nacs-lab/yyc-data/README.md

# License

All source code in this repo is under GPLv3+.
