nacs-lab/yyc-data/designs/enclosure/README.md

# Design files for enclosure, including DDS

## Files

1. `*.fpd`

    Front Panel Designer files.

2. `*.dxf`

    For the waterjet.

3. `*.svg` and `*.png`

    Drawing

4. `dimensions`

    Dimensions of the front/back, top/bottom panels and their offsets from
    the inner corner.

## Holes and Considerations

1. Front

    1. Ethernet and USB serial console input
    2. Board power
    3. SD card and switch. Leave enough space for fingers
    4. Front fan holes enough for two fans
    5. Backup 48V feed through hole
    6. Backup mount hole for the power converter board

2. Back

    1. Backup ethernet and USB serial console input
    2. Back fan holes enough for two fans

3. Top

    1. Mount holes for power splitters (8 ports x3, 3 ports x1) with different
    orientation and position options
    2. TTL/camera link with mount holes for the camera link adapter plate.
    3. CLock output
    4. REF CLK inputs and signal outputs for the DDS boards. Output holes
    should not make contact with the connectors
    5. Mount holes for the L-brackets for the DDS boards
    6. Auxiliary holes for powering the clock amplifier outside.
    7. Holes for LED / thermal monitor
    8. Auxiliary holes for WindFreak clock

4. Bottom

    1. Mount holes for the FPGA board and the breakout boards.

5. Left (DDS side)

    1. 48V feed through hole
    2. Mount hole for the power converter board, including the 12V to 5V
       converter module

## Drawing

1. Front

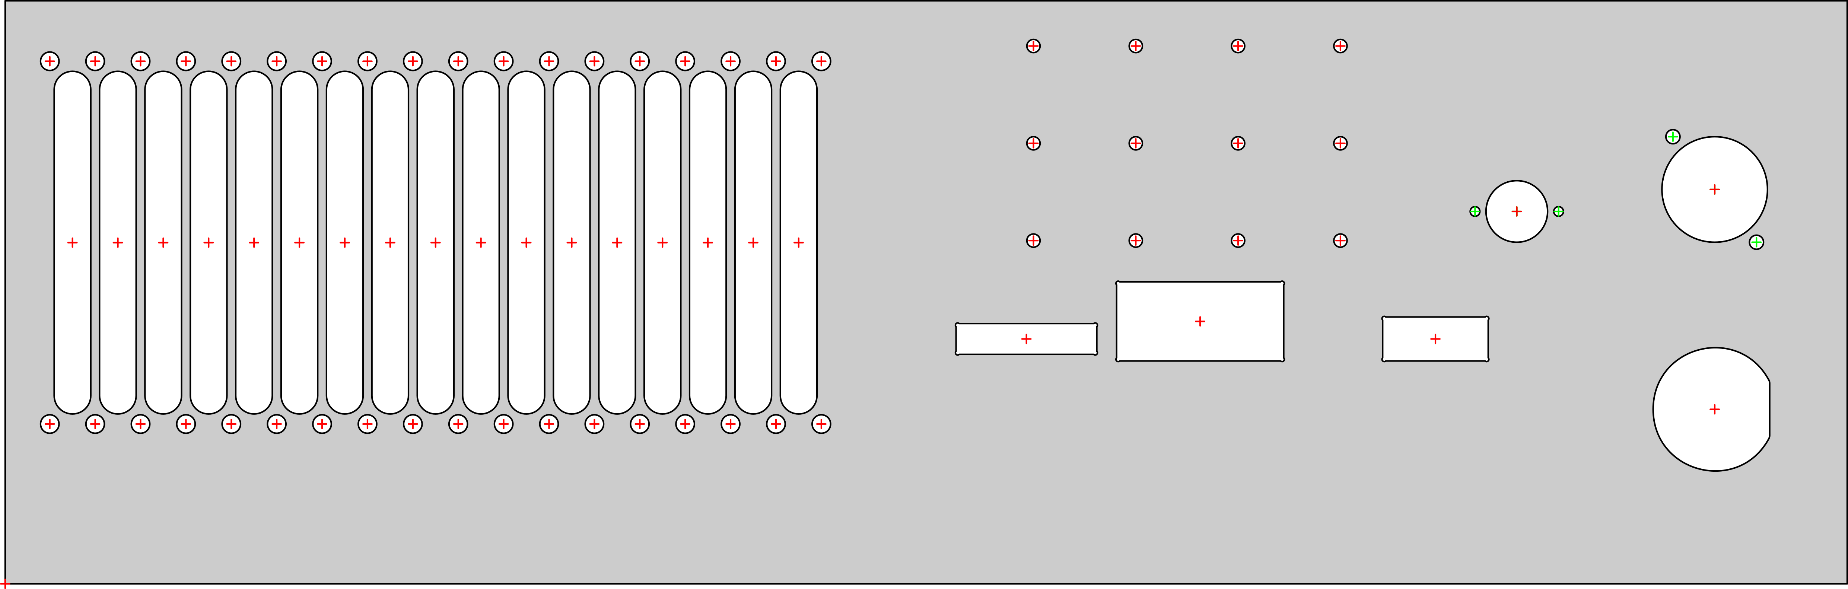
[picture p1: designs/enclosure/front.png]
Front panel
    

2. Back

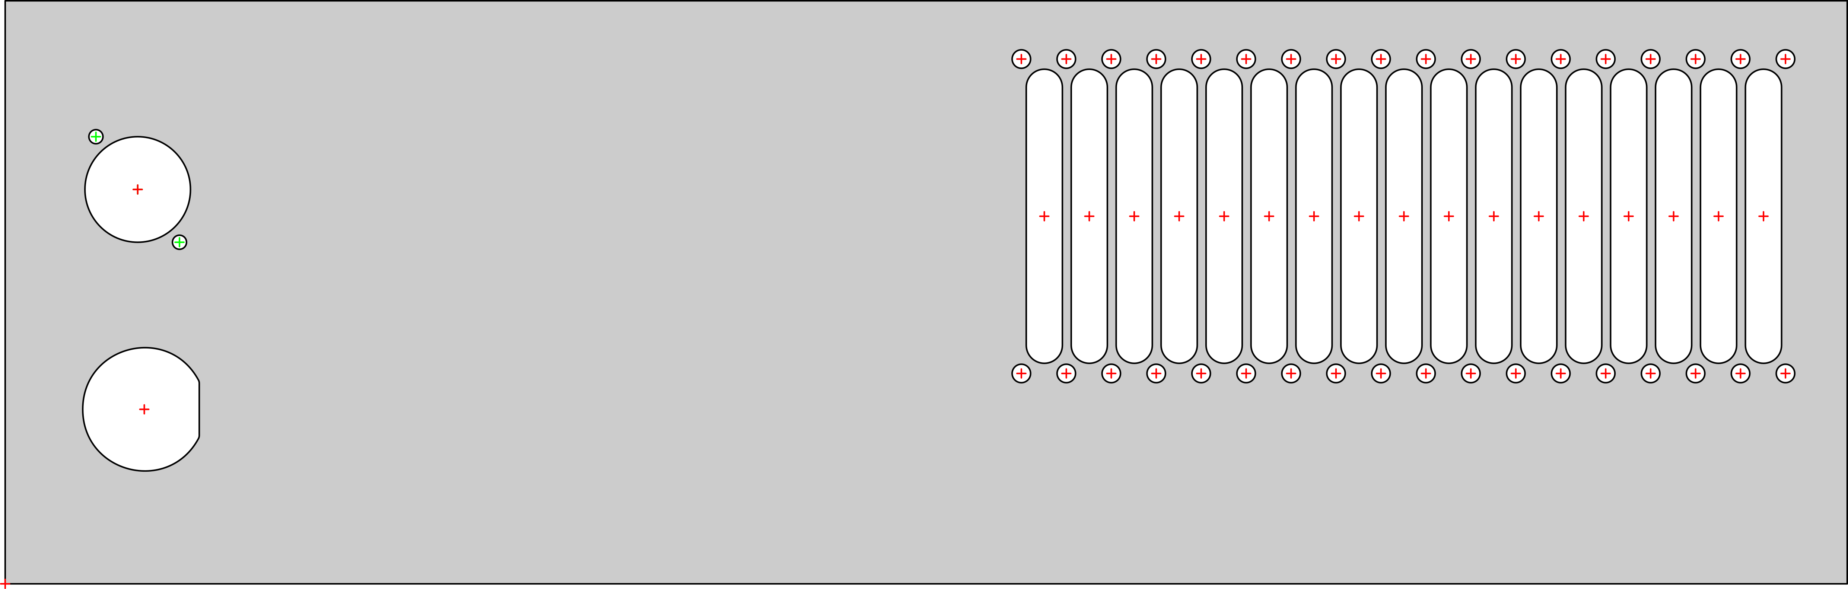
[picture p2: designs/enclosure/back.png]
Back panel
    

3. Top

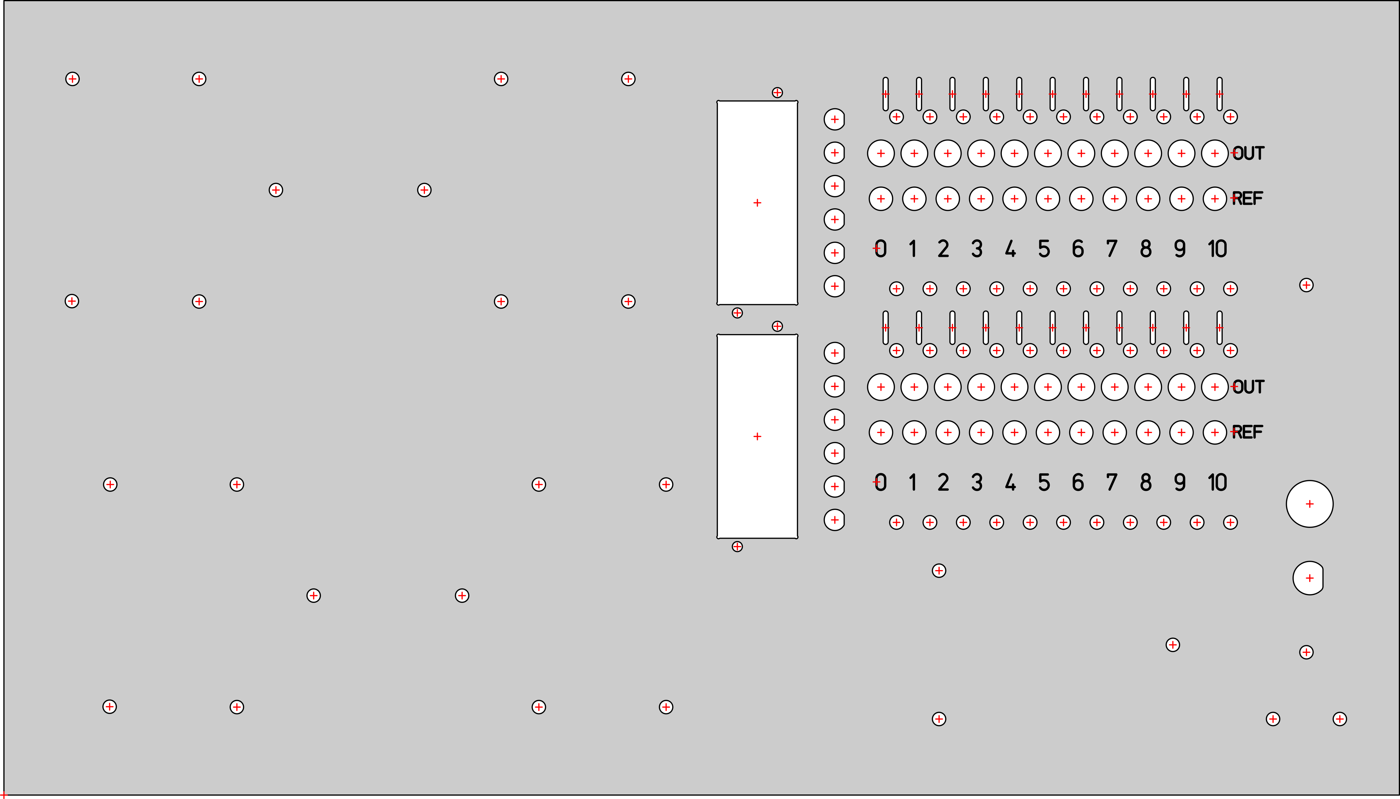
[picture p3: designs/enclosure/top.png]
Top panel
    

4. Bottom

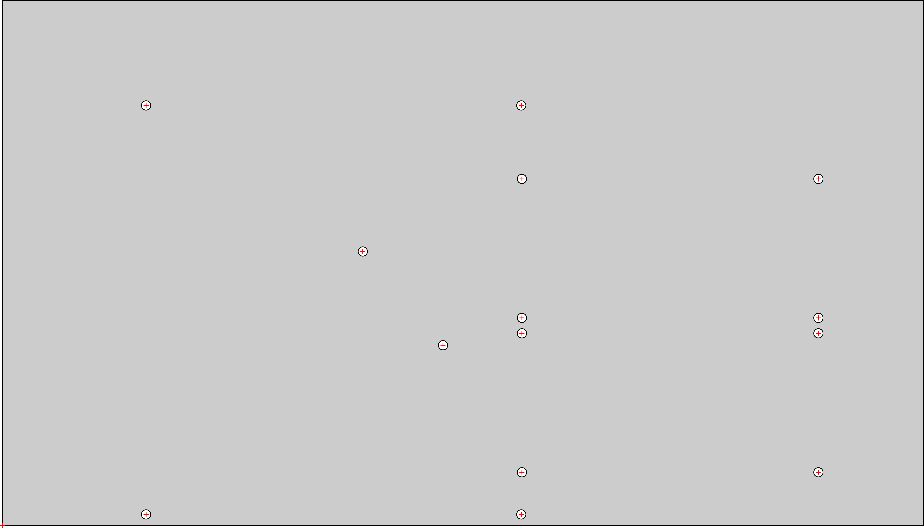
[picture p4: designs/enclosure/bottom.png]
Bottom panel
    

5. Left

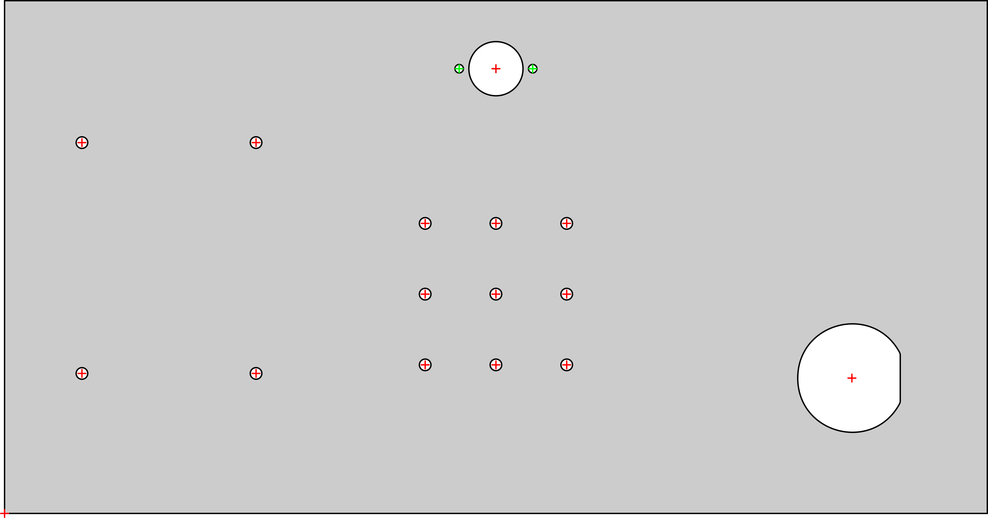
[picture p5: designs/enclosure/left.png]
Left panel
