nacs-lab/yyc-data/designs/regulator/combined.tex

\documentclass[10pt,fleqn]{article}

\usepackage{graphicx}

\begin{document}

\begin{center}
  \\
  \\
  \\
  
\end{center}

\end{document}
