nacs-lab/yyc-data/presentations/grc-2017/poster_text.md

# Challenges and solutions

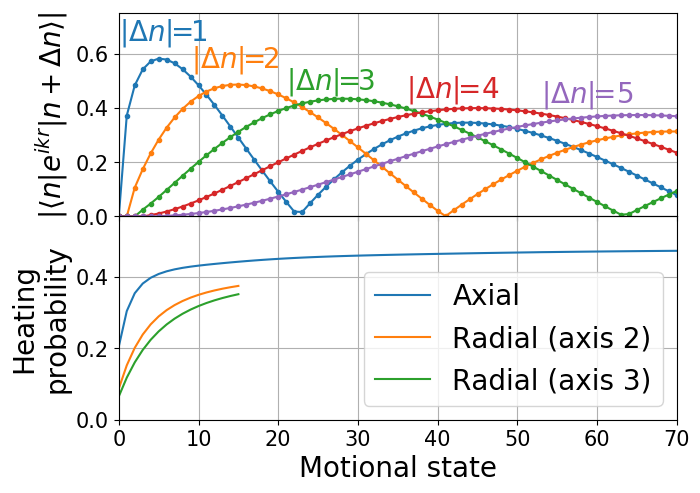
[picture p6: presentations/grc-2017/imgs/raman_op.png]


## Challenges
* High initial temperature (40μK)
* Large Lamb-Dicked parameters {0.60, 0.24, 0.21}
* High optical pumping heating
* Complex sideband structure
* Trap anharmonicity
* Trap AC Stark shift

## Solutions
* Cooling with high order sideband
* Optimize cooling with simulation
* Fast cooling pulse
* Trap switching

# Results

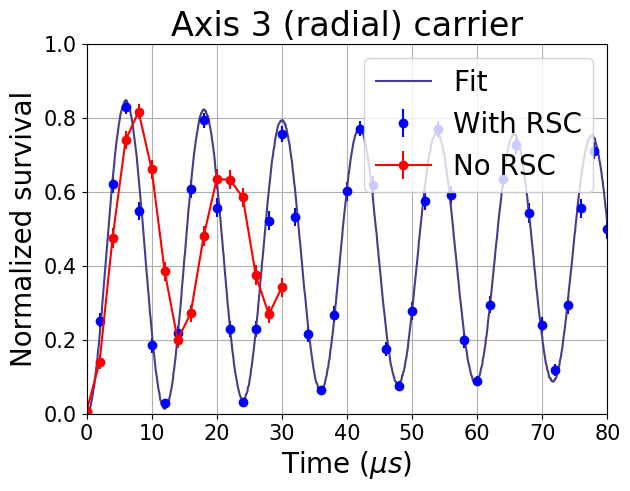
[picture p7: presentations/grc-2017/imgs/fit_20170409_r3_0.png]

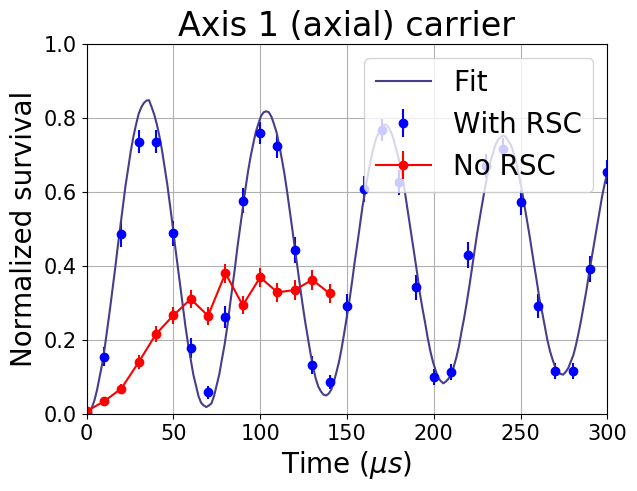
[picture p8: presentations/grc-2017/imgs/fit_20170409_a1_0.png]

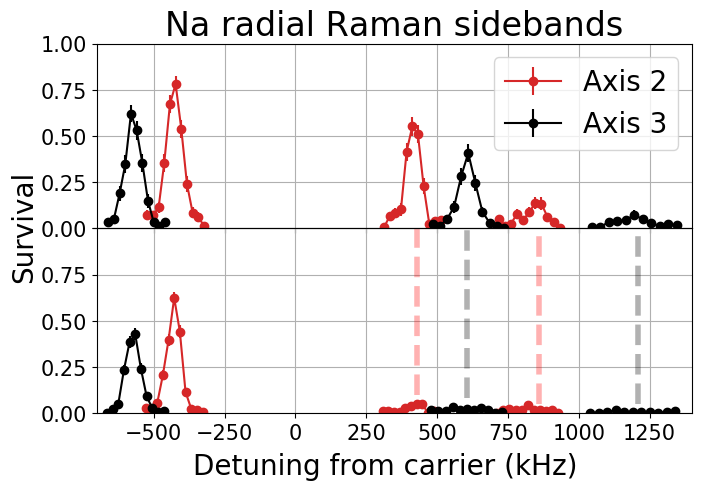
[picture p9: presentations/grc-2017/imgs/spectrum_r.png]

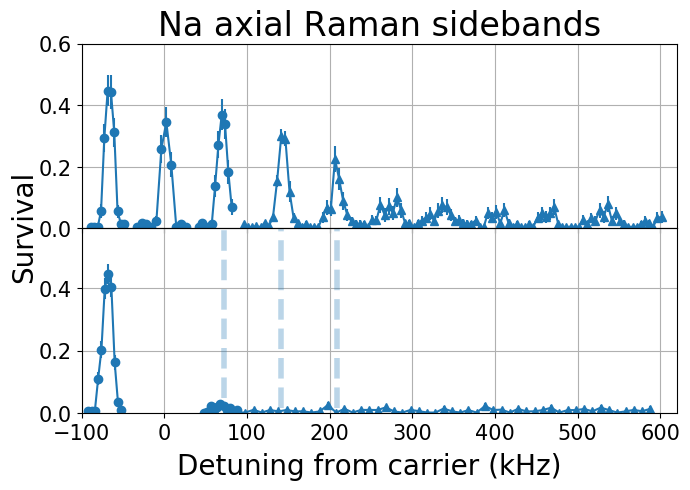
[picture p10: presentations/grc-2017/imgs/spectrum_a1.png]


Ground state ratio:
* Axis 1 (Axial): 91.6(28)%
* Axis 2 (Radial): 89.7(19)%
* Axis 3 (Radial): 93.8(26)%
* Combined: 77.1(35)%
