nacs-lab/yyc-data/presentations/2021-05-12_jc/present.tex

\documentclass[xcolor={table}]{beamer}
\mode<presentation>{
  \usetheme{Boadilla}
  \usefonttheme[onlylarge]{structurebold}
  \usefonttheme[stillsansseriflarge]{serif}
  \setbeamerfont*{frametitle}{size=\normalsize,series=\bfseries}
  % \setbeamertemplate{navigation symbols}{}
  \setbeamercovered{transparent}
}
\usepackage[english]{babel}
\usepackage[latin1]{inputenc}
\usepackage{times}
\usepackage[T1]{fontenc}
\usepackage{amsmath}
\usepackage{amssymb}
\usepackage{esint}
\usepackage{hyperref}
\usepackage{tikz}
\usepackage{xkeyval}
\usepackage{xargs}
\usepackage{verbatim}
\usepackage{listings}
\usepackage{multimedia}
\newcommand\hmmax{0}
\newcommand\bmmax{0}
\usepackage{bm}
\usepackage{siunitx}
\usepackage{xcolor,pifont}
\usepackage{upgreek}

\usetikzlibrary{
  arrows,
  calc,
  decorations.pathmorphing,
  decorations.pathreplacing,
  decorations.markings,
  fadings,
  positioning,
  shapes,
  arrows.meta
}
\usepgfmodule{oo}
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
  \draw[current plane,decoration={markings, mark=at position 0.6 with {\arrow{<}}},postaction={decorate},line width=.6mm] (\angVis:1) arc (\angVis:-\angVis-180:1);
  \draw[current plane,dashed,line width=.6mm] (180-\angVis:1) arc (180-\angVis:\angVis:1);
}
\newcommand\DrawLatitudeCircle[2][1]{
  \LatitudePlane{\angEl}{#2}
  \tikzset{current plane/.prefix style={scale=#1}}
  \pgfmathsetmacro\sinVis{sin(#2)/cos(#2)*sin(\angEl)/cos(\angEl)}
  % angle of "visibility"
  \pgfmathsetmacro\angVis{asin(min(1,max(\sinVis,-1)))}
  \draw[current plane] (\angVis:1) arc (\angVis:-\angVis-180:1);
  \draw[current plane,dashed] (180-\angVis:1) arc (180-\angVis:\angVis:1);
}
\newcommand\coil[1]{
  {\rh * cos(\t * pi r)}, {\apart * (2 * #1 + \t) + \rv * sin(\t * pi r)}
}
\makeatletter
\define@key{DrawFromCenter}{style}[{->}]{
  \tikzset{DrawFromCenterPlane/.style={#1}}
}
\define@key{DrawFromCenter}{r}[1]{
  \def\@R{#1}
}
\define@key{DrawFromCenter}{center}[(0, 0)]{
  \def\@Center{#1}
}
\define@key{DrawFromCenter}{theta}[0]{
  \def\@Theta{#1}
}
\define@key{DrawFromCenter}{phi}[0]{
  \def\@Phi{#1}
}
\presetkeys{DrawFromCenter}{style, r, center, theta, phi}{}
\newcommand*\DrawFromCenter[1][]{
  \setkeys{DrawFromCenter}{#1}{
    \pgfmathsinandcos\sint\cost{\@Theta}
    \pgfmathsinandcos\sinp\cosp{\@Phi}
    \pgfmathsinandcos\sinA\cosA{\angEl}
    \pgfmathsetmacro\DX{\@R*\cost*\cosp}
    \pgfmathsetmacro\DY{\@R*(\cost*\sinp*\sinA+\sint*\cosA)}
    \draw[DrawFromCenterPlane] \@Center -- ++(\DX, \DY);
  }
}
\newcommand*\DrawFromCenterText[2][]{
  \setkeys{DrawFromCenter}{#1}{
    \pgfmathsinandcos\sint\cost{\@Theta}
    \pgfmathsinandcos\sinp\cosp{\@Phi}
    \pgfmathsinandcos\sinA\cosA{\angEl}
    \pgfmathsetmacro\DX{\@R*\cost*\cosp}
    \pgfmathsetmacro\DY{\@R*(\cost*\sinp*\sinA+\sint*\cosA)}
    \draw[DrawFromCenterPlane] \@Center -- ++(\DX, \DY) node {#2};
  }
}
\makeatother

% not mandatory, but I though it was better to set it blank
\setbeamertemplate{headline}{}
\def\beamer@entrycode{\vspace{-\headheight}}

\tikzstyle{snakearrow} = [decorate, decoration={pre length=0.2cm,
  post length=0.2cm, snake, amplitude=.4mm,
  segment length=2mm},thick, ->]

%% document-wide tikz options and styles

\tikzset{%
  % >=latex, % option for nice arrows
  inner sep=0pt,%
  outer sep=2pt,%
  mark coordinate/.style={inner sep=0pt,outer sep=0pt,minimum size=3pt,
    fill=black,circle}%
}
\tikzset{
  % Define standard arrow tip
  >=stealth',
  % Define style for boxes
  punkt/.style={
    rectangle,
    rounded corners,
    draw=black, very thick,
    text width=8em,
    minimum height=2.5em,
    text centered},
}

\tikzset{onslide/.code args={<#1>#2}{%
    \only<#1>{\pgfkeysalso{#2}}
    % \pgfkeysalso doesn't change the path
  }}
\tikzset{alt/.code args={<#1>#2#3}{%
    \alt<#1>{\pgfkeysalso{#2}}{\pgfkeysalso{#3}}
    % \pgfkeysalso doesn't change the path
  }}
\tikzset{temporal/.code args={<#1>#2#3#4}{%
    \temporal<#1>{\pgfkeysalso{#2}}{\pgfkeysalso{#3}}{\pgfkeysalso{#4}}
    % \pgfkeysalso doesn't change the path
  }}

\makeatletter
\newbox\@backgroundblock
\newenvironment{backgroundblock}[2]{%
  \global\setbox\@backgroundblock=\vbox\bgroup%
  \unvbox\@backgroundblock%
  \vbox to0pt\bgroup\vskip#2\hbox to0pt\bgroup\hskip#1\relax%
}{\egroup\egroup\egroup}
\addtobeamertemplate{background}{\box\@backgroundblock}{}
\makeatother

\newcommand{\ud}{\mathrm{d}}
\newcommand{\ue}{\mathrm{e}}
\newcommand{\ui}{\mathrm{i}}
\newcommand{\Na}{\mathrm{Na}}
\newcommand{\Cs}{\mathrm{Cs}}
\newcommand{\abs}[1]{{\left|{#1}\right|}}
\newcommand{\paren}[1]{{\left({#1}\right)}}

% \def\timeleft{15:00->14:55}

\title[Entanglement from tensor networks]{Entanglement from tensor networks on a trapped-ion QCCD quantum computer}
\date{May 12, 2021}
\author{Yichao Yu}
\institute{Ni Group}

\ifpdf
% Ensure reproducible output
\pdfinfoomitdate=1
\pdfsuppressptexinfo=-1
\pdftrailerid{}
\hypersetup{
  pdfcreator={},
  pdfproducer={}
}
\fi

\begin{document}

\begin{frame}{}
  \titlepage
\end{frame}

% MPS
% Simulating MPS
% Results

\begin{frame}{}
  \begin{center}
    \begin{columns}
      \column{9cm}
      \begin{itemize}
      \item Matrix product states (MPS)
      \item Simulating MPS with quantum computer
      \item Results
      \end{itemize}
    \end{columns}
  \end{center}
\end{frame}

% MPS
% * Expression
% * Structure
% * Dimensions
% * Half infinite system (dimension?)
\begin{frame}{Matrix product states (MPS)}
  \begin{center}
    \begin{tikzpicture}
      \node at (0, 0.5) {$\displaystyle\sum_{\sigma_1\sigma_2\cdots\sigma_n}\!\!\!\!c_{\sigma_1\sigma_2\cdots\sigma_n}|\sigma_1\sigma_2\cdots\sigma_n\rangle$};

      \visible<2->{
        \node at (0, -0.6) {$\displaystyle\sum_{\sigma_1\sigma_2\cdots\sigma_n}\!\!\!\!\mathrm{Tr}\paren{V_{\sigma_1}V_{\sigma_2}\cdots V_{\sigma_n}}|\sigma_1\sigma_2\cdots\sigma_n\rangle$};
      }
      \visible<3->{
        \node at (0, -1.6) {$c_{\sigma_1\sigma_2\cdots\sigma_m\cdots\sigma_n}\!\!=\!\mathrm{Tr}\paren{V_{\sigma_1}V_{\sigma_2}\cdots V_{\sigma_m}\cdots V_{\sigma_n}}$};
        \node at (0, -2.3) {$c_{\sigma_1\sigma_2\cdots\sigma'_m\cdots\sigma_n}\!\!=\!\mathrm{Tr}\paren{V_{\sigma_1}V_{\sigma_2}\cdots V_{\sigma'_m}\cdots V_{\sigma_n}}$};
      }
      \visible<6->{
        \node[align=left] at (0, -3.5)
        {$\displaystyle\sum_{\sigma_1\sigma_2\cdots}\!\!LV_{\sigma_1}V_{\sigma_2}\cdots|\sigma_1\sigma_2\cdots\rangle$};
      }

      \visible<4->{
        \node[align=left] at (6, -1.5)
        {Minimum matrix dimension:\\
          \hspace{0.4cm}entanglement in the system};
      }
      \visible<5->{
        \node[align=left] at (6, -2.5) {Exploding structure in the state};
      }
    \end{tikzpicture}
  \end{center}
\end{frame}

\begin{frame}{Simulation of MPS}
  \begin{center}
    \vspace{-1cm}
    \begin{tikzpicture}
      \node[align=left] at (-3, 0) {$c_{\sigma_1\sigma_2\cdots}=LV_{\sigma_1}V_{\sigma_2}\cdots$};
      \visible<3->{
        \node[align=left] at (-3, -1) {$\langle L_\beta|V_\sigma|L_\alpha\rangle$};
      }
      \visible<4->{
        \node[align=left] at (-3, -2) {$\langle\sigma_i|\langle L_\beta|U|L_\alpha\rangle|0_i\rangle$};
      }
      \visible<6->{
        \node[below] at (-3, -2.5) {};
      }
      \visible<2->{
        \node[align=left] at (3, 0.5) {$L$ as fictitious state};
      }
      \visible<3->{
        \node[align=left] at (3, -0.5) {$V$ as operator on the fictitious space};
      }
      \visible<4->{
        \node[align=left] at (3, -1.5) {Embedding into the product space};
      }
      \visible<5->{
        \node[align=left] at (3, -2.8) {State $U|L_\alpha\rangle|0_i\rangle$ carries info about\\
          site $i$ in the ``physical subspace''.};
      }
      \visible<4->{
        \node[below] at (3, -3.5) {};
      }
      \visible<7->{
        \node[below] at (0.3, -6) {};
      }
    \end{tikzpicture}
  \end{center}
\end{frame}

% rho_A is fully determined after we cross the dashed line
\begin{frame}{Entanglement spectrum}
  \begin{center}
    \vspace{-0.4cm}
    \begin{tikzpicture}
      \node[align=left] at (-3, 0)
      {Eigenvalues of $\rho_{\rm A}=\mathrm{Tr}_{\rm b}(|\Psi\rangle\langle\Psi|)$};
      \visible<2->{
        \node at (3, 0) {};
      }
      \visible<3->{
        \node at (0, -3.5) {};
      }
    \end{tikzpicture}
  \end{center}
\end{frame}

\begin{frame}{Results}
  \begin{center}
    \begin{tikzpicture}
      \node at (-3, 0) {};
      \visible<2->{
        \node at (3, 0) {};
      }
    \end{tikzpicture}
  \end{center}
\end{frame}

\end{document}
