nacs-lab/yyc-data/presentations/2021-03-24_jc/present.tex

\documentclass[xcolor={table}]{beamer}
\mode<presentation>{
  \usetheme{Boadilla}
  \usefonttheme[onlylarge]{structurebold}
  \usefonttheme[stillsansseriflarge]{serif}
  \setbeamerfont*{frametitle}{size=\normalsize,series=\bfseries}
  % \setbeamertemplate{navigation symbols}{}
  \setbeamercovered{transparent}
}
\usepackage[english]{babel}
\usepackage[latin1]{inputenc}
\usepackage{times}
\usepackage[T1]{fontenc}
\usepackage{amsmath}
\usepackage{amssymb}
\usepackage{esint}
\usepackage{hyperref}
\usepackage{tikz}
\usepackage{xkeyval}
\usepackage{xargs}
\usepackage{verbatim}
\usepackage{listings}
\usepackage{multimedia}
\newcommand\hmmax{0}
\newcommand\bmmax{0}
\usepackage{bm}
\usepackage{siunitx}
\usepackage{xcolor,pifont}
\usepackage{upgreek}

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

% not mandatory, but I though it was better to set it blank
\setbeamertemplate{headline}{}
\def\beamer@entrycode{\vspace{-\headheight}}

\tikzstyle{snakearrow} = [decorate, decoration={pre length=0.2cm,
  post length=0.2cm, snake, amplitude=.4mm,
  segment length=2mm},thick, ->]

%% document-wide tikz options and styles

\tikzset{%
  % >=latex, % option for nice arrows
  inner sep=0pt,%
  outer sep=2pt,%
  mark coordinate/.style={inner sep=0pt,outer sep=0pt,minimum size=3pt,
    fill=black,circle}%
}
\tikzset{
  % Define standard arrow tip
  >=stealth',
  % Define style for boxes
  punkt/.style={
    rectangle,
    rounded corners,
    draw=black, very thick,
    text width=8em,
    minimum height=2.5em,
    text centered},
}

\tikzset{onslide/.code args={<#1>#2}{%
    \only<#1>{\pgfkeysalso{#2}}
    % \pgfkeysalso doesn't change the path
  }}
\tikzset{alt/.code args={<#1>#2#3}{%
    \alt<#1>{\pgfkeysalso{#2}}{\pgfkeysalso{#3}}
    % \pgfkeysalso doesn't change the path
  }}
\tikzset{temporal/.code args={<#1>#2#3#4}{%
    \temporal<#1>{\pgfkeysalso{#2}}{\pgfkeysalso{#3}}{\pgfkeysalso{#4}}
    % \pgfkeysalso doesn't change the path
  }}

\makeatletter
\newbox\@backgroundblock
\newenvironment{backgroundblock}[2]{%
  \global\setbox\@backgroundblock=\vbox\bgroup%
  \unvbox\@backgroundblock%
  \vbox to0pt\bgroup\vskip#2\hbox to0pt\bgroup\hskip#1\relax%
}{\egroup\egroup\egroup}
\addtobeamertemplate{background}{\box\@backgroundblock}{}
\makeatother

\newcommand{\ud}{\mathrm{d}}
\newcommand{\ue}{\mathrm{e}}
\newcommand{\ui}{\mathrm{i}}
\newcommand{\Na}{\mathrm{Na}}
\newcommand{\Cs}{\mathrm{Cs}}
\newcommand{\abs}[1]{{\left|{#1}\right|}}
\newcommand{\paren}[1]{{\left({#1}\right)}}

% \def\timeleft{15:00->14:55}

\title{Emergent Randomness and Benchmarking from Many-Body Quantum Chaos}
\date{Mar. 24, 2021}
\author{Yichao Yu}
\institute{Ni Group}

\ifpdf
% Ensure reproducible output
\pdfinfoomitdate=1
\pdfsuppressptexinfo=-1
\pdftrailerid{}
\hypersetup{
  pdfcreator={},
  pdfproducer={}
}
\fi

\begin{document}

\begin{frame}{}
  \titlepage
\end{frame}

\begin{frame}{}
  \begin{center}
    \begin{columns}
      \column{9cm}
      \begin{itemize}
      \item Experimental observation of thermalization
      \item Projected state ensemble
      \item Application
      \end{itemize}
    \end{columns}
  \end{center}
\end{frame}

\begin{frame}[t]{Experiment}
  \begin{center}
    \begin{tikzpicture}
      \visible<-5>{
        \node[left] at (0, 0) {};
      }
      \visible<6->{
        \node[left] at (0, 0) {};
      }
      \node[right,align=center,text width=5cm] at (0, 0) {
        \begin{itemize}
        \item<1-> Rydberg system with chaotic dynamic
        \item<2-> A: system, B: Bath
        \item<3-> Conditional probability $p(z_A|z_B)$
        \item<4-> Random state vs dephasing
        \item<5-> $L_A>1$
        \item<6-> Moments
          $\displaystyle p^{(k)}\equiv\sum_pp^kP(p)$
        \item<7-> Independent of system division
        \end{itemize}
      };
    \end{tikzpicture}
  \end{center}
\end{frame}

\begin{frame}[t]{Projected State Ensemble}
  \begin{center}
    \begin{tikzpicture}
      \visible<5->{
        \node[left] at (0, 0) {};
      }
      \node[right,align=center,text width=5cm] at (0, 0) {
        \begin{itemize}
        \item<1-> Density matrix:
          $\rho=\sum p_i|\psi_i\rangle\langle\psi_i|$
        \item<2-> Choice of $\{p_i, \psi_i\}$ is not unique
        \item<3-> Full description if the system is all what can be measured
        \item<4-> Projected state ensemble:\\
          Determine $\{p_i, \psi_i\}$ by selecting the bath basis.
        \item<5-> $k$-design
        \end{itemize}
      };
    \end{tikzpicture}
  \end{center}
\end{frame}

\begin{frame}[t]{Application}
  \begin{center}
    \begin{tikzpicture}
      \node[above,align=center,text width=10cm] at (0, 0.5) {
        \begin{itemize}
        \item<1-> Useful in quantum cryptography and supremacy test
        \item<2-> Fidelity estimation
        \item<3-> $\displaystyle F_c=2\frac{\sum_zp(z)p_0(z)}{\sum_zp_0^2(z)} - 1$
        \item<4-> Generic?
        \end{itemize}
      };
      \visible<2->{
        \node[below] at (0, 0) {};
      }
    \end{tikzpicture}
  \end{center}
\end{frame}

\begin{frame}{Questions?}
  \begin{center}
  \end{center}
\end{frame}

\end{document}
