nacs-lab/yyc-data/presentations/2021-01-20_jc/present.tex

\documentclass[xcolor={table}]{beamer}
\mode<presentation>{
  \usetheme{Boadilla}
  \usefonttheme[onlylarge]{structurebold}
  \usefonttheme[stillsansseriflarge]{serif}
  \setbeamerfont*{frametitle}{size=\normalsize,series=\bfseries}
  % \setbeamertemplate{navigation symbols}{}
  \setbeamercovered{transparent}
}
\usepackage[english]{babel}
\usepackage[latin1]{inputenc}
\usepackage{times}
\usepackage[T1]{fontenc}
\usepackage{amsmath}
\usepackage{amssymb}
\usepackage{esint}
\usepackage{hyperref}
\usepackage{tikz}
\usepackage{xkeyval}
\usepackage{xargs}
\usepackage{verbatim}
\usepackage{listings}
\usepackage{multimedia}
\newcommand\hmmax{0}
\newcommand\bmmax{0}
\usepackage{bm}
\usepackage{siunitx}
\usepackage{xcolor,pifont}
\usepackage{upgreek}

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

% not mandatory, but I though it was better to set it blank
\setbeamertemplate{headline}{}
\def\beamer@entrycode{\vspace{-\headheight}}

\tikzstyle{snakearrow} = [decorate, decoration={pre length=0.2cm,
  post length=0.2cm, snake, amplitude=.4mm,
  segment length=2mm},thick, ->]

%% document-wide tikz options and styles

\tikzset{%
  % >=latex, % option for nice arrows
  inner sep=0pt,%
  outer sep=2pt,%
  mark coordinate/.style={inner sep=0pt,outer sep=0pt,minimum size=3pt,
    fill=black,circle}%
}
\tikzset{
  % Define standard arrow tip
  >=stealth',
  % Define style for boxes
  punkt/.style={
    rectangle,
    rounded corners,
    draw=black, very thick,
    text width=8em,
    minimum height=2.5em,
    text centered},
}

\tikzset{onslide/.code args={<#1>#2}{%
    \only<#1>{\pgfkeysalso{#2}}
    % \pgfkeysalso doesn't change the path
  }}
\tikzset{alt/.code args={<#1>#2#3}{%
    \alt<#1>{\pgfkeysalso{#2}}{\pgfkeysalso{#3}}
    % \pgfkeysalso doesn't change the path
  }}
\tikzset{temporal/.code args={<#1>#2#3#4}{%
    \temporal<#1>{\pgfkeysalso{#2}}{\pgfkeysalso{#3}}{\pgfkeysalso{#4}}
    % \pgfkeysalso doesn't change the path
  }}

\makeatletter
\newbox\@backgroundblock
\newenvironment{backgroundblock}[2]{%
  \global\setbox\@backgroundblock=\vbox\bgroup%
  \unvbox\@backgroundblock%
  \vbox to0pt\bgroup\vskip#2\hbox to0pt\bgroup\hskip#1\relax%
}{\egroup\egroup\egroup}
\addtobeamertemplate{background}{\box\@backgroundblock}{}
\makeatother

\newcommand{\ud}{\mathrm{d}}
\newcommand{\ue}{\mathrm{e}}
\newcommand{\ui}{\mathrm{i}}
\newcommand{\Na}{\mathrm{Na}}
\newcommand{\Cs}{\mathrm{Cs}}
\newcommand{\abs}[1]{{\left|{#1}\right|}}
\newcommand{\paren}[1]{{\left({#1}\right)}}

% \def\timeleft{15:00->14:55}

\title[Measuring scrambling]{Measuring the scrambling of quantum information}
\date{Jan. 20, 2021}
\author{Yichao Yu}
\institute{Ni Group}

\ifpdf
% Ensure reproducible output
\pdfinfoomitdate=1
\pdfsuppressptexinfo=-1
\pdftrailerid{}
\hypersetup{
  pdfcreator={},
  pdfproducer={}
}
\fi

\begin{document}

\begin{frame}{}
  \titlepage
\end{frame}

\begin{frame}{}
  \begin{center}
    \begin{columns}
      \column{9cm}
      \begin{itemize}
      \item Scrambling of quantum information
      \item Out-of-time-order (OTO) correlator
      \item Measurement of OTO correlator
      \item Experimental realization with cavity QED system
      \end{itemize}
    \end{columns}
  \end{center}
\end{frame}

\begin{frame}{Relaxiation vs Scrambling}
  \begin{center}
    \begin{tikzpicture}
      \node[above] at (-2.8, 0) {\textbf{Relaxiation}};
      \node[below,text width=5.4cm,align=center] at (-2.8, 0) {
        \begin{itemize}
        \item<1-> Decay/leaking of information from a single qubit.
        \item<3-> Fast\\
          \uncover<-2,4->{Time scale: $\uptau$}
        \end{itemize}
      };
      \node[above] at (2.8, 0) {\textbf{Scrambling}};
      \node[below,text width=5.4cm,align=center] at (2.8, 0) {
        \begin{itemize}
        \item<2-> Spreading of information to the whole system.
        \item<3-> Slow\\
          \uncover<-2,4->{Time scale: $t_*=\uptau\ln\mathrm{S}$}
        \end{itemize}
      };
    \end{tikzpicture}
  \end{center}
\end{frame}

\begin{frame}{Out-of-time-order (OTO) correlator}
  \begin{center}
    \begin{tikzpicture}
      \node[above] at (-2.8, 0) {$F\paren{t}\equiv\langle W_t^\dagger V^\dagger W_t V\rangle$};
      \node[below,align=center] at (-2.8, -0.3)
      {\small $W_t=U(-t)WU(t)$\\
        \small $U(t)=\ue^{-\ui Ht}$};

      \node[below,text width=5.4cm,align=center] at (2.8, 0.8) {
        \begin{itemize}
        \item<2-> Interpretation:\uncover<-1,3->{
            $F=\langle\psi_1|\psi_2\rangle$\\
            \vspace{0.2cm}
            \small $|\psi_1\rangle=VW_t|\psi_0\rangle$\\
            \small $|\psi_2\rangle=W_tV|\psi_0\rangle$
          }
        \item<4-> Choice of $V$ and $W$?
        \item<5-> Scaling of $F$ with system size.
        \item<6-> Relation with scrambling time?
        \end{itemize}
      };
    \end{tikzpicture}
  \end{center}
\end{frame}

\begin{frame}{Measurement of OTO correlator}
  \begin{center}
    \begin{tikzpicture}
      \node[above] at (0, 0.3)
      {Given $H$, $V$, $W$, measure $F\paren{t}\equiv\langle W_t^\dagger V^\dagger W_t V\rangle$};
      \visible<2->{
        \node[below] at (0, 0){};
      }
      \visible<3->{
        \node[below] at (0, -4.8){Time reversal: $U(-t)$};
      }
      \visible<4->{
        \node[below] at (0, -5.5){Controlled-$V$:
          $I_S\otimes|0\rangle\langle0|_C+V_S\otimes|1\rangle\langle1|_C$};
      }
    \end{tikzpicture}
  \end{center}
\end{frame}

\begin{frame}{Cavity QED implementation}
  \begin{center}
    \begin{tikzpicture}
      \node at (0, 0) {};
      \visible<1>{
        \node at (0, -2.1) {$\displaystyle H=\sum_{ij}J_{ij}s_i^xs_j^x+h.c.$};
        \node at (0, -3.2)
        {\small $\displaystyle J_{ij}=\sum_{\alpha}\frac{\Omega^*_{\uparrow}\paren{r_i}\Omega_{\downarrow}\paren{r_j}}{\Delta_{\uparrow}\Delta_{\downarrow}}\frac{g_\alpha\paren{r_i}g_\alpha^*\paren{r_j}}{\delta}$};
      }
      \visible<2>{
        \node at (0, -2.1) {$\displaystyle Z_\phi^C=I_S\otimes|0\rangle\langle0|_C+\ue^{-\ui\phi S_z^S}\otimes|1\rangle\langle1|_C$};
        \node at (0, -3.2)
        {\small $\displaystyle V=W=\ue^{-\ui\phi S_z^S}$};
      }
    \end{tikzpicture}
  \end{center}
\end{frame}

\begin{frame}{$S_x^2$ dynamics}
  \begin{center}
    \begin{tikzpicture}
      \node at (0, 2.3) {$\displaystyle H=\sum_{ij}J_{ij}s_i^xs_j^x+h.c.\ \rightarrow\ H=JS_x^2$};
      \node at (0, 0) {};
    \end{tikzpicture}
  \end{center}
\end{frame}

\begin{frame}{$S_x^2 + S_z$ dynamics}
  \begin{center}
    \begin{tikzpicture}
      \node at (0.2, 2.4) {$\displaystyle F\paren{t}\equiv\langle W_t^\dagger V^\dagger W_t V\rangle\ \ \ G\paren{t}\equiv\langle V_t^\dagger V\rangle$};
      \node at (0, 0) {};
    \end{tikzpicture}
  \end{center}
\end{frame}

\begin{frame}{Questions}
  \begin{center}
    \begin{columns}
      \column{10cm}
      \begin{itemize}
      \item The requirement on $V$ and $W$.\\
        They should not commute with $H$ (or $F$ would be a constant $1$).\\
        They can apparently either be local (operate on a single particle)
        or global (operate on more than one).\\
        The paper gives an argument for why it ``works'' for local operator
        but not for global operators.\\
        If $V$ and $W$ are identical local operators,
        it seems to me that it should reflet more about the relaxation of that particle
        rather than scrambling.
      \item How exactly is $F$ measuring the scrambling.
      \item Kick-top Hamiltonian:\\
        How is the $\ue^{-\ui S_z}$ term reversed when doing time propagation.
      \item Why is time ordered correlator ($G$) relaxation.
      \end{itemize}
    \end{columns}
  \end{center}
\end{frame}

\end{document}
