nacs-lab/yyc-data/presentations/2019_progress/progress.md

# Research accomplished in the past year

1. Working on implementing Raman transfer to bound NaCs electronic ground state

     * Measured PA resonance for deeply bound excited electronic state
     * Observed EIT resonance
     * Observed Raman resonance

2. Better understanding of interaction from interaction shift and PA spectroscopy

# Experiment timeline

* 2019 - 2020

     * Identify and avoid the cause of loss in the optical transfer to loosely bound molecule
     * Create loosely bound NaCs molecule
     * Create singlet ground state NaCs molecule

Goals of the experiment:

* Create multiple NaCs singlet ground state molecules

* Demonstrate interaction and quantum gates

# List of in progress or completed publications

1. Multichannel interactions of two atoms in an optical tweezer -- arXiv:1907.11226 (2019)

2. Molecular Assembly of Ground State Cooled Single Atoms --  PRX 9, 021039 (2019)

# List of talks or presentations

1. Interaction between single atoms in optical tweezers -- Mar. 27th, 2019 / May. 29th, 2019
