nacs-lab/yyc-data/notes/two-photon-broadening/note.tex

\documentclass[10pt,fleqn]{article}
% \usepackage[journal=rsc]{chemstyle}
% \usepackage{mhchem}
\usepackage{amsmath}
\usepackage{amssymb}
\usepackage{amsfonts}
\usepackage{esint}
\usepackage{bbm}
\usepackage{amscd}
\usepackage{caption}
\usepackage{picinpar}
\usepackage{graphicx}
\usepackage{tikz}
\usepackage{tikz-3dplot}
\usepackage{indentfirst}
\usepackage{wrapfig}
\usepackage{units}
\usepackage{textcomp}
\usepackage[utf8x]{inputenc}
% \usepackage{feyn}
\usepackage{feynmp}
\usepackage{xkeyval}
\usepackage{xargs}
\usepackage{verbatim}
\usepackage{pgfplots}
\usepackage{hyperref}
\usetikzlibrary{
  arrows,
  calc,
  decorations.pathmorphing,
  decorations.pathreplacing,
  decorations.markings,
  fadings,
  positioning,
  shapes
}
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
  \pgfmathsinandcos\sinEl\cosEl{#2} % elevation
  \pgfmathsinandcos\sint\cost{#3} % azimuth
  \tikzset{#1/.estyle={cm={\cost,\sint*\sinEl,0,\cosEl,(0,0)}}}
}
\newcommand\LatitudePlane[3][current plane]{%
  \pgfmathsinandcos\sinEl\cosEl{#2} % elevation
  \pgfmathsinandcos\sint\cost{#3} % latitude
  \pgfmathsetmacro\yshift{\cosEl*\sint}
  \tikzset{#1/.estyle={cm={\cost,0,0,\cost*\sinEl,(0,\yshift)}}} %
}
\newcommand\DrawLongitudeCircle[2][1]{
  \LongitudePlane{\angEl}{#2}
  \tikzset{current plane/.prefix style={scale=#1}}
  % angle of "visibility"
  \pgfmathsetmacro\angVis{atan(sin(#2)*cos(\angEl)/sin(\angEl))} %
  \draw[current plane] (\angVis:1) arc (\angVis:\angVis+180:1);
  \draw[current plane,dashed] (\angVis-180:1) arc (\angVis-180:\angVis:1);
}
\newcommand\DrawLatitudeCircleArrow[2][1]{
  \LatitudePlane{\angEl}{#2}
  \tikzset{current plane/.prefix style={scale=#1}}
  \pgfmathsetmacro\sinVis{sin(#2)/cos(#2)*sin(\angEl)/cos(\angEl)}
  % angle of "visibility"
  \pgfmathsetmacro\angVis{asin(min(1,max(\sinVis,-1)))}
  \draw[current plane,decoration={markings, mark=at position 0.6 with {\arrow{<}}},postaction={decorate},line width=.6mm] (\angVis:1) arc (\angVis:-\angVis-180:1);
  \draw[current plane,dashed,line width=.6mm] (180-\angVis:1) arc (180-\angVis:\angVis:1);
}
\newcommand\DrawLatitudeCircle[2][1]{
  \LatitudePlane{\angEl}{#2}
  \tikzset{current plane/.prefix style={scale=#1}}
  \pgfmathsetmacro\sinVis{sin(#2)/cos(#2)*sin(\angEl)/cos(\angEl)}
  % angle of "visibility"
  \pgfmathsetmacro\angVis{asin(min(1,max(\sinVis,-1)))}
  \draw[current plane] (\angVis:1) arc (\angVis:-\angVis-180:1);
  \draw[current plane,dashed] (180-\angVis:1) arc (180-\angVis:\angVis:1);
}
\newcommand\coil[1]{
  {\rh * cos(\t * pi r)}, {\apart * (2 * #1 + \t) + \rv * sin(\t * pi r)}
}
\makeatletter
\define@key{DrawFromCenter}{style}[{->}]{
  \tikzset{DrawFromCenterPlane/.style={#1}}
}
\define@key{DrawFromCenter}{r}[1]{
  \def\@R{#1}
}
\define@key{DrawFromCenter}{center}[(0, 0)]{
  \def\@Center{#1}
}
\define@key{DrawFromCenter}{theta}[0]{
  \def\@Theta{#1}
}
\define@key{DrawFromCenter}{phi}[0]{
  \def\@Phi{#1}
}
\presetkeys{DrawFromCenter}{style, r, center, theta, phi}{}
\newcommand*\DrawFromCenter[1][]{
  \setkeys{DrawFromCenter}{#1}{
    \pgfmathsinandcos\sint\cost{\@Theta}
    \pgfmathsinandcos\sinp\cosp{\@Phi}
    \pgfmathsinandcos\sinA\cosA{\angEl}
    \pgfmathsetmacro\DX{\@R*\cost*\cosp}
    \pgfmathsetmacro\DY{\@R*(\cost*\sinp*\sinA+\sint*\cosA)}
    \draw[DrawFromCenterPlane] \@Center -- ++(\DX, \DY);
  }
}
\newcommand*\DrawFromCenterText[2][]{
  \setkeys{DrawFromCenter}{#1}{
    \pgfmathsinandcos\sint\cost{\@Theta}
    \pgfmathsinandcos\sinp\cosp{\@Phi}
    \pgfmathsinandcos\sinA\cosA{\angEl}
    \pgfmathsetmacro\DX{\@R*\cost*\cosp}
    \pgfmathsetmacro\DY{\@R*(\cost*\sinp*\sinA+\sint*\cosA)}
    \draw[DrawFromCenterPlane] \@Center -- ++(\DX, \DY) node {#2};
  }
}
\makeatother
\tikzstyle{snakearrow} = [decorate, decoration={pre length=0.2cm,
  post length=0.2cm, snake, amplitude=.4mm,
  segment length=2mm},thick, ->]
%% document-wide tikz options and styles
\tikzset{%
  >=latex, % option for nice arrows
  inner sep=0pt,%
  outer sep=2pt,%
  mark coordinate/.style={inner sep=0pt,outer sep=0pt,minimum size=3pt,
    fill=black,circle}%
}
\addtolength{\hoffset}{-1.3cm}
\addtolength{\voffset}{-2cm}
\addtolength{\textwidth}{3cm}
\addtolength{\textheight}{2.5cm}
\renewcommand{\footskip}{10pt}
\setlength{\headwidth}{\textwidth}
\setlength{\headsep}{20pt}
\setlength{\marginparwidth}{0pt}
\parindent=0pt
\title{Notes on two photon scattering of the molecular state}

% \DeclareCaptionLabelFormat{sectionnumber}{#1 \thesection.#2}
% \captionsetup{labelformat=sectionnumber}

\makeatletter
\long\def\my@drawfill#1#2;{%
  \@skipfalse
  \fill[#1,draw=none] #2;
  \@skiptrue
  \draw[#1,fill=none] #2;
}
\newif\if@skip
\newcommand{\skipit}[1]{%
  \if@skip
  \else
  #1
  \fi
}
\newcommand{\drawfill}[1][]{%
  \my@drawfill{#1}}
\makeatother

\begin{document}
\maketitle

\raggedright

\section{Experiment observations}
We have seen experimental evidences of an anomalous scattering / loss in the
lifetime of the ground atomic / molecular states as well as broadening in excited state
line width. We have measured power dependencies for some of the processes that is
consistent with a two photon process from the ground state (or equivalently a one
photon process from the excited state). The measurement we have done includes

\begin{enumerate}
\item Line width and decay time measurement of Raman process near $v=0$ ($1038 \mathrm{nm}$)\\
  The result is consistent with a $300 \mathrm{MHz}$ to $600 \mathrm{MHz}$
  excited state line width.\\
  We did not make a power dependency measurement.\\
  We measured carefully at multiple red detunings, which all shows similar results.\\
  We measured one point not as carefully for blue detuning
  ($18 \mathrm{GHz}$ or $10 \mathrm{GHz}$ detuned depending on the excited state $J$)
  which shows similar result as the corresponding red detuning.
\item Off resonance PA rate (lifetime) in $|F^{\mathrm{Cs}}\!=\!4, m_{F}^{\mathrm{Cs}}\!=\!4; F^{\mathrm{Na}}\!=\!2, m_{F}^{\mathrm{Na}}\!=\!2\rangle$
  near $v=0$ PA line.\\
  The result is consistent with the Raman line width and decay time measurements above
  which gives a wide excited state line width.
\item Excited state line width for $v=0$.\\
  The line width is narrow ($\leqslant 50 \mathrm{MHz}$)
  when the tweezer is near $976 \mathrm{nm}$ but is wide ($\geqslant 500 \textrm{MHz}$)
  when the tweezer is near $1038 \mathrm{nm}$ red detuned from the $v=0$ resonance
  by a few hundred GHz.\\
  We did not make a power dependency measurement.
\item Line width of a ``mysterious'' line\\
  Tweezer $100 \mathrm{GHz}$ red detuned.\\
  Line width $\approx 100 \mathrm{MHz}$
  (determined to be narrow at the time but could have some broadening)\\
  We did not make a power dependency measurement.
\item $|F^{\mathrm{Cs}}\!=\!3, m_{F}^{\mathrm{Cs}}\!=\!3; F^{\mathrm{Na}}\!=\!2, m_{F}^{\mathrm{Na}}\!=\!2\rangle$ lifetime
  in $307366 \mathrm{GHz}$ tweezer.\\
  We measured a shorter than expected lifetime.\\
  The dependency of the loss rate to tweezer power is consistent with the prediction of
  a two photo process from the tweezer. In another word, it is consistent with
  a excited state broadened proportional to the tweezer power.
\item $|F^{\mathrm{Cs}}\!=\!3, m_{F}^{\mathrm{Cs}}\!=\!3; F^{\mathrm{Na}}\!=\!2, m_{F}^{\mathrm{Na}}\!=\!2\rangle$ lifetime
  in $306638 \mathrm{GHz}$ tweezer.\\
  We measured a shorter than expected lifetime.\\
  The power dependency may be consistent with a single photon process.
\item $v=12$ line width.\\
  Narrow ($25 \mathrm{MHz}$) for tweezer at around $307366 \mathrm{GHz}$
  (blue detuned $\approx 900\mathrm{GHz}$). (No tweezer power dependency taken.)\\
  Narrow ($20 \mathrm{MHz}$) for tweezer at $306612 \mathrm{GHz}$
  (blue detuned $\approx 130\mathrm{GHz}$). (No tweezer power dependency taken.)
  We have also indirectly observed a Raman coupling to a deeper molecular bound state
  between the tweezer and the PA probe beam.\\
  Broad ($250 \mathrm{MHz}$) for tweezer at $306344.5 \mathrm{GHz}$
  (red detuned $\approx 150\mathrm{GHz}$). Linearly depending on tweezer power.\\
\item $v=14$ line width.\\
  Broad ($200 \mathrm{MHz}$) for tweezer at around $307366 \mathrm{GHz}$
  (red detuned $\approx 1900\mathrm{GHz}$). Linearly depending on tweezer power.\\
\item Raman blue detuned from $v=12$.\\
  Tweezer at around $306614 \mathrm{GHz}$.\\
  No Rabi flopping observed.
\end{enumerate}

\section{Preliminary explanations for some of the results}
The power dependencies we measured makes it clear that we very likely
have some two photon (from ground state, one photon from excited state) process involved.
We originally suspected a two photon process to a higher excited state but Olivier also
suggested potentially a coupling to the ground state (unbound) motional continuum.
This initially seems improbable due to the small matrix element with the ground state.
However, I later learned that due to the mismatch in the excited state and ground state
electronic potential, the excited state only have about $20\%$ projection onto the ground
bound state. In another word, even though the coupling to a particular ground trapped
state is small, the total coupling to the ground state continuum is actually significant.\\

In terms of a two photon coupling (from ground state) to higher excited state,
it is harder to calculate but it is easy to believe the existence of highly lossy
state either from radiative or non-radiative (pre-dissociation) process.\\

In terms of a two photon coupling (from ground state) back to the ground electronic state,
it should be easier to calculate (see below) and can more easily explain the apparent
sensitivity to the detuning (red vs blue) of the excited state line width measurements.
We have also directly measured a coupling to the ground bound state when we switched
to blue detuning.

\section{Caveat in the interpretation}

There are two kinds of measurements above
\begin{enumerate}
\item Ground state scattering/loss rate\\
  This includes Raman decay time / line width and atomic state 2-body lifetime.
\item Excited state line width.
\end{enumerate}

The first kind of measurement mainly involve a single laser frequency
or two that are not very far apart ($\approx 300 \mathrm{MHz}$).
This single frequency is also detuned from any known excited state frequency
by tens to hundreds of GHz (up to around $1 \mathrm{THz}$).
This is more directly related to the loss we care about.
(FWIW, the loss during Raman process is one of this type of measurements).\\

The second kind of measurement usually involve two laser frequencies.
\footnote{We've done measurements using the tweezer as PA without additional frequencies but
  those data are generally assumed to be power broadened since we cannot turn down the
  tweezer power too much during the measurement. Therefore, the tweezer PA measurement
  don't usually offer us much information on the excited state line width.}
One of the two frequencies is detuned by few GHz to a THz and the other one is scanned
around the resonance by up to a few GHz.\\

Since we usually express the difference in the ground state scattering rate in terms of
a difference in the excited state line width (lifetime), it is tempting to compare this
line width to the excited state line width direction measured at the same tweezer
frequency. This is the main reason why we were measuring Raman transition using
tweezer around $306614 \mathrm{GHz}$ after observing narrow line width for the nearby
excited state.\\

However, the two are not directly comparable. When we use the directly measured
excited state line width ($\Gamma_e$) to calculate the ground state scattering rate ($\gamma$)
for a certain large detuning ($\Delta$) as,

\[ \gamma=\Gamma\frac{\Omega_1\Omega_2}{4\Delta^2} \]

(where $\Omega_1$ and $\Omega_2$ are the single photon Rabi frequencies), we have
assumed that the loss of the excited state
(i.e. the continuum the excited state is coupled to in order to decay)
does not depend strongly on the final energy of the two photon process.
Depending on the structure of the continuum we couple to via the two photon process,
this may be a bad assumption.\\

This has subtly different implications for two photon couple up or two photon couple down.

\subsection{Two photon coupling up}
\begin{wrapfigure}{R}{9cm}
  \begin{center}
    \begin{tikzpicture}
      \draw[->, line width=2] (0, -0.5) -- (0, 5.5);
      \draw[line width=1] (0.5, 0) -- (2, 0) node[right] {$|g\rangle$};
      \draw[line width=1] (0.5, 2.3) -- (2, 2.3) node[right] {$|e\rangle$};
      \fill[opacity=0.2] (0.5, 3.8) rectangle (2, 5.4);
      \drawfill[domain=-0.8:0.8,smooth,variable=\y,red,line width=1,
      fill opacity=0.2]
      plot ({2.8 + 0.8 * exp(-100*pow(\y-0.5, 2)) +
        0.5 * exp(-40*pow(\y-0.2, 2)) +
        0.7 * exp(-70*pow(\y+0.1, 2)) +
        0.9 * exp(-50*pow(\y+0.6, 2))},{\y + 4.6})
      \skipit{--} (2.7, 4.6 + 0.8) \skipit{--} (2.7, 4.6 - 0.8) \skipit{-- cycle};
      \node[below] at (3.4, 4.6 - 0.9) {\small{Loss rate}};

      \draw[->, line width=1,blue] (1.25, 0) -- node[right] {$\Omega_1$} (1.25, 2);
      \draw[->, line width=1,green!80!black] (1.25, 2) -- node[right] {$\Omega_2$} (1.25, 4.0);
      \draw[dashed] (0.5, 4.0) -- (3.72, 4.0);
      \node at (3, 0.2) {(A)};
      \begin{scope}[shift={(4, 0)}]
        \draw[line width=1] (0.5, 0) -- (2, 0) node[right] {$|g\rangle$};
        \draw[line width=1] (0.5, 2.3) -- (2, 2.3) node[right] {$|e\rangle$};
        \fill[opacity=0.2] (0.5, 3.8) rectangle (2, 5.4);
        \drawfill[domain=-0.8:0.8,smooth,variable=\y,red,line width=1,
        fill opacity=0.2]
        plot ({2.8 + 0.8 * exp(-100*pow(\y-0.5, 2)) +
          0.5 * exp(-40*pow(\y-0.2, 2)) +
          0.7 * exp(-70*pow(\y+0.1, 2)) +
          0.9 * exp(-50*pow(\y+0.6, 2))},{\y + 4.6})
        \skipit{--} (2.7, 4.6 + 0.8) \skipit{--} (2.7, 4.6 - 0.8) \skipit{-- cycle};
        \node[below] at (3.4, 4.6 - 0.9) {\small{Loss rate}};

        \draw[->, line width=1,green!80!black] (1.25, 2.3) -- node[right] {$\Omega_2$} (1.25, 4.3);
        \draw[dashed] (0.5, 4.3) -- (2.85, 4.3);
        \node at (3, 0.2) {(B)};
      \end{scope}
    \end{tikzpicture}
  \end{center}
  \caption{Two photon coupling to a (lossy) continuum. (A) Off resonance measurement,
    (B) On resonance measurement.}
  \label{two-up-1}
\end{wrapfigure}

See \mbox{figure \ref{two-up-1}A}, the loss mechanism we suspect is a two photon coupling
to a lossy continuum with a frequency dependent loss rate
\footnote{The loss rate depends on the laser power, i.e. $\Omega_1$ and $\Omega_2$. Here
  ``loss rate'' essentially mean the loss rate per power squared, which is proportional to
  the square of the coupling from $|e\rangle$ and the density of state.
  Also note here since the second beam is coupling to a continuum rather than a single state
  in the generic case, $\Omega_2$ is not a single number but a function of frequency
  depending of the selection of normalization of the continuum.}.
Generically, the loss rate is not flat which may give us a frequency dependent
two photon loss rate. One way to see the difference between a detuned measurement
and a on-resonance (with the singe photon excited state $|e\rangle$)
measurement of the two photon decay rate is that the two process does not have the same
two photon frequencies. For the on-resonance measurement using the same laser that couples
$|e\rangle$ to the higher excited state (\mbox{figure \ref{two-up-1}B}),
the loss rate experienced by the two photon resonance can be different.
Since the loss rate can have an arbitrary dependency on frequency, one shouldn't expect
the difference in the loss rate to be included in the detuning factor when calculating
the scattering in the off-resonance case.\\

\begin{wrapfigure}{R}{5cm}
  \begin{center}
    \begin{tikzpicture}
      \draw[->, line width=2] (0, -0.5) -- (0, 5.5);

      \draw[dashed] (-0.05, 0) node[left] {$0$} -- (1.5, 0);
      \draw[dashed] (-0.05, 2.3) node[left] {$\omega_0$} -- (1.5, 2.3);
      \draw[dashed] (-0.05, 4.3) node[left] {$\omega_0 + \omega$} -- (1.5, 4.3);

      \draw[line width=1] (1.5, 0) -- (2, 0) node[right] {$|g\rangle$};
      \draw[line width=1] (1.5, 2.3) -- (2, 2.3) node[right] {$|e_1\rangle$};
      \draw[line width=1] (1.5, 4.3) -- (2, 4.3) node[right] {$|e_2\rangle$};
      \draw[line width=1] (0.2, 0) -- node[below] {$|g'\rangle$} (0.7, 0);
      \draw[snakearrow, line width=1, red] (1.75, 4.3) -- node[below left=0.2cm]
      {\large $\Gamma$} (0.45, 0);

      \draw[->, line width=1,blue] (1.75, 0) -- node[right] {$\omega$, $\Omega_1$} (1.75, 2);
      \draw[->, line width=1,green!80!black] (1.75, 2) --
      node[right] {$\omega$, $\Omega_2$} (1.75, 4);

      \draw[dashed] (0.5, 4) -- (2, 4);
      \draw[<->] (1, 4.3) -- (1, 4);
      \node[below] at (0.8, 4) {\footnotesize $\Delta\!\equiv\!\omega_0\!-\!\omega$};

      \draw[dashed] (1.3, 2) -- (2, 2);
      \draw[<->] (1.32, 2.3) -- (1.32, 2);
      \node[right] at (1.33, 2.13) {\footnotesize $\Delta$};
    \end{tikzpicture}
  \end{center}
  \caption{Four level model.}
  \label{two-up-2}
\end{wrapfigure}

As a more concrete example, we'll consider a single two photon excited state with
a stable single photon excited state.\\

See \mbox{figure \ref{two-up-2}}. The ground state $|g\rangle$ is coupled to $|e_1\rangle$,
$|e_1\rangle$ is coupled to $|e_2\rangle$ and $|e_2\rangle$ can decay to another ground
state $|g'\rangle$ with decay rate $\Gamma$ and a $100\%$ branching ratio.
The energy of the two ground states $|g\rangle$ and $|g'\rangle$ are both $0$,
the energy of $|e_1\rangle$ is $\omega_0$ and the energy of $|e_2\rangle$ is $\omega_0+\omega$.\\

The states are coupled by a single external laser with frequency $\omega$.
The laser drives the $|g\rangle\leftrightarrow|e_1\rangle$ transition
with a Rabi frequency $\Omega_1$ and the $|g\rangle\leftrightarrow|e_1\rangle$ transition
with a Rabi frequency $\Omega_2$. The single photon detuning on the $|e_1\rangle$ and
the two photon detuning on $|e_2\rangle$ are both $-\Delta\equiv\omega-\omega_0$.\\

For simplicity we have ignored the decay of the $|e_1\rangle$ state
and we assume the laser frequency is the same as the $|e_1\rangle$ $|e_2\rangle$
energy splitting. We will also assume that $\Omega_{1,2}\ll\Delta\ll\omega<\omega_0$
as well as $\Gamma\ll\Delta$. Some of the conditions may not be true in the real experiment
but this example should be enough to demonstrate the correct way to calculate
the scattering rate.\\

We'll calculate the scattering rate of the state $|g\rangle$ using a few different methods.
\footnote{All of the calculation below ignores the frequency dependency of the $|g'\rangle$
  continuum $|e_2\rangle$ decays to. All the scattering rate should be scaled by
  a factor of $\paren{\dfrac{2\omega}{\omega+\omega_0}}^3$.}

\subsubsection{Off resonance Raman scattering}

We can treat this as an off-resonance Raman scattering process.
The Raman Rabi rate for the $|g\rangle\rightarrow|e_1\rangle\rightarrow|e_2\rangle$ is

\[\Omega_R=\frac{\Omega_1\Omega_2}{2\Delta}\]

since $\Omega_R\ll\Omega_1\ll\Delta$, the off resonant scattering rate is,

\eqar{
  \gamma\approx&\frac{\Gamma}{4}\frac{\Omega_R^2}{\Delta^2}\\
  =&\frac{\Gamma}{16}\frac{\Omega_1^2\Omega_2^2}{\Delta^4}
}

\subsubsection{Single photon off resonance scattering from coupled excited state}
\begin{wrapfigure}[10]{R}{7cm}
  \begin{center}
    \begin{tikzpicture}
      \draw[->, line width=2] (0, -0.5) -- (0, 3.5);

      \draw[dashed] (-0.05, 0) node[left] {$0$} -- (1.5, 0);
      \draw[dashed] (-0.05, 2.15) node[left] {$\omega_0 - \Omega_2/2$} -- (1.5, 2.15);
      \draw[dashed] (-0.05, 2.45) node[left] {$\omega_0 + \Omega_2/2$} -- (1.5, 2.45);

      \draw[line width=1] (1.5, 0) -- (2, 0) node[right] {$|g\rangle$};
      \draw[line width=1] (1.5, 2.15) -- (2, 2.15) node[right] {$|-\rangle$};
      \draw[line width=1] (1.5, 2.45) -- (2, 2.45) node[right] {$|+\rangle$};
      \draw[line width=1] (0.2, 0) -- node[below] {$|g'\rangle$} (0.7, 0);
      \draw[snakearrow, line width=1, red] (1.75, 2.15) -- node[below right]
      {\large $\Gamma/2$} (0.5, 0);
      \draw[snakearrow, line width=1, red] (1.75, 2.45) -- node[left=0.1cm]
      {\large $\Gamma/2$} (0.3, 0);

      \node[above] at (1, 2.6) {(A)};

      \begin{scope}[shift={(2.6, 0)}]
        \draw[line width=1] (1.5, 0) -- (2, 0) node[right] {$|g\rangle$};
        \draw[line width=1] (1.5, 2.15) -- (2, 2.15) node[right] {$|-\rangle$};
        \draw[line width=1] (1.5, 2.45) -- (2, 2.45) node[right] {$|+\rangle$};
        \draw[line width=1] (0.2, 0) -- node[below] {$|g'\rangle$} (0.7, 0);
        \draw[<->, line width=1, blue] (2, 0) -- node[right]
        {$\frac{D_1}{\sqrt2}$} (2, 2.15);
        \draw[<->, line width=1, blue] (1.9, 0) -- node[above left]
        {$\frac{D_1}{\sqrt2}$} (1.9, 2.45);
        \draw[<->, line width=1, red] (0.2, 0) -- node[left=0.1]
        {$\frac{D'}{\sqrt2}$} (1.5, 2.45);
        \draw[<->, line width=1, red] (0.43, 0) -- (1.6, 2.15);
        \node[red, below right] at (0.9, 1.075) {$\frac{-D'}{\sqrt2}$};

        \node[above] at (1, 2.6) {(B)};
      \end{scope}
    \end{tikzpicture}
  \end{center}
  \caption{Coupled excited states. (B) Dipole moments between new states.}
  \label{two-up-coupled}
\end{wrapfigure}

More directly related to the excited state line width measurement, we can first couple the
two excited states together with $\Omega_2$.\\

See \mbox{figure \ref{two-up-coupled}A}. The excited states becomes

\[|\pm\rangle=\frac{1}{\sqrt2}\paren{|e_1\rangle\pm|e_2\rangle}\]

with energy $\omega_0\pm\Omega_2/2$ and each with a lifetime of $\dfrac\Gamma2$.
The Rabi frequency between the two excited states and the ground state is
$\Omega_\pm=\dfrac{\Omega_1}{\sqrt2}$.\\
The scattering from the two excited states are
\eqar{
  \gamma_\pm\approx&\frac{\Gamma}{8}\frac{\Omega_\pm^2}{\paren{\Delta\mp\Omega_2/2}^2}\\
  \approx&\frac{\Gamma}{16}\frac{\Omega_1^2}{\Delta^2}
}
and the total scattering rate
\eqar{
  \gamma=&\gamma_-+\gamma_+\\
  \approx&\frac{\Gamma}{8}\frac{\Omega_1^2}{\Delta^2}
}
which clearly doesn't agree with the result we calculated above.

\subsubsection{Single photon off resonance scattering from coupled excited state
  (the correct way)}

The apparent disagreement between the two result above suggests that one of them must be wrong
and it turns out that the second one is incorrect due to the wrong assumption it made.\\

In this case, the issue manifests itself as an incorrect off resonant scattering rate
from the excited state. There is not problem in coupling the excited state first to get
$|\pm\rangle$ but the decay process from the two states are not independent which give rise
to a different scattering rate away from resonance. (when $\Delta\gg\Omega_2$).
Instead, the scattering from the two excited states have to be treated as interfering
Raman processes and their amplitudes needs to be added, which will lead to cancellation
as we'll see soon, before squared to get the scattering rate.\\

The correct way to calculate this requires using the dipole moment between the states
\footnote{And the formula also correctly takes into account the density of state of
  the scattered photon and gives the correct
  $\paren{\dfrac{2\omega}{\omega+\omega_0}}^3$ factor}.
For the purpose of this note, however, it is enough to only calculate the interference term
and scales our previous result correspondingly.\\

Let the $D_1=\langle g|\hat d|e_1\rangle$ and $D_2=\langle g'|\hat d|e_2\rangle$ be
the dipole moment coupling $e_1$ and $e_2$ to the corresponding ground states $g$ and $g'$.
The dipole moments between the new states are shown in \mbox{figure \ref{two-up-coupled}B
  \footnote{The sign of the dipole moment depends on the selection of the phase for
    $|\pm\rangle$ but the relative sign of the product does not depend on the phase selection}.}\\

The wrong way to calculate the scattering gives a factor of
\eqar{
  &\paren{\frac{D'}{\sqrt2}\frac{D_1}{\sqrt2}\frac{1}{\Delta+\Omega_2/2}}^2+\paren{\frac{-D'}{\sqrt2}\frac{D_1}{\sqrt2}\frac{1}{\Delta-\Omega_2/2}}^2\\
  \approx&2\paren{\frac{D'}{\sqrt2}\frac{D_1}{\sqrt2}\frac{1}{\Delta}}^2\\
  =&\frac{D'^2D_1^2}{2\Delta^2}
}
The correct way gives,
\eqar{
  &\paren{\frac{D'}{\sqrt2}\frac{D_1}{\sqrt2}\frac{1}{\Delta+\Omega_2/2}+\frac{-D'}{\sqrt2}\frac{D_1}{\sqrt2}\frac{1}{\Delta-\Omega_2/2}}^2\\
  =&\frac{D'^2D_1^2}{4}\paren{\frac{1}{\Delta+\Omega_2/2}-\frac{1}{\Delta-\Omega_2/2}}^2\\
  =&\frac{D'^2D_1^2}{4}\paren{\frac{\Delta-\Omega_2/2-\Delta-\Omega_2/2}{\Delta^2-\Omega_2^2/4}}^2\\
  \approx&\frac{D'^2D_1^2\Omega_2^2}{4\Delta^4}
}
which means that we should scale the incorrect result above by
\[\frac{D'^2D_1^2\Omega_2^2}{4\Delta^4}\frac{2\Delta^2}{D'^2D_1^2}=\frac{\Omega_2^2}{2\Delta^2}\]
and the correct answer is
\eqar{
  \gamma=&\frac{\Gamma}{8}\frac{\Omega_1^2}{\Delta^2}\frac{\Omega_2^2}{2\Delta^2}\\
  =&\frac{\Gamma}{16}\frac{\Omega_1^2\Omega_2^2}{\Delta^4}
}
which is exactly what we got above.

\subsubsection{Summary for two photon coupling up}

In the particular case (two photon excite to a single state) we calculated,
the naive calculation using coupled excited state (i.e. direct result from PA measurement)
gives the wrong result because of the interference from different scattering channels.
More generally, to avoid this problem one need to realize,
\begin{enumerate}
\item The scattering is never a one photon process, one need to calculate the rate
  after considering all photon involved.
\item It is OK to couple some intermediate states first and use a dressed state picture
  to eliminate the number of photon/coupling/intermediate states involved. However,
  the coupled result may not be a single state and the scattering from the resulting
  states may not follow a simple $\Delta^{-2}$ rule.
\end{enumerate}

\subsection{Two photon coupling down}
\begin{wrapfigure}{R}{8.4cm}
  \begin{center}
    \begin{tikzpicture}
      \draw[->, line width=2] (0, -0.5) -- (0, 4);
      \draw[line width=1] (1, 0) node[left] {$|0\rangle$} -- (2, 0);
      \draw (1, 0.1) -- (2, 0.1);
      \draw (1, 0.2) -- (2, 0.2);
      \node[rotate=90] at (1.5, 0.5) {$\cdots$};
      \node[left] at (1, 0.5) {$|n\rangle$};
      \draw (1, 0.8) -- (2, 0.8);
      \draw (1, 0.9) -- (2, 0.9);
      \fill[opacity=0.2] (1, 1) rectangle (2, 1.5);

      \draw[line width=1] (1, 3.5) node[left] {$|e\rangle$} -- (2, 3.5);

      \draw[dashed] (1, 3) -- (2, 3);
      \draw[->, line width=1,green!80!black] (1.5, 3) -- node[right] {$\Omega_2$} (1.7, 1.2);
      \draw[->, line width=1,blue] (1.2, 0) -- node[above left] {$\Omega_1$} (1.5, 3);

      \node[above] at (1.5, 3.65) {(A)};
      \begin{scope}[shift={(1.4, 0)}]
        \draw[line width=1] (1, 0) -- (2, 0);
        \draw (1, 0.1) -- (2, 0.1);
        \draw (1, 0.2) -- (2, 0.2);
        \node[rotate=90] at (1.5, 0.5) {$\cdots$};
        \draw (1, 0.8) -- (2, 0.8);
        \draw (1, 0.9) -- (2, 0.9);
        \fill[opacity=0.2] (1, 1) rectangle (2, 1.5);

        \draw[line width=1] (1, 3.5) -- (2, 3.5);

        \draw[dashed] (1, 3) -- (2, 3);
        \draw[<->, line width=1,blue] (1.65, 0) -- node[above left] {$\Omega_1$} (1.65, 3);

        \node[above] at (1.5, 3.65) {(B)};
      \end{scope}
      \begin{scope}[shift={(2.8, 0)}]
        \draw[line width=1] (1, -0.5) node[left] {$|\!-\!1\rangle$} -- (2, -0.5);
        \draw[line width=1] (1, 0) -- (2, 0);
        \draw (1, 0.1) -- (2, 0.1);
        \draw (1, 0.2) -- (2, 0.2);
        \node[rotate=90] at (1.5, 0.5) {$\cdots$};
        \draw (1, 0.8) -- (2, 0.8);
        \draw (1, 0.9) -- (2, 0.9);
        \fill[opacity=0.2] (1, 1) rectangle (2, 1.5);

        \draw[line width=1] (1, 3.5) -- (2, 3.5);

        \draw[dashed] (1, 3) -- (2, 3);
        \draw[<->, line width=1,green!80!black] (1.51, 3) -- (1.7, -0.5);
        \node[above right,green!80!black] at (1.6, 1.5) {$\Omega_2$};
        \draw[<->, line width=1,blue] (1.2, 0) -- node[above left] {$\Omega_1$} (1.49, 3);

        \node[above] at (1.5, 3.65) {(C)};
      \end{scope}
      \begin{scope}[shift={(4.2, 0)}]
        \draw[line width=1] (1, 0) -- (2, 0);
        \draw (1, 0.1) -- (2, 0.1);
        \draw (1, 0.2) -- (2, 0.2);
        \node[rotate=90] at (1.5, 0.5) {$\cdots$};
        \draw (1, 0.8) -- (2, 0.8);
        \draw (1, 0.9) -- (2, 0.9);
        \fill[opacity=0.2] (1, 1) rectangle (2, 1.5);

        \draw[line width=1] (1, 3.5) -- (2, 3.5);

        \draw[dashed] (1, 3) -- (2, 3);
        \draw[->, dashed, line width=0.3,blue] (1.5, 3) -- node[right] {$\Omega_1'$} (1.7, 1.2);
        \draw[->, line width=1,blue] (1.2, 0) -- node[above left] {$\Omega_1$} (1.5, 3);

        \node[above] at (1.5, 3.65) {(D)};
      \end{scope}
      \begin{scope}[shift={(5.6, 0)}]
        \fill[red,opacity=0.2] (1.8, -0.5) rectangle (2.5, 0.5);
        \draw[line width=1] (1, 0) -- (1.7, 0);
        \draw (1, 0.1) -- (1.7, 0.1);
        \draw (1, 0.2) -- (1.7, 0.2);
        \node[rotate=90] at (1.35, 0.5) {$\cdots$};
        \draw (1, 0.8) -- (1.7, 0.8);
        \draw (1, 0.9) -- (1.7, 0.9);
        \fill[opacity=0.2] (1, 1) rectangle (1.7, 1.5);

        \draw[line width=1] (1, 3.5) -- (2.5, 3.5);

        \draw[dashed] (1, 3) -- (2.5, 3);
        \draw[<->, line width=1,blue] (1.4, 0) -- node[above left] {$\Omega_1$} (1.75, 3);
        \draw[<->, line width=1,blue] (2.1, 0) -- node[above right] {$\Omega_1'$} (1.75, 3);

        \node[above] at (1.75, 3.65) {(E)};
      \end{scope}
    \end{tikzpicture}
  \end{center}
  \caption{Coupling to ground state motional continuum. (A) Raman into motional continuum.
    (B) Single ground HF state, single laser frequency. (C) Single ground HF state,
    two frequencies for molecular Raman. (D) Unexpected sideband in laser.
    (E) Zero energy continuum.}
  \label{two-down}
\end{wrapfigure}

The potential second photon coupling down pathway is very similar.
See \mbox{figure \ref{two-down}A}. The loss is caused by the ground state (atomic or molecular)
coupling to the ground motional continuum.\\

We can also directly apply the two points from the summary above.
\begin{enumerate}
\item In order to calculate ground state loss, we should consider the Raman process,
  which will likely have very different motional energies compared to the motional energy
  coupling down from the excited state.
\item The excited state is coupled to an atomic motional continuum and the resulting loss
  will have a very different profile from then $\Delta^{-2}$ scaling. Even if we
  see a broadening of the excited state due to this coupling, it does not mean much
  for the corresponding ground state loss rate.
\end{enumerate}

The two kinds of ground state scattering measurements we have are atomic state PA rate
and molecular state scattering (using Raman transition).
Assuming the laser is clean and no other states are involved,
\begin{enumerate}
\item For atomic scattering rate (\mbox{figure \ref{two-down}B}), there is only
  one frequency so the Raman process can only come back down to the same energy as
  the initial state, which is not in an continuum.
\item For molecular scattering rate during transfer (\mbox{figure \ref{two-down}C}),
  similarly, the only energy the molecular state could couple to is the initial energy
  or a deeper bound state (2x the binding energy). Neither of these is a continuum either.\\
  The atomic state can indeed be coupled to the continuum but it should be much weaker than
  the molecular state (the up leg is much smaller) and we have not measured a decrease in
  atomic 2-body lifetime when the Raman beam is turned on.
\end{enumerate}
Therefore, in order to generate any loss from this process for the ground state,
we need to have either,
\begin{enumerate}
\item Additional frequencies in the laser (\mbox{figure \ref{two-down}D}) which
  can couple the state of interest to the motional continuum. Or,
\item Continuum that has zero energy (\mbox{figure \ref{two-down}E}) that the Raman beam
  can couple to.\\
  Candidate for this continuum includes the center of mass (COM) motional states and
  the motional continuum from other HF states.\\
  The COM motional continuum actually also starts at a positive energy so it doesn't seem
  possible. The continuum from other HF states is much more promising especially since
  we know that the $|F^{\mathrm{Cs}}\!=\!3, m_{F}^{\mathrm{Cs}}\!=\!3; F^{\mathrm{Na}}\!=\!2, m_{F}^{\mathrm{Na}}\!=\!2\rangle$ state has a strong coupling to the molecular excited states.
  \sout{However, this cannot be applied to the $|F^{\mathrm{Cs}}\!=\!3, m_{F}^{\mathrm{Cs}}\!=\!3; F^{\mathrm{Na}}\!=\!2, m_{F}^{\mathrm{Na}}\!=\!2\rangle$ state lifetime since it is already
    the HF state with the lowest energy.}
  Kang-Kuen and Kenneth pointed out that $|F^{\mathrm{Cs}}\!=\!3, m_{F}^{\mathrm{Cs}}\!=\!3; F^{\mathrm{Na}}\!=\!1, m_{F}^{\mathrm{Na}}\!=\!1\rangle$ is the state with the lowest energy
  so $|F^{\mathrm{Cs}}\!=\!3, m_{F}^{\mathrm{Cs}}\!=\!3; F^{\mathrm{Na}}\!=\!2, m_{F}^{\mathrm{Na}}\!=\!2\rangle$ indeed have a (in fact, multiple Zeeman states) continuum to couple to.
\end{enumerate}

\subsection{Summary for interpreting and connecting excited state and ground state results}

From the discussion above, we see that no matter what kind of couple we have,
the excited state line width may not be directly related to the life time in the tweezer
of the corresponding frequency. For up coupling, the result is more closely related
to the lifetime for tweezer of the average frequency, whereas for down coupling,
the lifetime may not be related to the excited state line width at all.

\section{Loss due to coupling to ground state motional continuum}

Calculating the loss rate for coupling to the continuum requires knowledge of the
continuum wavefunction. This is hard to do accurately for states with significant
energy since the fine energy spacing will blow up the number of states involved.
Fortunately, since we know the interaction potential is short range and much deeper
than any of the motional energy scales, we can make certain approximations in order
to get the coupling to the continuum based on the known coupling to the trapped atomic
states in the tweezer.\\

First of all, we are going to ignore the COM motion and only consider the relative motion.
This shouldn't affect our answer for coupling to the relative motional continuum too much
but it does prevent us from calculating the coupling to the COM motional continuum.
Since the COM motional continuum only exists at roughly the same energy levels as the
relative motion, this should not be an issue (the coupling to the relative continuum
at the same energy should always be stronger).\\

We'll also only consider $L=0$ motional states since,
\begin{enumerate}
\item The selection rule means that we can only couple to at most a few low $L$ states.
\item The coupling to $L\neq0$ states are weaker due to smaller wave function amplitude
  for short distance.
\end{enumerate}

We can then consider a small enough volume around the $r=0$ of the relative coordinate.
The coupling to the excited molecular state is entirely determined by the wavefunction
inside. The wavefunction inside is determined by the boundary condition,
which for $L=0$\footnote{Or for any particular $L$ and $m_L$} is a single number,
and the energy of the state. Since the energy of the motional state is much smaller than
the depth of the interaction potential, we can expect the shape of the wavefunction
to be almost independent of the energy and the amplitude of it to be proportional to
the boundary condition. In the weak interaction limit\footnote{This should be true for most
  motional state with the exception of $|F^{\mathrm{Cs}}\!=\!3, m_{F}^{\mathrm{Cs}}\!=\!3; F^{\mathrm{Na}}\!=\!2, m_{F}^{\mathrm{Na}}\!=\!2\rangle$ state.},
we can assume that the boundary condition is given by the value of
the non-interacting wavefunction at $r=0$.\\

In the ground motional state, the trapping frequencies are $\omega_i$ where $i=1,2,3$
along the three axis. The value of the wavefunction at $r=0$ is,

\eqar{
  \psi_0=&\prod_{i=1}^{3}\paren{\frac{m\omega_i}{\pi\hbar}}^{1/4}\\
  =&\paren{\frac{m^3\omega_1\omega_2\omega_3}{\pi^3\hbar^3}}^{1/4}
}

Assume the Rabi frequency between the state of interest and the ground motional state
is $\Omega$\footnote{This can be either a Raman Rabi frequency for ground state loss rate,
  or the up leg single photon Rabi frequency for the excited state broadening.},
the Rabi frequency for another motional state would be,

\eqar{
  \Omega'=&\Omega\psi'(r=0)\paren{\frac{\pi^3\hbar^3}{m^3\omega_1\omega_2\omega_3}}^{1/4}
}
where $\psi'(r=0)$ is the value of the wavefunction for the other motional state at $r=0$.\\

In order to calculate the coupling to the continuum, we'll start with a discrete set of states
and and then take the energy gap to $0$ to calculate the result for true continuum.
We'll use two different sets of states to calculate for cross-checking\footnote{
  Note that both calculations will be done under the same assumptions given above so their
  agreement does not validate the assumption.}.

\subsection{Harmonic oscillator states}

We can treat the continuum as the limit of a infinitely loose 3D harmonic oscillator state.
Assuming a trapping frequency $\omega$, we are interested in the value of the wavefunction
at $r=0$ for large $n$ where $n$ is the radial quantum number (energy gap of $2\omega$).

I'll calculate this value using two methods as well.

\subsubsection{Using radial wavefunction $u=r\psi_r$}

After doing the substitution of $u=r\psi_r(r)$, the Schr\"odinger equation for $u$ becomes
that of a 1D harmonic oscillator with a hard wall at $r=0$. The eigenstates are the odd
harmonic oscillator states for the normal 1D potential and $\psi(r=0)$ is given by $\left.\dfrac{1}{\sqrt{4\pi}}\ddiff{u}{r}\right|_{r=0}$.\\

The normalized wavefunction for $u$ is,

\eqar{
  u_n=&\frac{(-1)^n\sqrt{2}}{\sqrt{2^{2n+1}(2n+1)!}}\paren{\frac{m\omega}{\pi\hbar}}^{1/4}\exp\paren{-\frac{m\omega r^2}{2\hbar}}H_{2n+1}\paren{\sqrt{\frac{m\omega}{\hbar}}r}\\
  \psi(r=0)=&\left.\dfrac{1}{\sqrt{4\pi}}\ddiff{u}{r}\right|_{r=0}\\
  =&\dfrac{1}{\sqrt{2\pi}}\frac{(-1)^n}{\sqrt{2^{2n+1}(2n+1)!}}\paren{\frac{m\omega}{\pi\hbar}}^{1/4}
  \left.\ddiff{}{r}H_{2n+1}\paren{\sqrt{\frac{m\omega}{\hbar}}r}\right|_{r=0}\\
  =&\dfrac{1}{\sqrt{2\pi}}\frac{(-1)^n}{\sqrt{2^{2n+1}(2n+1)!}}\paren{\frac{m\omega}{\pi\hbar}}^{1/4}\sqrt{\frac{m\omega}{\hbar}}2(2n + 1) H_{2n}\paren{0}\\
  =&\frac{(-1)^n}{\sqrt{2^{2n+2}(2n+1)!}}2(2n + 1)(-2)^n (2n - 1)!!\paren{\frac{m\omega}{\pi\hbar}}^{3/4}\\
  =&\frac{2^{n+1}(2n + 1) (2n - 1)!}{(n-1)!2^{n-1}\sqrt{2^{2n+2}(2n+1)!}}\paren{\frac{m\omega}{\pi\hbar}}^{3/4}\\
  =&\sqrt{\frac{(2n + 1)!}{2^{2n}n^2}}\frac{1}{(n-1)!}\paren{\frac{m\omega}{\pi\hbar}}^{3/4}\\
  =&\sqrt{\frac{\sqrt{2\pi (2n+1)}(2n+1)^{2n+1}}{2^{2n}n^2\ue^{2n+1}}}\frac{\ue^{n-1}}{\sqrt{2\pi (n-1)}(n-1)^{n-1}}\paren{\frac{m\omega}{\pi\hbar}}^{3/4}\\
  \approx&\sqrt{\frac{\sqrt{2\pi(2n+1)}(2n+1)^{2n+1}}{\pi\ue^{3}(2n-2)^{2n+1}}}\paren{\frac{m\omega}{\pi\hbar}}^{3/4}\\
  \approx&\paren{\frac{4n}{\pi}}^{1/4}\paren{\frac{m\omega}{\pi\hbar}}^{3/4}
}

\subsubsection{Using 3D harmonic wavefunction}
\eqar{
  \psi(r=0)=&\frac{1}{\sqrt{4\pi}}\sqrt{\sqrt{\frac{m^3\omega^3}{4\pi\hbar^3}}\frac{2^{n+3}n!}{(2n+1)!!}}L_n^{1/2}(0)\\
  =&\frac{1}{\sqrt{4\pi}}\sqrt{\sqrt{\frac{m^3\omega^3}{4\pi\hbar^3}}\frac{2^{n+3}2^n}{(2n+1)!}}n!L_n^{1/2}(0)\\
  \approx&\frac{1}{\sqrt{4\pi}}\sqrt{\sqrt{\frac{m^3\omega^3}{\pi\hbar^3}}\frac{2^{2n+2}}{(2n+1)!}}\frac{n! 2\sqrt{n}}{\sqrt{\pi}}\\
  \approx&\frac{1}{\sqrt{4\pi}}\sqrt{\frac{\pi 2^{2n+2}\ue^{2n+1}}{\sqrt{2\pi (2n+1)}(2n+1)^{2n+1}}}\sqrt{2\pi n}\paren{\frac{n}{\ue}}^n\frac{2\sqrt{n}}{\sqrt{\pi}}\paren{\frac{m\omega}{\pi\hbar}}^{3/4}\\
  =&\sqrt{\frac{2\pi (2n)^{2n+2}\ue}{\pi\sqrt{2\pi (2n+1)}(2n+1)^{2n+1}}}\paren{\frac{m\omega}{\pi\hbar}}^{3/4}\\
  \approx&\paren{\frac{4n}{\pi}}^{1/4}\paren{\frac{m\omega}{\pi\hbar}}^{3/4}
}
which agrees with the other method.\\

The Rabi frequency to the motional state is therefore,
\eqar{
  \Omega'=&\Omega\psi'(r=0)\paren{\frac{\pi^3\hbar^3}{m^3\omega_1\omega_2\omega_3}}^{1/4}\\
  =&\Omega\paren{\frac{4n}{\pi}}^{1/4}\paren{\frac{m\omega}{\pi\hbar}}^{3/4}\paren{\frac{\pi^3\hbar^3}{m^3\omega_1\omega_2\omega_3}}^{1/4}\\
  =&\Omega\paren{\frac{4n\omega^3}{\pi\omega_1\omega_2\omega_3}}^{1/4}
}
The decay rate is
\eqar{
  \gamma=&\frac{2\pi\Omega'^2}{2\omega}\\
  =&\frac{\pi\Omega^2}{\omega}\sqrt{\frac{4n\omega^3}{\pi\omega_1\omega_2\omega_3}}\\
  =&\Omega^2\sqrt{\frac{2\pi E}{\omega_1\omega_2\omega_3}}
}
where $E$ is the energy (in frequency unit) of the continuum energy we are coupling to.

\subsection{Spherical box}

We can also treat the continuum as the spectrum of a large spherical infinitely deep well
when the radius of the sphere $R$ is infinite.
The radial wavefunctions of the eigenstates are,

\eqar{
  u_n=&\sqrt{\frac{2}{R}}\sin\paren{\frac{\pi nr}{R}}
}

with energy\footnote{In frequency unit} $E=\dfrac{\pi^2\hbar n^2}{2mR^2}$.
Energy gap between neighboring state is $\Delta E\approx\dfrac{\pi^2\hbar n}{mR^2}$,

\eqar{
  \psi(r=0)=&\left.\dfrac{1}{\sqrt{4\pi}}\ddiff{u}{r}\right|_{r=0}\\
  =&\frac{\pi n}{\sqrt{2\pi R}R}\\
  \Omega'=&\Omega\psi'(r=0)\paren{\frac{\pi^3\hbar^3}{m^3\omega_1\omega_2\omega_3}}^{1/4}\\
  =&\Omega\frac{\pi n}{\sqrt{2\pi R}R}\paren{\frac{\pi^3\hbar^3}{m^3\omega_1\omega_2\omega_3}}^{1/4}
}

The decay rate is
\eqar{
  \gamma=&\frac{2\pi\Omega'^2}{\Delta E}\\
  =&2\pi\Omega^2\frac{\pi^2 n^2}{2\pi R^3}\sqrt{\frac{\pi^3\hbar^3}{m^3\omega_1\omega_2\omega_3}}\frac{mR^2}{\pi^2\hbar n}\\
  =&\Omega^2\frac{n}{R}\sqrt{\frac{\pi^3\hbar}{m\omega_1\omega_2\omega_3}}\\
  =&\Omega^2\frac{1}{R}\sqrt{\frac{\pi^3\hbar}{m\omega_1\omega_2\omega_3}\frac{2mR^2E}{\pi^2\hbar}}\\
  =&\Omega^2\sqrt{\frac{2\pi E}{\omega_1\omega_2\omega_3}}
}
Which is the same result we got using the harmonic oscillator states.

\end{document}
