nacs-lab/yyc-data/notes/sp-polarization/sp.tex

\documentclass{article}

\usepackage{graphics}
\usepackage[pdftex]{graphicx}

\begin{document}

\pagenumbering{gobble}

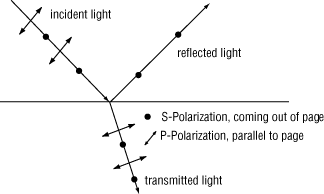
[picture p61: notes/sp-polarization/1.png]
\hspace{-3cm}
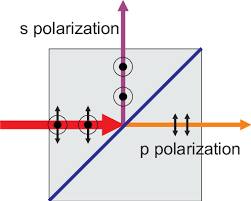
[picture p62: notes/sp-polarization/2.png]
\hspace{1cm}\\
\vspace{0.5cm}\\
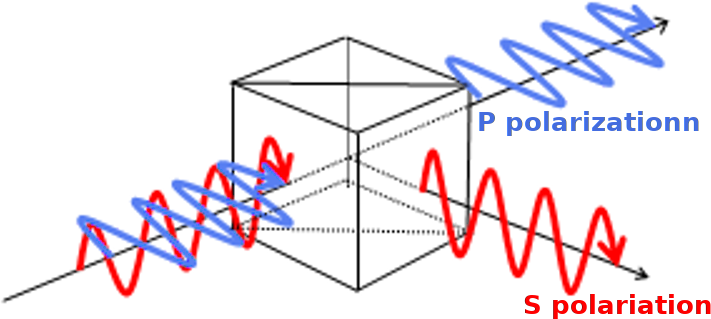
[picture p63: notes/sp-polarization/3.png]
\\
\vspace{0.5cm}\\
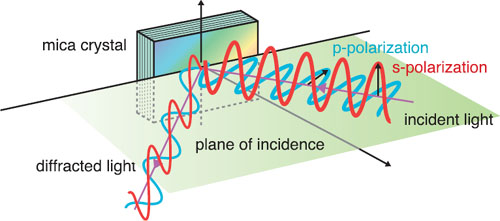
[picture p64: notes/sp-polarization/4.png]


\end{document}
