nacs-lab/yyc-data/presentations/2019-09-05_itamp/molecule_in_tweezers.tex

\documentclass[border={-65pt -5pt -5pt -3pt}]{standalone}
\usepackage{tikz}
\usetikzlibrary{
  arrows,
  calc,
  decorations.pathmorphing,
  decorations.pathreplacing,
  decorations.markings,
  fadings,
  positioning,
  shapes,
  arrows.meta
}
\usepgfmodule{oo}

\pgfdeclareradialshading{glow2}{\pgfpoint{0cm}{0cm}}{
  color(0mm)=(white);
  color(2mm)=(white);
  color(8mm)=(black);
  color(10mm)=(black)
}
\pgfdeclareradialshading{glow}{\pgfpoint{0cm}{0cm}}{
  color(0mm)=(white);
  color(5mm)=(white);
  color(9mm)=(black);
  color(10mm)=(black)
}

\begin{tikzfadingfrompicture}[name=glow fading]
  \shade [shading=glow] (0,0) circle (1);
\end{tikzfadingfrompicture}

\begin{tikzfadingfrompicture}[name=glow2 fading]
  \shade [shading=glow2] (0,0) circle (1);
\end{tikzfadingfrompicture}

\begin{document}

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

\begin{tikzpicture}
  \mytweezer.up(0, 0)
  \mytweezer.down(2, 0.8/2.5)
  \mytweezer.up(4, 1.2/2.5)
  \begin{pgfonlayer}{tweezer}
    \draw[line width=1,dashed,color=cyan] (0, 0/2.5) -- (2, 0.8/2.5);
    \draw[line width=1,dashed,color=cyan] (0, 0/2.5) -- (1, -1.7/2.5);
    \draw[line width=1,dashed,color=cyan] (2, 0.8/2.5) -- (1, -1.7/2.5);
    \draw[line width=1,dashed,color=cyan] (3, -2.1/2.5) -- (1, -1.7/2.5);
    \draw[line width=1,dashed,color=cyan] (3, -2.1/2.5) -- (2, 0.8/2.5);
    \draw[line width=1,dashed,color=cyan] (4, 1.2/2.5) -- (2, 0.8/2.5);
    \draw[line width=1,dashed,color=cyan] (3, -2.1/2.5) -- (4, 1.2/2.5);
    \draw[line width=1,dashed,color=cyan] (3, -2.1/2.5) -- (5, -1.9/2.5);
    \draw[line width=1,dashed,color=cyan] (4, 1.2/2.5) -- (5, -1.9/2.5);
    \draw[line width=1,dashed,color=cyan] (6.2, -0.9/2.5) -- (4, 1.2/2.5);
    \draw[line width=1,dashed,color=cyan] (6.2, -0.9/2.5) -- (5, -1.9/2.5);
  \end{pgfonlayer}
  \mytweezer.down(1, -1.7/2.5)
  \mytweezer.up(3, -2.1/2.5)
  \mytweezer.down(5, -1.9/2.5)
  \mytweezer.down(6.2, -0.9/2.5)
\end{tikzpicture}

\end{document}
