nacs-lab/yyc-data/presentations/2018-09-28/present.tex

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

% not mandatory, but I though it was better to set it blank
\setbeamertemplate{headline}{}
\def\beamer@entrycode{\vspace{-\headheight}}

\tikzstyle{snakearrow} = [decorate, decoration={pre length=0.2cm,
  post length=0.2cm, snake, amplitude=.4mm,
  segment length=2mm},thick, ->]

%% document-wide tikz options and styles

\tikzset{%
  % >=latex, % option for nice arrows
  inner sep=0pt,%
  outer sep=2pt,%
  mark coordinate/.style={inner sep=0pt,outer sep=0pt,minimum size=3pt,
    fill=black,circle}%
}
\tikzset{
  % Define standard arrow tip
  >=stealth',
  % Define style for boxes
  punkt/.style={
    rectangle,
    rounded corners,
    draw=black, very thick,
    text width=8em,
    minimum height=2.5em,
    text centered},
}

\tikzset{onslide/.code args={<#1>#2}{%
    \only<#1>{\pgfkeysalso{#2}}
    % \pgfkeysalso doesn't change the path
  }}
\tikzset{alt/.code args={<#1>#2#3}{%
    \alt<#1>{\pgfkeysalso{#2}}{\pgfkeysalso{#3}}
    % \pgfkeysalso doesn't change the path
  }}
\tikzset{temporal/.code args={<#1>#2#3#4}{%
    \temporal<#1>{\pgfkeysalso{#2}}{\pgfkeysalso{#3}}{\pgfkeysalso{#4}}
    % \pgfkeysalso doesn't change the path
  }}

\makeatletter
\newbox\@backgroundblock
\newenvironment{backgroundblock}[2]{%
  \global\setbox\@backgroundblock=\vbox\bgroup%
  \unvbox\@backgroundblock%
  \vbox to0pt\bgroup\vskip#2\hbox to0pt\bgroup\hskip#1\relax%
}{\egroup\egroup\egroup}
\addtobeamertemplate{background}{\box\@backgroundblock}{}
\makeatother

% \def\timeleft{15:00->14:55}

\title{NaCs lab update}
\date{Sep. 28, 2018}
\author{Yichao Yu}
\institute{Ni Group}

\begin{document}

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

{
  \usebackgroundtemplate{
    \makebox[\paperwidth][c]{\centering}
  }
  \setbeamercolor{title}{fg=cyan!50}
  \setbeamercolor{author}{fg=white}
  \setbeamercolor{institute}{fg=white}
  \setbeamercolor{date}{fg=white}
  \begin{frame}{}
    \titlepage
  \end{frame}
}

% Plan to create NaCs
% * Raman transfer scheme
% * Previous finding
% Issue: The trap
% * Light shift (300kHz)
% * Scattering (~10 kHz)
% New plan: use the trap
% Meadowlark LCD waveplate
\begin{frame}{}
  \begin{center}
    \begin{tikzpicture}
      \begin{scope}[scale=0.7]
        \draw[->,line width=1.2] (0, 0) -- (0, 8);
        \node[above,rotate=90] at (0, 4) {Energy};
        \draw[->,line width=1.2] (0, 0) -- (8, 0);
        \node[below] at (4, -0.5) {Internuclear distance};

        \draw[cyan!85!blue] (1.0269 + 0.25, 2.5) -- (7.25, 2.5);
        \draw[cyan!85!blue] (1.0793 + 0.25, -0.4631 + 2.5) -- (4.5 + 0.25, -0.4631 + 2.5);

        \draw[line width=1.1,cyan!85!blue]
        plot[samples=200,domain=1:7,variable=\x]
        ({\x + 0.25}, {6.8*\x^(-3.4)-6.5*\x^(-1.7) + 2.5});
        \node[cyan!85!blue] at (3.75, 1.0) {$a^3\Sigma^+$};

        \draw[line width=1.1,red]
        plot[samples=200,domain=1:7.5,variable=\x]
        ({\x - 0.75}, {9.2*\x^(-2.5)-9.0*\x^(-1.3) + 7.5});
        \node[above right,red] at (0.55, 7.2) {$c^3\Sigma^+$};

        \mytweezer.drawNaAtom(6.55, 2.6, 0.12)
        \mytweezer.drawCsAtom(7.05, 2.6, 0.10)

        \mytweezer.drawNaAtom(4.08, 2.15, 0.12)
        \mytweezer.drawCsAtom(4.25, 2.15, 0.10)

        \draw[black!40,dashed,line width=1] (0.25, 5) -- (7.25, 5);

        \draw[->,green!80!black,alt=<-6>{line width=0.8}{line width=2}] (6.8, 2.7) -- (5.5, 5)
        node[midway, right, align=left] {$\approx1038\mathrm{nm}$\only<7->{\\\ \ \ Tweezer}};
        \draw[->,green!80!black,alt=<-6>{line width=0.8}{line width=2}] (5.45, 5) -- (4.165, 2.25);

        \visible<5-6>{
          \draw[->,orange,line width=2] (3, 2.15) -- (3, 6.1)
          node[midway, left, align=center] {$976\mathrm{nm}$\\\only<5>{Tweezer}\only<6->{Problem}};
        }
      \end{scope}
      \visible<2-3> {
        \node at (3, 6.8) {};
        \draw[->,dashed,red,line width=0.8] (2, 5.5) -- (0.7, 3.85);
      }
      \visible<3> {
        \node at (8.4, 4.2) {};
        \node at (9.2, 1) {};
        \draw[->,dashed,cyan,line width=1] (7, 2.5) -- (3, 1.5);
      }
      \visible<5-6>{
        \node[above right,green!60!black,align=left] at (6.5, 4.5) {
          $\mathbf{1038nm}$:\\
          Power: $10\mathrm{mW}$\\
          Size: $12\mathrm{\mu m}$\\
          {\visible<6->{Rabi frequency: $\approx 100\mathrm{Hz}$}}};
        \node[below right,orange!90!black,align=left] at (6.5, 4.0)
        {$\mathbf{976nm}$:\\
          Power: $15\mathrm{mW}$\\
          Size: $0.7\mathrm{\mu m}$\\
          {\visible<6->{Stark shift: $300\mathrm{kHz}$}}\\
          {\visible<6->{Scattering: $\approx 10\mathrm{kHz}$ {\tiny (molecular state)}}}};
      }
      \visible<7->{
        \node[right,green!60!black,align=left] at (6.5, 5) {
          $\mathbf{1038nm}$:\\
          Power: $15\mathrm{mW}$\\
          Size: $0.7\mathrm{\mu m}$\\
          Rabi frequency: $\approx 3\mathrm{kHz}$\\
          Stark shift: $\approx 200\mathrm{kHz}$\\
          Scattering: $\approx 160\mathrm{Hz}$\\
          {\small (at $\delta=-\!100\mathrm{GHz}$)}};
      }
      \visible<8->{
        \node[right,align=left,text width=4.5cm] at (6.5, 1.5) {
          Use tunable liquid crystal waveplate from Meadowlark to switch between
          full power tweezer and Raman configuration during the sequence.
        };
      }
    \end{tikzpicture}
  \end{center}
\end{frame}

% Interaction shift measurement
% * Goal: help locating the bound state*, refine Feshbach resonance predictions.
% Experimental
% * Requires good cooling. (used to check cooling)
% * See more peeks than expected
% Interpretation
% * Shift -> scattering length or
% * scattering length

\begin{frame}{Interaction shift}
  \begin{columns}
    \column{5.5cm}
    \begin{tikzpicture}
      \visible<-5>{
        \node[align=center,text width=5.5cm] at (0, 0) {
          \begin{block}{Goal}
            \begin{itemize}
            \item<+-> Calculate binding energy
            \item<+-> Refine Feshbach resonance prediction
            \end{itemize}
          \end{block}
        };
      }
      \visible<6->{
        \node[align=center,text width=5.5cm] at (0, 0) {
          \begin{center}
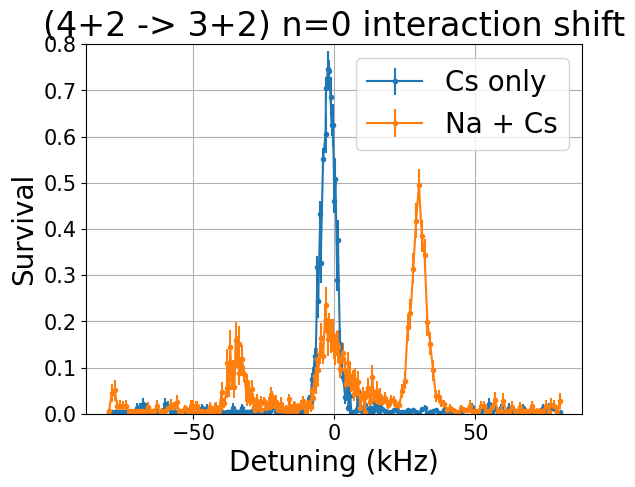
[picture p75: experiments/nacs_201808/imgs/data_20180815_interaction_shift4_cs_n0.png]
            \\
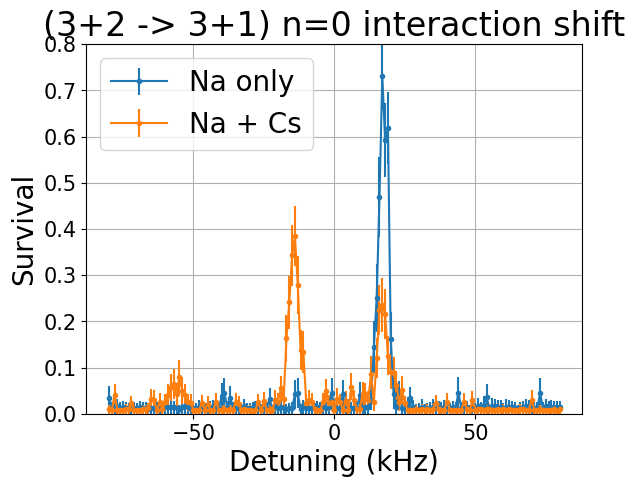
[picture p76: experiments/nacs_201808/imgs/data_20180815_interaction_shift4_na_n0.png]
            
          \end{center}
        };
      }
    \end{tikzpicture}
    \column{6cm}
    \begin{center}
      \vspace{-1.5cm}
      \begin{tikzpicture}
        \visible<3->{
          \draw[line width=1]
          plot[samples=200,domain=-1.5:1.5,variable=\x]
          ({\x}, {(\x)^2 * 1.2});
          \draw[line width=0.6] (-0.5400617248673217, 0.35) -- (0.5400617248673217, 0.35);
          \draw[line width=0.6] (-0.9354143466934853, 1.05) -- (0.9354143466934853, 1.05);
          \draw[line width=0.6] (-1.20761472884912, 1.75) -- (1.20761472884912, 1.75);

          \draw[line width=1]
          plot[samples=200,domain=-1.5:1.5,variable=\x]
          ({\x+3.2}, {(\x)^2 * 1.2 - 4});
          \draw[line width=0.6] (-0.5400617248673217 + 3.2, 0.35 - 4)
          -- (0.5400617248673217 + 3.2, 0.35 - 4);
          \draw[line width=0.6] (-0.9354143466934853 + 3.2, 1.05 - 4)
          -- (0.9354143466934853 + 3.2, 1.05 - 4);
          \draw[line width=0.6] (-1.20761472884912 + 3.2, 1.75 - 4)
          -- (1.20761472884912 + 3.2, 1.75 - 4);

          \visible<4->{
            \draw[red,line width=0.6] (-0.5400617248673217 + 3.2, 0.35 - 4 - 0.25)
            -- (0.5400617248673217 + 3.2, 0.35 - 4 - 0.25);
            \draw[red,line width=0.6] (-0.9354143466934853 + 3.2, 1.05 - 4 - 0.15)
            -- (0.9354143466934853 + 3.2, 1.05 - 4 - 0.15);
            \draw[red,line width=0.6] (-1.20761472884912 + 3.2, 1.75 - 4 - 0.09)
            -- (1.20761472884912 + 3.2, 1.75 - 4 - 0.09);
          }

          \visible<5->{
            \draw[->,line width=1,green!85!black] (0, 0.35) -- (3.2, 0.35 - 4 - 0.125);
          }

          \visible<7->{
            \fill[opacity=0.93,white] (-1.55, 2.75) rectangle (3.2 + 1.55, -4.05);
            \node[below, align=center, text width=5.5cm] at (1.3, 3.7) {
              {\large \usebeamercolor[fg]{frametitle} Shift $\leftrightarrow$ Scattering length}\\
              \vspace{0.5cm}
              \begin{itemize}
              \item First order perturbation
                \[\delta E\propto a\]
              \item<8-> Full diagonalization\\
                \begin{center}
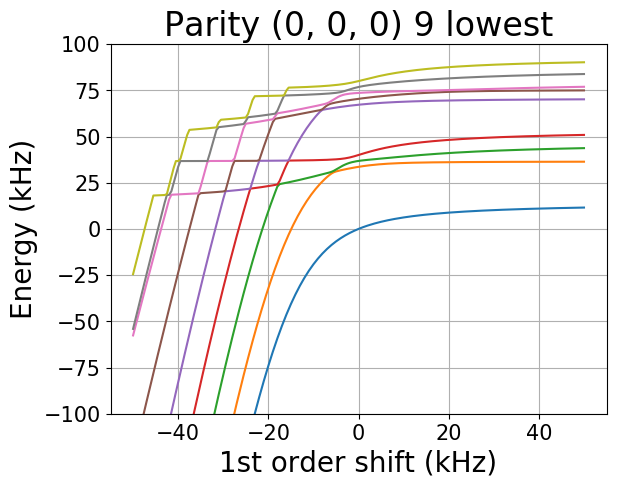
[picture p77: calculations/clock_shift/imgs/real0_energy_000_9.png]
                  \visible<8->{}
                \end{center}
              \end{itemize}
            };
          }
        }
      \end{tikzpicture}
    \end{center}
  \end{columns}
\end{frame}

\end{document}
