nacs-lab/yyc-data/presentations/2018_progress/progress.md

# Research accomplished in the past year

1. Working on implementing Raman transfer to bound NaCs electronic ground state

    * Measured PA resonance for deeply bound excited electronic state
    * Observed EIT resonance
    * Observed Raman resonance

2. Experiment with multiple tweezers

    * Measured the effect of trap polarization and AOM longitudinal (Z) misalignment
    * Improve stability of tweezer power

3. Working on microwave transfer to bound NaCs electrounic ground state

    * Measured atomic microwave transition

4. Improved atom temperature

    * Improved Na Raman sideband cooling performance (Larger detuning and better pulse shaping)
    * Improve merge temperature (Axial alignment and better trap intensity stability)

# Experiment timeline

* 2018 - early 2019

    * Create loosely bound NaCs molecule
    * Create singlet ground state NaCs molecule

Goals of the experiment:

* Create multiple NaCs singlet ground state molecules

* Demonstrate interaction and quantum gates

# List of in progress or completed publications

1. Motional Ground State Cooling Outside the Lamb-Dicke Regime - PRA

2. Building one molecule from a reservoir of two atoms - Science

# List of talks or presentations

1. Manipulating single NaCs in optical tweezers -- Apr. 4th, 2018

2. Association of single ultracold molecules in optical tweezers -- DAMOP poster
