nacs-lab/yyc-data/presentations/2018-04-04_hqoc/present.tex

\documentclass{beamer}
\mode<presentation>{
  \usetheme{Boadilla}
  \usefonttheme[onlylarge]{structurebold}
  \usefonttheme[stillsansseriflarge]{serif}
  \setbeamerfont*{frametitle}{size=\normalsize,series=\bfseries}
  % \setbeamertemplate{navigation symbols}{}
  \setbeamercovered{transparent}
}
\usepackage[english]{babel}
\usepackage[latin1]{inputenc}
\usepackage{times}
\usepackage[T1]{fontenc}
\usepackage{amsmath}
\usepackage{amssymb}
\usepackage{esint}
\usepackage{hyperref}
\usepackage{tikz}
\usepackage{xkeyval}
\usepackage{xargs}
\usepackage{verbatim}
\usepackage{listings}
\usepackage{multimedia}
\usepackage{bm}
\usepackage{siunitx}
\usetikzlibrary{
  arrows,
  calc,
  decorations.pathmorphing,
  decorations.pathreplacing,
  decorations.markings,
  fadings,
  positioning,
  shapes,
  arrows.meta
}
\usepgfmodule{oo}
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
  \draw[current plane,dashed] (\angVis-180:1) arc (\angVis-180:\angVis:1);
}
\newcommand\DrawLatitudeCircleArrow[2][1]{
  \LatitudePlane{\angEl}{#2}
  \tikzset{current plane/.prefix style={scale=#1}}
  \pgfmathsetmacro\sinVis{sin(#2)/cos(#2)*sin(\angEl)/cos(\angEl)}
  % angle of "visibility"
  \pgfmathsetmacro\angVis{asin(min(1,max(\sinVis,-1)))}
  \draw[current plane,decoration={markings, mark=at position 0.6 with {\arrow{<}}},postaction={decorate},line width=.6mm] (\angVis:1) arc (\angVis:-\angVis-180:1);
  \draw[current plane,dashed,line width=.6mm] (180-\angVis:1) arc (180-\angVis:\angVis:1);
}
\newcommand\DrawLatitudeCircle[2][1]{
  \LatitudePlane{\angEl}{#2}
  \tikzset{current plane/.prefix style={scale=#1}}
  \pgfmathsetmacro\sinVis{sin(#2)/cos(#2)*sin(\angEl)/cos(\angEl)}
  % angle of "visibility"
  \pgfmathsetmacro\angVis{asin(min(1,max(\sinVis,-1)))}
  \draw[current plane] (\angVis:1) arc (\angVis:-\angVis-180:1);
  \draw[current plane,dashed] (180-\angVis:1) arc (180-\angVis:\angVis:1);
}
\newcommand\coil[1]{
  {\rh * cos(\t * pi r)}, {\apart * (2 * #1 + \t) + \rv * sin(\t * pi r)}
}
\makeatletter
\define@key{DrawFromCenter}{style}[{->}]{
  \tikzset{DrawFromCenterPlane/.style={#1}}
}
\define@key{DrawFromCenter}{r}[1]{
  \def\@R{#1}
}
\define@key{DrawFromCenter}{center}[(0, 0)]{
  \def\@Center{#1}
}
\define@key{DrawFromCenter}{theta}[0]{
  \def\@Theta{#1}
}
\define@key{DrawFromCenter}{phi}[0]{
  \def\@Phi{#1}
}
\presetkeys{DrawFromCenter}{style, r, center, theta, phi}{}
\newcommand*\DrawFromCenter[1][]{
  \setkeys{DrawFromCenter}{#1}{
    \pgfmathsinandcos\sint\cost{\@Theta}
    \pgfmathsinandcos\sinp\cosp{\@Phi}
    \pgfmathsinandcos\sinA\cosA{\angEl}
    \pgfmathsetmacro\DX{\@R*\cost*\cosp}
    \pgfmathsetmacro\DY{\@R*(\cost*\sinp*\sinA+\sint*\cosA)}
    \draw[DrawFromCenterPlane] \@Center -- ++(\DX, \DY);
  }
}
\newcommand*\DrawFromCenterText[2][]{
  \setkeys{DrawFromCenter}{#1}{
    \pgfmathsinandcos\sint\cost{\@Theta}
    \pgfmathsinandcos\sinp\cosp{\@Phi}
    \pgfmathsinandcos\sinA\cosA{\angEl}
    \pgfmathsetmacro\DX{\@R*\cost*\cosp}
    \pgfmathsetmacro\DY{\@R*(\cost*\sinp*\sinA+\sint*\cosA)}
    \draw[DrawFromCenterPlane] \@Center -- ++(\DX, \DY) node {#2};
  }
}
\makeatother

% not mandatory, but I though it was better to set it blank
\setbeamertemplate{headline}{}
\def\beamer@entrycode{\vspace{-\headheight}}

\tikzstyle{snakearrow} = [decorate, decoration={pre length=0.2cm,
  post length=0.2cm, snake, amplitude=.4mm,
  segment length=2mm},thick, ->]

%% document-wide tikz options and styles

\tikzset{%
  % >=latex, % option for nice arrows
  inner sep=0pt,%
  outer sep=2pt,%
  mark coordinate/.style={inner sep=0pt,outer sep=0pt,minimum size=3pt,
    fill=black,circle}%
}
\tikzset{
  % Define standard arrow tip
  >=stealth',
  % Define style for boxes
  punkt/.style={
    rectangle,
    rounded corners,
    draw=black, very thick,
    text width=8em,
    minimum height=2.5em,
    text centered},
}

\tikzset{onslide/.code args={<#1>#2}{%
    \only<#1>{\pgfkeysalso{#2}}
    % \pgfkeysalso doesn't change the path
  }}
\tikzset{alt/.code args={<#1>#2#3}{%
    \alt<#1>{\pgfkeysalso{#2}}{\pgfkeysalso{#3}}
    % \pgfkeysalso doesn't change the path
  }}
\tikzset{temporal/.code args={<#1>#2#3#4}{%
    \temporal<#1>{\pgfkeysalso{#2}}{\pgfkeysalso{#3}}{\pgfkeysalso{#4}}
    % \pgfkeysalso doesn't change the path
  }}

\makeatletter
\newbox\@backgroundblock
\newenvironment{backgroundblock}[2]{%
  \global\setbox\@backgroundblock=\vbox\bgroup%
  \unvbox\@backgroundblock%
  \vbox to0pt\bgroup\vskip#2\hbox to0pt\bgroup\hskip#1\relax%
}{\egroup\egroup\egroup}
\addtobeamertemplate{background}{\box\@backgroundblock}{}
\makeatother

% \def\timeleft{15:00->14:55}

\title[Single NaCs in optical tweezers]{Manipulating single NaCs in optical tweezers}
\date{April 18, 2018}
\author[Yichao Yu]{Yichao Yu\\
  \vspace{0.5cm}
  {\footnotesize Lee Liu, Dr. Jon Hood}}
\institute{Ni Group/Harvard}

\begin{document}

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

% Title
%% Talk about our experiment on creating and manipulating single NaCs molecules in
%% optical tweezers.

{
  \usebackgroundtemplate{
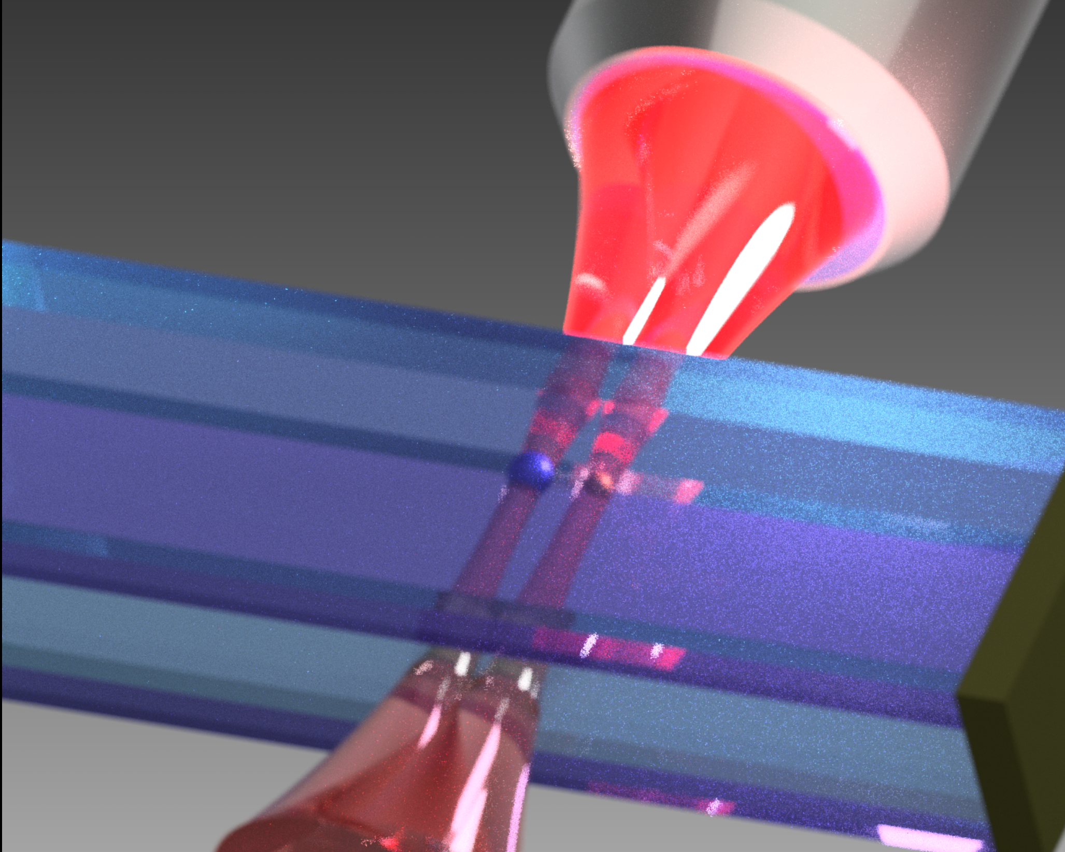
[picture p78: presentations/2018-04-04_hqoc/front_bg.png]
    \makebox[\paperwidth][c]{\centering}
  }
  \setbeamercolor{title}{fg=cyan!50}
  \setbeamercolor{author}{fg=white}
  \setbeamercolor{institute}{fg=white}
  \setbeamercolor{date}{fg=white}
  \begin{frame}{}
    \titlepage
  \end{frame}
}

% \begin{frame}{}
%   \tableofcontents
% \end{frame}

% In our experiment,
%% we want to build a system that has complete control of molecules at single particle level.
%% Useful tool to study and take advantage of the reaction and interaction between molecules.
%% Do this with optical tweezers, (for it's properties)
%% Molecule of choise is NaCs, strong dipole moment and easy to cool.

\begin{frame}{}
  \begin{center}
    \begin{tikzpicture}
      \mytweezer.up(0, 0)
      \mytweezer.down(2, 0.8/2.5)
      \mytweezer.up(4, 1.2/2.5)
      \begin{pgfonlayer}{tweezer}
        \draw[line width=1,dashed,color=cyan] (0, 0/2.5) -- (2, 0.8/2.5);
        \draw[line width=1,dashed,color=cyan] (0, 0/2.5) -- (1, -1.7/2.5);
        \draw[line width=1,dashed,color=cyan] (2, 0.8/2.5) -- (1, -1.7/2.5);
        \draw[line width=1,dashed,color=cyan] (3, -2.1/2.5) -- (1, -1.7/2.5);
        \draw[line width=1,dashed,color=cyan] (3, -2.1/2.5) -- (2, 0.8/2.5);
        \draw[line width=1,dashed,color=cyan] (4, 1.2/2.5) -- (2, 0.8/2.5);
        \draw[line width=1,dashed,color=cyan] (3, -2.1/2.5) -- (4, 1.2/2.5);
        \draw[line width=1,dashed,color=cyan] (3, -2.1/2.5) -- (5, -1.9/2.5);
        \draw[line width=1,dashed,color=cyan] (4, 1.2/2.5) -- (5, -1.9/2.5);
        \draw[line width=1,dashed,color=cyan] (6.2, -0.9/2.5) -- (4, 1.2/2.5);
        \draw[line width=1,dashed,color=cyan] (6.2, -0.9/2.5) -- (5, -1.9/2.5);
      \end{pgfonlayer}
      \mytweezer.down(1, -1.7/2.5)
      \mytweezer.up(3, -2.1/2.5)
      \mytweezer.down(5, -1.9/2.5)
      \mytweezer.down(6.2, -0.9/2.5)
    \end{tikzpicture}
    \pause
    \begin{columns}
      \column{5.5cm}
      \begin{block}{Optical tweezer}
        \begin{itemize}
        \item Single site detection
          \pause
        \item Single site control
          \pause
        \item Flexible geometry
        \end{itemize}
      \end{block}
      \column{5.5cm}
      \pause
      \begin{block}{NaCs molecule}
        \begin{itemize}
        \item Strong dipole interaction\\
          Dipole moment: 4.6 Debye
          \pause
        \item Made from alkali atoms
        \end{itemize}
      \end{block}
    \end{columns}
  \end{center}
\end{frame}

% Steps
%% Cooling molecule is hard.
%% In order to reach the ultra cold temperature needed for, assemble from atoms instead.
%% Start from two atoms grab from MOT (pic)
%% Do Raman sideband cooling (spectrum, performance)
%% Merge and make molecules (merge graph)

\begin{frame}{}
  \begin{center}
    \begin{tikzpicture}[scale=0.75]
      \mytweezer.drawCsTweezer(0, 0)
      \mytweezer.drawNaTweezer(-1, 0)
      \mytweezer.drawCsAtom(-0.07, 0.08, 0.22)
      \mytweezer.drawNaAtom(-1.06, -0.09, 0.27)

      \mytweezer.drawCsTweezer(0, -3.1)
      \mytweezer.drawNaTweezer(-1, -3.1)
      \mytweezer.drawCsAtom(0.0, -3.1, 0.12)
      \mytweezer.drawNaAtom(-1.0, -3.1, 0.16)

      \mytweezer.drawCsTweezer(-1, -7.0)
      \mytweezer.drawNaAtom(-1.05, -6.87, 0.16)
      \mytweezer.drawCsAtom(-0.95, -7.13, 0.12)

      \fill[white,temporal=<1>{opacity=0.82}{opacity=0}{opacity=0.5}]
      (-1.5, 1.5) rectangle (0.5, -1.5);
      \fill[white,temporal=<2>{opacity=0.82}{opacity=0}{opacity=0.5}]
      (-1.5, 1.5 - 3.1) rectangle (0.5, -1.5 - 3.1);
      \fill[white,temporal=<3>{opacity=0.82}{opacity=0}{opacity=0.5}]
      (-1.5, 1.5 - 7.0) rectangle (-0.5, -1.5 - 7.0);

      \visible<2->{
        \begin{scope}[alt=<2>{opacity=0.7}{opacity=0.35}]
          \draw[orange,dotted,line width=1.2] (-1, -0.4) -- (-1, -2.9);
          \draw[blue,dotted,line width=1.2] (0, -0.15) -- (0, -2.9);
        \end{scope}
      }

      \visible<3->{
        \begin{scope}[alt=<3>{opacity=0.7}{opacity=0.35}]
          \draw[->,orange,line width=1.2] (-1, -3.3) -- (-1, -6.7);
          \draw[->,blue,domain=-3.3:-6.7,smooth,variable=\y,line width=1.2]
          plot ({atan((\y+4.7) * 5) / 170 - 0.5},{\y});
        \end{scope}
      }
      \visible<1>{
        \node[above,align=center] at (7, 0)
        {\usebeamerfont{frametitle}\usebeamercolor[fg]{frametitle}{\Large Loading}};
        \node[below,align=center] at (6.5, -0.5)
        {};
        \node[below,align=center] at (7, -7.5)
        {Loading probability per site: 60\%\\
          Post select on initial and final state.};
      }
      \visible<2>{
        \node[above,align=center] at (7, 0)
        {\usebeamerfont{frametitle}\usebeamercolor[fg]{frametitle}{\Large Cooling}};
        \node[below] at (6.5, -1)
        {};
        % Don't mention axis.
        % Explain the sideband spectrum more.
        \node[below,align=center] at (7, -7)
        {Cs: 96\% ground state\\Na: 94\% ground state};
      }
      \visible<3>{
        \node[above,align=center] at (7, 0)
        {\usebeamerfont{frametitle}\usebeamercolor[fg]{frametitle}{\Large Merging}};
        \draw[orange,line width=1.5] plot[draw,samples=200,domain=4.5:10.5]
        function {-0.22 * exp(-(x - 9)**2 / 0.75**2) + -0.4 * exp(-(x - 6)**2 / 0.75**2) - 1};
        \draw[blue,line width=1.5] plot[draw,samples=200,domain=4.5:10.5]
        function {-1.2 * exp(-(x - 9)**2 / 0.75**2) + 0.45 * exp(-(x - 6)**2 / 0.75**2) - 1};
        \mytweezer.drawNaAtom(6, -1.22, 0.15)
        \mytweezer.drawCsAtom(9, -2.06, 0.11)

        \draw[orange,line width=1.5] plot[draw,samples=200,domain=4.5:10]
        function {-0.22 * exp(-(x - 7.5)**2 / 0.75**2) + -0.4 * exp(-(x - 6)**2 / 0.75**2) - 3.5};
        \draw[blue,line width=1.5] plot[draw,samples=200,domain=4.5:10]
        function {-1.2 * exp(-(x - 7.5)**2 / 0.75**2) + 0.45 * exp(-(x - 6)**2 / 0.75**2) - 3.5};
        \mytweezer.drawNaAtom(6, -3.72, 0.15)
        \mytweezer.drawCsAtom(7.5, -4.56, 0.11)

        \draw[orange,line width=1.5] plot[draw,samples=200,domain=4.5:8.5]
        function {-0.22 * exp(-(x - 6)**2 / 0.75**2) + -0.4 * exp(-(x - 6)**2 / 0.75**2) - 6};
        \draw[blue,line width=1.5] plot[draw,samples=200,domain=4.5:8.5]
        function {-1.2 * exp(-(x - 6)**2 / 0.75**2) + 0.45 * exp(-(x - 6)**2 / 0.75**2) - 6};
        \mytweezer.drawNaAtom(5.9, -6.42, 0.12)
        \mytweezer.drawCsAtom(6.05, -6.6, 0.13)

        \draw[orange,line width=1.5] plot[draw,samples=200,domain=4.5:8.5]
        function {-0.22 * exp(-(x - 6)**2 / 0.75**2) - 8.5};
        \draw[blue,line width=1.5] plot[draw,samples=200,domain=4.5:8.5]
        function {-1.2 * exp(-(x - 6)**2 / 0.75**2) - 8.5};
        \mytweezer.drawNaAtom(6, -8.55, 0.14)
        \mytweezer.drawCsAtom(6, -9.56, 0.11)

        \draw[dotted,line width=2,black!30,opacity=10] (0.3, -3.0) -- (4.5, -0.5);
        \draw[dotted,line width=2,black!30,opacity=10] (-0.7, -7.0) -- (4.5, -9.3);
      }
    \end{tikzpicture}
  \end{center}
\end{frame}

\begin{frame}{Photoassociation (PA)}
  \begin{center}
    \begin{tikzpicture}
      \visible<2->{
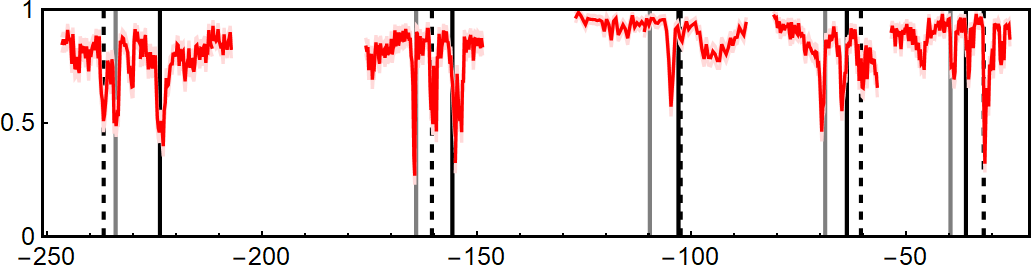
[picture p79: presentations/2018-04-04_hqoc/pa.png]
        \node at (0, 0) {};
        \node[below] at (0, -1.1) {\small PA detuning (GHz)};
      }
      \visible<3->{
        \node[text width=5cm] at (4, -4) {\begin{block}{Advantages of optical tweezer}
            \begin{itemize}
            \item High density
            \item Clear distinction from single body loss
            \end{itemize}
          \end{block}};
      }
      \begin{scope}[shift={(-4, -6.5)},scale=0.65]
        \draw[->,line width=1.2] (0, 0) -- (0, 8);
        \node[above,rotate=90] at (0, 4) {Energy};
        \draw[->,line width=1.2] (0, 0) -- (8, 0);
        \node[below] at (4, -0.5) {Internuclear distance};

        \draw[cyan!85!blue] (1.0269 + 0.25, 2.5) -- (7.25, 2.5);

        \draw[red] (1.1102 - 0.75, -0.7720 + 7.5) -- (6 - 0.75, -0.7720 + 7.5);
        \draw[red] (1.1576 - 0.75, -1.0595 + 7.5) -- (4.5 - 0.75, -1.0595 + 7.5);

        \draw[line width=1.1,cyan!85!blue]
        plot[samples=200,domain=1:7,variable=\x]
        ({\x + 0.25}, {6.8*\x^(-3.4)-6.5*\x^(-1.7) + 2.5});
        \node[cyan!85!blue] at (3.75, 1.0) {$a^3\Sigma^+$};

        \draw[line width=1.1,red]
        plot[samples=200,domain=1:7.5,variable=\x]
        ({\x - 0.75}, {9.2*\x^(-2.5)-9.0*\x^(-1.3) + 7.5});
        \node[above right,red] at (0.55, 7.2) {$c^3\Sigma^+$};

        \mytweezer.drawNaAtom(6.55, 2.6, 0.12)
        \mytweezer.drawCsAtom(7.05, 2.6, 0.10)

        \draw[->,blue!50!orange,line width=0.8] (6.8, 2.7) -- (4.5 - 0.75, -0.85 + 7.5);
      \end{scope}
    \end{tikzpicture}
  \end{center}
\end{frame}

\begin{frame}{Getting to ground state}
  \begin{center}
    \begin{columns}
      \column{4cm}
      \begin{block}{}
        \begin{itemize}
        \item Full control of internal state
        \item Stronger interaction
        \end{itemize}
      \end{block}
      \column{7cm}
      \begin{tikzpicture}
        \visible<2>{
          \begin{scope}[shift={(2.8, 0.5)}]
            \shade[ball color=orange!90] (0, 0) circle (0.3);
            \shade[ball color=blue!90] (0.3, 0.1) circle (0.2);
            \draw[<->,line width=0.7] (-0.05, -0.5) -- (0.6, -0.25);
            \node[rotate=21.04,below=2pt] at (0.295, -0.375) {$4a_0$};
          \end{scope}

          \begin{scope}[shift={(2.8, 2)}]
            \draw[line width=0.7] plot[samples=200,domain=-2:2,variable=\x]
            ({\x}, {(\x)^2 * 0.8});
            \draw[line width=1.5,blue!50!orange]
            plot[samples=200,domain=-2:2,variable=\x]
            ({\x}, {exp(-(\x)^2 * 1.3) - 0.988 + 1.5});
            \draw[line width=0.8] (-0.8, -0.988 + 1.5) -- (0.8, -0.988 + 1.5);
            \draw[<->,line width=1] (-1, 0.3 + 1.5) -- (1, 0.3 + 1.5);
            \node[above] at (0, 0.3 + 1.5) {$1000a_0$};
          \end{scope}
        }

        \visible<3>{
          \begin{scope}[scale=0.7]
            \draw[->,line width=1.2] (0, 0) -- (0, 8);
            \node[above,rotate=90] at (0, 4) {Energy};
            \draw[->,line width=1.2] (0, 0) -- (8, 0);
            \node[below] at (4, -0.5) {Internuclear distance};

            \draw[cyan!85!blue] (1.0269 + 0.25, 2.5) -- (7.25, 2.5);
            \draw[cyan!85!blue] (1.0793 + 0.25, -0.4631 + 2.5) -- (4.5 + 0.25, -0.4631 + 2.5);

            \draw[line width=1.1,cyan!85!blue]
            plot[samples=200,domain=1:7,variable=\x]
            ({\x + 0.25}, {6.8*\x^(-3.4)-6.5*\x^(-1.7) + 2.5});
            \node[cyan!85!blue] at (3.75, 1.0) {$a^3\Sigma^+$};

            \draw[line width=1.1,red]
            plot[samples=200,domain=1:7.5,variable=\x]
            ({\x - 0.75}, {9.2*\x^(-2.5)-9.0*\x^(-1.3) + 7.5});
            \node[above right,red] at (0.55, 7.2) {$c^3\Sigma^+$};

            \mytweezer.drawNaAtom(6.55, 2.6, 0.12)
            \mytweezer.drawCsAtom(7.05, 2.6, 0.10)

            \mytweezer.drawNaAtom(4.08, 2.15, 0.12)
            \mytweezer.drawCsAtom(4.25, 2.15, 0.10)

            \draw[black!40,dashed,line width=1] (0.25, 5) -- (7.25, 5);

            \draw[->,green!80!black,line width=0.8] (6.8, 2.7) -- (5.5, 5);
            \draw[->,green!80!black,line width=0.8] (5.45, 5) -- (4.165, 2.25);
          \end{scope}
        }
      \end{tikzpicture}
    \end{columns}
  \end{center}
\end{frame}

\begin{frame}{\alt<-1>{Photoassociation (PA)}{Electromagnetically Induced Transparency (EIT) spectroscopy}}
  \begin{center}
    \begin{tikzpicture}
      \node at (0, 0) {};
      \node[below] at (0, -1.1) {\small PA detuning (GHz)};
      \visible<2->{
        \fill[white,opacity=0.8] (-4.1, -2) rectangle (3.58, 1.05);
        \fill[white,opacity=0.8] (3.72, -2) rectangle (4, 1.05);
        \draw[opacity=0.5,line width=1] (3.72, -0.9) rectangle (3.58, 1.05);
        \visible<3>{
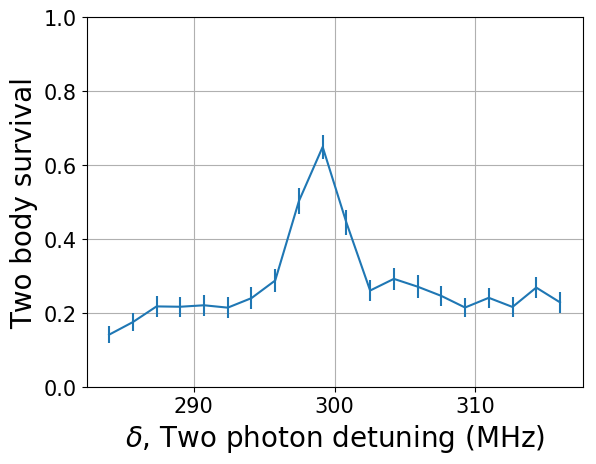
[picture p80: presentations/2018-04-04_hqoc/eit.png]
          \node at (4, -4) {};
          % \node[below] at (4, -5.7) {\small Two photon detuning (MHz)};
        }
      }
      \begin{scope}[shift={(-4, -6.5)},scale=0.65]
        \draw[->,line width=1.2] (0, 0) -- (0, 8);
        \node[above,rotate=90] at (0, 4) {Energy};
        \draw[->,line width=1.2] (0, 0) -- (8, 0);
        \node[below] at (4, -0.5) {Internuclear distance};

        \draw[cyan!85!blue] (1.0269 + 0.25, 2.5) -- (7.25, 2.5);
        \only<2->{
          \draw[cyan!85!blue] (1.0793 + 0.25, -0.4631 + 2.5) -- (4.5 + 0.25, -0.4631 + 2.5);
          \draw[cyan!85!blue,<->] (3.5, 2.5) -- ++(0, -0.4631) node[midway, left]
          {\tiny $\delta$};
        }

        \draw[red] (1.1102 - 0.75, -0.7720 + 7.5) -- (6 - 0.75, -0.7720 + 7.5);
        \draw[red] (1.1576 - 0.75, -1.0595 + 7.5) -- (4.5 - 0.75, -1.0595 + 7.5);

        \draw[line width=1.1,cyan!85!blue]
        plot[samples=200,domain=1:7,variable=\x]
        ({\x + 0.25}, {6.8*\x^(-3.4)-6.5*\x^(-1.7) + 2.5});
        \node[cyan!85!blue] at (3.75, 1.0) {$a^3\Sigma^+$};

        \draw[line width=1.1,red]
        plot[samples=200,domain=1:7.5,variable=\x]
        ({\x - 0.75}, {9.2*\x^(-2.5)-9.0*\x^(-1.3) + 7.5});
        \node[above right,red] at (0.55, 7.2) {$c^3\Sigma^+$};

        \mytweezer.drawNaAtom(6.55, 2.6, 0.12)
        \mytweezer.drawCsAtom(7.05, 2.6, 0.10)

        \only<2->{
          \mytweezer.drawNaAtom(4.08, 2.15, 0.12)
          \mytweezer.drawCsAtom(4.25, 2.15, 0.10)
        }

        \draw[->,blue!50!orange,line width=0.8] (6.8, 2.7) -- (4.5 - 0.75, -0.85 + 7.5);
        \only<2->{
          \draw[->,green!80!black,line width=0.8] (4.165, 2.25) -- (4.45 - 0.75, -0.85 + 7.5);
        }
      \end{scope}
    \end{tikzpicture}
  \end{center}
\end{frame}

\begin{frame}{Next step}
  \begin{center}
    {\Large Make ground state molecules!!}\\
    \vspace{0.5cm}
    \visible<2->{
      Thank you for your attention.\\
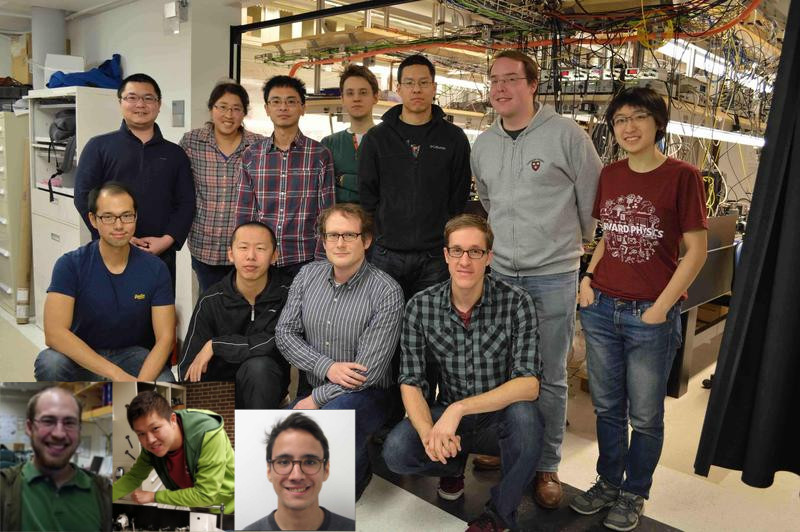
[picture p81: presentations/2018-04-04_hqoc/group.jpg]
      
    }
  \end{center}
\end{frame}

\end{document}
