nacs-lab/yyc-data/presentations/2017_progress/progress.md

# Research accomplished in the past year

1. Implement and optmize Raman sideband cooling for Sodium

    * Observe and characterize Raman sideband in all three axis
    * Obtain a better understanding of the cooling process by calculating or measuring most
      of the imperfections during the cooling
    * Optimize the cooling sequence and characterize the cooling results.

2. Observe NaCs photo-association spectrum

    * Merge Na and Cs trap
    * Reduce spin exchange loss between Na and Cs atoms by preparing the initial hyperfine states
    * Measure NaCs electronic excited state energy levels

# Experiment timeline

* 2017 - early 2018

    Create loosely bound NaCs molecule

* 2018

    Create singlet ground state NaCs molecule

Goals of the experiment:

* Create multiple NaCs singlet ground state molecules

* Demonstrate interaction and quantum gates

# List of in progress or completed publications

1. Motional Ground State Cooling Outside the Lamb-Dicke Regime - PRL (in progress)

# List of talks or presentations

1. Polar Molecule Express -- May. 5th, 2015

2. Trapping and imaging of single atoms in the presence of light shift -- May. 26th, 2016 (DAMP)

3. Raman sideband cooling of a single sodium atom to 3D ground state -- Apr. 19, 2017
