nacs-lab/yyc-data/notes/wigner/wigner.tex

\documentclass[10pt,fleqn]{article}
% \usepackage[journal=rsc]{chemstyle}
% \usepackage{mhchem}
\usepackage{amsmath}
\usepackage{amssymb}
\usepackage{amsfonts}
\usepackage{esint}
\usepackage{bbm}
\usepackage{amscd}
\usepackage{picinpar}
\usepackage{graphicx}
\usepackage{tikz}
\usepackage{tikz-3dplot}
\usepackage{indentfirst}
\usepackage{wrapfig}
\usepackage{units}
\usepackage{textcomp}
\usepackage[utf8x]{inputenc}
% \usepackage{feyn}
\usepackage{feynmp}
\usepackage{xkeyval}
\usepackage{xargs}
\usepackage{verbatim}
\usepackage{pgfplots}
\usepackage{hyperref}
\usetikzlibrary{
  arrows,
  calc,
  decorations.pathmorphing,
  decorations.pathreplacing,
  decorations.markings,
  fadings,
  positioning,
  shapes
}
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
\pagestyle{fancy}
\setlength{\headheight}{67pt}
\fancyhead{}
\fancyfoot{}
\fancyfoot[C]{\thepage}
\fancyhead[R]{}
\renewcommand{\footruleskip}{0pt}
\renewcommand{\headrulewidth}{0.4pt}
\renewcommand{\footrulewidth}{0pt}

\newcommand\pgfmathsinandcos[3]{%
  \pgfmathsetmacro#1{sin(#3)}%
  \pgfmathsetmacro#2{cos(#3)}%
}
\newcommand\LongitudePlane[3][current plane]{%
  \pgfmathsinandcos\sinEl\cosEl{#2} % elevation
  \pgfmathsinandcos\sint\cost{#3} % azimuth
  \tikzset{#1/.estyle={cm={\cost,\sint*\sinEl,0,\cosEl,(0,0)}}}
}
\newcommand\LatitudePlane[3][current plane]{%
  \pgfmathsinandcos\sinEl\cosEl{#2} % elevation
  \pgfmathsinandcos\sint\cost{#3} % latitude
  \pgfmathsetmacro\yshift{\cosEl*\sint}
  \tikzset{#1/.estyle={cm={\cost,0,0,\cost*\sinEl,(0,\yshift)}}} %
}
\newcommand\DrawLongitudeCircle[2][1]{
  \LongitudePlane{\angEl}{#2}
  \tikzset{current plane/.prefix style={scale=#1}}
  % angle of "visibility"
  \pgfmathsetmacro\angVis{atan(sin(#2)*cos(\angEl)/sin(\angEl))} %
  \draw[current plane] (\angVis:1) arc (\angVis:\angVis+180:1);
  \draw[current plane,dashed] (\angVis-180:1) arc (\angVis-180:\angVis:1);
}
\newcommand\DrawLatitudeCircleArrow[2][1]{
  \LatitudePlane{\angEl}{#2}
  \tikzset{current plane/.prefix style={scale=#1}}
  \pgfmathsetmacro\sinVis{sin(#2)/cos(#2)*sin(\angEl)/cos(\angEl)}
  % angle of "visibility"
  \pgfmathsetmacro\angVis{asin(min(1,max(\sinVis,-1)))}
  \draw[current plane,decoration={markings, mark=at position 0.6 with {\arrow{<}}},postaction={decorate},line width=.6mm] (\angVis:1) arc (\angVis:-\angVis-180:1);
  \draw[current plane,dashed,line width=.6mm] (180-\angVis:1) arc (180-\angVis:\angVis:1);
}
\newcommand\DrawLatitudeCircle[2][1]{
  \LatitudePlane{\angEl}{#2}
  \tikzset{current plane/.prefix style={scale=#1}}
  \pgfmathsetmacro\sinVis{sin(#2)/cos(#2)*sin(\angEl)/cos(\angEl)}
  % angle of "visibility"
  \pgfmathsetmacro\angVis{asin(min(1,max(\sinVis,-1)))}
  \draw[current plane] (\angVis:1) arc (\angVis:-\angVis-180:1);
  \draw[current plane,dashed] (180-\angVis:1) arc (180-\angVis:\angVis:1);
}
\newcommand\coil[1]{
  {\rh * cos(\t * pi r)}, {\apart * (2 * #1 + \t) + \rv * sin(\t * pi r)}
}
\makeatletter
\define@key{DrawFromCenter}{style}[{->}]{
  \tikzset{DrawFromCenterPlane/.style={#1}}
}
\define@key{DrawFromCenter}{r}[1]{
  \def\@R{#1}
}
\define@key{DrawFromCenter}{center}[(0, 0)]{
  \def\@Center{#1}
}
\define@key{DrawFromCenter}{theta}[0]{
  \def\@Theta{#1}
}
\define@key{DrawFromCenter}{phi}[0]{
  \def\@Phi{#1}
}
\presetkeys{DrawFromCenter}{style, r, center, theta, phi}{}
\newcommand*\DrawFromCenter[1][]{
  \setkeys{DrawFromCenter}{#1}{
    \pgfmathsinandcos\sint\cost{\@Theta}
    \pgfmathsinandcos\sinp\cosp{\@Phi}
    \pgfmathsinandcos\sinA\cosA{\angEl}
    \pgfmathsetmacro\DX{\@R*\cost*\cosp}
    \pgfmathsetmacro\DY{\@R*(\cost*\sinp*\sinA+\sint*\cosA)}
    \draw[DrawFromCenterPlane] \@Center -- ++(\DX, \DY);
  }
}
\newcommand*\DrawFromCenterText[2][]{
  \setkeys{DrawFromCenter}{#1}{
    \pgfmathsinandcos\sint\cost{\@Theta}
    \pgfmathsinandcos\sinp\cosp{\@Phi}
    \pgfmathsinandcos\sinA\cosA{\angEl}
    \pgfmathsetmacro\DX{\@R*\cost*\cosp}
    \pgfmathsetmacro\DY{\@R*(\cost*\sinp*\sinA+\sint*\cosA)}
    \draw[DrawFromCenterPlane] \@Center -- ++(\DX, \DY) node {#2};
  }
}
\makeatother
\tikzstyle{snakearrow} = [decorate, decoration={pre length=0.2cm,
  post length=0.2cm, snake, amplitude=.4mm,
  segment length=2mm},thick, ->]
%% document-wide tikz options and styles
\tikzset{%
  >=latex, % option for nice arrows
  inner sep=0pt,%
  outer sep=2pt,%
  mark coordinate/.style={inner sep=0pt,outer sep=0pt,minimum size=3pt,
    fill=black,circle}%
}
\addtolength{\hoffset}{-1.3cm}
\addtolength{\voffset}{-2cm}
\addtolength{\textwidth}{3cm}
\addtolength{\textheight}{2.5cm}
\renewcommand{\footskip}{10pt}
\setlength{\headwidth}{\textwidth}
\setlength{\headsep}{20pt}
\setlength{\marginparwidth}{0pt}
\parindent=0pt
\title{Wigner function for thermal state of quantum harmonic oscillator}
\begin{document}

\section{Derivation}
TODO

\eqar{
  W(x,p)=&\frac{\tanh(f)}{\pi\hbar}
  \exp\paren{-\tanh(f)\paren{\frac{m\omega x^2}{\hbar} + \frac{p^2}{m\omega\hbar}}}
}
where $f\equiv\dfrac{1}{2}\beta\hbar\omega$
\section{Properties}
\subsection{$x$ distribution}
\eqar{
  p(x)=&\int\ud p W\\
  =&\frac{\tanh(f)}{\pi\hbar}\int\ud p
  \exp\paren{-\tanh(f)\paren{\frac{m\omega x^2}{\hbar} + \frac{p^2}{m\omega\hbar}}}\\
  =&\sqrt{\frac{m\omega\tanh(f)}{\pi\hbar}}\exp\paren{-\tanh(f)\frac{m\omega x^2}{\hbar}}
}
In high temperature limit, this becomes
\eqar{
  p(x)\approx&\sqrt{\frac{m\omega f}{\pi\hbar}}\exp\paren{-f\frac{m\omega x^2}{\hbar}}\\
  =&\sqrt{\frac{m\omega^2\beta}{2\pi}}\exp\paren{-\beta\frac{m\omega^2x^2}{2}}
}
which is the classical Maxwell-Boltzmann distribution.

\subsection{$p$ distribution}
\eqar{
  p(p)=&\int\ud x W\\
  =&\frac{\tanh(f)}{\pi\hbar}\int\ud x
  \exp\paren{-\tanh(f)\paren{\frac{m\omega x^2}{\hbar} + \frac{p^2}{m\omega\hbar}}}\\
  =&\sqrt{\frac{\tanh(f)}{\pi m\omega\hbar}}\exp\paren{-\tanh(f)\frac{p^2}{m\omega\hbar}}\\
}
Similar to the $x$ case, in high temperature limit, this becomes
\eqar{
  p(p)\approx&\sqrt{\frac{f}{\pi m\omega\hbar}}\exp\paren{-f\frac{p^2}{m\omega\hbar}}\\
  =&\sqrt{\frac{\beta}{2\pi m}}\exp\paren{-\beta\frac{p^2}{2m}}\\
}
which is also the classical Maxwell-Boltzmann distribution.

\end{document}
