nacs-lab/yyc-data/presentations/damop-2016/present.tex

\documentclass{beamer}
\mode<presentation>{
  \usetheme{Boadilla}
  \usefonttheme[onlylarge]{structurebold}
  \usefonttheme[stillsansseriflarge]{serif}
  \setbeamerfont*{frametitle}{size=\normalsize,series=\bfseries}
  % \setbeamertemplate{navigation symbols}{}
  \setbeamercovered{transparent}
}
\usepackage[english]{babel}
\usepackage[latin1]{inputenc}
\usepackage{times}
\usepackage[T1]{fontenc}
\usepackage{amsmath}
\usepackage{amssymb}
\usepackage{esint}
\usepackage{hyperref}
\usepackage{tikz}
\usepackage{xkeyval}
\usepackage{xargs}
\usepackage{verbatim}
\usepackage{listings}
\usepackage{multimedia}
\usepackage{pgfplots}
\usepgfplotslibrary{colormaps}
\usetikzlibrary{
  arrows,
  calc,
  decorations.pathmorphing,
  decorations.pathreplacing,
  decorations.markings,
  fadings,
  positioning,
  shapes
}

\pgfdeclareradialshading{glow}{\pgfpoint{0cm}{0cm}}{
  color(0mm)=(white);
  color(3mm)=(white);
  color(7mm)=(black);
  color(10mm)=(black)
}
\pgfdeclareverticalshading{beam}{2cm}{
  % manual 1082-1083; later - shading is assumed to be 100bp diameter ??
  color(0cm)=(black);
  color(0.3cm)=(black);
  color(1cm)=(white);
  color(1.7cm)=(black);
  color(2cm)=(black)
}

\begin{tikzfadingfrompicture}[name=glow fading]
  \shade [shading=glow] (0,0) circle (1);
\end{tikzfadingfrompicture}

\begin{tikzfadingfrompicture}[name=beam fading]
  \shade [shading=beam] (-1,-1) rectangle (1, 1);
\end{tikzfadingfrompicture}

% not mandatory, but I though it was better to set it blank
\setbeamertemplate{headline}{}
\def\beamer@entrycode{\vspace{-\headheight}}

\tikzstyle{snakearrow} = [decorate, decoration={pre length=0.2cm,
  post length=0.2cm, snake, amplitude=.4mm,
  segment length=2mm},thick, ->]

%% document-wide tikz options and styles

\tikzset{%
  % >=latex, % option for nice arrows
  inner sep=0pt,%
  outer sep=2pt,%
  mark coordinate/.style={inner sep=0pt,outer sep=0pt,minimum size=3pt,
    fill=black,circle}%
}
\tikzset{
  % Define standard arrow tip
  >=stealth',
  % Define style for boxes
  punkt/.style={
    rectangle,
    rounded corners,
    draw=black, very thick,
    text width=8em,
    minimum height=2.5em,
    text centered},
}
\makeatletter
\newbox\@backgroundblock
\newenvironment{backgroundblock}[2]{%
  \global\setbox\@backgroundblock=\vbox\bgroup%
  \unvbox\@backgroundblock%
  \vbox to0pt\bgroup\vskip#2\hbox to0pt\bgroup\hskip#1\relax%
}{\egroup\egroup\egroup}
\addtobeamertemplate{background}{\box\@backgroundblock}{}
\makeatother

\def\theauthor{Yichao Yu}
\def\theinstitute{Ni Group/Harvard}
\def\thedate{May 26, 2016}
\title[Trapping and imaging of single Na atoms]{Trapping and imaging of single atoms in the presence of light shift}
\author{\theauthor}
\institute{\theinstitute}
\date{\thedate}

\begin{document}

% As mentioned in the previous talk, the goal of the experiment is to
% make dipolar molecules using trapped single atoms.

% Talk about some techniques we use in one of the important step:
% (discovered and solved problems)
% -    Trap single atom with tweezer out of laser cooled gas.
% How hard can this be =p

% 1min
\begin{frame}[t]{}
  \begin{center}
    \usebeamerfont{title}{\usebeamercolor[fg]{title}{\inserttitle\par}}
  \end{center}
  \begin{columns}[t]
    \column{8cm}
    {}
    % Somehow the author and date etc moves to the bottom of the
    % page if this is removed.....
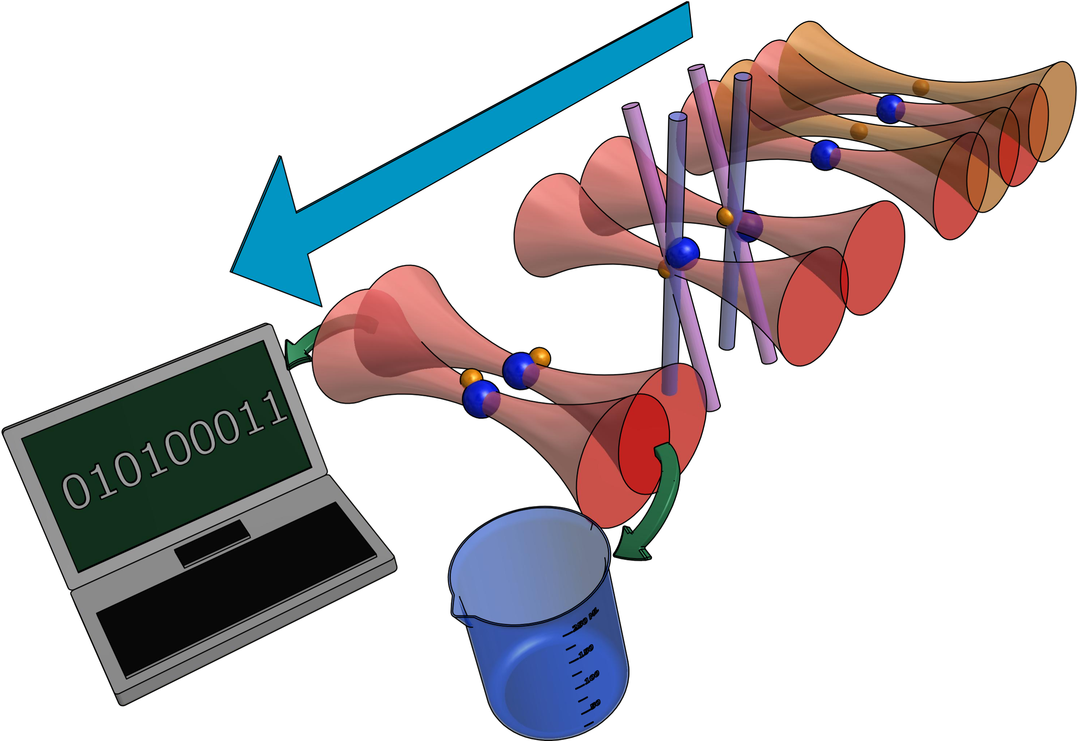
[picture p96: presentations/damop-2016/overall_full_min.png]
    
    \column{4cm}
    \vspace{-1cm}
    \begin{center}
      \usebeamercolor[fg]{title}{
        {\large{\theauthor}}\\
        {\small{\thedate}}\\
        {\small{\theinstitute}}}
    \end{center}
    \textbf{Group members}\\
    Nicholas Hutzler\\
    Lee Liu\\
    Jessie Zhang\\
    \textbf{PI}\\
    Kang-Kuen Ni\\\vspace{0.3cm}
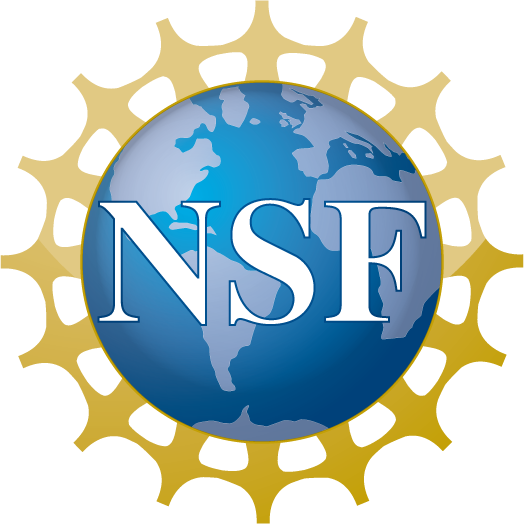
[picture p97: presentations/damop-2016/nsf-logo.png]
    
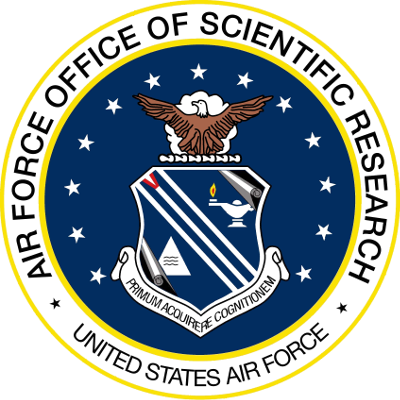
[picture p98: presentations/damop-2016/afosr-logo-min.png]
    
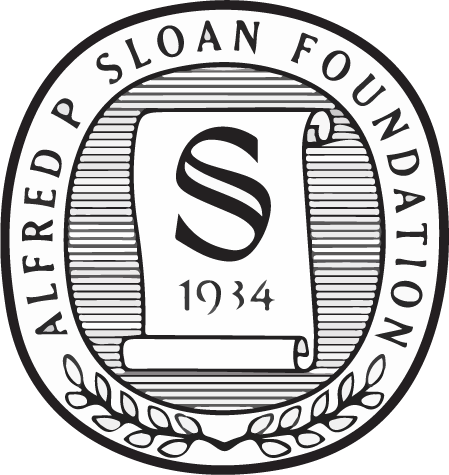
[picture p99: presentations/damop-2016/sloan.png]
    \\
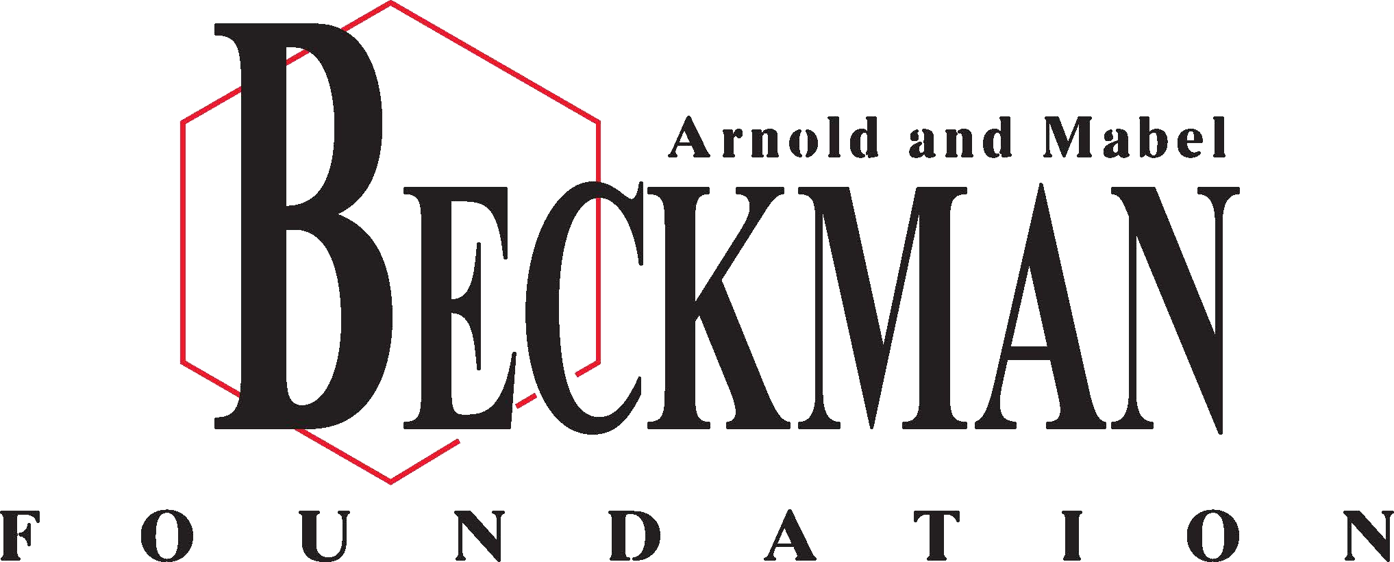
[picture p100: presentations/damop-2016/beckman-logo.png]
    
  \end{columns}
\end{frame}

% - Load MOT
% - Trap with tweezer
% - Image

% 2.5min
\begin{frame}
  \begin{columns}[t]
    \column{5cm}
    \begin{block}{Procedure}
      \begin{itemize}
      \item<1-> MOT Loading
      \item<2-> Trapping
      \item<3-> Imaging
      \item<4-> Works for Cs
      \item<5-> Doesn't work for Na
      \end{itemize}
    \end{block}
    \column{7cm}
    \begin{center}
      \begin{tikzpicture}
        \visible<2-3>{
          \shade[shading=radial,rotate=90,yscale=1,fill opacity=0.6,
          inner color=red]
          plot[draw,samples=200,domain=-3:3] function {sqrt(0.0025 + x**2 / 10)}
          -- plot[draw,samples=200,domain=3:-3] function {-sqrt(0.0025 + x**2 / 10)};
          \path (0, 3) node[below] {Tweezer};
        }
        \visible<1-2>{
          \fill[orange,opacity=0.8,path fading=glow fading] (0,0) circle (1.5);
        }
        \visible<3>{
          \path (2, 0) node[align=center] {Imaging\\beams};
          \fill[orange,opacity=0.7,path fading=beam fading,transform canvas={rotate=25}]
          (-2, -0.2) rectangle (2, 0.2);
          \fill[orange,opacity=0.7,path fading=beam fading,transform canvas={rotate=-25}]
          (-2, -0.2) rectangle (2, 0.2);
        }
        \visible<2-3>{
          \fill [blue,path fading=glow fading] (0,0) circle (0.08);
        }
        \visible<4> {
          \path (0, -0.5) node
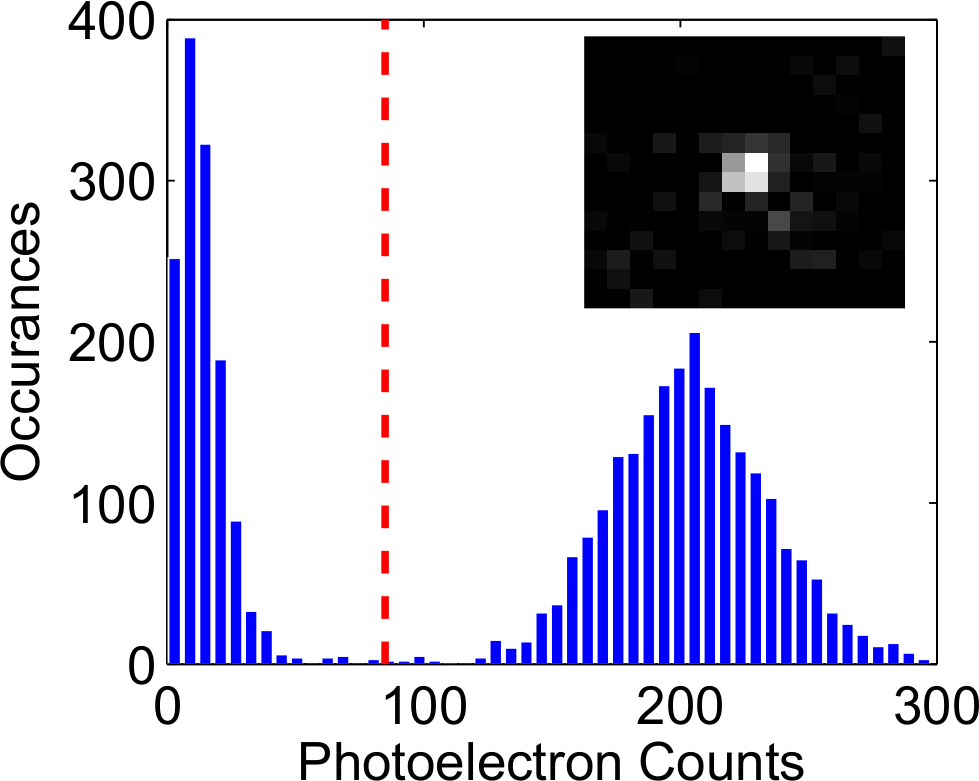
[picture p101: presentations/damop-2016/cs-histogram.png]
          {};
        }
        \visible<5> {
          \path (0, -0.5) node
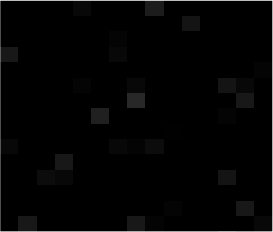
[picture p102: presentations/damop-2016/na-noatom.png]
          {};
        }
      \end{tikzpicture}
    \end{center}
  \end{columns}
\end{frame}

% Doesn't work for Na
% We believe the issue is the difference between ground and excited state
% AC Stark shift.

% \beta parameter, due to multiple levels. 1 = magic

% Problems caused by this:
% 1. Loading
% -    Inefficient cooling
% -    Possibly reduced trap depth
% 2. Imaging
% -    + Off resonance

% 5min
\begin{frame}
  \begin{columns}
    \column{5cm}
    \begin{block}{Light shift}
      \begin{itemize}
      \item<4-> Inefficient cooling;\\
        Heating
      \item<4-> Shift imaging light out of resonance
      \end{itemize}
    \end{block}
    \visible<3-> {
      \begin{center}
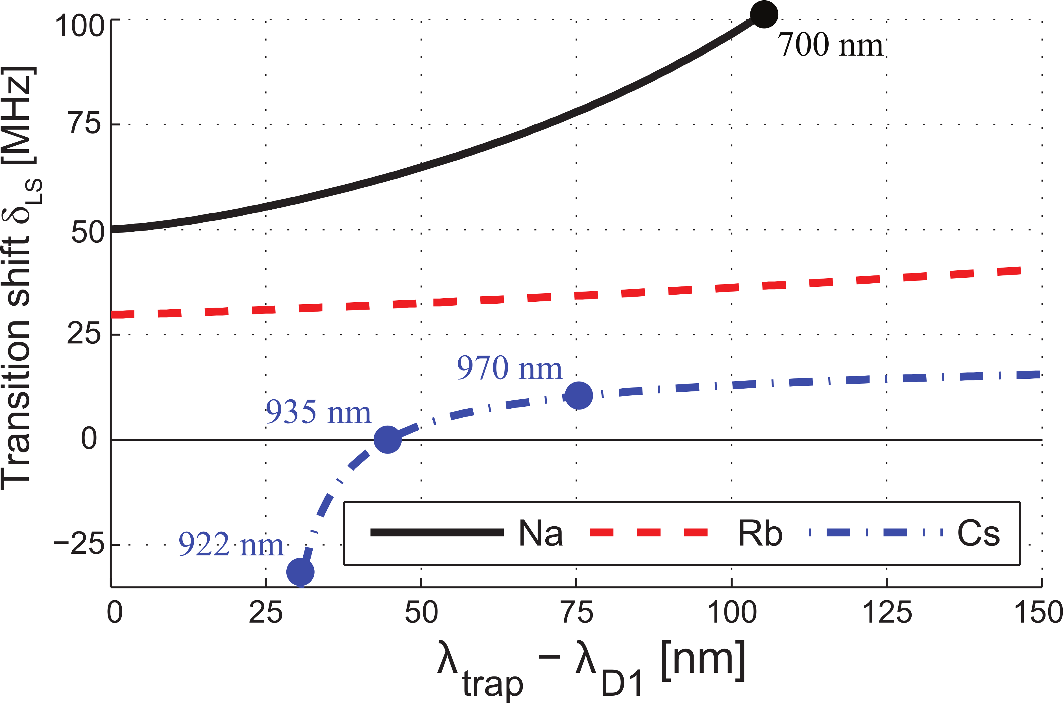
[picture p103: presentations/damop-2016/light-shift.png]
        
      \end{center}
    }
    \column{7cm}
    \begin{center}
      \begin{tikzpicture}
        \visible<1-7> {
          % Excited state
          \visible<2->{
            \draw[dashed,line width=1] (-2, 3) -- (2, 3);
          }
          \visible<5-> {
            \draw[orange,->,line width=2] (2, -1) -- (2, 2.85);
            \draw[orange,dashed,->,line width=2]
            (0.5, -1.8225775623986646) -- (0.5, 2.85 - 0.8225775623986646);
          }

          \visible<2-5> {
            % \beta = 0.8
            \draw[violet,line width=1]
            plot[samples=200,domain=-2:2]
            function {3-0.8 * exp(-x**2 / 2 / (0.8**2))};
          }

          \visible<6> {
            % \beta = 2.3
            \draw[blue,line width=1]
            plot[samples=200,domain=-2:2]
            function {3-2.3 * exp(-x**2 / 2 / (0.8**2))};
          }

          \visible<7> {
            % \beta = -1
            \draw[red,line width=1]
            plot[samples=200,domain=-2:2]
            function {3+exp(-x**2 / 2 / (0.8**2))};
          }

          % Ground state
          \draw[dashed,line width=1] (-2, -1) -- (2, -1);
          \draw[black,line width=1]
          plot[samples=200,domain=-2:2]
          function {-1-exp(-x**2 / 2 / (0.8**2))};
        }
        \visible<8> {
          \path (0.5, 3) node[above] {
            \begin{tabular}{|c|c|c|c|}
              \multicolumn{4}{c}{Cs single atom loading}\\
              \hline
              $\lambda_{trap} (nm)$&922&935&970\\\hline
              Loading (\%)&$0$&$\approx50$&$\approx50$\\\hline
            \end{tabular}
          };
          \path (0.5, 2.5) node[below,align=center] {Cs single atom imaging\\
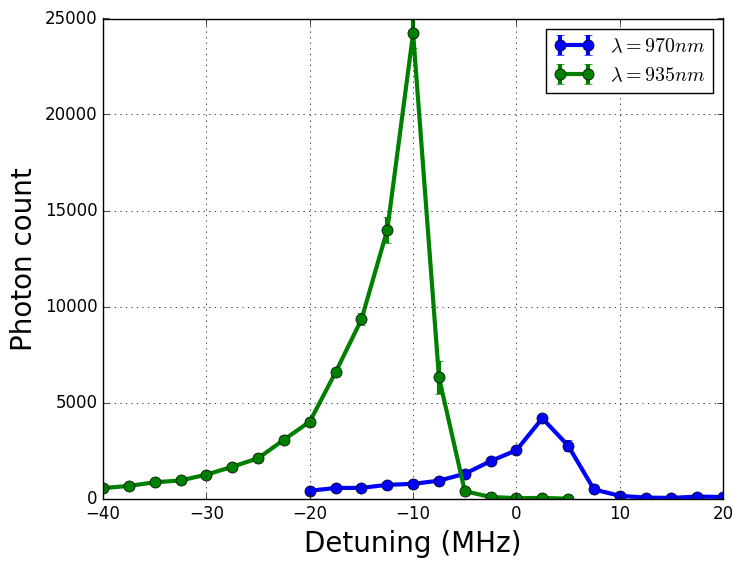
[picture p104: presentations/damop-2016/det-vs-photon-dc.png]
            };
        }
      \end{tikzpicture}
    \end{center}
  \end{columns}
\end{frame}

% Solution:
% * Switching
% * Fast enough (comparing to trap frequency)
% * Slow enough (comparing to excited stated lifetime)

\begin{frame}
  \begin{columns}
    \column{5cm}
    \begin{block}{Trap modulation}
      Alternate between trap and resonant {\small (cooling and imaging)} light
      at $1\sim3$\ MHz\\
      {\small $f_{trap}=10\sim400$\ kHz}\\
      {\small $\Gamma=2\pi\times(5\sim10)$\ MHz}
    \end{block}
    \vspace{0.5cm}
    \begin{tikzpicture}
      \visible<1-5> {
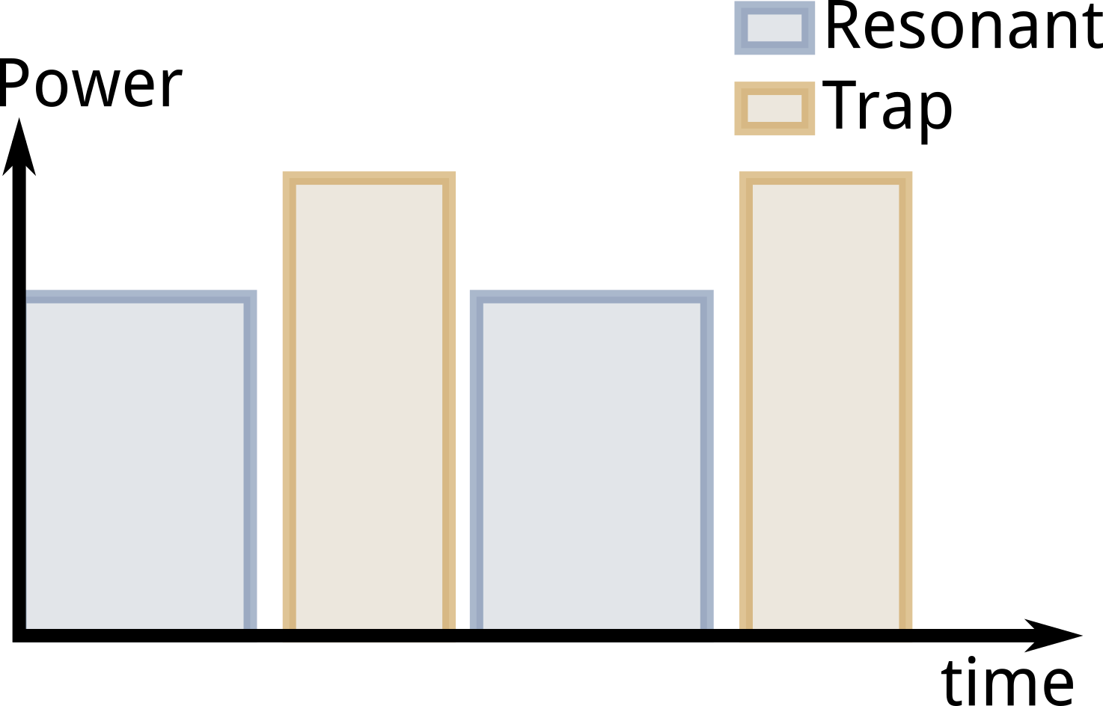
[picture p105: presentations/damop-2016/switching.png]
        \path (0, 0) node {};
      }
      \visible<6-> {
        \path (0, 0) node
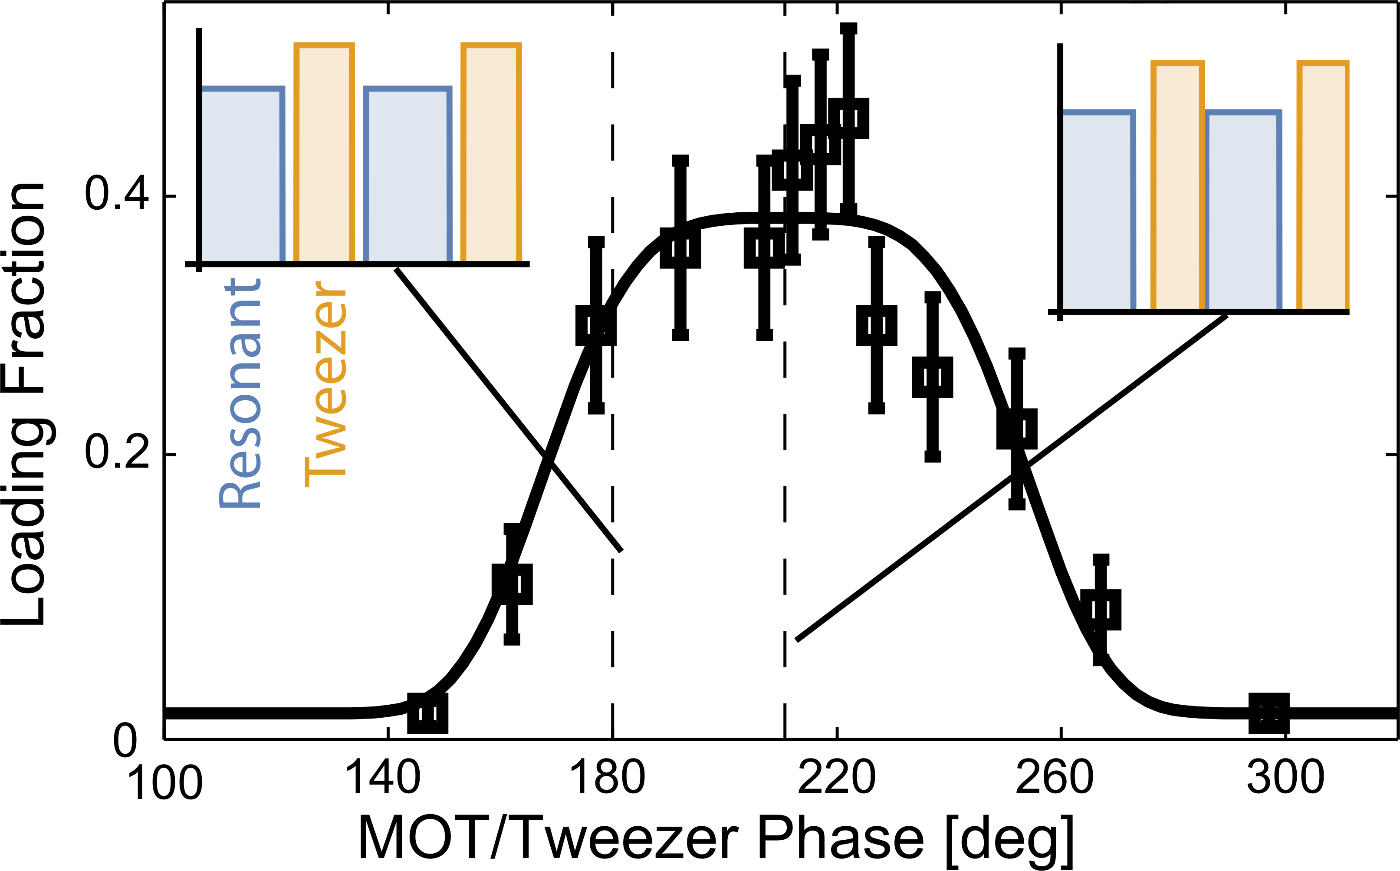
[picture p106: presentations/damop-2016/trap-phase.png]
        {};
      }
    \end{tikzpicture}
    \column{7cm}
    \begin{center}
      \begin{tikzpicture}
        \visible<2-4> {
          \path (0, 0) node[above,align=center]
          {
            \begin{tabular}{|c|c|c|c|}
              \multicolumn{4}{c}{Cs single atom loading}\\
              \hline
              $\lambda_{trap} (nm)$&922&935&970\\\hline
              Loading (\%)&{\color{red}$\approx50$}&$\approx50$&$\approx50$\\\hline
            \end{tabular}
          };
        }
        \visible<3> {
          \path (0, -0.5) node[below,align=center]
          {Cs single atom imaging\\
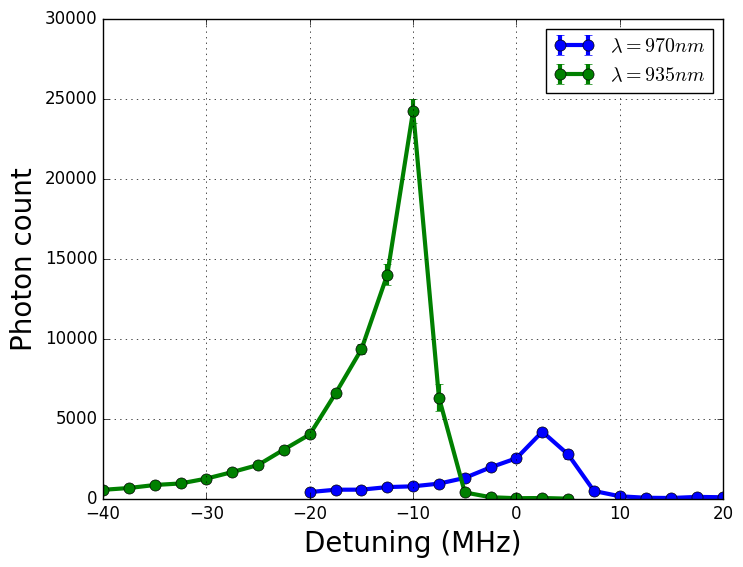
[picture p107: presentations/damop-2016/det-vs-photon-dc2.png]
            };
        }
        \visible<4> {
          \path (0, -0.5) node[below,align=center]
          {Cs single atom imaging\\
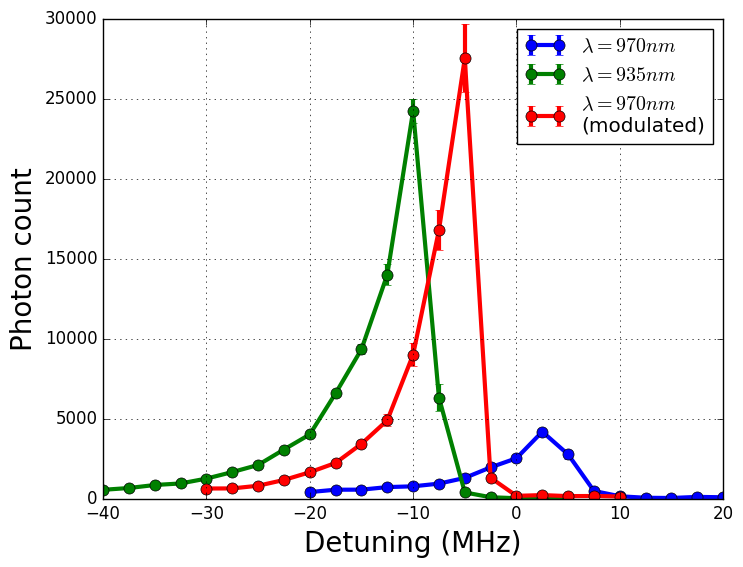
[picture p108: presentations/damop-2016/det-vs-photon-ac.png]
            };
        }
        \visible<5-> {
          \path (0, -4) node[above]
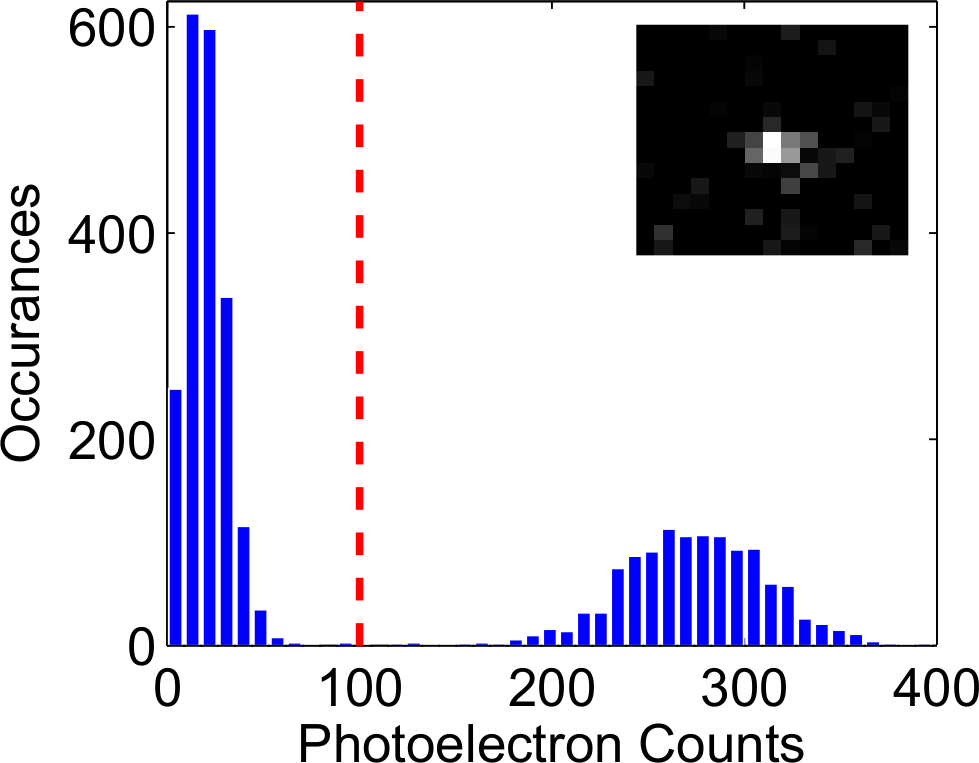
[picture p109: presentations/damop-2016/na-histogram.png]
          {};
          \path (0, -4.5) node[below,align=center]
          {\Large Na Single Atom Loaded!!};
        }
      \end{tikzpicture}
    \end{center}
  \end{columns}
\end{frame}

\begin{frame}[t]{Conclusion}
  \begin{itemize}
  \item Measured the effect of light shift on loading and imaging of single atom
  \item Overcome the light shift by alternating trapping and resonant light to achieve loading of single Na atom.
  \item Generalizable to other species
  \end{itemize}
  \begin{center}
    
  \end{center}
\end{frame}

\begin{frame}
\end{frame}

\end{document}
