nacs-lab/yyc-data/calculations/sideband/imgs/paper_no_scatter/hf.png

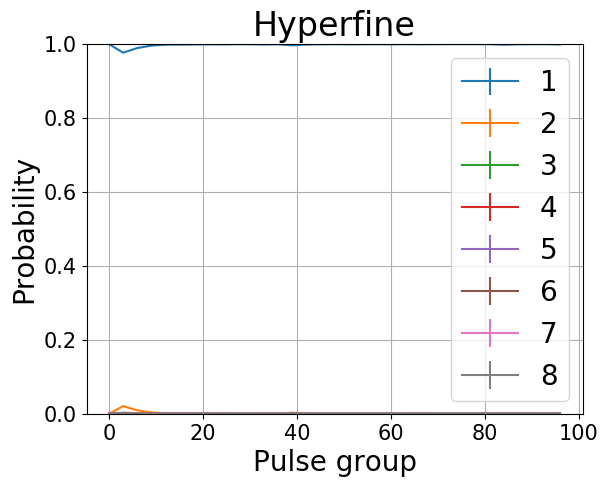
calculations/sideband/imgs/paper_no_scatter/hf.png
