nacs-lab/yyc-data/experiments/misc/imgs/data_spectrum_20170409_r2.png

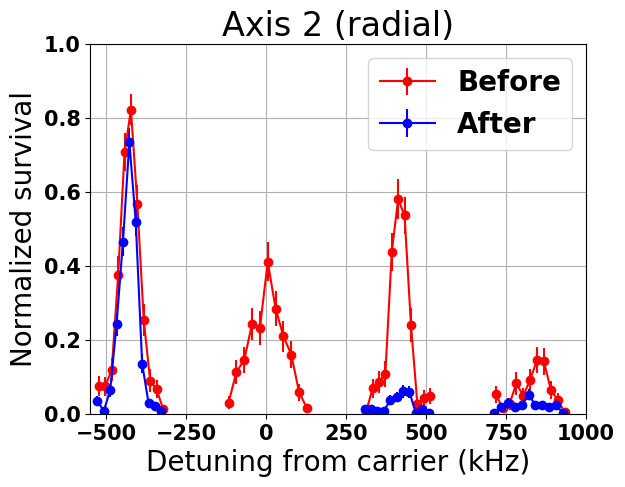
experiments/misc/imgs/data_spectrum_20170409_r2.png
