nacs-lab/yyc-data/experiments/na_rsc_201801/imgs/data_20180110_spectra_r_hot_y.png

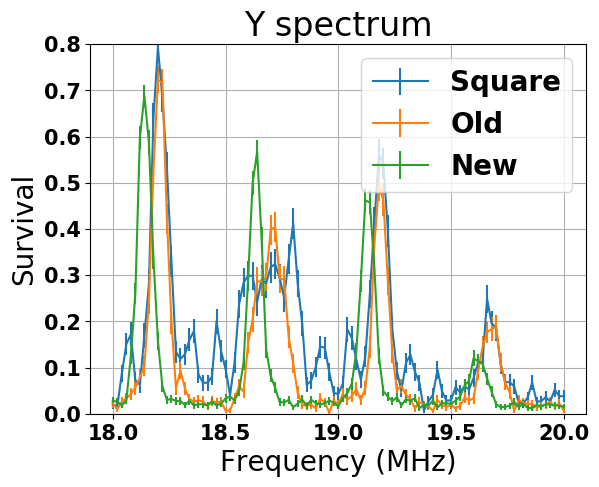
experiments/na_rsc_201801/imgs/data_20180110_spectra_r_hot_y.png
