nacs-lab/yyc-data/experiments/na_rsc_201801/imgs/data_20180111_164819_spectrum_r_hot_x.png

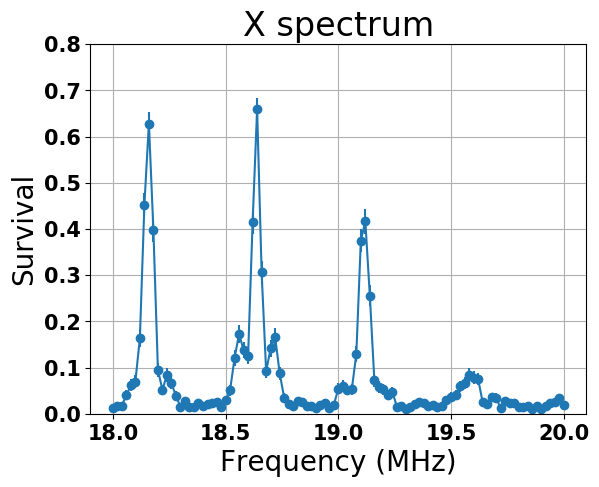
experiments/na_rsc_201801/imgs/data_20180111_164819_spectrum_r_hot_x.png
