nacs-lab/yyc-data/experiments/na_rsc_201801/imgs/data_20180112_153738_spectrum_r_cold_z.png

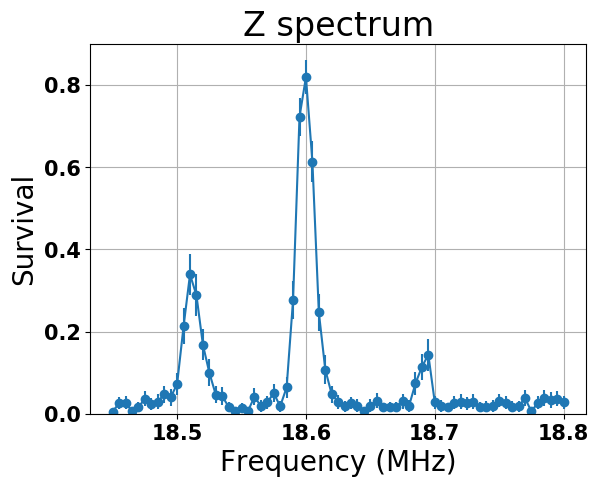
experiments/na_rsc_201801/imgs/data_20180112_153738_spectrum_r_cold_z.png
