nacs-lab/yyc-data/experiments/na_rsc_201801/imgs/data_20180113_201830_spectrum_cold_z.png

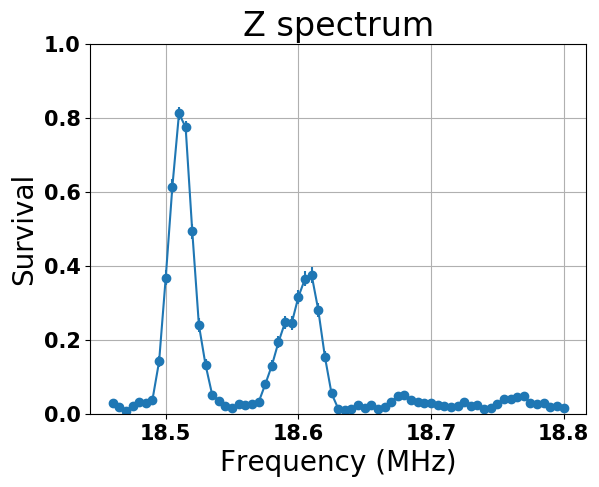
experiments/na_rsc_201801/imgs/data_20180113_201830_spectrum_cold_z.png
