nacs-lab/yyc-data/experiments/na_rsc_201801/imgs/data_20180119_152114_spectrum_cold_merge_z.png

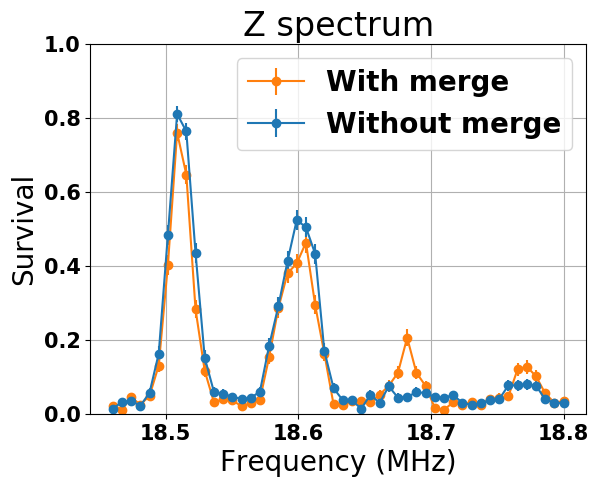
experiments/na_rsc_201801/imgs/data_20180119_152114_spectrum_cold_merge_z.png
