nacs-lab/yyc-data/experiments/na_rsc_201801/imgs/data_20180121_145134_spectrum_cold_x0.png

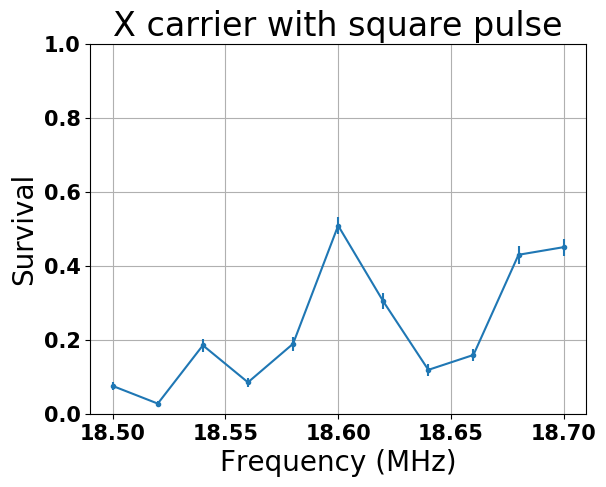
experiments/na_rsc_201801/imgs/data_20180121_145134_spectrum_cold_x0.png
