nacs-lab/yyc-data/experiments/nacs_rsc_2018/imgs/data_20180314_133532_spectrum_cold_cs_x.png

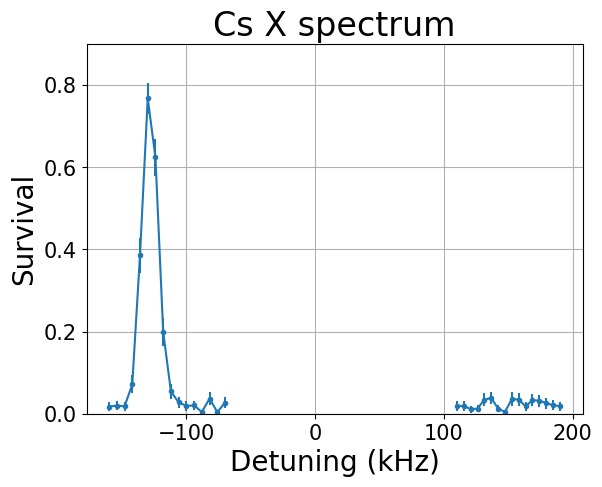
experiments/nacs_rsc_2018/imgs/data_20180314_133532_spectrum_cold_cs_x.png
