nacs-lab/yyc-data/presentations/2020-defense/figures/interaction_shift_spectrum_32_31.png

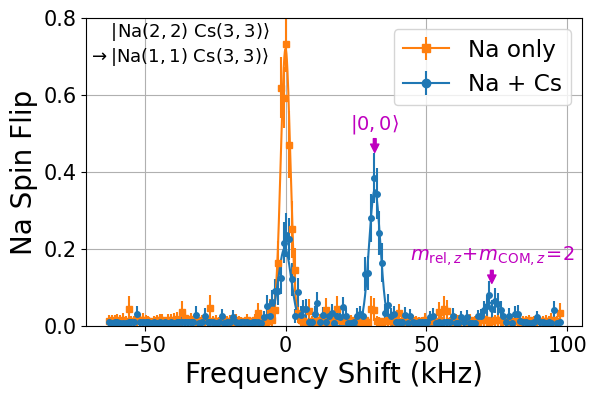
presentations/2020-defense/figures/interaction_shift_spectrum_32_31.png
