nacs-lab/yyc-data/presentations/2020-defense/figures/interaction_shift_spectrum_42_32_cs.png

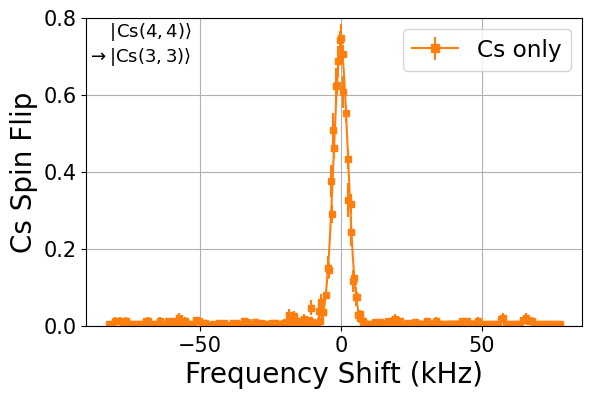
presentations/2020-defense/figures/interaction_shift_spectrum_42_32_cs.png
