nacs-lab/yyc-data/presentations/2020-defense/figures/raman_transfer_spectrum.png

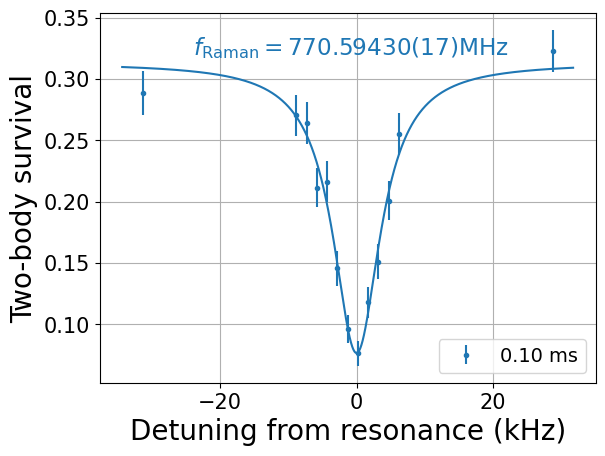
presentations/2020-defense/figures/raman_transfer_spectrum.png
