nacs-lab/yyc-data/presentations/2020-defense/figures/raman_transfer_spectrum_text.png

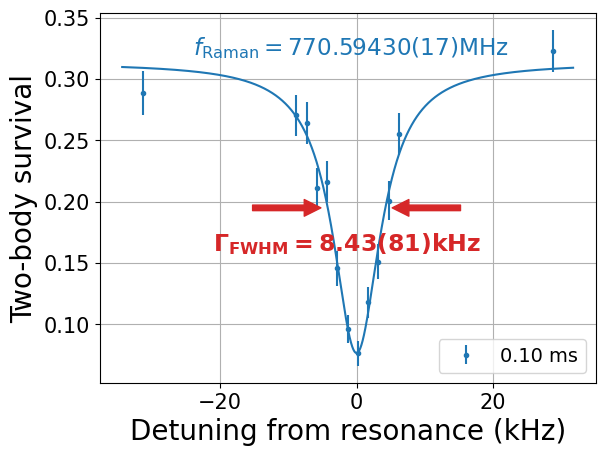
presentations/2020-defense/figures/raman_transfer_spectrum_text.png
