nacs-lab/yyc-data/presentations/qual/imgs/spectrum_a1.png

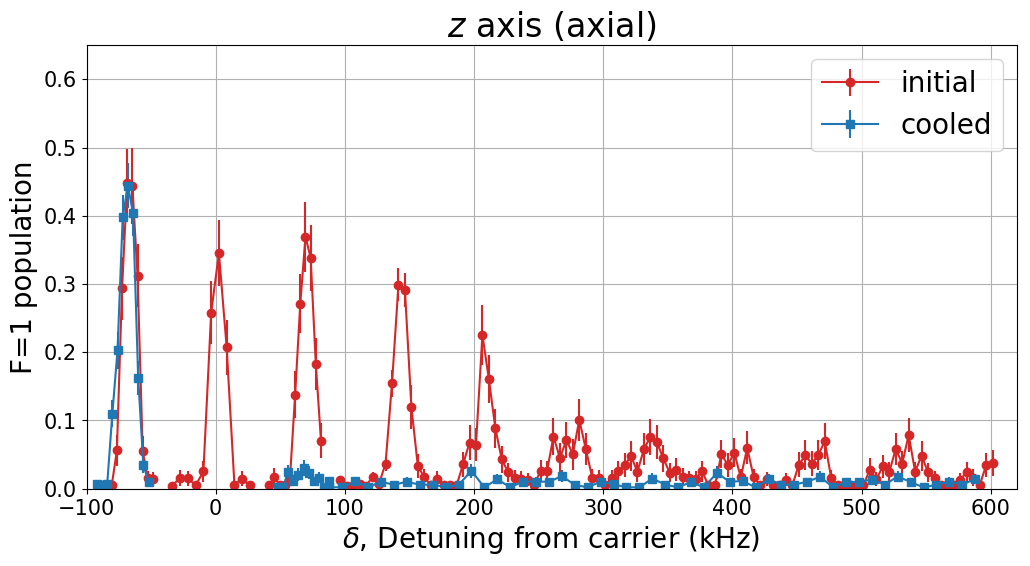
presentations/qual/imgs/spectrum_a1.png
