nacs-lab/yyc-data/presentations/qual/imgs/spectrum_r2_init.png

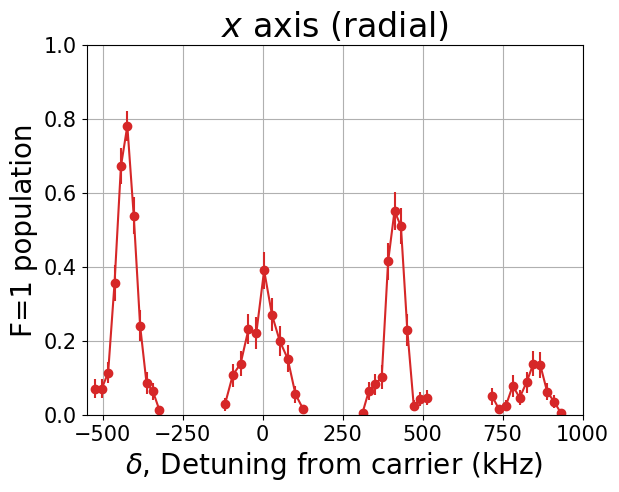
presentations/qual/imgs/spectrum_r2_init.png
