nacs-lab/yyc-data/orders/DigiKey_2017-08-14.md

|DigiKey PartNumber|Minimum Quantity|Actual Quantity|Comment |
|---|---|---|---|
|290-1009-ND |20 |20 |1' BNC cable |
|290-1010-ND |20 |20 |2' BNC cable |
|290-1011-ND |20 |20 |3' BNC cable |
|290-1013-ND |20 |20 |5' BNC cable |
|290-1015-ND |10 |10 |10' BNC cable |
|J10098-ND |20 |25 |BNC F-SMA M |
|501-1341-ND |10 |10 |BNC M-SMA M |
|J10097-ND |20 |25 |BNC F-SMA F |
|ADP-SMAF-BNCM-ND  |9 |9 |BNC M-SMA F |
|367-1015-ND |20 |25 |BNC F-F |
|501-1127-ND |15 |15 |BNC M-Banana M |
|1427-1067-ND |5 |5 |BNC F M-F-F |
|931-1102-ND |5 |5 |MCX-SMA F |
