nacs-lab/yyc-data/orders/Thorlabs_2017-05-02.md

| PartNumber| Quantity|Comment |
|---|---|---|
| SM1Z| 5| Z-Axis Translation Cage Mount|
| CRM1| 5| Cage Rotation Mount|
| CP1TM06| 4| Cage Plate with M6 x 0.5 Internal Threads|
| CP1TM08| 2| Cage Plate with M8 x 0.5 Internal Threads|
| CP1TM12| 5| Cage Plate with M12 x 0.5 Internal Threads|
| SM1FCA| 5| FC/APC Fiber Adapter Plate|
| BE1-P5| 2| 1.25" Studded Pedestal Base Adapter, 1/4"-20 Thread, 5 Pack|
| CF125-P5| 1| Clamping Fork, 5 Pack|
| RS1.5P8E| 5| 1" Pedestal Pillar Post, L = 1.5"|
| RA90-P5| 1| Right-Angle Clamp for 1/2" Posts, 5 Pack|
| RA180-P5| 1| Right-Angle Post Clamp for 1/2" Posts, 5 Pack|
| FP90| 1| Adjustable Flip Platform|
| FM90| 1| Flip Mount Adapter|
