nacs-lab/yyc-data/orders/DigiKey_2017-03-28.md

|DigiKey PartNumber|Minimum Quantity|Actual Quantity|Comment |
|---|---|---|---|
|290-1009-ND |15 |15 |1' BNC cable |
|290-1010-ND |15 |15 |2' BNC cable |
|290-1011-ND |10 |10 |3' BNC cable |
|290-1013-ND |10 |10 |5' BNC cable |
|290-1015-ND |10 |10 |10' BNC cable |
|367-1015-ND |20 |20 |BNC F-F |
|314-1167-ND |20 |20 |BNC M-M |
|314-1127-ND |20 |20 |BNC F-Banana M |
|1427-1067-ND |5 |5 |BNC F M-F-F |
|1427-1066-ND |5 |5 |BNC Y F-M-F |
|J10098-ND |20 |20 |BNC F-SMA M |
|501-1341-ND |10 |10 |BNC M-SMA M |
|179-2342-ND |2 |2 |24V 7.2A power supply |
|1N5380BGOS-ND |10 |10 |(For KRb) |
|1N5378BRLGOSCT-ND |10 |10 |(For KRb) |
|1N5388BGOS-ND |10 |10 |(For KRb) |
|A24669-ND |5 |5 |SHV connectors (For KRb)  |
