nacs-lab/yyc-data/orders/DigiKey_2016-10-06.md

|DigiKey PartNumber|Minimum Quantity|Actual Quantity|Comment |
|---|---|---|---|
| 732-8663-1-ND| 2| 4| 50V 33uF cap|
| 399-6102-ND| 2| 10| 25V 100uF cap|
| 493-12888-1-ND| 6| 10| 10V 220uF cap|
| 1276-1838-1-ND| 1| 10| 1206 100V 1uF cap|
| 1276-1075-1-ND| 8| 25| 1206 25V 10uF cap|
| 296-32710-ND| 0| 5| 48V to +-12V|
| 277-1192-ND| 30| 30| 3-pos plug|
| 277-1222-ND| 30| 30| 3-pos header|
| 277-1191-ND| 20| 20| 2-pos plug|
| 277-1221-ND| 20| 20| 2-pos header|
| C76502B-50-ND| 1| 1| 50' 18 AWG wire black|
| C76502W-50-ND| 1| 1| 50' 18 AWG wire white|
| C76502O-50-ND| 1| 1| 50' 18 AWG wire orange|
| C76502Y-50-ND| 1| 1| 50' 18 AWG wire yellow|
| C76502G-50-ND| 1| 1| 50' 18 AWG wire green|
| C76502N-50-ND| 1| 1| 50' 18 AWG wire brown|
| C76502S-50-ND| 1| 1| 50' 18 AWG wire gray|
| C76502V-50-ND| 1| 1| 50' 18 AWG wire violet|
| WM6159-ND| 12| 12| SMA-F to MMCX-M|
| 626-1352-ND| 3| 3| USB feed through|
| J10117-ND| 30| 50| 5' SMA-M to BNC-M cable|
| ACX1589-ND| 30| 30|1' SMA to SMA right angle cable|
| WM9472-ND| 5| 10| BNC-M cap|
| 314-1170-ND| 10| 10| BNC-M to Banana-F|
| 314-1127-ND| 10| 10| BNC-F to Banana-M|
| J10096-ND| 20| 25| BNC T F-F-F|
| 290-1013-ND| 20| 20| 5' BNC cable|
| 290-1015-ND| 10| 10| 10' BNC cable|
