nacs-lab/yyc-data/orders/MiniCircuits_2016-10-06.md

| PartNumber|Minimum Quantity|Actual Quantity|Comment |
|---|---|---|---|
| ZB8PD-4-S+| 3| 3| x8 power splitter (SMA)|
| ZA3PD-4-S+| 1| 1| x3 power splitter (SMA)|
|  ZX60-V82-S+| 1| 1| Clock amplifier (SMA)|
