nacs-lab/yyc-data/orders/LCom_2016-10-06.md

| PartNumber|Minimum Quantity|Actual Quantity|Comment |
|---|---|---|---|
| PR35B32CMB| 1| 1| Output panel|
| AXA-SMBPSF| 44| 50|  SMB-F to SMA-F connector|
