nacs-lab/yyc-data/orders/Foctek_2015-09-30.md

* Quarter waveplate: 950-1300nm, Clear aperture dia 12.7mm, `AWP212Q-950~1300`:

    (x2) $265/pc (in stock)

* Half waveplate: 950-1300nm, Clear aperture dia 12.7mm, `AWP212H-950~1300`:

    (x4) $265/pc (1 in stock. 7 weeks ARO for the rest)

* Half waveplate: 1064nm, Clear aperture dia 22.8mm, `WPO225H-1064`:

    (x1) $89/pc (in stock)

* Half waveplate: 1064nm, Clear aperture dia 12.7mm, air space, `WPA212H-1064`

    (x1) $59/pc (in stock)

* Non-PBS cube, 700-1100nm, 20mm^3, `NPB1214-700~1100`

    (x4) $105/pc (in stock)

* Non-PBS cube, 450-680nm, 0.5inch^3, `NPB5204-450~680`

    (x4) $93/pc (in stock)
