nacs-lab/yyc-data/orders/DigiKey_2015-08-19.md

|DigiKey PartNumber|Minimum Quantity|Actual Quantity|Comment |
|---|---|---|---|
|ACX2042-ND |10 |10 |BNC-SMA 6" |
|ACX1721-ND |10 |10 |BNC-SMA 12" |
|J4524-ND |10 |10 |BNC-SMA 2' |
|J4536-ND |10 |10 |BNC-SMA 3' |
|||||
|501-1322-ND |12 |12 |Banana Cable |
|501-1328-ND |12 |12 |Banana Cable |
|||||
|J10096-ND |10 |10 |BNC T F-F-F |
|1427-1066-ND |10 |10 |BNC Y F-M-F |
|J10098-ND |50 |50 |BNC F-SMA M |
|CONSMA010-ND |25 |25 |SMA L |
|||||
|296-37165-ND |1 |1 |LDO Eval |
|296-38633-ND |1 |1 |LDO Eval |
|237-1405-ND |1 |1 |18V Power |
|839-1144-ND |1 |1 |Power cable |
