nacs-lab/yyc-data/orders/Foctek_2015-04-20.md

1. (x15) High extinction (>3000:1) Polarization beam splitters @ 780nm and 767nm, 12.7^3(mm)

    No stocks Price:$99/pc Delivery:4-5weeksARO

2. (x10) Cemented true zeroth order Half Wave Plate @ 780 nm, clear aperture = 12.7 mm, OD = 25.4 mm

    We have enough in stock Price:$69/pc

3. (x10) Cemented true zeroth order Half Wave Plate @ 767 nm, clear aperture = 12.7 mm, OD = 25.4 mm

    We have 7pcs in stock Price:$89/pc

4. (x3) 450nm-680nm Achromatic Waveplate Clear Aperture = 12.7mm, OD = 25.4 HWP AWP212H

    We have enough in stock Price:$265/pc

5. (x2) 450nm-680nm Achromatic Waveplate Clear Aperture = 12.7mm, OD = 25.4 QWP AWP212Q 3001080007

    We have enough in stock Price:$299/pc

6. (x3) 700nm-1000nm Achromatic Waveplate Clear Aperture = 12.7mm, OD = 25.4 HWP AWP212H

    We have enough in stock Price:$287/pc

7. (x2) 700nm-1000nm Achromatic Waveplate Clear Aperture = 12.7mm, OD = 25.4 QWP AWP212Q 3001080017

    We have enough in stock Price:$299/pc

8. (x12) Polarization beam splitters @ 589nm and 852nm. 12.7^3(mm)

    We have enough in stock Price:$59/pc

9. (x2) Broadband High extinction Polarization beam splitters PBS5304 - 900-1200nm

    We have enough in stock Price:$129/pc

10. (x1) Broadband High extinction Polarization beam splitters PBS5304 - 450-650nm

    We have enough in stock Price:$129/pc

11. (x2) Broadband High extinction Polarization beam splitters PBS5304 - 650-850nm

    We have enough in stock Price:$129/pc
