nacs-lab/yyc-data/orders/MiniCircuits_2015-04-23.md

1. (x3) 3.5G 8 channels power splitter

    ZB8PD-4-S+ (SMA)

2. (x1) 3.5G 3 channels power splitter

    ZA3PD-4-S+ (SMA)

3. (x3) 3.5G RF Amp

    ZX60-V82-S+ (SMA)

4. (x2) Low noise Amp for Cs RF

    ZX60-542LN+ (SMA)
