nacs-lab/yyc-data/orders/DigiKey_2014-12-11.md

|DigiKey PartNumber|Minimum Quantity|Actual Quantity|Comment |
|---|---|---|---|
|587-3248-1-ND |16 |50 |C 10u 50V |
|587-2988-1-ND |6 |50 |C 4.7u 50V |
|445-10033-1-ND |12 |100 |C 1u 50V |
|399-8139-1-ND |30 |100 |C 0.1u 200V |
|399-1249-1-ND |36 |250 |C 0.1u 50V |
|445-7694-1-ND |3 |15 |C 0.1u 50V |
|445-7688-1-ND |3 |100 |C 10n 50V |
|445-2332-1-ND |4 |100 |C 3.3n 250V |
|311-1163-1-ND |6 |100 |C 1n 50V |
|399-1205-1-ND |6 |100 |C 100p 50V |
|311-1151-1-ND |21 |100 |C 15p 50V |
|311-1150-1-ND |6 |100 |C 10p 50V |
||||
|311-0.0ERCT-ND |7 |1000 |R 0 |
|Y0856-.10A-ND |8 |10 |R prec 100m 2ppm/C |
|Y1606-.5A-ND |4 |5 |R prec 0.5 0.2ppm/C |
|408-1651-1-ND |4 |5 |R prec 270 2ppm/C |
|PT820AFCT-ND |4 |50 |R 820 |
|311-1.00KFRCT-ND  |18 |100 |R 1k |
|P3.30KFCT-ND |8 |100 |R 3.3k |
|P5.10KFCT-ND |8 |100 |R 5.1k |
|311-5.10KFRCT-ND  |6 |100 |R 5.1k |
|311-10.0KFRCT-ND  |54 |500 |R 10k |
|408-1646-1-ND |4 |5 |R prec 10k 2ppm/C |
|311-10KNFCT-ND |28 |100 |R prec 10k 10ppm/C |
|311-20.0KFRCT-ND  |6 |100 |R 20k |
|311-25.5KFRCT-ND  |3 |100 |R 25.5k |
|P30.0KFCT-ND |4 |100 |R 30k |
|311-30.0KFRCT-ND  |6 |100 |R 30k |
|P49.9KFCT-ND |3 |100 |R 49.9k |
|P100KFCT-ND |4 |100 |R 100k |
|311-1.00MFRCT-ND  |3 |100 |R 1M |
||||
|91A1A-B24-B15L-ND |12 |20 |POT 10k |
|226-4088-ND |12 |20 |Knob |
||||
|360-3075-ND |9 |15 |SW SPDT |
|M2024SS1W40-ND |8 |15 |SW SP3T |
||||
|XG8S-0331-ND |3 |50 |JMP 3P |
|XG8T-0231-ND |15 |100 |JMP 2P |
|609-3573-ND |6 |25 |HDR Female 5x2 |
|609-1774-ND |6 |25 |HDR Male 5x2 |
|WM4200-ND |100 |100 |HDR Male 2 |
|WM4201-ND |100 |100 |HDR Male 3 |
|WM2001-ND |100 |100 |HOUS Female 3 |
||||
|475-1160-1-ND |4 |20 |LED Green 20mA |
|475-1277-1-ND |4 |20 |LED Red 20mA |
|568-1737-1-ND |3 |10 |Diode |
|568-6471-1-ND |6 |25 |Diode Zener 5V |
|568-7084-1-ND |3 |10 |Diode Zener 12V |
||||
|OPA228U-ND |4 |5 |OpAmp prec |
|OPA549T-ND |4 |5 |OpAmp power |
|296-29281-1-ND |4 |5 |OpAmp quad prec |
|OPA453TA-1-ND |3 |4 |OpAmp HV |
|AD8674ARZ-REEL7CT-ND|6 |7 |OpAmp quad |
|AD8671ARZ-ND |3 |5 |OpAmp |
||||
|345-1020-ND |3 |10 |Heat sink |
|294-1080-ND |4 |10 |Heat sink |
||||
|290-1009-ND |15 |15 |BNC 1' |
|290-1010-ND |15 |15 |BNC 2' |
|290-1011-ND |15 |15 |BNC 3' |
|290-1013-ND |15 |15 |BNC 5' |
|290-1015-ND |15 |15 |BNC 10' |
||||
|A32260-ND |32 |50 |CONN BNC |
|501-1070-ND |5 |5 |Box BNC |
|ACX1066-ND |25 |25 |TERM BNC-M |
|J10098-ND |25 |25 |CONV BNC-F SMA-M |
||||
|SMD291AX-ND |1 |1 |Solder paste |
