nacs-lab/yyc-data/designs/regulator/parts.md

# Connectors

3-pin connector for input and output. Already have them in the lab.

# Capacitors

Aluminum: 399-6123-ND x 2
Ceramic 10u 0603: Already in the lab
Ceramic 1.5u 0805: 445-5966-1-ND x 6
Ceramic 0.1u 0805: 399-3486-1-ND x 6

# Resistors

0.1 0603: A103277CT-ND x 2
3.3k 0603: RHM3.3KDCT-ND x 2
232k 0603: A124724CT-ND x 2
20k trimpot: TS63Y-20KCT-ND x 2

# Chips

LT3089IFE#PBF-ND x 1
LT3090MPMSE#PBF-ND x 1
