nacs-lab/yyc-data/orders/Microwave/qorvo.md

# High power microwave amplifiers chips/eval boards from qorvo

| Part No.|Chip price ($)|Power (W)|Input (dBm)|
|---|---|---|---|
|  TGM2635-CP| 2100| 100| 28|
|  TGA2238-CP| 933| 50| 23|
|  TGA2590-CP| 840| 30| 23|
| QPA1011| 454| 25| 25|
| QPA1010| 231| 15| 24|
