nacs-lab/yyc-data/designs/fpga_box/part_list.md

# Parts list of the FPGA box

This part list does not include screws and standoffs.

## The box

| Part number|Quantity| Source| Note|
|---|---|---|---|
| B3F10-62A| 1|Lansing Enclosures| Jim has stock|

## FPGA board

| Part number|Quantity| Source| Note|
|---|---|---|---|
| EK-Z7-ZC702-G| 1|Avnet / Digikey|ZC702 Evaluation Board|
| | 1| | SD card|

## FMC breakout board

Per board. 2 boards per box.

| Part number|Quantity| Source| Note|
|---|---|---|---|
| 150260-6002-RB| 12| Digikey| 60 pin socket|
| 135-3701-201| 6| Digikey| MMCX connector|
| 0022232021| 3| Digikey| 2 pin connector|
| ASP-134604-01| 1| Newark| FMC connector|

## DDS board

Per board. 22 boards per box.

| Part number|Quantity| Source| Note|
|---|---|---|---|
| C1608X7R1E104K080AA| 21| Digikey| 0603 0.1uF cap|
| C1608C0G1E103J080AA| 3| Digikey| 0603 10nF cap|
| C0603C105K4RACTU| 1| Digikey| 0603 1uF cap|
|CGA5L1X7R1E335K160AC| 4| Digikey| 1206 3.3uF cap|
| LS A67K-J1L2-1-Z| 1| Digikey| Red LED|
| BMI-S-230-F-R| 1| Digikey| RF shield frame|
| 131-3701-801| 2| Digikey| SMB connector|
| 151260-7422-RB| 1| Digikey| 60 pin connector|
| ILB1206ER700V| 3| Digikey| Ferrite bead|
| RC0603FR-0749R9L| 1| Digikey| 0603 49.9 ohm|
| ERJ-3EKF2001V| 11| Digikey| 0603 2k ohm|
| ERJ-12ZYJ111U| 1| Digikey| 2010 110 ohm|
| ERJ-3EKF4701V| 1| Digikey| 0603 4.7k ohm|
| NCP18XH103J03RB| 1| Digikey| 0603 10k thermistor|
| SN74CB3Q3245PWR| 1| Digikey| Bus switch|
| AD9914BCPZ| 1| Digikey| DDS|
| MAX6502UKP065+T| 1| Digikey| Thermal switch|
| ELK-E333FA| 10| Digikey| EMI filter|
| TCCH-80+| 2| Minicircuits| PL-147 4uH inductor|
| TC1-1-13+| 1| Minicircuits| SM-22 transformer|
| TC1-1-43+| 1| Minicircuits| SM-22 transformer|
| ERA-4XSM+| 1| Minicircuits| PL-075 amplifier|

## TTL board

<TODO>

| Part number|Quantity| Source| Note|
|---|---|---|---|
| | | | |

## TTL breakout board

<TODO>

| Part number|Quantity| Source| Note|
|---|---|---|---|
| | | | |

## Power breakout board

| Part number|Quantity| Source| Note|
|---|---|---|---|
| 860010672011| 2| Digikey| 50V 33uF cap (C1, 3)|
|  ESK107M025AC3AA| 2| Digikey| 25V 100uF cap (C10-11)|
| UVY1A221MDD1TD| 6| Digikey|10V 220uF cap (C6-7, 12, 14, 16, 18)|
|  CL31B105KCHNNNE| 1| Digikey| 100V 1uF cap (C2)|
|  CL31A106KAHNNNE| 8| Digikey|25V 10uF cap (C4-5, 8-9, 13,15, 17, 19)|
| RC0603FR-070RL| 3| Digikey| 0 ohm (R1-3)|
| 3266W-1-203LF| 2| Digikey| Trimpot (RV1-2)|
| QD48T018033-NCC0| 1|Onlinecomponent| 48V to 1.8, 3.3V (U1)|
| PTB48510BAS| 1| Digikey| 48V to +-12V (U2)|

## Board interconnection

| Part number|Quantity| Source| Note|
|---|---|---|---|
| 1827130| 30| Digikey| 3-pos plug|
| 1803439| 30| Digikey| 3-pos header|
| 1827127| 20| Digikey| 2-pos plug|
| 1803426| 20| Digikey| 2-pos header|
| 76502.18.01| 1| Digikey| 18 AWG wire black|
| 76502.18.02| 1| Digikey| 18 AWG wire white|
| 76502.18.04| 1| Digikey| 18 AWG wire orange|
| 76502.18.05| 1| Digikey| 18 AWG wire yellow|
| 76502.18.06| 1| Digikey| 18 AWG wire green|
| 76502.18.08| 1| Digikey| 18 AWG wire brown|
| 76502.18.10| 1| Digikey| 18 AWG wire gray|
| 76502.18.19| 1| Digikey| 18 AWG wire violet|

## Other parts inside the box

| Part number|Quantity| Source| Note|
|---|---|---|---|
|  OD8038-12HBVXC10A| 2| Digikey| Powerful fans|
| OD9220-12HB| 1| Digikey| Weaker pulling fan|
| EHRJ45P5ES| 2| Digikey|  Ethernet feed through|
| 17-200001| 3| Digikey| USB feed through|
| 0897616821| 12| Digikey| SMA-F to MMCX-M|
| 621| 44| Digikey| L bracket|
| | 1| |USB-A to mini-USB cable|
| | 2| | Short ethernet cable|
| PYB20-Q24-D5-U| 2| Digikey| 12V to +-5V|
| KPJX-PM-4S| 1| Mouser| 48V feed through|
| 031-10-RFXG1| 1| Digikey| 5V BNC feed through|

## Other parts outside the box

| Part number|Quantity| Source| Note|
|---|---|---|---|
| AXA-SMBPSF| 44| L-com|SMB-F to SMA-F connector|
| 415-0037-060| 30| | 5' SMA-M to BNC-M cable|
| 135103-02-12.00| 30| |1' SMA to SMA right angle cable|
| ZB8PD-4-S+| 3| Minicircuits| x8 power splitter|
| ZB3PD-4-S+| 1| Minicircuits| x3 power splitter|
| ZX60-V82-S+| 1| Minicircuits| Clock amplifier|
| MixNV| 1| WindFreak| Clock|
| DTM165PW480C| 1| Digikey| 48V power supply|
| PR35B32CMB| 1| L-com| Output panel|
| <TODO>| 1| | SMA-M to SMA-M|
