nacs-lab/yyc-data/orders/computer_control/cmrlink-digikey.md

# Parts for camera link-FPGA interface from **[DigiKey](http://www.digikey.com/)**

|Part Number (With link)|Quantity|Price (Harvard pricing)|Description|
|---|---|---|---|
|[MCA100-5-ND](https://punchout.digikey.com/product-detail/en/1MF26-L560-00C-500/MCA100-5-ND/1129494)|1|154.64|Camera link cable (5m)|
|[MSDS26-ND](https://punchout.digikey.com/product-detail/en/12226-8250-00FR/MSDS26-ND/1092161)|1|10.77|Camera link connector|
|[DS90CR288AMTD/NOPB-ND](https://punchout.digikey.com/product-detail/en/DS90CR288AMTD%2FNOPB/DS90CR288AMTD%2FNOPB-ND/363519)|1|9.64|Camera link decoder|
