nacs-lab/yyc-data/orders/computer_control/fpga_breakout-digikey.md

# Parts for FPGA breakout board from **[DigiKey](http://www.digikey.com/)**

|Part Number (With link)|Quantity|Price (Harvard pricing)|Description|
|---|---|---|---|
|[WM4200-ND](http://www.digikey.com/product-detail/en/0022232021/WM4200-ND/26667)|6|1.02|Power jumper|
|[277-1221-ND](http://www.digikey.com/product-detail/en/1803426/277-1221-ND/260589)|10|6.00|Power connector|
|[J597-ND](http://www.digikey.com/product-detail/en/135-3701-201/J597-ND/263435)|12|39.72|Auxiliary input/output|
