nacs-lab/yyc-data/orders/computer_control/aux-digikey.md

# Auxiliary parts from **[DigiKey](http://www.digikey.com/)**

|Part Number (With link)|Quantity|Price (Harvard pricing)|Description|
|---|---|---|---|
|[285-1925-ND](http://www.digikey.com/product-detail/en/DT100PW480C/285-1925-ND/2135310)|1|72.11|DDS Power supply|
|[993-1283-ND1](http://www.digikey.com/product-detail/en/PSAA10A-050QA/993-1283-ND/4835594)|1|9.56|Clock amplifier power supply|
|[1053-1275-ND](http://www.digikey.com/product-detail/en/OD9220-12HB/1053-1275-ND/2621180)|2|18.86|DDS cooling fan|
|[Q331-ND](http://www.digikey.com/product-detail/en/QSB-92-01/Q331-ND/1147317)|2|12.00|DDS cooling fan finger guard|
|[EHRJ45P5ES-ND](http://www.digikey.com/product-detail/en/EHRJ45P5ES/EHRJ45P5ES-ND/2666475)|2|23.40|Ethernet feed through|
|[626-1352-ND](http://www.digikey.com/product-detail/en/17-200001/626-1352-ND/2184932)|4|32.08|USB feed through|
|[QD48T018033-NBA0-ND](http://www.digikey.com/product-detail/en/QD48T018033-NBA0/QD48T018033-NBA0-ND/3535734)|1|75.81|DDS power converter|
|[36-621-ND](http://www.digikey.com/product-detail/en/621/36-621-ND/316544)|100|18.00|DDS mount|
