nacs-lab/yyc-data/docs/parts/RJ45x8_6368062.pdf

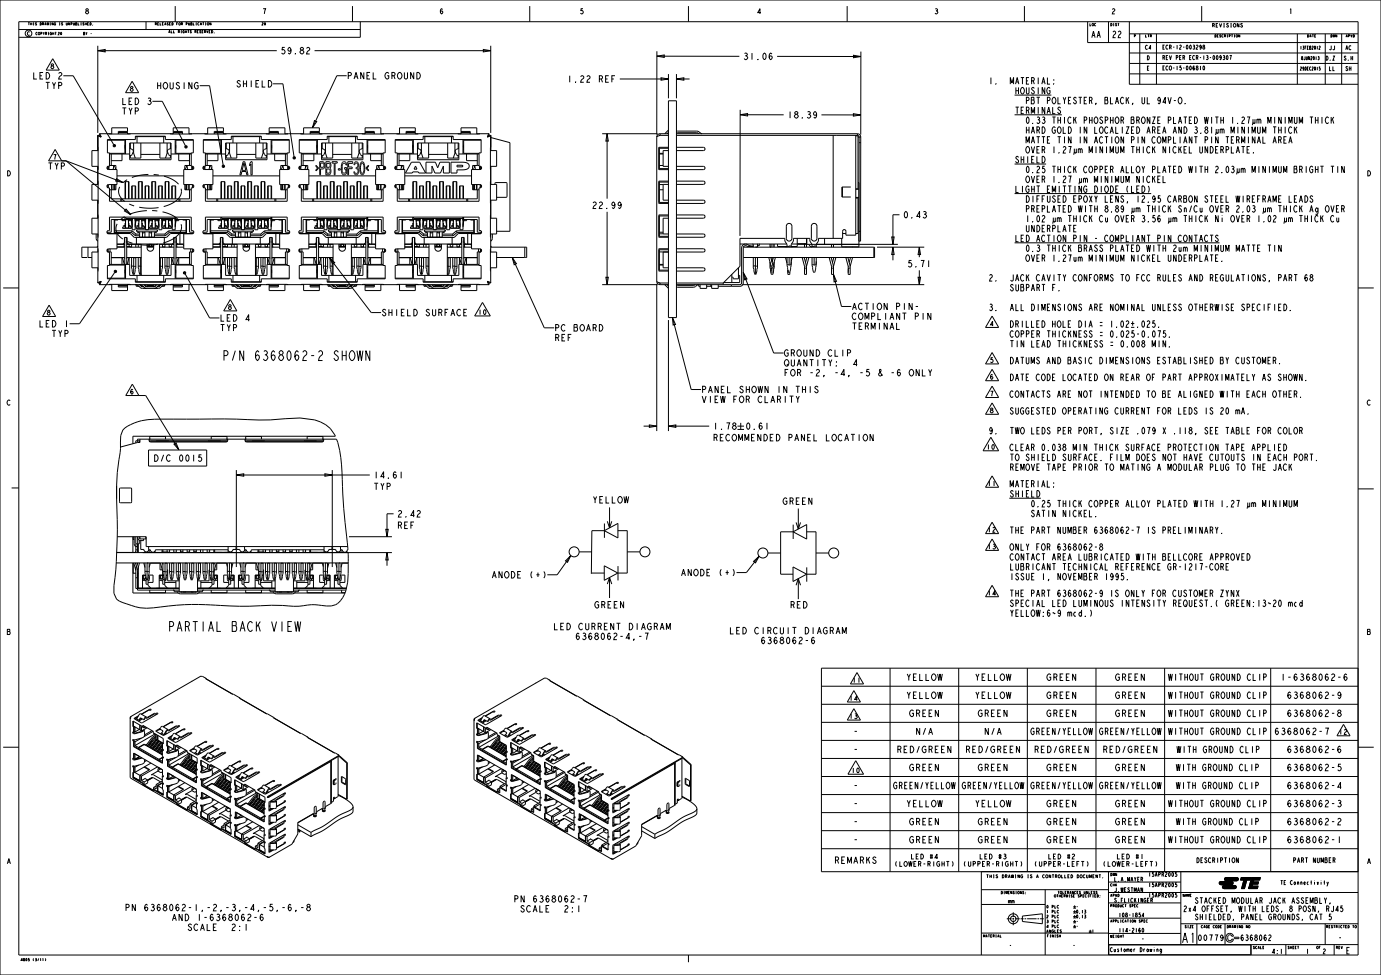
[picture p143: page 1]
0 PLC 1 PLC 2 PLC 3 PLC 4 PLC; SIZE; CAGE; CODE; DRAWING NO; APPLICATION SPEC; THIS DRAWING; IS A CONTROLLED; DOCUMENT.; TE Connectivity; GREEN; WITH GROUND CLIP; GREEN/YELLOW GREEN/YELLOW; WITHOUT GROUND CLIP; YELLOW; ECR-12-003298; 13FEB2012; REV PER ECR-13-009307; 8JUN2013; Customer Drawing; 1.22 REF; DESCRIPTION; PART NUMBER LED #1; LED #2; LED #3; LED #4 (LOWER-RIGHT) REMARKS; GREEN/YELLOW GREEN/YELLOW GREEN/YELLOW GREEN/YELLOW; ANODE (+); LED CURRENT DIAGRAM; PC BOARD; PANEL GROUND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

THIS DRAWING IS UNPUBLISHED.
C COPYRIGHT

1. MATERIAL:
HOUSING
PBT POLYESTER, BLACK, UL 94V-O.
TERMINALS
0.33 THICK PHOSPHOR BRONZE PLATED WITH 1.27µm MINIMUM THICK
HARD GOLD IN LOCALIZED AREA AND 3.81µm MINIMUM THICK
MATTE TIN IN ACTION PIN COMPLIANT PIN TERMINAL AREA
OVER 1.27µm MINIMUM THICK NICKEL UNDERPLATE.
SHIELD
0.25 THICK COPPER ALLOY PLATED WITH 2.03µm MINIMUM BRIGHT TIN
OVER 1.27 µm MINIMUM NICKEL
LIGHT EMITTING DIODE (LED)
DIFFUSED EPOXY LENS, 12.95 CARBON STEEL WIREFRAME LEADS
PREPLATED WITH 8.89 µm THICK Sn/Cu OVER 2.03 µm THICK Ag OVER
1.02 µm THICK Cu OVER 3.56 µm THICK Ni OVER 1.02 µm THICK Cu
UNDERPLATE
LED ACTION PIN - COMPLIANT PIN CONTACTS
0.3 THICK BRASS PLATED WITH 2um MINIMUM MATTE TIN
OVER 1.27um MINIMUM NICKEL UNDERPLATE.
2. JACK CAVITY CONFORMS TO FCC RULES AND REGULATIONS, PART 68
SUBPART F.
3. ALL DIMENSIONS ARE NOMINAL UNLESS OTHERWISE SPECIFIED.
DRILLED HOLE DIA = 1.02±.025.
COPPER THICKNESS = 0.025-0.075.
TIN LEAD THICKNESS = 0.008 MIN.
DATUMS AND BASIC DIMENSIONS ESTABLISHED BY CUSTOMER.
DATE CODE LOCATED ON REAR OF PART APPROXIMATELY AS SHOWN.
CONTACTS ARE NOT INTENDED TO BE ALIGNED WITH EACH OTHER.
SUGGESTED OPERATING CURRENT FOR LEDS IS 20 mA.
9. TWO LEDS PER PORT, SIZE .079 X .118, SEE TABLE FOR COLOR
CLEAR 0.038 MIN THICK SURFACE PROTECTION TAPE APPLIED
TO SHIELD SURFACE. FILM DOES NOT HAVE CUTOUTS IN EACH PORT.
REMOVE TAPE PRIOR TO MATING A MODULAR PLUG TO THE JACK
MATERIAL:
0.25 THICK COPPER ALLOY PLATED WITH 1.27 µm MINIMUM
SATIN NICKEL.
THE PART NUMBER 6368062-7 IS PRELIMINARY.
ONLY FOR 6368062-8
CONTACT AREA LUBRICATED WITH BELLCORE APPROVED
LUBRICANT TECHNICAL REFERENCE GR-1217-CORE
ISSUE 1, NOVEMBER 1995.
THE PART 6368062-9 IS ONLY FOR CUSTOMER ZYNX
SPECIAL LED LUMINOUS INTENSITY REQUEST.( GREEN:13~20 mcd
YELLOW:6~9 mcd.)

PANEL SHOWN IN THIS
VIEW FOR CLARITY
RECOMMENDED PANEL LOCATION

PARTIAL BACK VIEW

LED CIRCUIT DIAGRAM

WITH GROUND CLIP

15APR2005
2x4 OFFSET, WITH LEDS, 8 POSN, RJ45
SHIELDED, PANEL GROUNDS, CAT 5

NAME
STACKED MODULAR JACK ASSEMBLY,

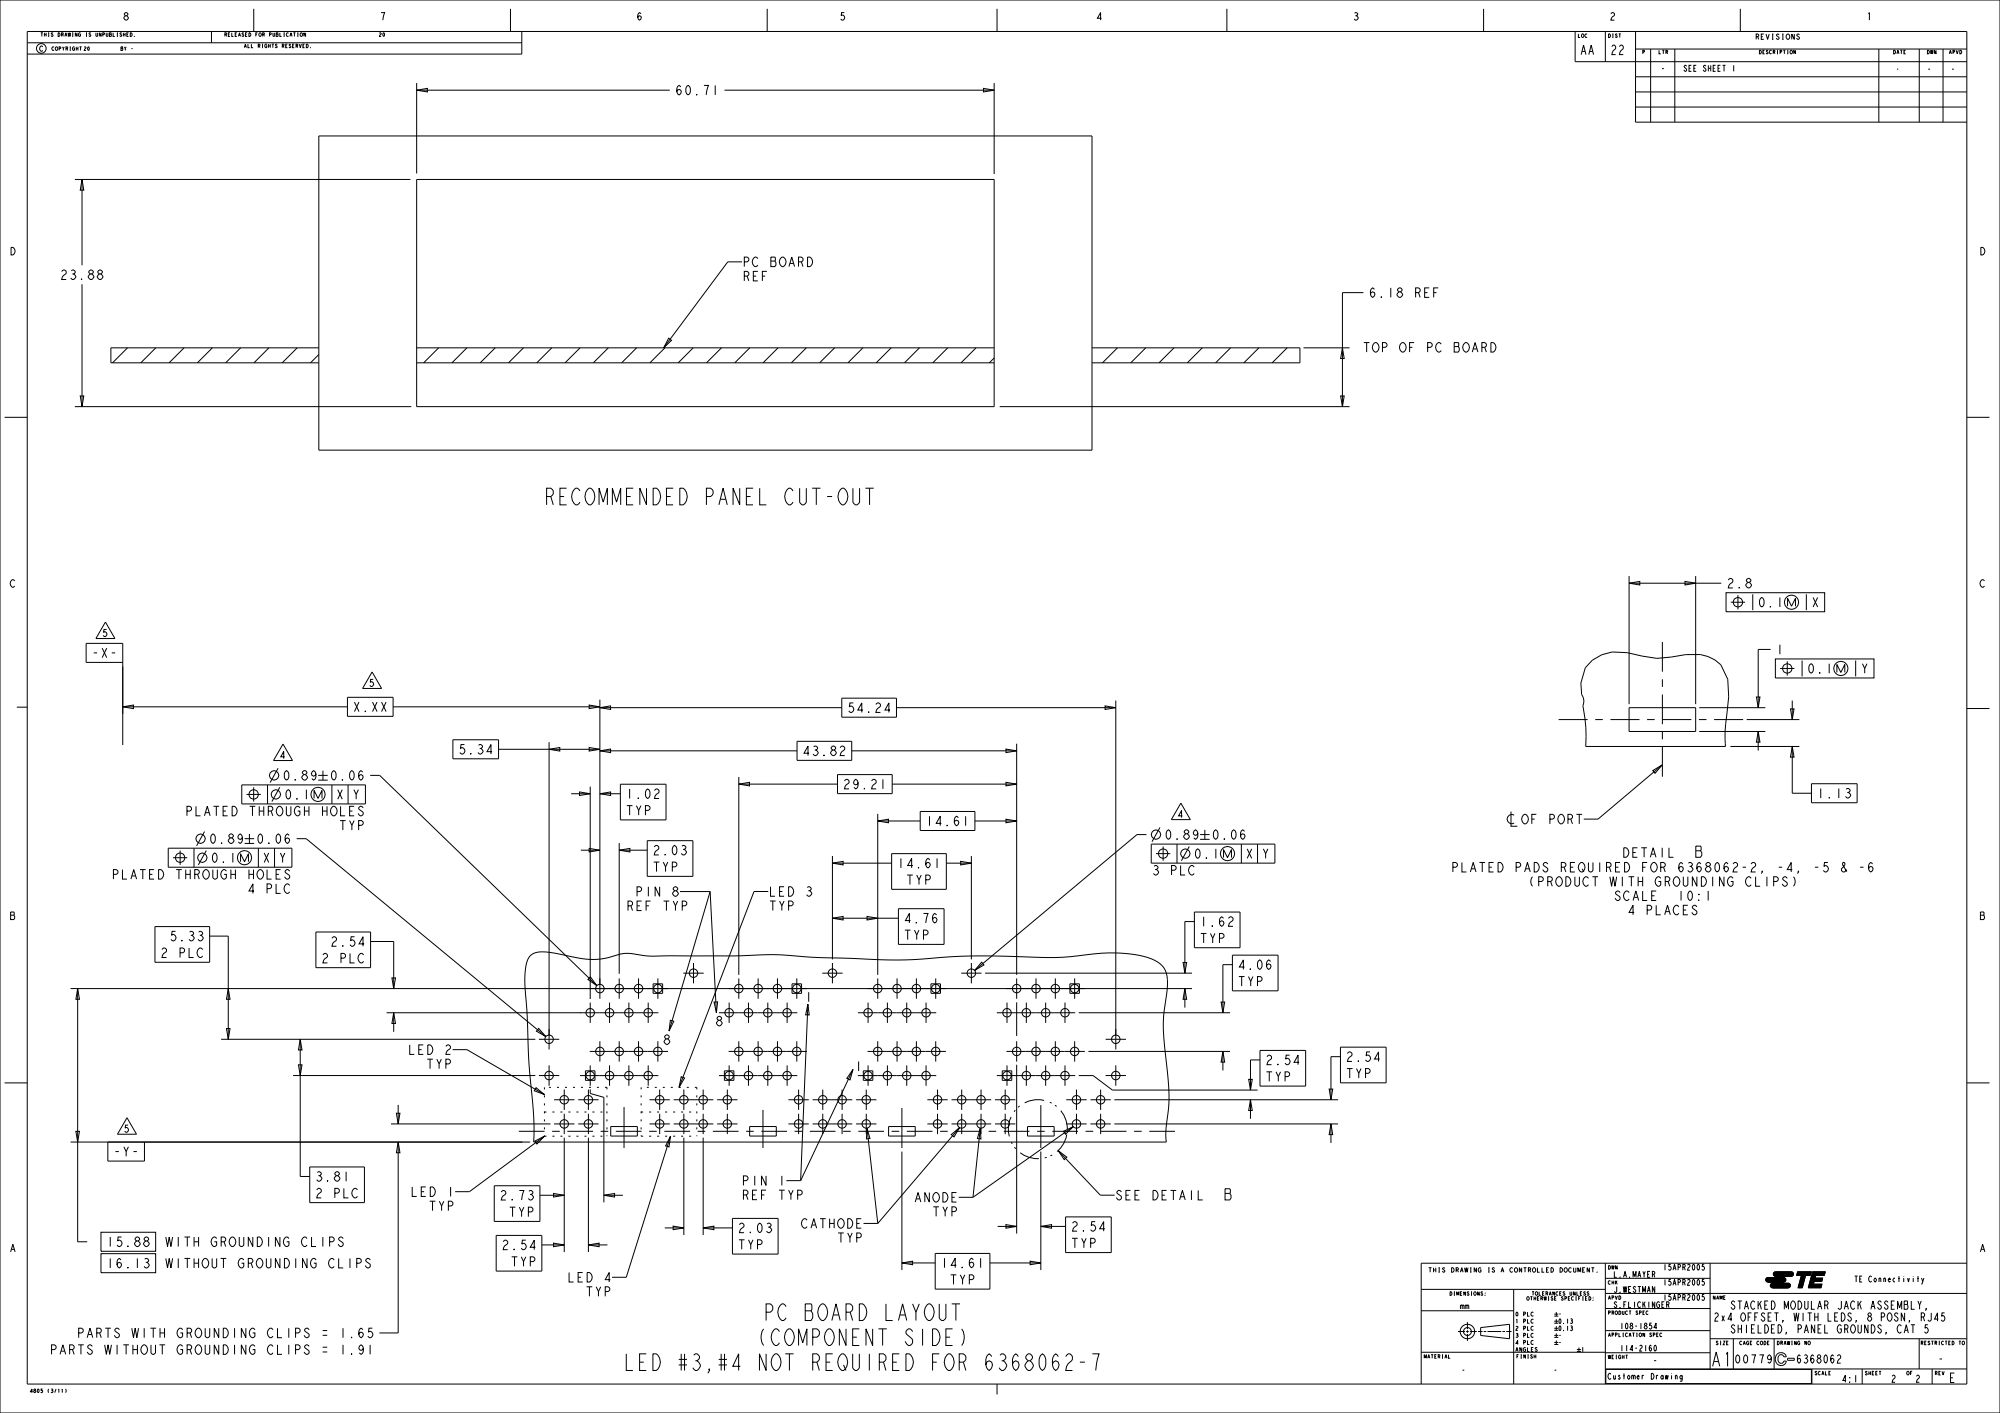
[picture p144: page 2]
0 PLC 1 PLC 2 PLC 3 PLC 4 PLC; SIZE; CAGE; CODE; DRAWING NO; APPLICATION SPEC; THIS DRAWING; IS A CONTROLLED; DOCUMENT.; TE Connectivity; 6.18 REF; SEE SHEET 1; Customer Drawing; 4 PLC; 2 PLC; 3 PLC; PARTS WITH; GROUNDING CLIPS =; PARTS WITHOUT GROUNDING CLIPS =; PIN 8 REF TYP; LED 4; LED 3; LED 1; LED 2; TOP OF; PC BOARD; PLATED PADS; REQUIRED FOR 6368062-2, -4, -5; 4 PLACES

THIS DRAWING IS UNPUBLISHED.
C COPYRIGHT

RECOMMENDED PANEL CUT-OUT

PLATED THROUGH HOLES

(PRODUCT WITH GROUNDING CLIPS)

PIN 1
CATHODE
TYP
PC BOARD LAYOUT
(COMPONENT SIDE)
LED #3,#4 NOT REQUIRED FOR 6368062-7

15APR2005
2x4 OFFSET, WITH LEDS, 8 POSN, RJ45
SHIELDED, PANEL GROUNDS, CAT 5

NAME
STACKED MODULAR JACK ASSEMBLY,
