nacs-lab/yyc-data/orders/DigiKey_2018-05-06.md

| DigiKey PartNumber | Minimum Quantity | Actual Quantity | Comment |
|---|---|---|---|
| P464DBCT-ND | | | R 464 |
| P562DBCT-ND | | | R 562 |
| P681DBCT-ND | | | R 681 |
| YAG4489CT-ND | | | R 1.01k |
| P1.82KDBCT-ND | | | R 1.82k |
| P1.96KDBCT-ND | | | R 1.96k |
| P2.0KDBCT-ND | | | R 2.0k |
| P2.21KDBCT-ND | | | R 2.21k |
| 764-1254-1-ND | | | R 2.5k |
| P2.7KDBCT-ND | | | R 2.7k |
| YAG4550CT-ND | | | R 3.88k |
| PNM0603-5.0KBCT-ND | | | R 5k |
| YAG4590CT-ND | | | R 6.34k |
| RNCF0603BTE6K57CT-ND | | | R 6.57k |
| P10.7KDBCT-ND | | | R 10.7k |
| P17.4KDBCT-ND | | | R 17.4k |
| YAG4485CT-ND | | | R 18.7k |
| 478-10341-1-ND | | | C 0.82n |
| 490-16421-1-ND | | | C 2.2n |
| 399-13412-1-ND | | | C 4.7n |
| 399-17411-1-ND | | | C 0.62n |
| 399-14537-1-ND | | | C 0.75n |
| 399-14530-1-ND | | | C 5.6n |
| 399-11154-1-ND | | | C 6.8n |
| 399-10043-1-ND | | | C 15n |
| 478-10279-1-ND | | | C 0.1u |
| 490-10991-1-ND | | | C 10u |
| AD8429BRZ-ND | | | Instr Amp |
| 296-23958-5-ND | | | Low noise Op |
| 296-47811-1-ND | | | Low noise Op |
| ACX1171-ND | | | N L |
| J10098-ND | | | BNC F - SMA M |
| 314-1127-ND | | | BNC F - Banana M |
