nacs-lab/yyc-data/orders/Valon_2016-10-06.md

|  PartNumber|Minimum Quantity|Actual Quantity|Comment |
|---|---|---|---|
| 5009| 1| 1| |
