nacs-lab/yyc-data/orders/DigiKey_2015-10-15.md

|DigiKey PartNumber|Minimum Quantity|Actual Quantity|Comment |
|---|---|---|---|
|J10095-ND |20 |50 |BNC T F-M-F |
|WM9472-ND |10 |10 |BNC Cap M |
|290-1013-ND |20 |20 |BNC 5' |
|ACX1568-ND |15 |15 |SMA 12" |
|ACX1573-ND |15 |15 |SMA 24" |
