nacs-lab/yyc-data/orders/DigiKey_2015-07-06.md

|DigiKey PartNumber|Minimum Quantity|Actual Quantity|Comment |
|---|---|---|---|
|290-1010-ND |20 |20 |BNC 2' |
|290-1011-ND |10 |10 |BNC 3' |
|290-1013-ND |20 |20 |BNC 5' |
|290-1015-ND |10 |10 |BNC 10' |
|290-1017-ND |15 |15 |BNC 25' |
|J4536-ND |25 |25 |BNC-SMA 3' |
|J3712-ND |25 |25 |SMA 1' |
|||||
|1427-1067-ND |10 |10 |BNC F M-F-F |
|CONSMA010-ND |30 |30 |SMA L |
|||||
|314-1127-ND |10 |10 |BNC F-Banana M |
|||||
|367-1015-ND |20 |50 |BNC F-F |
|314-1167-ND |15 |15 |BNC M-M |
