nacs-lab/yyc-data/orders/ScreamingCircuits_2015-03-19.md

|PartNumber |Minimum Quantity|Actual Quantity|Comment |
|---|---|---|---|
|445-1314-1-ND |630 |- |C 0.1u 0603 |
|445-2664-1-ND |60 |100 |C  10n 0603 |
|399-7847-1-ND |30 |50 |C 1.0u 0603 |
|445-4029-1-ND |150 |250 |C 3.3u 1206 |
|||||
|712-1445-1-ND |30 |70 |L  82u 0603 |
|490-4026-1-ND |30 |50 |L 1.0u 0805 |
|||||
|P2.00KHCT-ND |270 |300 |R 2.0k 0603 |
|P0.0GCT-ND |30 |50 |R  0.0 0603 |
|RR08Q49.9DCT-ND |30 |50 |R 49.9 0603 |
|P110WCT-ND |30 |50 |R  110 0603 |
|P4.70KHCT-ND |30 |50 |R 4.7k 0603 |
|P0.0ECT-ND |30 |50 |R  0.0 1206 |
|||||
|TC1-1-43+ |30 |35 |Transformer |
|1465-1217-1-ND |30 |30 |Transformer |
|P13159CT-ND |300 |300 |EMI Filter |
|||||
|296-19130-1-ND |30 |30 |TTL switch |
|AD9914BCPZ-ND |30 |30 |DDS |
|ERA-4XSM+ |30 |34 |Amplifier |
|||||
|J10107-ND |60 |64 |SMB connector |
|3M2360-ND |30 |35 |30x2 pins connector |

Parts should be either in the original package from DigiKey or MiniCircuits with part number on them or in a zip lock bag with at least two labels with the part number on it.
