nacs-lab/yyc-data/orders/DigiKey_2015-03-09.md

|DigiKey PartNumber|Minimum Quantity|Actual Quantity|Comment |
|---|---|---|---|
|445-2664-1-ND |60 |100 |C 10n  0603 |
|399-7847-1-ND |10 |50 |C 1.0u 0603 |
|445-4029-1-ND |150 |250 |C 3.3u 1206 |
|||||
|490-4026-1-ND |30 |50 |L 1.0u 0805 |
|||||
|P2.00KHCT-ND |270 |300 |R 2.0k 0603 |
|P0.0GCT-ND |30 |50 |R 0.0 0603 |
|RR08Q49.9DCT-ND |30 |50 |R 49.9 0603 |
|P110WCT-ND |30 |50 |R 110 0603 |
|P4.70KHCT-ND |30 |50 |R 4.7k 0603 |
|P0.0ECT-ND |30 |50 |R 0.0 1206 |
|||||
|J10107-ND |51 |55 |SMB connector |
|3M2360-ND |30 |35 |30x2 pins connector |
|||||
|1465-1217-1-ND |25 |30 |Transformer |
|P13159CT-ND |270 |300 |EMI Filter |
|||||
|AD9914BCPZ-ND |30 |30 |DDS |
