nacs-lab/yyc-data/orders/DigiKey_2015-03-13.md

|DigiKey PartNumber|Minimum Quantity|Actual Quantity|Comment |
|---|---|---|---|
|290-1009-ND |24 |24 |BNC 1' |
|290-1010-ND |24 |24 |BNC 2' |
|290-1011-ND |24 |24 |BNC 3' |
|290-1013-ND |30 |30 |BNC 5' |
|290-1015-ND |24 |24 |BNC 10' |
|||||
|1427-1067-ND |10 |10 |BNC F M-F-F |
|J10095-ND |20 |20 |BNC T F-M-F |
|||||
|367-1015-ND |10 |10 |BNC F-F |
|314-1167-ND |10 |10 |BNC M-M |
|CP-AD503-ND |20 |20 |BNC L |
|||||
|J10097-ND |20 |20 |BNC F-SMA F |
|J10098-ND |10 |10 |BNC F-SMA M |
|||||
|501-1127-ND |5 |5 |BNC M-Banana M |
|||||
|ACX1252-ND |10 |10 |TERM SMA F |
|||||
|A97567-ND |100 |100 |Lock Washer for panel BNC |
|A97566-ND |100 |100 |Nut for panel BNC |
|A24479-ND |50 |50 |Bushing for panel BNC |
|||||
|AE10337-ND |10 |10 |USB 2.0 extension |
|AE10646-ND |2 |2 |USB 3.0 extension |
