nacs-lab/yyc-data/orders/computer_control/aux-lcom.md

# Auxiliary parts from **[L-com](http://www.l-com.com/)**

|Part Number (With link)|Quantity|Price|Description|
|---|---|-----|---|
|[PR35B32CMB](http://www.l-com.com/patch-panel-server-rack-350-panel-black-32-bnc-adapters-insulated-w-rear-cable-minder)|1|219.95|Output panel|
|[AXA-SMBPSF](http://www.l-com.com/coaxial-coaxial-adapter-smb-plug-sma-jack-female)|44|254.32|Output and clock adapter|
