nacs-lab/yyc-data/orders/computer_control/dds-digikey.md

# Parts for DDS board from **[DigiKey](http://www.digikey.com/)**

|Part Number (With link)|Quantity|Price (Harvard pricing)|Description|
|---|---|---|---|
|[445-1314-1-ND](http://www.digikey.com/product-detail/en/C1608X7R1H104K080AA/445-1314-1-ND/567687)|630|6.30|C 0.1u 0603|
|[445-2664-1-ND](http://www.digikey.com/product-detail/en/C1608C0G1E103J080AA/445-2664-1-ND/970489)|60|14.40|C 10n 0603|
|[399-7847-1-ND](http://www.digikey.com/product-detail/en/C0603C105K4RACTU/399-7847-1-ND/3471570)|30|3.60|C 1.0u 0603|
|[445-4029-1-ND](http://www.digikey.com/product-detail/en/C3216X7R1E335K160AC/445-4029-1-ND/1965675)|150|18.00|C 3.3u 1206|
|||||
|[712-1445-1-ND](http://www.digikey.com/product-detail/en/L-14C82NJV4T/712-1445-1-ND/1914895)|30|1.50|L 82u 0603|
|[490-4026-1-ND](http://www.digikey.com/product-detail/en/LQM21FN1R0N00D/490-4026-1-ND/1016286)|30|3.00|L 1.0u 0805|
|||||
|[P2.00KHCT-ND](http://www.digikey.com/product-detail/en/ERJ-3EKF2001V/P2.00KHCT-ND/198219)|270|1.73|R 2.0k 0603|
|[P0.0GCT-ND](http://www.digikey.com/product-detail/en/ERJ-3GEY0R00V/P0.0GCT-ND/134711)|30|2.70|R 0.0 0603|
|[RR08Q49.9DCT-ND](http://www.digikey.com/product-detail/en/RR0816Q-49R9-D-68R/RR08Q49.9DCT-ND/567273)|30|2.40|R 49.9 0603|
|[P110WCT-ND](http://www.digikey.com/product-detail/en/ERJ-12ZYJ111U/P110WCT-ND/249688)|30|8.70|R 110 0603|
|[P4.70KHCT-ND](http://www.digikey.com/product-detail/en/ERJ-3EKF4701V/P4.70KHCT-ND/1746782)|30|2.70|R 4.7k 0603|
|[P0.0ECT-ND](http://www.digikey.com/product-detail/en/ERJ-8GEY0R00V/P0.0ECT-ND/203245)|30|2.70|R 0.0 1206|
|||||
|[1465-1217-1-ND](http://www.digikey.com/product-detail/en/ETC1-1-13TR/1465-1217-1-ND/4429914)|30|41.10|Transformer|
|[P13159CT-ND](http://www.digikey.com/product-detail/en/ELK-E333FA/P13159CT-ND/816378)|300|96.00|EMI Filter|
|||||
|[296-19130-1-ND](http://www.digikey.com/product-detail/en/SN74CB3Q3245PWR/296-19130-1-ND/864361)|30|20.10|TTL switch|
|[AD9914BCPZ-ND](http://www.digikey.com/product-detail/en/AD9914BCPZ/AD9914BCPZ-ND/3602815)|30|4912.50|DDS|
|||||
|[J10107-ND](http://www.digikey.com/product-detail/en/131-3701-801/J10107-ND/431916)|60|210.00|SMB connector|
|[3M2360-ND](http://www.digikey.com/product-detail/en/151260-7422-RB/3M2360-ND/1093533)|30|143.10|30x2 pins connector|
