nacs-lab/yyc-data/orders/computer_control/minicircuits.md

# Parts from **[Minicircuits](http://www.minicircuits.com/homepage/homepage.html)**

|Part Number (With link)|Quantity|Price|Description|
|---|---|-----|---|
|[ZA3PD-4-S+](http://www.minicircuits.com/pdfs/ZA3PD-4+.pdf)|1|89.95|Primary clock splitter|
|[ZB8PD-4-S+](http://www.minicircuits.com/pdfs/ZB8PD-4.pdf)|3|416.85|Secondary clock splitter|
|[ZX60-V82-S+](https://www.minicircuits.com/pdfs/ZX60-V82+.pdf)|1|69.95|Clock amplifier|
|[TC1-1-43+](https://www.minicircuits.com/pdfs/TC1-1-43+.pdf)|50|64.50|Clock coupler|
|[ERA-4XSM+](https://www.minicircuits.com/pdfs/ERA-4XSM+.pdf)|50|87.00|Output amplifier|
