nacs-lab/yyc-data/orders/lighthouse_rma/rma.pdf

# RMA # 4164885

October 9, 2019

Serial number: G10NSBH 20140617

1
