nacs-lab/yyc-data/designs/enclosure/top.dxf

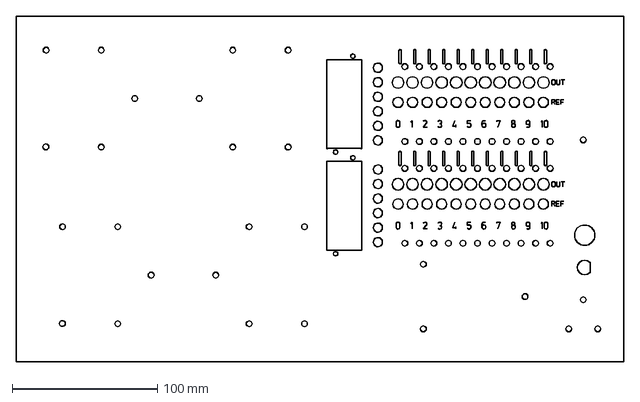
[picture p145: CAD file, 2016-10-06]
designs/enclosure/top.dxf
417.8 x 238.0 mm
