nacs-lab/yyc-data/designs/na_board/na_board_24.dxf

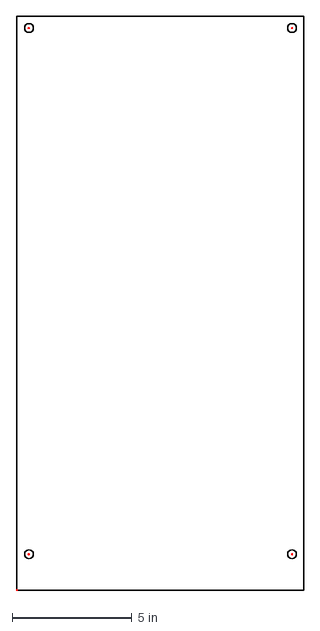
[picture p146: CAD file, 2015-09-12]
designs/na_board/na_board_24.dxf
12.0 x 24.0 in
