nacs-lab/yyc-data/designs/enclosure/left.dxf

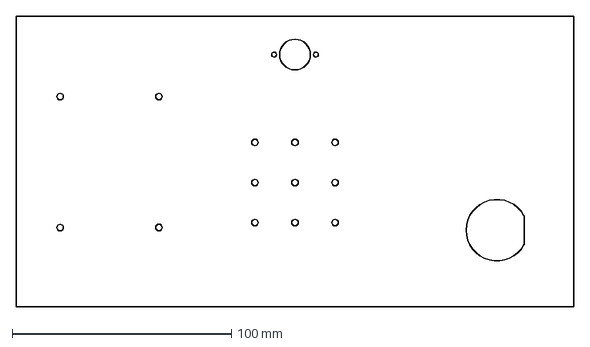
[picture p147: CAD file, 2016-10-04]
designs/enclosure/left.dxf
254.0 x 132.6 mm
