nacs-lab/yyc-data/designs/na_board/na_board_16.dxf

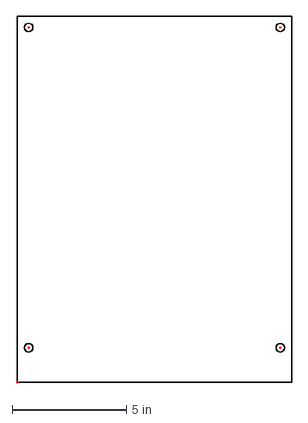
[picture p148: CAD file, 2015-09-12]
designs/na_board/na_board_16.dxf
12.0 x 16.0 in
