nacs-lab/yyc-data/designs/enclosure/back.dxf

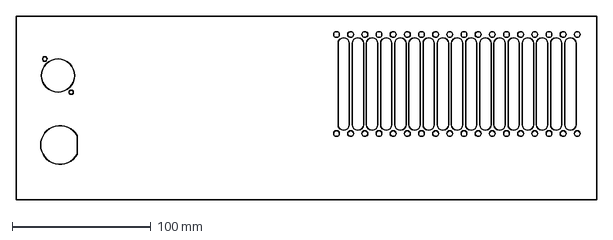
[picture p149: CAD file, 2016-10-04]
designs/enclosure/back.dxf
418.8 x 132.6 mm
