nacs-lab/yyc-data/designs/enclosure/bottom.dxf

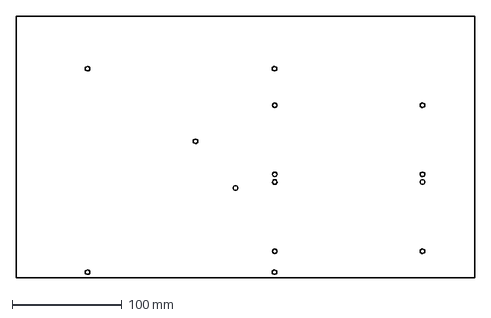
[picture p150: CAD file, 2016-10-04]
designs/enclosure/bottom.dxf
417.8 x 238.0 mm
