nacs-lab/yyc-data/designs/enclosure/front.dxf

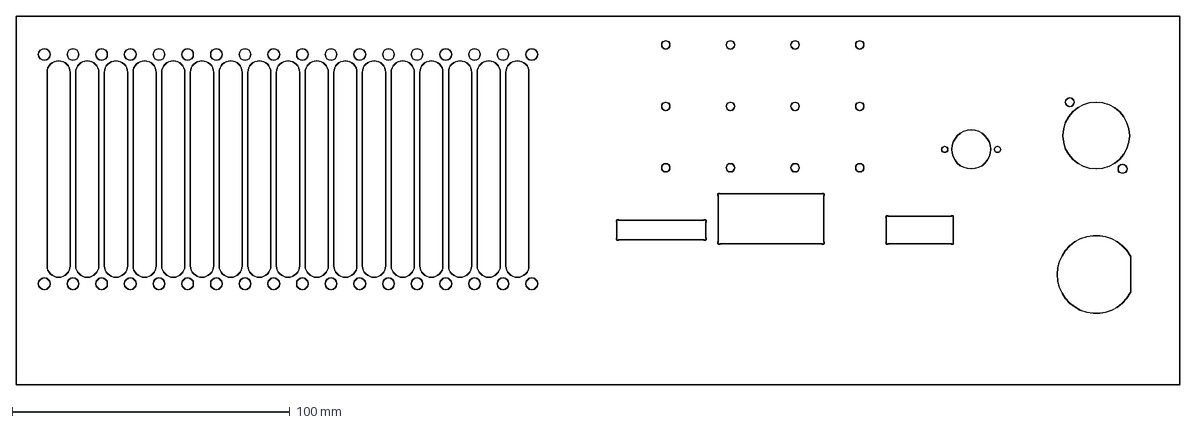
[picture p151: CAD file, 2016-10-04]
designs/enclosure/front.dxf
418.8 x 132.6 mm
