nacs-lab/yyc-data/experiments/dds-setup/list.md

|Channel Number|Board Number|Comment |
|---|---|---|
|0 |06 | |
|1 |10 | |
|2 |22 | |
|3 |17 | |
|4 |24 | |
|5 |23 | |
|6 |02 |Filter Replaced  |
|7 |05 |Filter Replaced  |
|8 |20 |(Used to be) Noisy|
|9 |25 |(Used to be) No Output|
|10 |01 |Two pin cut for testing|
|11 |16 | |
|12 |13 | |
|13 |18 | |
|14 |10 | |
|15 |08 | |
|16 |07 | |
|17 |04 | |
|18 |14 | |
|19 |15 | |
|20 |11 | |
|21 |21 | |
