nacs-lab/yyc-data/experiments/vescent_oscillation/README.md

# Scope traces

Channel 3 (DC) and Channel 4 (AC) are the same signal.

* Current when T2 is railed

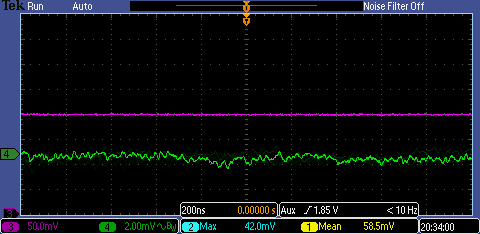
[picture p156: experiments/vescent_oscillation/I_rail1.png]
    

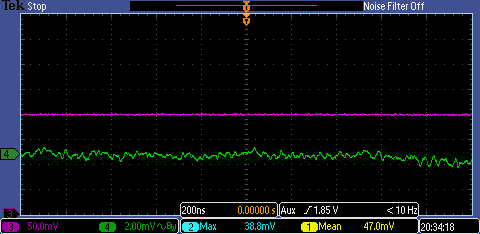
[picture p157: experiments/vescent_oscillation/I_rail2.png]
    

* Current when T2 is railed and when the fast feedback is disconnected

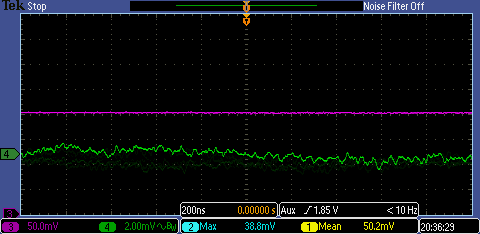
[picture p158: experiments/vescent_oscillation/I_rail-no-feedback1.png]
    

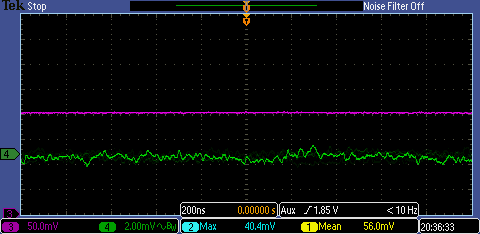
[picture p159: experiments/vescent_oscillation/I_rail-no-feedback2.png]
    

* delta T2 when the laser is on and the temperature starts oscillate.

    * With fast feedback plugged in

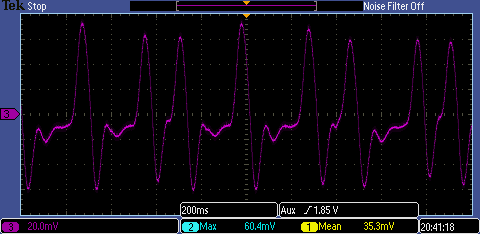
[picture p160: experiments/vescent_oscillation/deltaT2.png]
        

    * With fast feedback unplugged

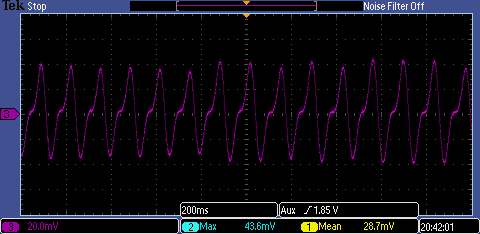
[picture p161: experiments/vescent_oscillation/deltaT2_no-feedback.png]
