nacs-lab/yyc-data/experiments/nacs_201808/plot_data/20180810_150954_interaction_shift_n1.md

[3+2 -> 3+1 n=0 Na only](data_20180810_150954_interaction_shift_n1_na_n0.csv)

[3+2 -> 3+1 n=0 Na+Cs](data_20180810_150954_interaction_shift_n1_nacs_na_n0.csv)

[3+2 -> 3+1 n=1 Na only](data_20180810_150954_interaction_shift_n1_na_n1.csv)

[3+2 -> 3+1 n=1 Na+Cs](data_20180810_150954_interaction_shift_n1_nacs_na_n1.csv)
