nacs-lab/yyc-data/experiments/nacs_201808/plot_data/20180808_interaction_shift2.md

[3+2 -> 3+1 n=0 Na only](data_20180808_interaction_shift2_33_na.csv)

[3+2 -> 3+1 n=0 Na+Cs](data_20180808_interaction_shift2_33_nacs_na.csv)

[4+2 -> 4+1 n=0 Na only](data_20180808_interaction_shift2_44_na.csv)

[4+2 -> 4+1 n=0 Na+Cs](data_20180808_interaction_shift2_44_nacs_na.csv)
