nacs-lab/yyc-data/experiments/nacs_201808/plot_data/20180815_interaction_shift4.md

[3+2 -> 3+1 n=0 Na only](data_20180815_interaction_shift4_na_n0.csv)

[3+2 -> 3+1 n=0 Na+Cs](data_20180815_interaction_shift4_nacs_na_n0.csv)

[4+2 -> 3+2 n=0 Cs only](data_20180815_interaction_shift4_cs_n0.csv)

[4+2 -> 3+2 n=0 Na+Cs](data_20180815_interaction_shift4_nacs_cs_n0.csv)

[4+2 -> 3+2 n=1 Cs only](data_20180815_interaction_shift4_cs_n1.csv)

[4+2 -> 3+2 n=1 Na+Cs](data_20180815_interaction_shift4_nacs_cs_n1.csv)
