nacs-lab/yyc-data/calculations/single-atom/SingleAtom/test/perf/soa_copy2.md

* `nele=64`

| ndim| 1| 3| 10| 30|
|---|---|---|---|---|
|Time (AoS)| 8.85e-08| 2.56e-07| 1.00e-06| 3.36e-06|
|Time (AoS split)| 8.96e-08| 2.74e-07| 9.17e-07| 2.74e-06|
|Time (SoA)| 3.21e-08| 9.87e-08| 3.17e-07| 1.12e-06|
|Time (SoA split)| 3.51e-08| 1.16e-07| 3.30e-07| 1.01e-06|

* `nele=128`

| ndim| 1| 3| 10| 30|
|---|---|---|---|---|
|Time (AoS)| 1.72e-07| 5.10e-07| 2.00e-06| 7.23e-06|
|Time (AoS split)| 1.73e-07| 5.32e-07| 1.79e-06| 5.35e-06|
|Time (SoA)| 5.98e-08| 1.81e-07| 6.14e-07| 2.76e-06|
|Time (SoA split)| 6.62e-08| 1.89e-07| 6.12e-07| 2.75e-06|

* `nele=256`

| ndim| 1| 3| 10| 30|
|---|---|---|---|---|
|Time (AoS)| 3.41e-07| 1.02e-06| 4.00e-06| 2.33e-05|
|Time (AoS split)| 3.41e-07| 1.05e-06| 3.52e-06| 1.06e-05|
|Time (SoA)| 1.25e-07| 3.52e-07| 1.61e-06| 5.27e-06|
|Time (SoA split)| 1.27e-07| 3.85e-07| 1.61e-06| 4.77e-06|

* `nele=512`

| ndim| 1| 3| 10| 30|
|---|---|---|---|---|
|Time (AoS)| 6.76e-07| 2.03e-06| 1.37e-05| 5.38e-05|
|Time (AoS split)| 6.81e-07| 2.09e-06| 7.00e-06| 2.10e-05|
|Time (SoA)| 2.45e-07| 6.78e-07| 3.74e-06| 1.54e-05|
|Time (SoA split)| 2.49e-07| 7.11e-07| 3.42e-06| 1.03e-05|

* `nele=1024`

| ndim| 1| 3| 10| 30|
|---|---|---|---|---|
|Time (AoS)| 1.35e-06| 4.07e-06| 2.78e-05| 1.11e-04|
|Time (AoS split)| 1.35e-06| 4.15e-06| 1.39e-05| 4.18e-05|
|Time (SoA)| 4.65e-07| 1.99e-06| 1.23e-05| 3.78e-05|
|Time (SoA split)| 4.70e-07| 2.01e-06| 6.96e-06| 2.35e-05|
