nacs-lab/yyc-data/calculations/single-atom/SingleAtom/test/perf/split_copy2.md

* `nele=64`

| ndim| 1| 3| 10| 30| 100| 300|
|---|---|---|---|---|---|---|
|Time (SoA)| 1.31e-08| 4.00e-08| 1.48e-07| 4.67e-07| 2.46e-06| 1.14e-05|
|Time (SoA split)| 1.72e-08| 5.41e-08| 1.61e-07| 4.82e-07| 1.68e-06| 4.70e-06|

* `nele=128`

| ndim| 1| 3| 10| 30| 100| 300|
|---|---|---|---|---|---|---|
|Time (SoA)| 2.34e-08| 7.37e-08| 2.60e-07| 8.38e-07| 3.89e-06| 2.51e-05|
|Time (SoA split)| 2.76e-08| 9.30e-08| 2.99e-07| 8.24e-07| 2.70e-06| 8.00e-06|

* `nele=256`

| ndim| 1| 3| 10| 30| 100| 300|
|---|---|---|---|---|---|---|
|Time (SoA)| 4.95e-08| 1.36e-07| 5.37e-07| 1.88e-06| 9.49e-06| 5.66e-05|
|Time (SoA split)| 5.30e-08| 1.55e-07| 4.88e-07| 1.46e-06| 4.97e-06| 1.59e-05|

* `nele=512`

| ndim| 1| 3| 10| 30| 100| 300|
|---|---|---|---|---|---|---|
|Time (SoA)| 9.39e-08| 2.66e-07| 1.28e-06| 6.67e-06| 4.08e-05| 1.07e-04|
|Time (SoA split)| 9.59e-08| 2.95e-07| 9.80e-07| 2.71e-06| 1.05e-05| 3.27e-05|

* `nele=1024`

| ndim| 1| 3| 10| 30| 100| 300|
|---|---|---|---|---|---|---|
|Time (SoA)| 1.89e-07| 5.52e-07| 6.29e-06| 2.26e-05| 6.48e-05| 2.30e-04|
|Time (SoA split)| 1.91e-07| 5.74e-07| 1.89e-06| 5.85e-06| 1.98e-05| 5.80e-05|
