nacs-lab/yyc-data/calculations/single-atom/SingleAtom/test/perf/soa_copy.md

* `nele=64`

| ndim| 1| 3| 10| 30|
|---|---|---|---|---|
|Time (AoS)| 1.54e-07| 4.12e-07| 1.62e-06| 5.54e-06|
|Time (AoS split)| 1.55e-07| 4.57e-07| 1.54e-06| 4.86e-06|
|Time (SoA)| 6.19e-08| 1.63e-07| 6.33e-07| 2.67e-06|
|Time (SoA split)| 6.81e-08| 1.94e-07| 6.42e-07| 1.95e-06|

* `nele=128`

| ndim| 1| 3| 10| 30|
|---|---|---|---|---|
|Time (AoS)| 3.04e-07| 8.50e-07| 3.42e-06| 1.08e-05|
|Time (AoS split)| 3.07e-07| 9.08e-07| 3.09e-06| 1.03e-05|
|Time (SoA)| 1.15e-07| 3.12e-07| 1.16e-06| 7.14e-06|
|Time (SoA split)| 1.19e-07| 3.42e-07| 1.19e-06| 6.86e-06|

* `nele=256`

| ndim| 1| 3| 10| 30|
|---|---|---|---|---|
|Time (AoS)| 6.17e-07| 1.71e-06| 6.40e-06| 4.14e-05|
|Time (AoS split)| 6.05e-07| 1.84e-06| 6.43e-06| 1.86e-05|
|Time (SoA)| 2.39e-07| 6.13e-07| 3.54e-06| 1.48e-05|
|Time (SoA split)| 2.41e-07| 6.60e-07| 3.44e-06| 1.29e-05|

* `nele=512`

| ndim| 1| 3| 10| 30|
|---|---|---|---|---|
|Time (AoS)| 1.64e-06| 3.40e-06| 2.11e-05| 9.20e-05|
|Time (AoS split)| 1.50e-06| 3.58e-06| 1.27e-05| 3.92e-05|
|Time (SoA)| 4.57e-07| 1.25e-06| 8.62e-06| 3.95e-05|
|Time (SoA split)| 4.72e-07| 1.34e-06| 8.42e-06| 2.63e-05|

* `nele=1024`

| ndim| 1| 3| 10| 30|
|---|---|---|---|---|
|Time (AoS)| 2.49e-06| 6.68e-06| 3.88e-05| 1.81e-04|
|Time (AoS split)| 2.32e-06| 6.92e-06| 2.36e-05| 7.29e-05|
|Time (SoA)| 8.09e-07| 5.36e-06| 2.50e-05| 9.97e-05|
|Time (SoA split)| 8.30e-07| 5.10e-06| 1.86e-05| 6.42e-05|
