nacs-lab/yyc-data/calculations/single-atom/SingleAtom/test/perf/split_copy.md

* `nele=64`

| ndim| 1| 3| 10| 30| 100| 300|
|---|---|---|---|---|---|---|
|Time (SoA)| 2.49e-08| 7.22e-08| 4.06e-07| 1.02e-06| 5.00e-06| 2.02e-05|
|Time (SoA split)| 3.18e-08| 1.05e-07| 3.26e-07| 9.09e-07| 3.02e-06| 8.57e-06|

* `nele=128`

| ndim| 1| 3| 10| 30| 100| 300|
|---|---|---|---|---|---|---|
|Time (SoA)| 4.44e-08| 1.25e-07| 7.66e-07| 1.89e-06| 1.11e-05| 5.39e-05|
|Time (SoA split)| 5.02e-08| 1.60e-07| 6.01e-07| 1.58e-06| 4.98e-06| 1.70e-05|

* `nele=256`

| ndim| 1| 3| 10| 30| 100| 300|
|---|---|---|---|---|---|---|
|Time (SoA)| 8.82e-08| 2.86e-07| 1.31e-06| 3.70e-06| 2.17e-05| 7.84e-05|
|Time (SoA split)| 9.49e-08| 3.06e-07| 9.22e-07| 2.73e-06| 1.09e-05| 3.17e-05|

* `nele=512`

| ndim| 1| 3| 10| 30| 100| 300|
|---|---|---|---|---|---|---|
|Time (SoA)| 1.79e-07| 5.38e-07| 2.73e-06| 1.32e-05| 7.50e-05| 2.18e-04|
|Time (SoA split)| 1.88e-07| 6.76e-07| 1.96e-06| 6.02e-06| 2.13e-05| 9.21e-05|

* `nele=1024`

| ndim| 1| 3| 10| 30| 100| 300|
|---|---|---|---|---|---|---|
|Time (SoA)| 3.86e-07| 1.63e-06| 1.22e-05| 6.16e-05| 1.83e-04| 6.35e-04|
|Time (SoA split)| 4.06e-07| 1.29e-06| 4.15e-06| 1.87e-05| 4.50e-05| 1.47e-04|
