nacs-lab/yyc-data/experiments/diabatic_lowering/fit_model.pdf

## 1 Classical model

### 1.1 Energy distribution

Maxwell-Boltzmann distribution in a 3D harmonic trap. Let ε = βE

PDF: (https://en.wikipedia.org/wiki/Gas_in_a_harmonic_trap#Massive_Maxwell.E2.80.93Boltzmann_particles) p(ε)dε =

ε

2
2

e

−εdε

CDF (integrating PDF): cdf(ε) = 1 −

1 + ε +

ε

2
2
e

−ε

### 1.2 Model of diabatic lowering

When the lowering is fast (diabatic) enough, assume the wavefunction (motion) of the particle doesn’t change. Based on the virial theorem, half of the energy is potiential energy, which is lowered by the lowering factor, and the other half is kinetic energy, which does not change right after lowering so the final energy of the particle with initial energy E is E⁰ =

γ + 1
2

E, where γ is
the lowering factor.

### 1.3 Model of survival

Assume that the atom will leave the trap if its final energy is higher than the final trap depth.

### 1.4 The full experimental sequence

The atom starts in the trap with trap depth Etrap and initial energy E0.
The trap depth is first ramped adabatically by a factor of α (to αEtrap) (α = 1 if this step is skipped). The energy of the atom is √
αE0 due to adabatic compression. The trap depth is then diabatically lowered to γEtrap, the total energy of the atom is now α + γ
2

√
α

E0.

The atom will stay in the trap if

α + γ
2

√
α

E0 < γEtrap

or

ε0 <

2γ

√
α
α + γ

εtrap

where ε0 and εtrap are the initial energy of the atom and the initial trap depth measured in unit of the initial temperature.
Therefore the total survival probability is,

p0cdf
2γ

√
α
(α + γ)τ

where p0 models the overall survival probability and τ = ε

−1
trap is the temperature measured in trap depth.

## 2 Alternative classical model

Consider the survival probability in 1D and cube it to approximate the 3d survival probability. This is likely less accurate and might overestimate the energy since it increases the escape condition from energy larger than trap depth to energy in at least one axis larger than trap depth.

### 2.1 Energy distribution

Maxwell-Boltzmann distribution in a 1D harmonic trap.
Let ε = βE, where E in the degrees of freedoms in this dimension. PDF: p(ε)dε = e⁻εdε
CDF (integrating PDF): cdf(ε) = 1 − e

−ε

### 2.2 The full experimental sequence

The atom starts in the trap with 1D trap depth Etrap and initial 1D energy E0.
The 1D trap depth is then diabatically lowered to γEtrap, the 1D energy of the atom is now 1 + γ 2

E0.
The atom will stay in the trap in this dimension if

1 + γ
2

E0 < γEtrap

or

ε0 <

2γ
1 + γ

εtrap

where ε0 and εtrap are the initial 1D energy of the atom and the initial 1D trap depth measured in unit of the initial temperature.
Therefore the total survival probability is,

p0cdf
2γ
(1 + γ)τ

3

where p0 models the overall survival probability and τ = ε

−1
trap is the temperature measured in 1D trap depth.

## 3 A more quantum model

The classical models above ignores the fact that the state after the lowering does not have to be either trapped or not but it can have non-zero overlap with both the trapped and untrapped state. We can get a slightly better model using the coherent states of the initial and the final trap and calculate the survival rate using the overlap between the states.

### 3.1 Density matrix

The density matrix of the initial state is

ρ =

1 − e

−ε

X

n

|nie

−nεhn|

where ε ≡ ~ωβ.
We need to express this in the basis of coherent states. Since the coherent states form an overcom-plete basis, there are multiple ways to express this. We can assume that the expression takes the form,

ρ =

ˆ
|αif(|α|)hα|d

2α i.e. there’s only diagonal term. Multiply this by the eigen vectors of H,

hm|ρ|ni =

ˆ
hm|αif(|α|)hα|nid

2α

=

ˆ
e

−|α|

2 α

m
√
m!

f(|α|)

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
−|α|

2 |α|

m+n
e

i(m−n)θ
√
m!n!

f(|α|)|α|dθd|α|

=πδmn ˆ
e

−|α|

2 |α|

2n

n!

f(|α|)d|α|

2

Compare to the expression in energy basis

hm|ρ|ni =δ

mn
1 − e

−ε
e

−nε

1 − e

−ε
e

−nε =π

ˆ
e

−|α|

2 |α|

2n

n!

f(|α|)d|α|

2

Take a guess that f(|α|) = c1e

c2|α|

2
and do the integral, we can get

f(|α|) =e

ε − 1
π

exp
−|α|

2

(eε − 1)

### 3.2 Squeezed state

The new coherent states in the final potential are squeezed states in the original trap. The squeeze factor can be obtained from

e

−2r =

ω0
ω⁰

r = −

1
2

ln ω0
ω⁰

where ω

0
is the final trapping frequency. The new ground state is,

|0i

0 =S(r)|0i

where S ≡ exp r
2
a

2 − a

†

2

is the squeeze operator. The new coherent state with amplitude α
0

is

|α

0
i

0 =S(r)|α

0
i
=S(r)D(α

0
)|0i
=S(r) exp
α

0
a

† − α

0∗a
|0i
=S(r) exp
α

0
a

† − α

0∗a
S

†
(r)S(r)|0i
= exp
α

0

cosh ra† + sinh ra
− α

0∗

cosh ra + sinh ra†
S(r)|0i

= exp
(α

0
cosh r − α

0∗ sinh r)a

† − (α

0∗ cosh r − α

0
sinh r)a
S(r)|0i
=D(α

0
cosh r − α

0∗ sinh r)S(r)|0i

The overlap between this state and a coherent state is

hα|α

0
i

0 =h0|D(−α)D(α

0
cosh r − α

0∗ sinh r)S(r)|0i

=h0|D(−α + α

cosh r − α

0∗ sinh r)S(r)|0i

Let α

00 ≡ α − α

0
cosh r + α

0∗ sinh r

hα|α

0
i

0 =h0|D(−α

00)S(r)|0i

=e⁻|α

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
cosh r

X

m

(−1)mp
(2m)!
2mm!

tanhm r|2mi

=

e

−|α

00|

2
/2
√
cosh r

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
tanh r

n

=

1
√
cosh r

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
tanh r

!

### 3.3 Survival

The survival after lowering in this model for a threshold γ

p =

1
π

Tr ˆ

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
ε − 1
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
−|α|

2

(eε − 1)
|hα|α

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
ε − 1
π

2 cosh r

ˆ
d

2α

ˆ

|α⁰
|6γ

exp
−|α|

2

(eε − 1)

exp
−|α

00|

2 − α
002
tanh r

d

2α

0

=

e

ε − 1
π

2 cosh r

ˆ
d

2α

ˆ

|α⁰
|6γ

exp
−|α|

2

(eε − 1)

exp
−|α

00|

2 − <
α

002
tanh r

d

2α

0

Let the real and imaginary part of α, α

0 and α

00 be α = αr + iαi
, α

0 = α

0
r + iα

0
i

, α

00 = α

00
r + iα

00
i

α

00 =α − α

0
cosh r + α

0∗ sinh r

=αr + iαi − α

0
r

cosh r + α

0
r

sinh r − iα

0
i

cosh r − iα

0
i

sinh r
=αr − α

0
r

cosh r + α

0
r

sinh r + i(αi − α

0
i

cosh r − α

0
i

sinh r)
α

00
r =αr − α

0
r

cosh r(1 − tanh r)
α

00
i =αi − α

0
i

cosh r(1 + tanh r)

p =

e

ε − 1
π

2 cosh r

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
r + α

2
i

(eε − 1)

exp
−
α

00
r

2 + α
00
i

2

−
α

00
r

2 − α
00
i

2

tanh r

=

e

ε − 1
π

2 cosh r

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
(eε − 1) − α

00
r

2
(1 + tanh r)

exp
−α

2
i

(eε − 1) − α

00
i

2
(1 − tanh r)

α

00
r

2 =(αr − α
0
r

cosh r(1 − tanh r))²

=α

2
r + α

0
r

2
cosh²
r(1 − tanh r)

2 − 2αrα
0
r

cosh r(1 − tanh r)

α

00
r

2
(1 + tanh r) =α

2
r

(1 + tanh r) + α

0
r

2
cosh²
r(1 − tanh r)

1 − tanh²
r
− 2αrα

0
r

cosh r

1 − tanh²
r

=α
r

(1 + tanh r) + α
r

(1 − tanh r) −

2αrα

0
r
cosh r

α

00
i

2 =(αi − α
0
i

cosh r(1 + tanh r))²

=α

2
i + α

0
i

2
cosh²
r(1 + tanh r)

2 − 2αiα
0
i

cosh r(1 + tanh r)

α

00
i

2
(1 − tanh r) =α

2
i

(1 − tanh r) + α

0
i

2
cosh²
r(1 + tanh r)

1 − tanh²
r
− 2αiα

0
i

cosh r

1 − tanh²
r

=α

2
i

(1 − tanh r) + α

0
i

2
(1 + tanh r) −

2αiα

0
i
cosh r

p =

e

ε − 1
π

2 cosh r

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
(eε + tanh r) + 2αrα

0
r
cosh r

− α

0
r

2
(1 − tanh r)

exp
−α

2
i

(eε − tanh r) + 2αiα

0
i
cosh r

− α

0
i

2
(1 + tanh r)

=

e

ε − 1
π

2 cosh r

r π
e

ε + tanh r

r π
e

ε − tanh r

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
(eε + tanh r) cosh²
r

− α

0
r

2
(1 − tanh r)

!

exp

α

0
i

2
(eε − tanh r) cosh²
r

− α

0
i

2
(1 + tanh r)

!

=

e

ε − 1

π cosh r

p
e

2ε − tanh²
r

ˆ

α⁰
i

2+α⁰
r

26γ²

dα

0
rdα

0
i

exp
(1 − tanh r)(1 − e

ε
)
e

ε + tanh r

α

0
r

2

exp
(1 + tanh r)(1 − e

ε
)
e

ε − tanh r

α

0
i

2

=

1

π cosh r

p
e

2ε − tanh²
r

ˆ

x²+y²6(eε−1)γ²

dα

0
rdα

0
i

exp
−

(1 − tanh r)
e

ε + tanh r

x

2

exp
−

(1 + tanh r)
e

ε − tanh r

y

2
