nacs-lab/yyc-data/experiments/nacs_atoms/imgs/single_gray.pdf

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

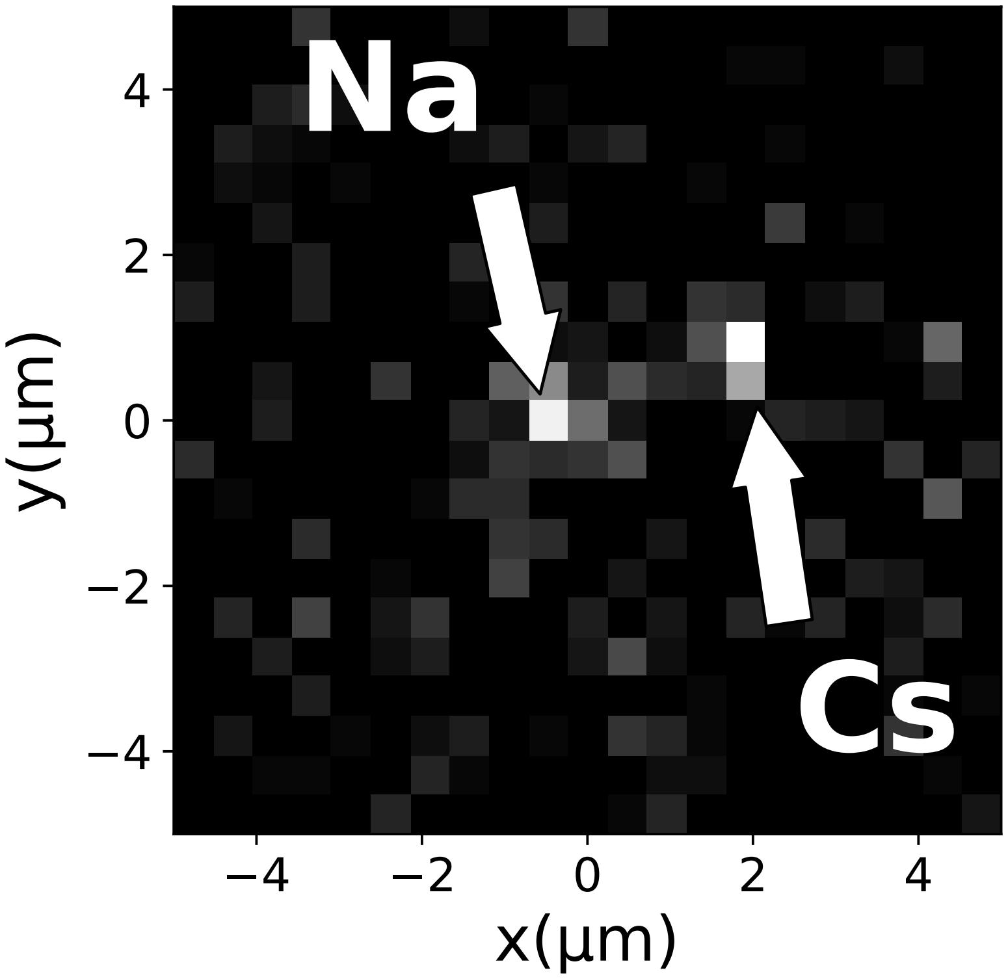
[picture p164: page 1]
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
