nacs-lab/yyc-data/experiments/nacs_atoms/imgs/single_viridis.pdf

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

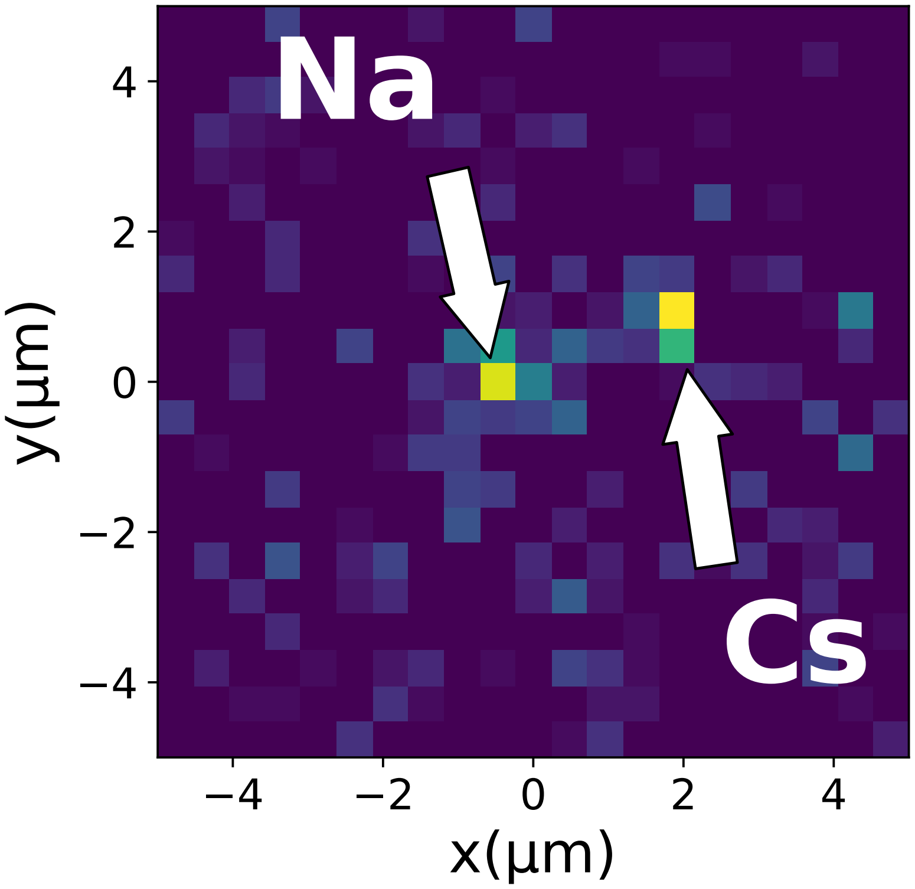
[picture p165: page 1]
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
