nacs-lab/yyc-data/experiments/nacs_201810/imgs/fit_20181103_raman_n2_p0.pdf

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

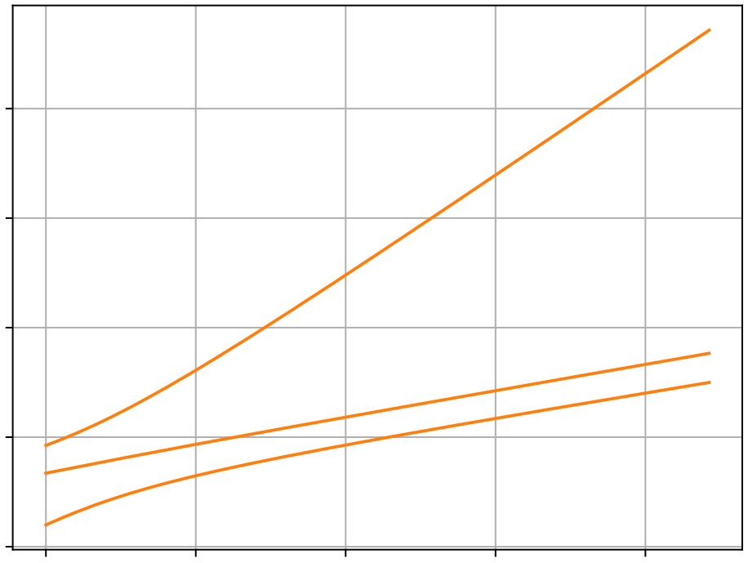
[picture p166: figure]
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
