nacs-lab/yyc-data/experiments/nacs_201908/imgs/data_201908_pa_res_gamma.pdf

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

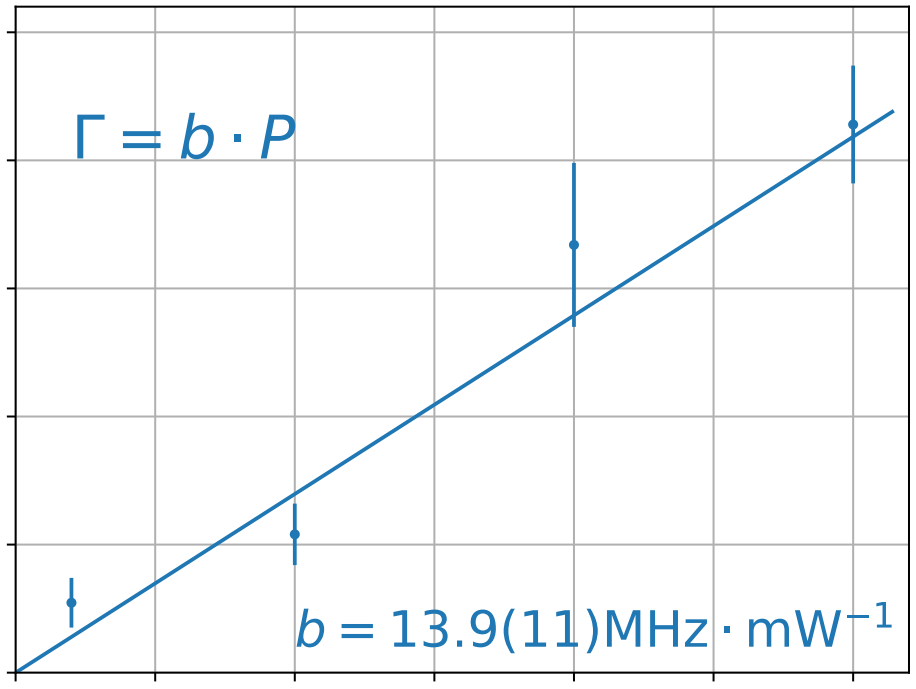
[picture p168: figure]
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
