nacs-lab/yyc-data/experiments/SAS/F0000CH1.CSV

Record Length | 2.500000e+03 | -0.012500000000 | -0.11200
Sample Interval | 1.000000e-05 | -0.012490000000 | -0.11400
Trigger Point | 1.250000000000e+03 | -0.012480000000 | -0.10600
 |  | -0.012470000000 | -0.10400
 |  | -0.012460000000 | -0.09200
 |  | -0.012450000000 | -0.08400
Source | CH1 | -0.012440000000 | -0.07800
Vertical Units | V | -0.012430000000 | -0.06600
Vertical Scale | 5.000000e-02 | -0.012420000000 | -0.06200
Vertical Offset | -6.000000e-02 | -0.012410000000 | -0.05400
Horizontal Units | s | -0.012400000000 | -0.04800
Horizontal Scale | 2.500000e-03 | -0.012390000000 | -0.04600
Pt Fmt | Y | -0.012380000000 | -0.04200
Yzero | 0.000000e+00 | -0.012370000000 | -0.04000
Probe Atten | 1.000000e+00 | -0.012360000000 | -0.03800
Model Number | TBS1032B | -0.012350000000 | -0.03600
Serial Number | C010693 | -0.012340000000 | -0.03600
Firmware Version | FV:v4.06 | -0.012330000000 | -0.03400
 |  | -00.012320000000 | -0.03400
 |  | -00.012310000000 | -0.03200
 |  | -00.012300000000 | -0.03400
 |  | -00.012290000000 | -0.03000
 |  | -00.012280000000 | -0.03200
 |  | -00.012270000000 | -0.03200
 |  | -00.012260000000 | -0.03200
 |  | -00.012250000000 | -0.03400
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
