nacs-lab/yyc-data/experiments/SAS/F0000CH2.CSV

Record Length | 2.500000e+03 | -0.012500000000 | -0.05200
Sample Interval | 1.000000e-05 | -0.012490000000 | -0.05120
Trigger Point | 1.250000000000e+03 | -0.012480000000 | -0.05040
 |  | -0.012470000000 | -0.04960
 |  | -0.012460000000 | -0.04960
 |  | -0.012450000000 | -0.04880
Source | CH2 | -0.012440000000 | -0.04800
Vertical Units | V | -0.012430000000 | -0.04880
Vertical Scale | 2.000000e-02 | -0.012420000000 | -0.04880
Vertical Offset | 5.280000e-02 | -0.012410000000 | -0.04880
Horizontal Units | s | -0.012400000000 | -0.04960
Horizontal Scale | 2.500000e-03 | -0.012390000000 | -0.04960
Pt Fmt | Y | -0.012380000000 | -0.04880
Yzero | 0.000000e+00 | -0.012370000000 | -0.04960
Probe Atten | 1.000000e+00 | -0.012360000000 | -0.04800
Model Number | TBS1032B | -0.012350000000 | -0.04800
Serial Number | C010693 | -0.012340000000 | -0.04720
Firmware Version | FV:v4.06 | -0.012330000000 | -0.04640
 |  | -00.012320000000 | -0.04400
 |  | -00.012310000000 | -0.04400
 |  | -00.012300000000 | -0.04320
 |  | -00.012290000000 | -0.04160
 |  | -00.012280000000 | -0.04000
 |  | -00.012270000000 | -0.03840
 |  | -00.012260000000 | -0.03760
 |  | -00.012250000000 | -0.03600
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
