nacs-lab/yyc-data/experiments/diabatic_lowering/dc_0.05/data_20160223_201552.csv

Parameter | Image1 | Image2 | Image3
0.025 | 176 | 80 | 11
0.032 | 176 | 70 | 26
0.037 | 176 | 76 | 31
0.044 | 176 | 74 | 47
0.047 | 176 | 55 | 29
0.05 | 176 | 70 | 38
