nacs-lab/yyc-data/experiments/diabatic_lowering/dc_0.12/data_20160223_125309.csv

Parameter | Image1 | Image2 | Image3
0.011 | 126 | 58 | 0
0.0215 | 126 | 59 | 0
0.04 | 126 | 54 | 9
0.06 | 126 | 49 | 22
0.08 | 126 | 55 | 34
0.12 | 126 | 58 | 37
