nacs-lab/yyc-data/experiments/diabatic_lowering/dc_0.12/data_20160223_132816.csv

Parameter | Image1 | Image2 | Image3
0.011 | 174 | 85 | 0
0.0215 | 174 | 72 | 1
0.04 | 174 | 84 | 27
0.06 | 174 | 77 | 41
0.08 | 174 | 88 | 61
0.12 | 174 | 82 | 65
