nacs-lab/yyc-data/experiments/diabatic_lowering/dc_0.12/data_20160223_154907.csv

Parameter | Image1 | Image2 | Image3
0.04 | 188 | 80 | 16
0.05 | 188 | 79 | 28
0.06 | 188 | 94 | 45
0.065 | 188 | 79 | 54
0.07 | 188 | 79 | 45
0.075 | 188 | 78 | 41
0.08 | 188 | 71 | 50
0.12 | 188 | 81 | 56
