nacs-lab/yyc-data/calculations/single-atom/results/imaging_line/gamma_5_13.csv

1.0 | -10.0 | 0.32 | 41.898224 | 5.695996 | 0.0009999995 | 1.597546e-7 | 0.0 | 0.0
1.0 | -5.0 | 0.32 | 23.490873 | 3.4164531 | 0.0009999995 | 1.597546e-7 | 0.0 | 0.0
1.0 | -2.5 | 0.32 | 17.838326 | 2.7318301 | 0.0009999995 | 1.597546e-7 | 0.0 | 0.0
1.0 | -2.1875 | 0.32 | 18.791916 | 2.1852086 | 0.0009999995 | 1.597546e-7 | 0.0 | 0.0
1.0 | -1.875 | 0.32 | 25.36351 | 3.7326138 | 0.0009999995 | 1.597546e-7 | 0.0 | 0.0
1.0 | -1.5625 | 0.32 | 22.198689 | 3.0395174 | 0.0009999995 | 1.597546e-7 | 0.0 | 0.0
1.0 | -1.25 | 0.32 | 31.29834 | 5.0127883 | 0.0009999995 | 1.597546e-7 | 0.0 | 0.0
1.0 | 0.0 | 0.32 | 665.57086 | 66.515335 | 0.0009999995 | 1.597546e-7 | 0.0 | 0.0
1.0 | 5.0 | 0.32 | 1977.9637 | 16.348251 | 0.0009999995 | 1.597546e-7 | 0.0 | 0.0
1.0 | 10.0 | 0.32 | 1248.5364 | 64.790085 | 0.0009999995 | 1.597546e-7 | 0.0 | 0.0
0.6 | -20.0 | 0.32 | 269.088 | 39.795746 | 0.0009999995 | 1.597546e-7 | 0.0 | 0.0
0.6 | -15.0 | 0.32 | 353.8881 | 58.822926 | 0.0009999995 | 1.597546e-7 | 0.0 | 0.0
0.6 | -10.0 | 0.32 | 262.5571 | 54.971886 | 0.0009999995 | 1.597546e-7 | 0.0 | 0.0
0.6 | -5.0 | 0.32 | 257.59363 | 55.816216 | 0.0009999995 | 1.597546e-7 | 0.0 | 0.0
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
