nacs-lab/yyc-data/experiments/combined/imgs/20170222/op_time.png

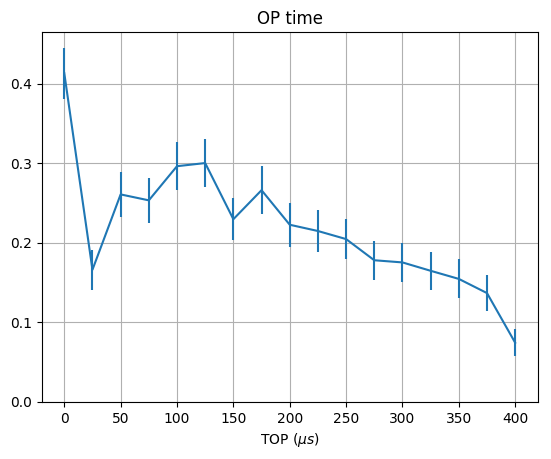
experiments/combined/imgs/20170222/op_time.png
