nacs-lab/yyc-data/experiments/cs_coprop_201712/imgs/data_20171226_50_mf4_hi.png

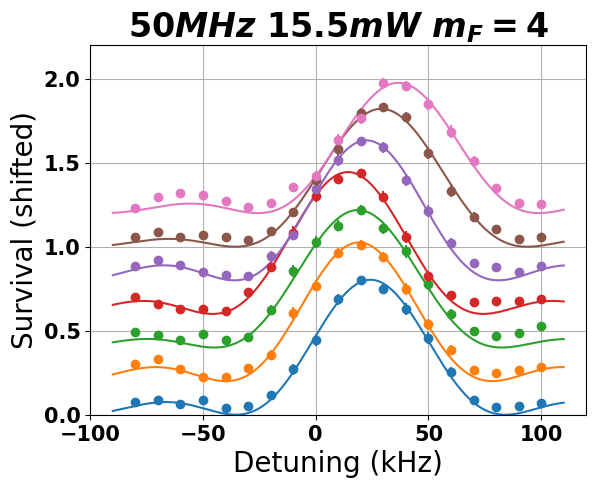
experiments/cs_coprop_201712/imgs/data_20171226_50_mf4_hi.png
