nacs-lab/yyc-data/experiments/cs_coprop_201712/imgs/data_20171226_62_mf4_lo.png

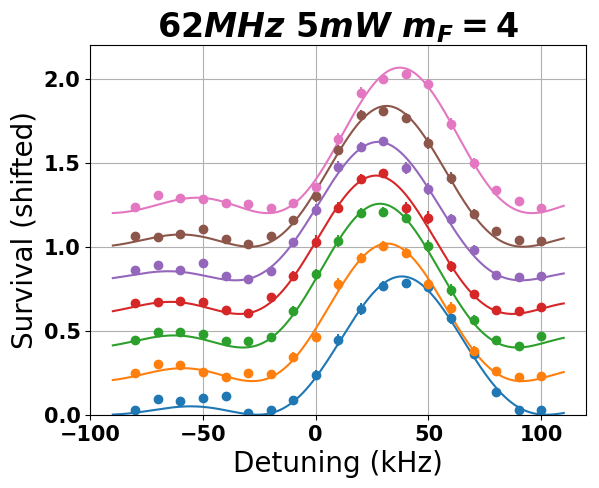
experiments/cs_coprop_201712/imgs/data_20171226_62_mf4_lo.png
