nacs-lab/yyc-data/experiments/cs_coprop_201712/imgs/data_20171226_zeeman_shifts.png

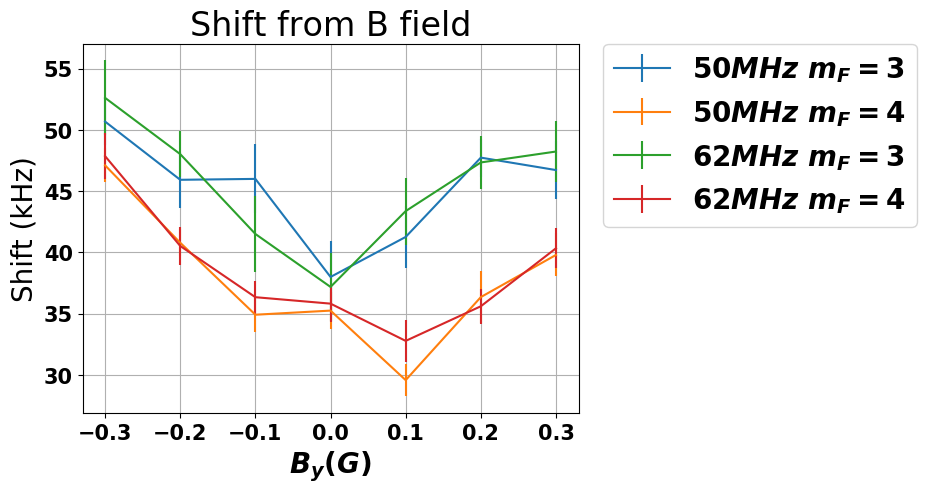
experiments/cs_coprop_201712/imgs/data_20171226_zeeman_shifts.png
