nacs-lab/yyc-data/experiments/cs_coprop_201712/imgs/data_20171227_50_mf3_hi.png

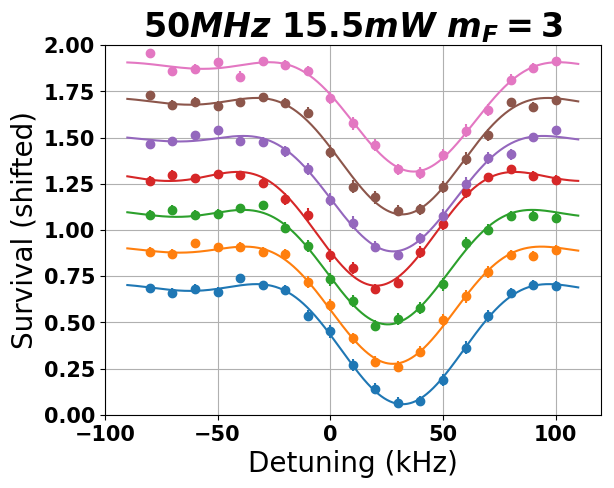
experiments/cs_coprop_201712/imgs/data_20171227_50_mf3_hi.png
