nacs-lab/yyc-data/experiments/cs_coprop_201712/imgs/data_20171228_62_mf3.png

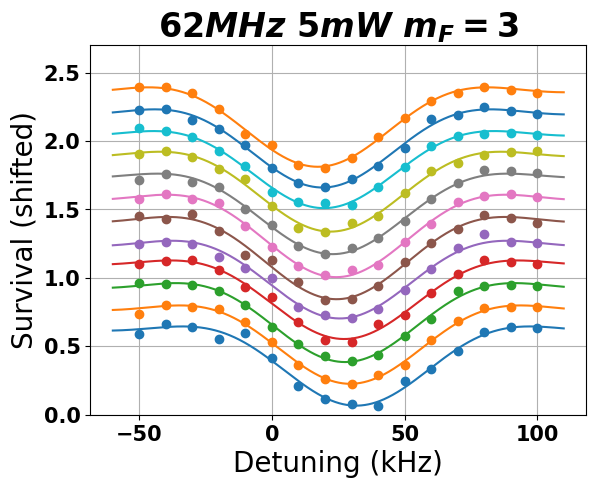
experiments/cs_coprop_201712/imgs/data_20171228_62_mf3.png
