nacs-lab/yyc-data/experiments/cs_coprop_201712/imgs/data_20171229_62_mf4.png

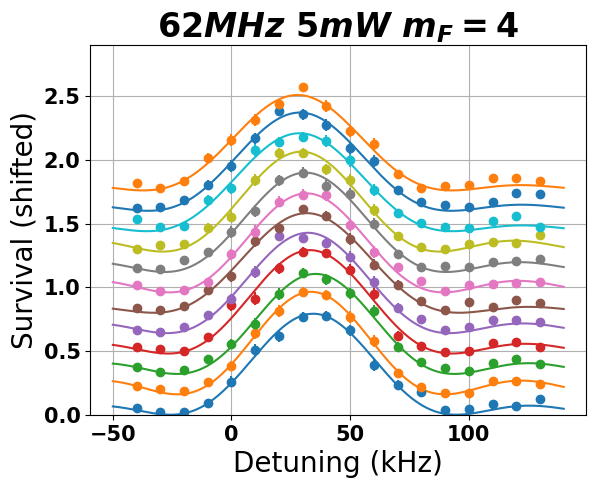
experiments/cs_coprop_201712/imgs/data_20171229_62_mf4.png
