nacs-lab/yyc-data/experiments/cs_coprop_201712/imgs/data_20171229_resonance.png

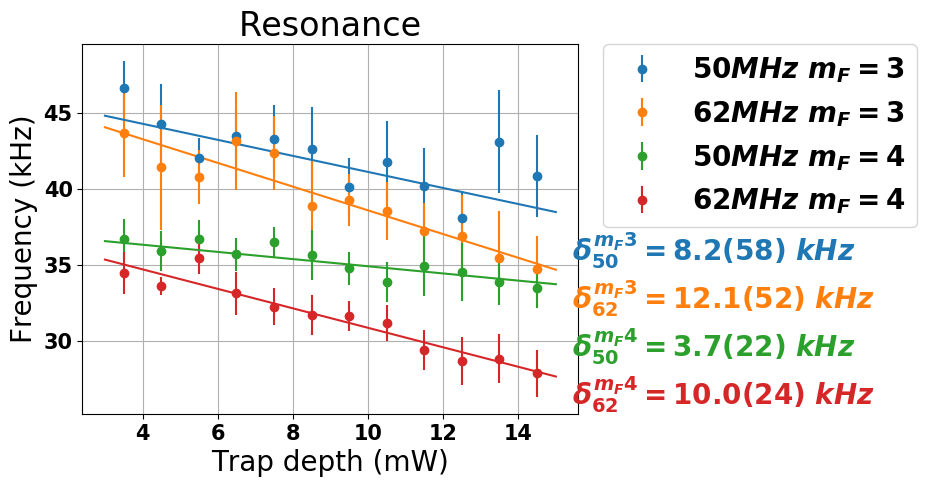
experiments/cs_coprop_201712/imgs/data_20171229_resonance.png
