nacs-lab/yyc-data/experiments/cs_coprop_201712/imgs/data_20180103_50_mf4.png

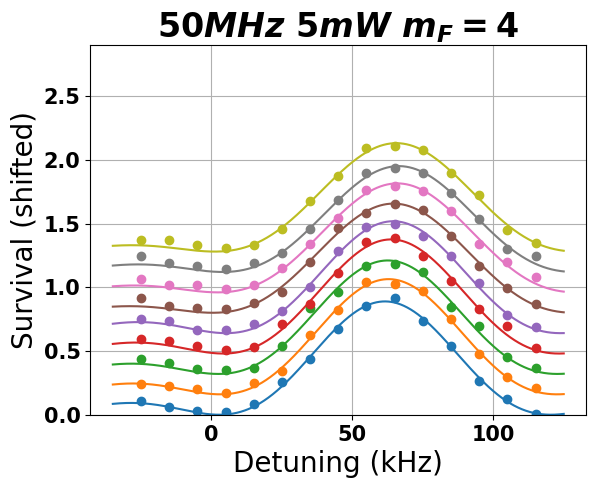
experiments/cs_coprop_201712/imgs/data_20180103_50_mf4.png
