nacs-lab/yyc-data/experiments/cs_rsc_201710/imgs/data_20171015_001620_3d_az.png

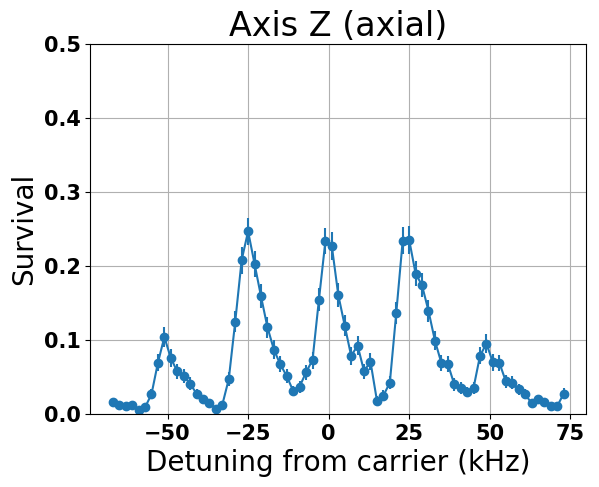
experiments/cs_rsc_201710/imgs/data_20171015_001620_3d_az.png
