nacs-lab/yyc-data/experiments/cs_rsc_201710/imgs/data_20171015_114035_3d-time_az.png

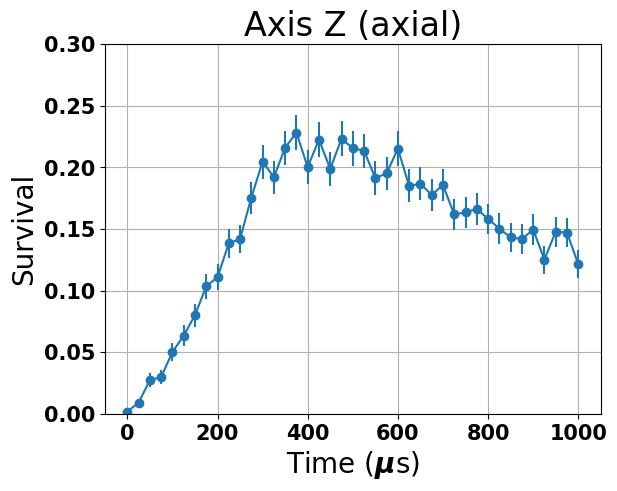
experiments/cs_rsc_201710/imgs/data_20171015_114035_3d-time_az.png
