nacs-lab/yyc-data/experiments/cs_rsc_201710/imgs/data_20171016_003707_3d_az.png

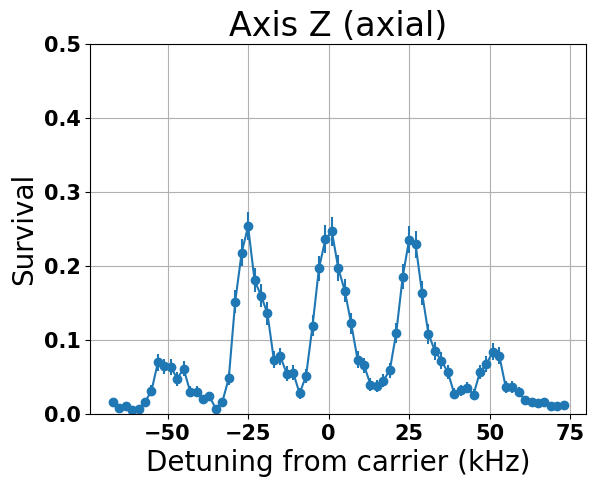
experiments/cs_rsc_201710/imgs/data_20171016_003707_3d_az.png
