nacs-lab/yyc-data/experiments/cs_rsc_201710/imgs/data_20171016_182638_3d-cool_az.png

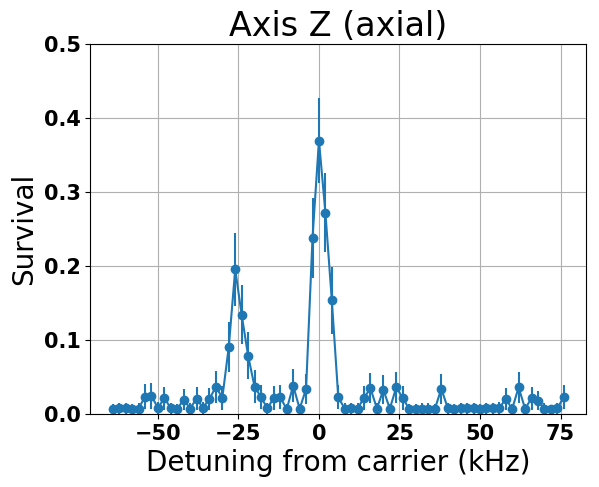
experiments/cs_rsc_201710/imgs/data_20171016_182638_3d-cool_az.png
