nacs-lab/yyc-data/experiments/cs_rsc_201710/imgs/data_20171017_104224_3d-cool_ry.png

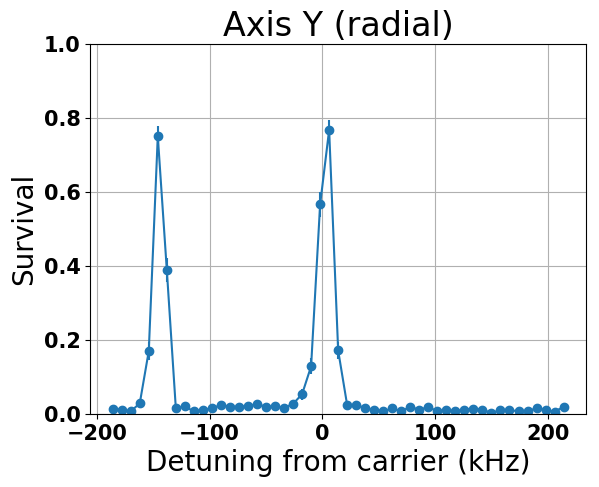
experiments/cs_rsc_201710/imgs/data_20171017_104224_3d-cool_ry.png
