nacs-lab/yyc-data/experiments/cs_rsc_201710/imgs/data_20171018_004853_3d-cool-time_rxp1.png

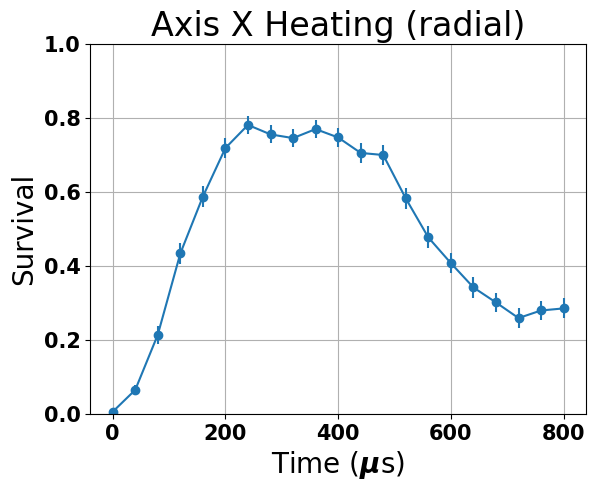
experiments/cs_rsc_201710/imgs/data_20171018_004853_3d-cool-time_rxp1.png
