nacs-lab/yyc-data/experiments/cs_rsc_201712/imgs/data_20171223_x62.png

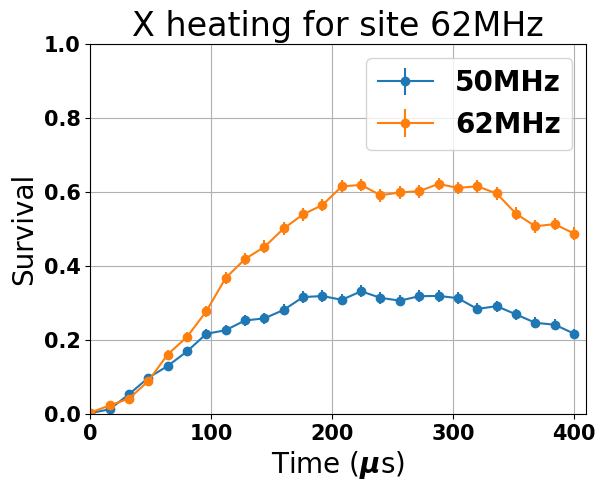
experiments/cs_rsc_201712/imgs/data_20171223_x62.png
