nacs-lab/yyc-data/experiments/cs_rsc_201712/imgs/data_20171223_z50.png

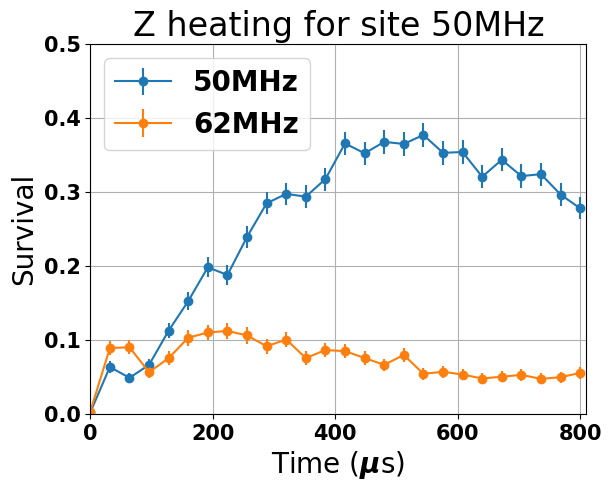
experiments/cs_rsc_201712/imgs/data_20171223_z50.png
