nacs-lab/yyc-data/experiments/cs_rsc_201712/imgs/data_20171225_y.png

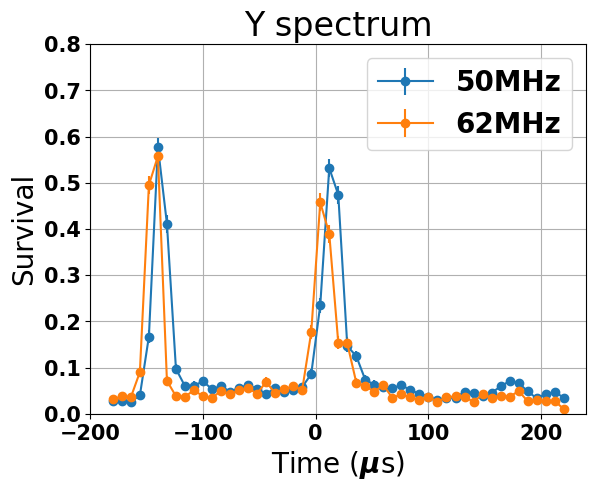
experiments/cs_rsc_201712/imgs/data_20171225_y.png
