nacs-lab/yyc-data/experiments/cs_rsc_201712/imgs/data_20180101_x.png

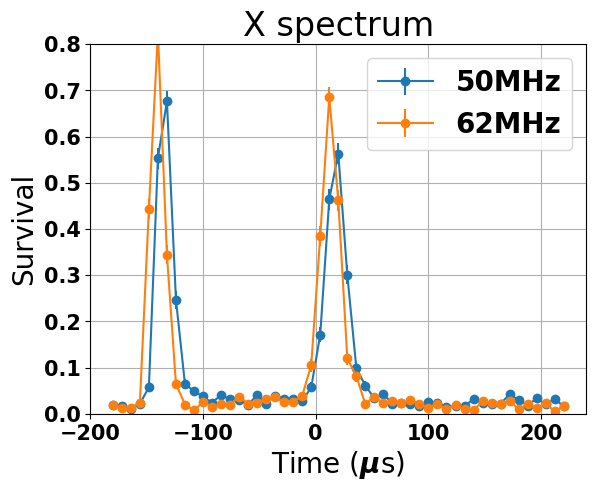
experiments/cs_rsc_201712/imgs/data_20180101_x.png
