nacs-lab/yyc-data/experiments/cs_scatter_and_shift_201802/imgs/data_20180206_183900_trap_scatter_46_sim_loss.png

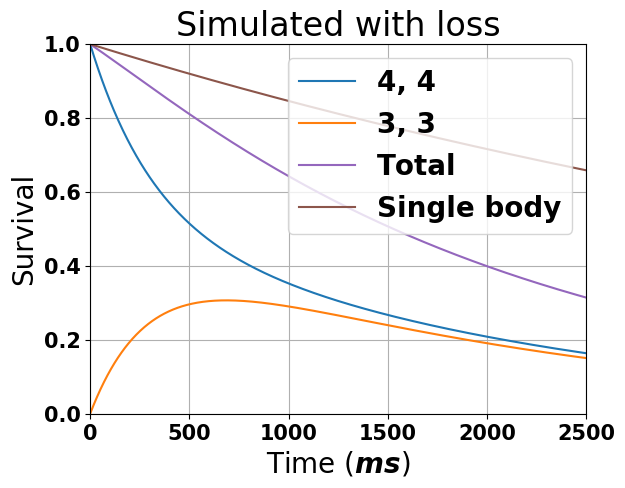
experiments/cs_scatter_and_shift_201802/imgs/data_20180206_183900_trap_scatter_46_sim_loss.png
