nacs-lab/yyc-data/experiments/cs_scatter_and_shift_201802/imgs/data_20180206_trap_scatter_sim.png

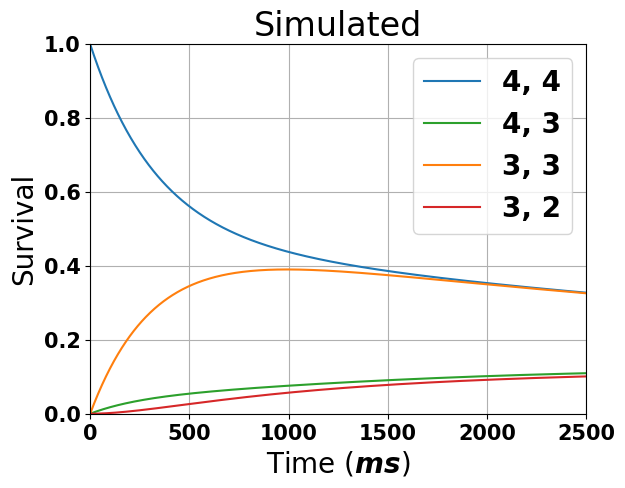
experiments/cs_scatter_and_shift_201802/imgs/data_20180206_trap_scatter_sim.png
