nacs-lab/yyc-data/experiments/cs_scatter_and_shift_201802/imgs/data_20180208_194456_trap_pa_scatter_ratio.png

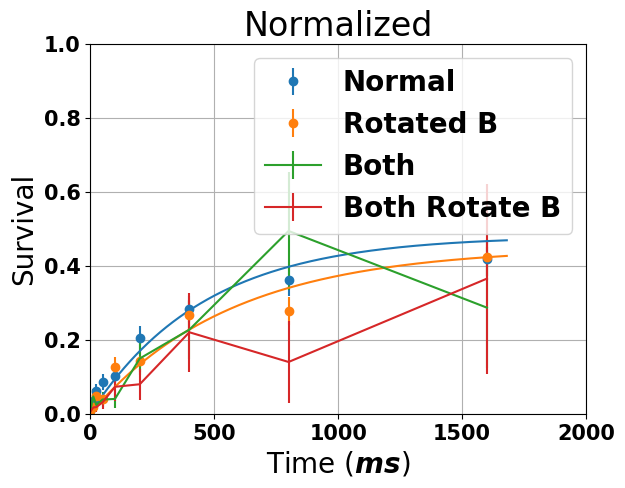
experiments/cs_scatter_and_shift_201802/imgs/data_20180208_194456_trap_pa_scatter_ratio.png
