nacs-lab/yyc-data/experiments/cs_scatter_and_shift_201802/imgs/data_20180308_223544_2body_single_noop.png

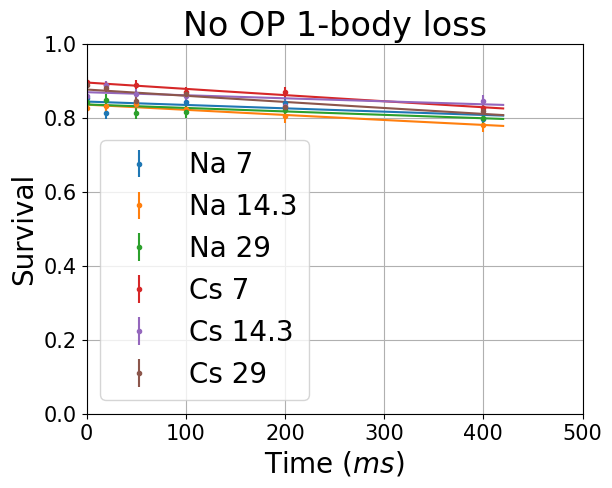
experiments/cs_scatter_and_shift_201802/imgs/data_20180308_223544_2body_single_noop.png
