nacs-lab/yyc-data/experiments/diff-sideband/img/Ax2.png

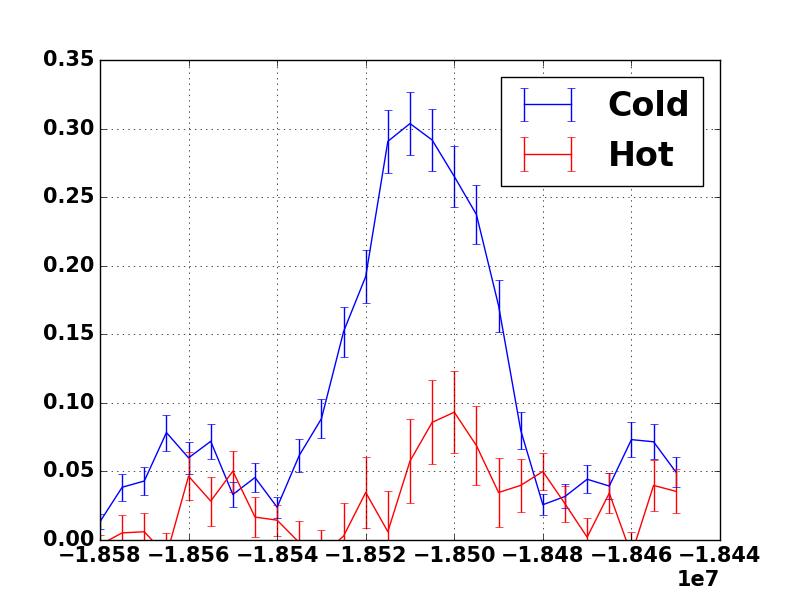
experiments/diff-sideband/img/Ax2.png
