nacs-lab/yyc-data/experiments/diff-sideband/img/Ax13.png

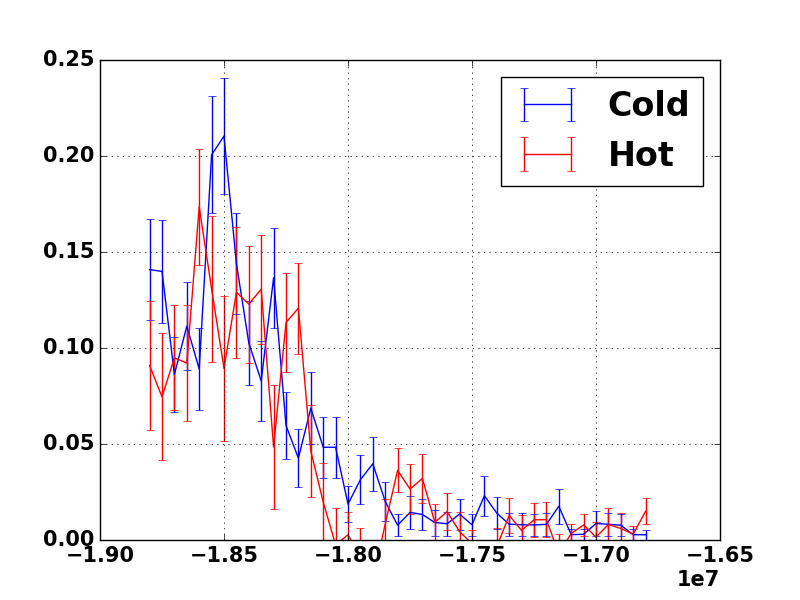
experiments/diff-sideband/img/Ax13.png
