nacs-lab/yyc-data/experiments/misc/imgs/data_20170313_220435_r2_carrier.png

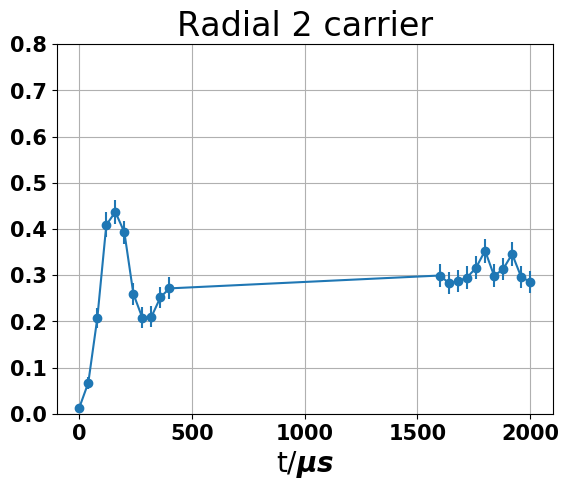
experiments/misc/imgs/data_20170313_220435_r2_carrier.png
