nacs-lab/yyc-data/experiments/misc/imgs/data_20170313_220435_r3_+-1.png

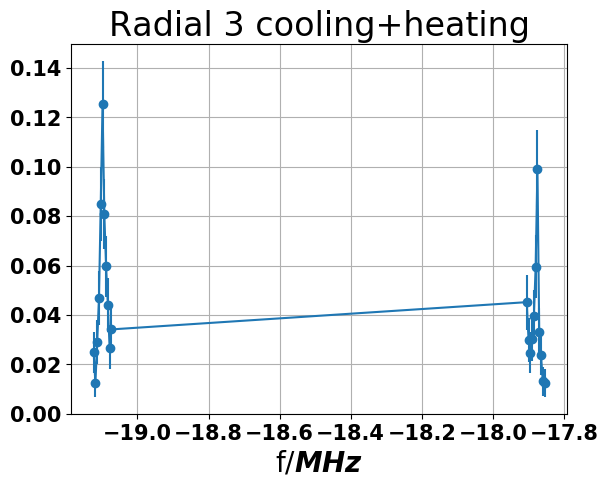
experiments/misc/imgs/data_20170313_220435_r3_+-1.png
