nacs-lab/yyc-data/experiments/misc/imgs/data_20170319_091159_r2.png

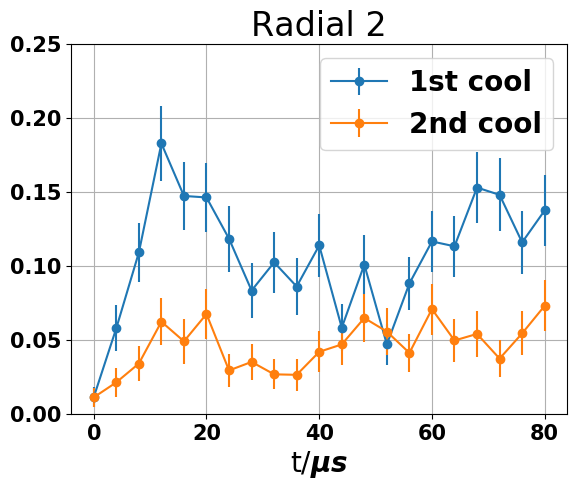
experiments/misc/imgs/data_20170319_091159_r2.png
