nacs-lab/yyc-data/experiments/misc/imgs/data_20170320_223047_a1_-12n.png

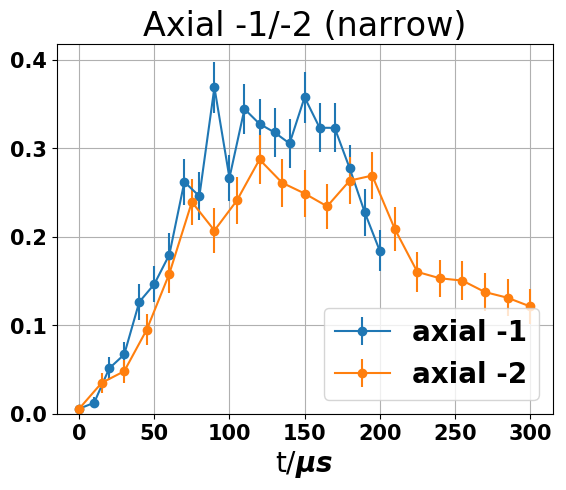
experiments/misc/imgs/data_20170320_223047_a1_-12n.png
