nacs-lab/yyc-data/experiments/misc/imgs/data_20170321_084241.png

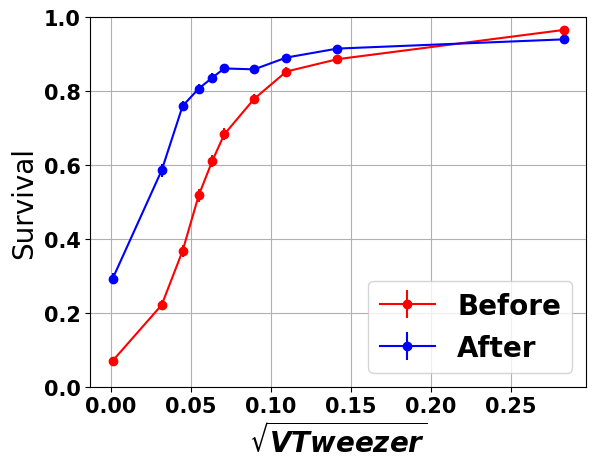
experiments/misc/imgs/data_20170321_084241.png
