nacs-lab/yyc-data/experiments/misc/imgs/data_20170324_010638_a1.png

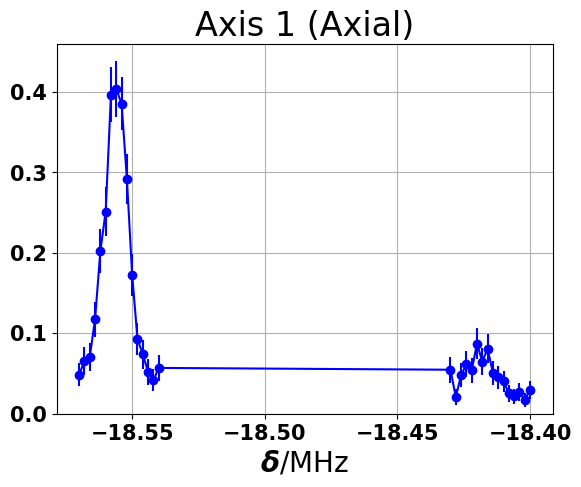
experiments/misc/imgs/data_20170324_010638_a1.png
