nacs-lab/yyc-data/experiments/misc/imgs/data_20170324_010638_r3.png

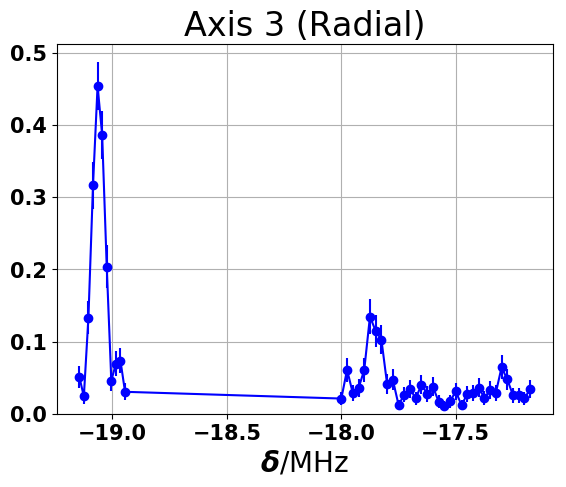
experiments/misc/imgs/data_20170324_010638_r3.png
