nacs-lab/yyc-data/experiments/misc/imgs/data_20170327_235057_a1_+1t.png

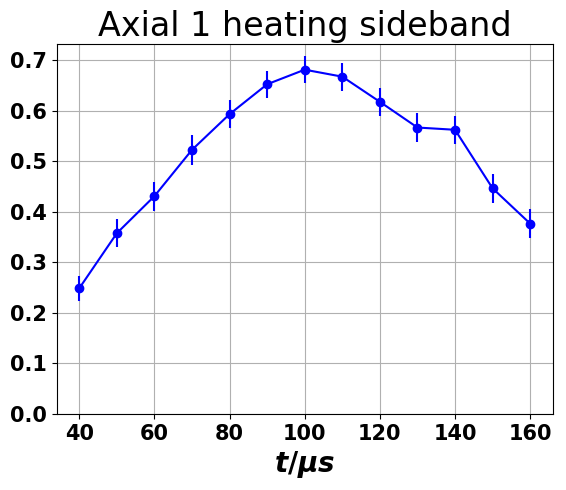
experiments/misc/imgs/data_20170327_235057_a1_+1t.png
