nacs-lab/yyc-data/experiments/misc/imgs/data_20170330_162536_co.png

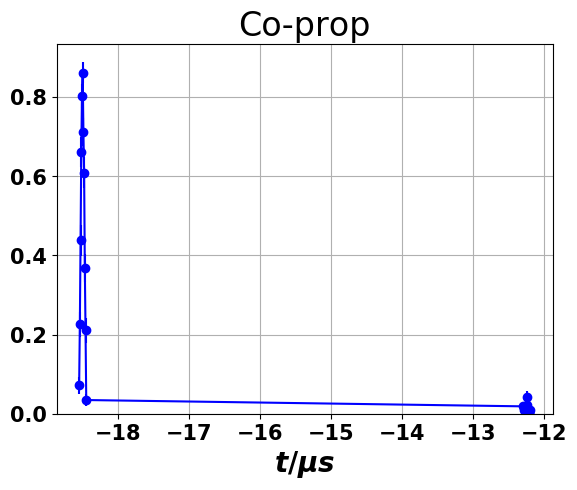
experiments/misc/imgs/data_20170330_162536_co.png
