nacs-lab/yyc-data/experiments/misc/imgs/data_20170330_162536_r3_+1t.png

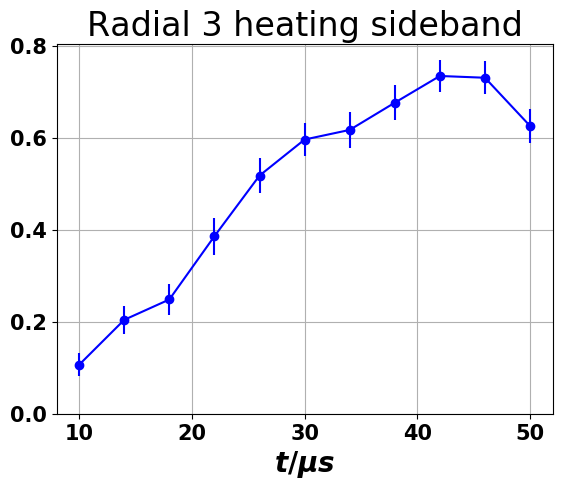
experiments/misc/imgs/data_20170330_162536_r3_+1t.png
