nacs-lab/yyc-data/experiments/misc/imgs/data_20170330_215045_r2_+1t.png

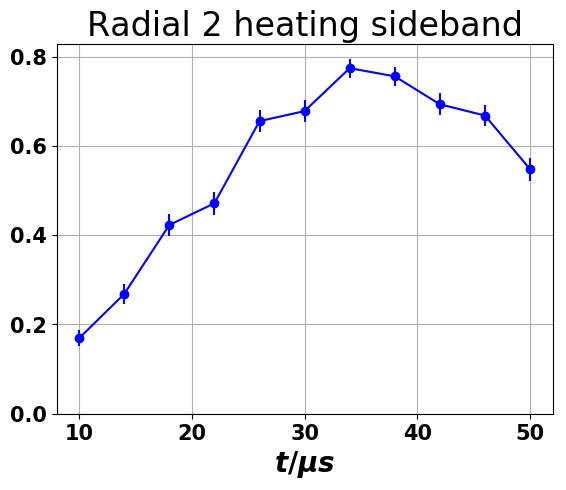
experiments/misc/imgs/data_20170330_215045_r2_+1t.png
