nacs-lab/yyc-data/experiments/misc/imgs/data_20170402_205344_a1_wait.png

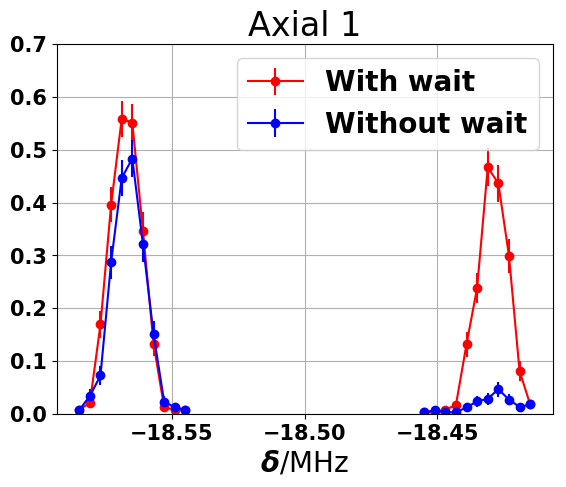
experiments/misc/imgs/data_20170402_205344_a1_wait.png
