nacs-lab/yyc-data/experiments/misc/imgs/data_20170402_205344_r3_rp.png

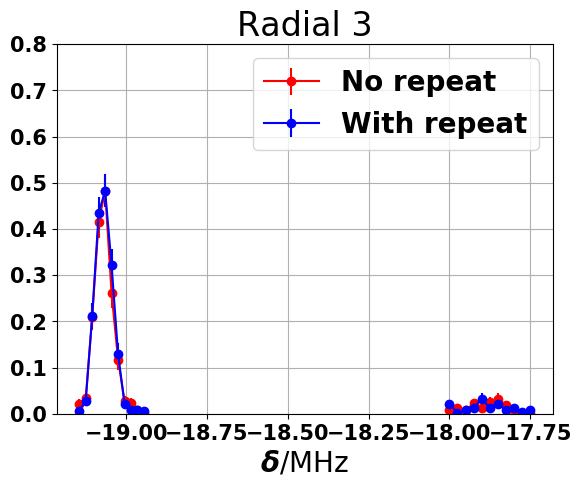
experiments/misc/imgs/data_20170402_205344_r3_rp.png
