nacs-lab/yyc-data/experiments/misc/imgs/data_combined_20170404_a1.png

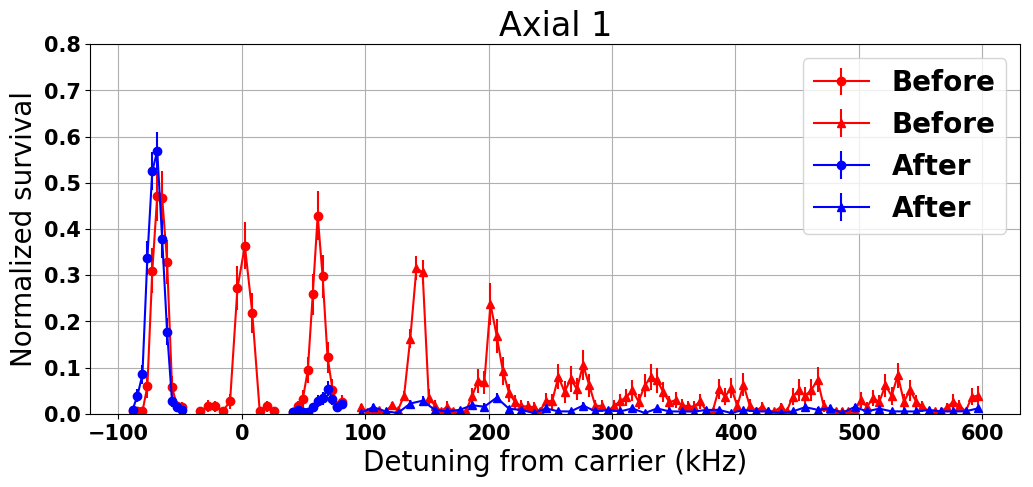
experiments/misc/imgs/data_combined_20170404_a1.png
