nacs-lab/yyc-data/experiments/misc/imgs/data_combined_20170404_r3.png

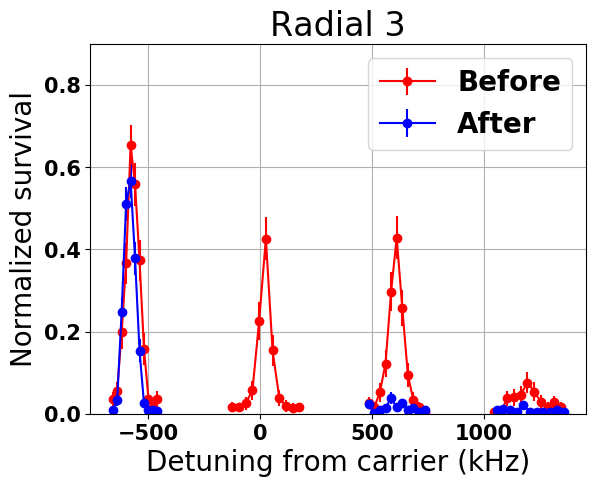
experiments/misc/imgs/data_combined_20170404_r3.png
