nacs-lab/yyc-data/experiments/misc/imgs/data_rabi_20170409_a1_p1.png

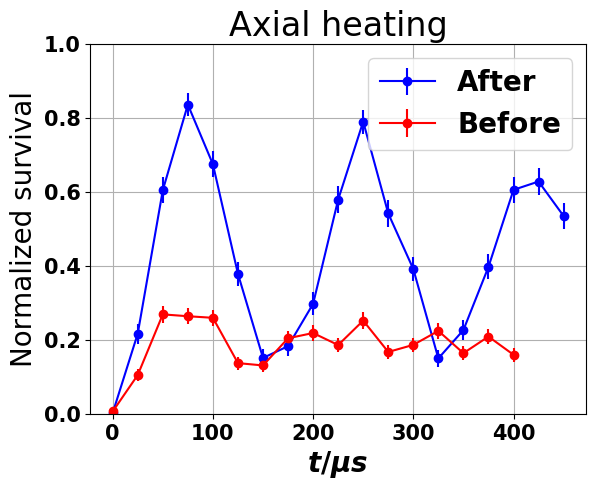
experiments/misc/imgs/data_rabi_20170409_a1_p1.png
