nacs-lab/yyc-data/experiments/misc/imgs/data_rabi_20170409_r2_0.png

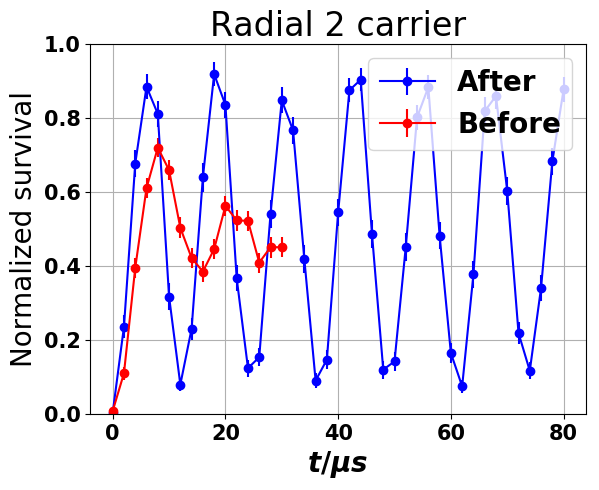
experiments/misc/imgs/data_rabi_20170409_r2_0.png
