nacs-lab/yyc-data/experiments/misc/imgs/na_multi_rabi_1st.png

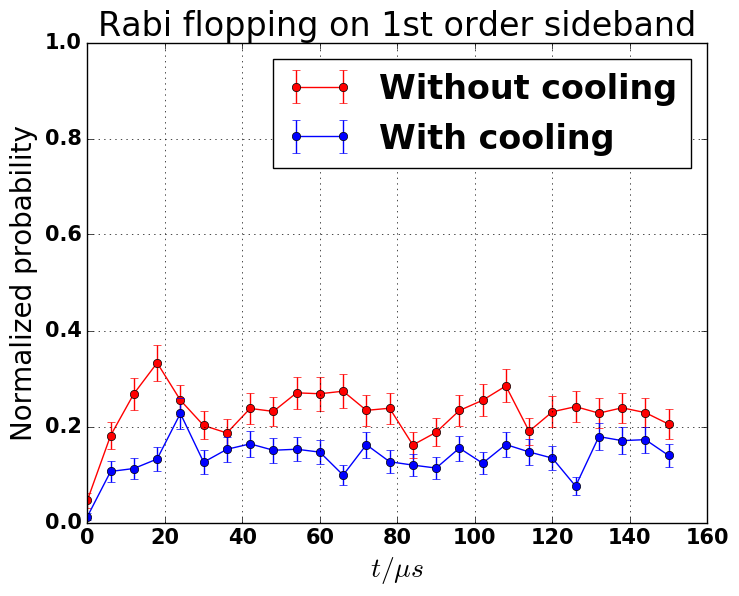
experiments/misc/imgs/na_multi_rabi_1st.png
