nacs-lab/yyc-data/experiments/misc/imgs/na_multi_rabi_with_cool.png

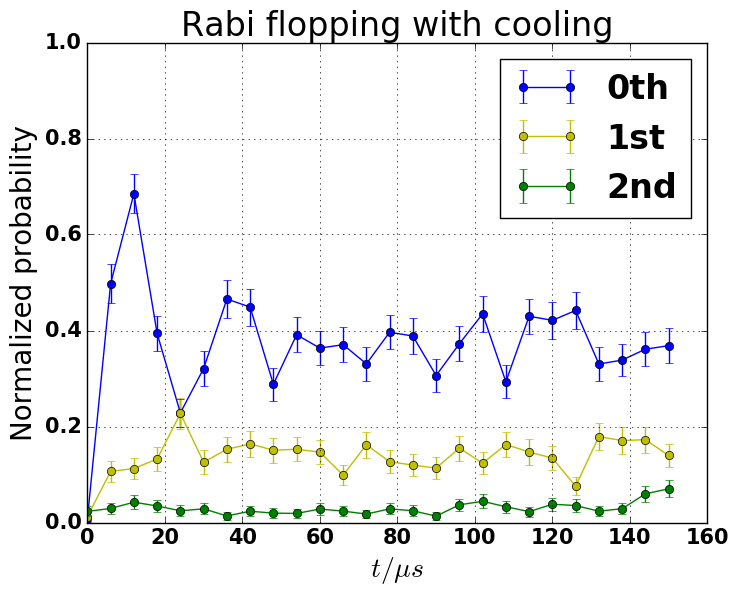
experiments/misc/imgs/na_multi_rabi_with_cool.png
