nacs-lab/yyc-data/experiments/misc/imgs/na_multi_rabi_without_cool.png

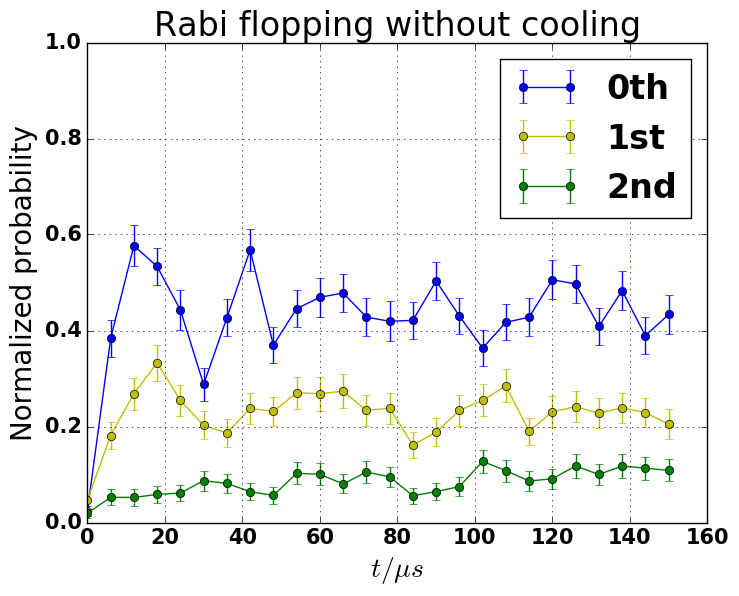
experiments/misc/imgs/na_multi_rabi_without_cool.png
