nacs-lab/yyc-data/experiments/na_phase/imgs/data_20180108_184217_2d_load.png

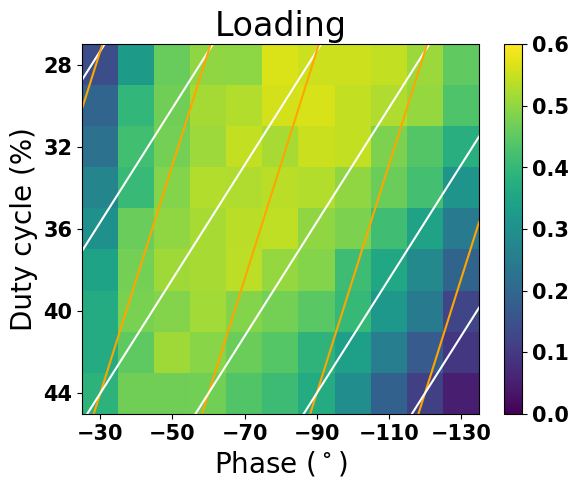
experiments/na_phase/imgs/data_20180108_184217_2d_load.png
