nacs-lab/yyc-data/experiments/na_phase/imgs/data_20180108_184217_duty_count1.png

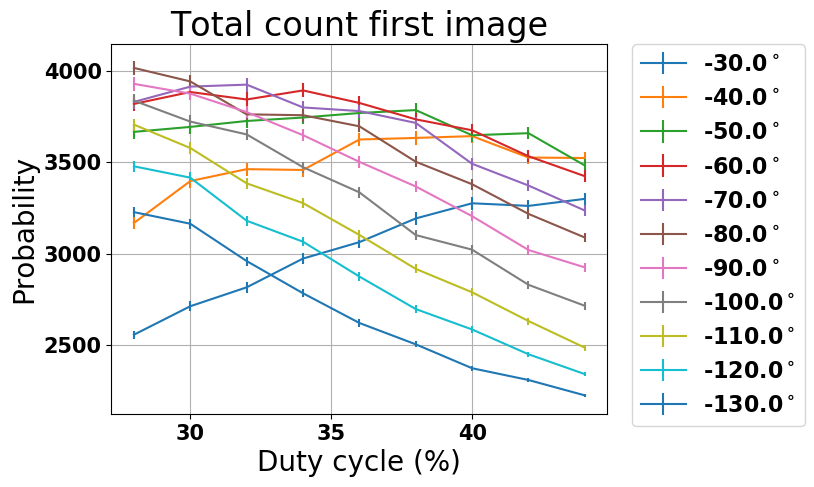
experiments/na_phase/imgs/data_20180108_184217_duty_count1.png
