nacs-lab/yyc-data/experiments/na_phase/imgs/data_20180108_184217_phase_survival.png

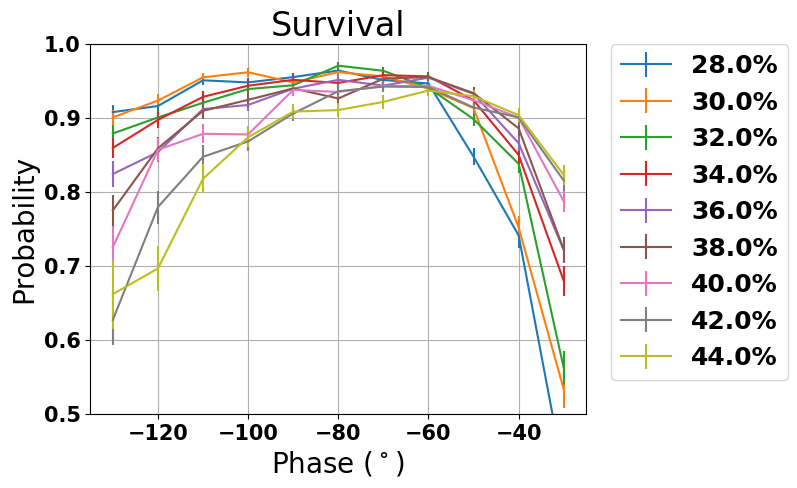
experiments/na_phase/imgs/data_20180108_184217_phase_survival.png
