nacs-lab/yyc-data/experiments/na_phase/imgs/lower_edge_20180108_load.png

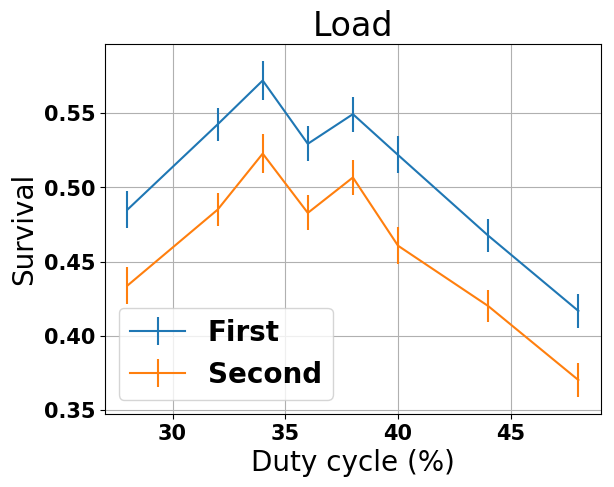
experiments/na_phase/imgs/lower_edge_20180108_load.png
