nacs-lab/yyc-data/experiments/na_rsc_201709/imgs/data_20170913_radial_cool_rx.png

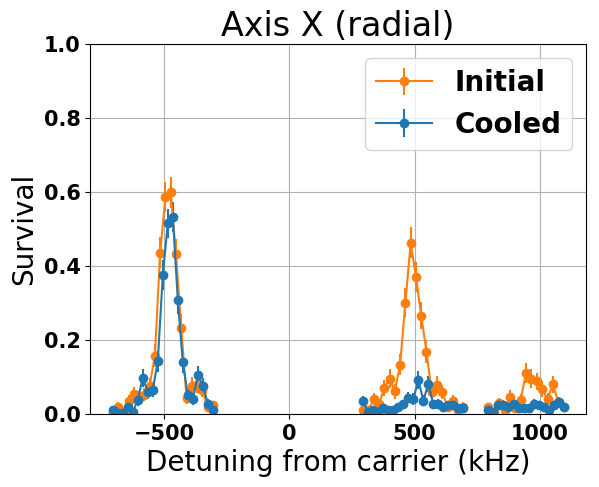
experiments/na_rsc_201709/imgs/data_20170913_radial_cool_rx.png
