nacs-lab/yyc-data/experiments/na_rsc_201709/imgs/data_20170914_210445_rx.png

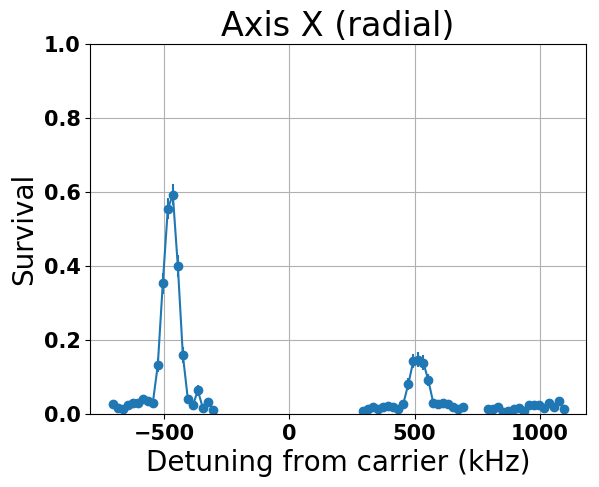
experiments/na_rsc_201709/imgs/data_20170914_210445_rx.png
