nacs-lab/yyc-data/experiments/na_rsc_201709/imgs/data_20170919_110453_lower_hold.png

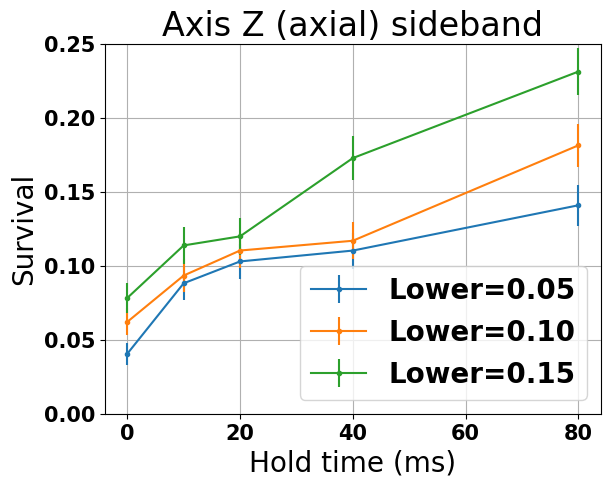
experiments/na_rsc_201709/imgs/data_20170919_110453_lower_hold.png
