nacs-lab/yyc-data/experiments/na_rsc_201709/imgs/data_20170919_132216_merge_az.png

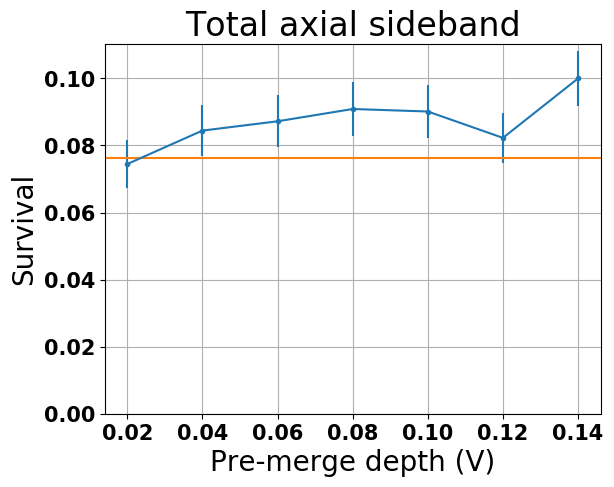
experiments/na_rsc_201709/imgs/data_20170919_132216_merge_az.png
