nacs-lab/yyc-data/experiments/na_rsc_201709/imgs/data_20170919_184604_time_cool.png

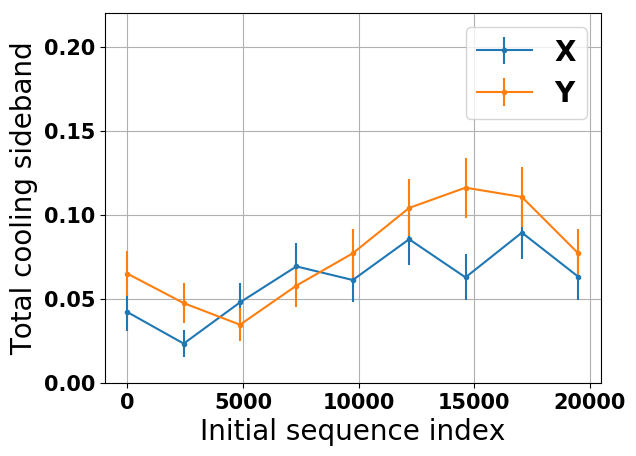
experiments/na_rsc_201709/imgs/data_20170919_184604_time_cool.png
