nacs-lab/yyc-data/experiments/na_rsc_201709/imgs/data_20170921_004940_cool_time.png

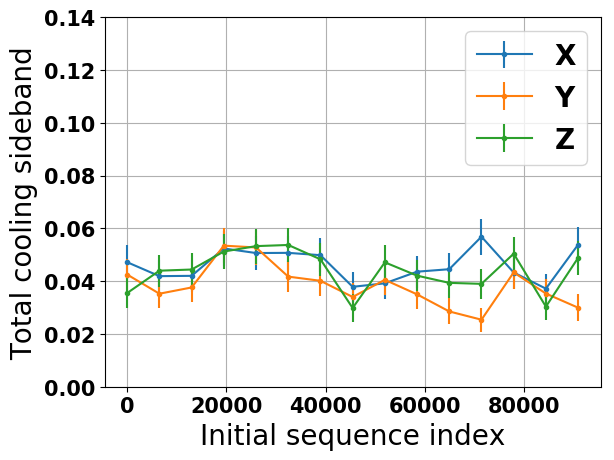
experiments/na_rsc_201709/imgs/data_20170921_004940_cool_time.png
