nacs-lab/yyc-data/experiments/na_rsc_201709/imgs/data_20170924_195426_cool_merge_rx.png

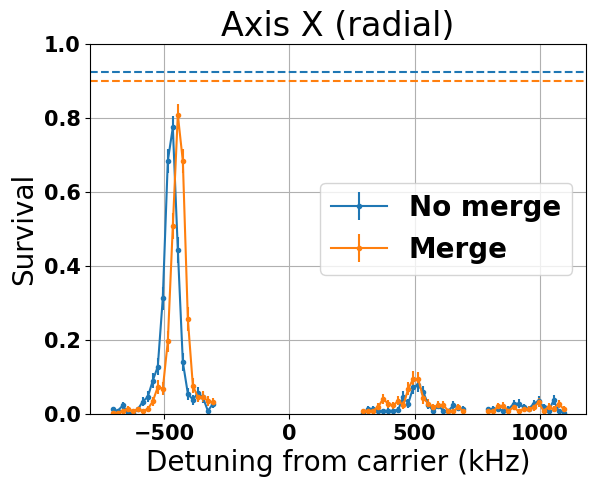
experiments/na_rsc_201709/imgs/data_20170924_195426_cool_merge_rx.png
