nacs-lab/yyc-data/experiments/na_rsc_201709/imgs/data_20170927_193235_cool_time_survival.png

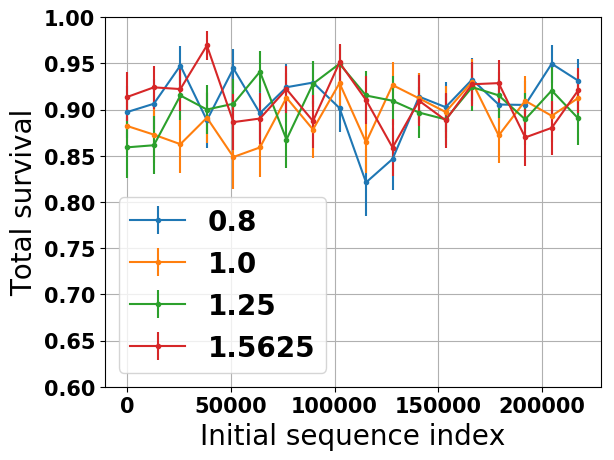
experiments/na_rsc_201709/imgs/data_20170927_193235_cool_time_survival.png
