nacs-lab/yyc-data/experiments/na_rsc_201709/imgs/fit_20170915_rabi_scatter_f1_up.png

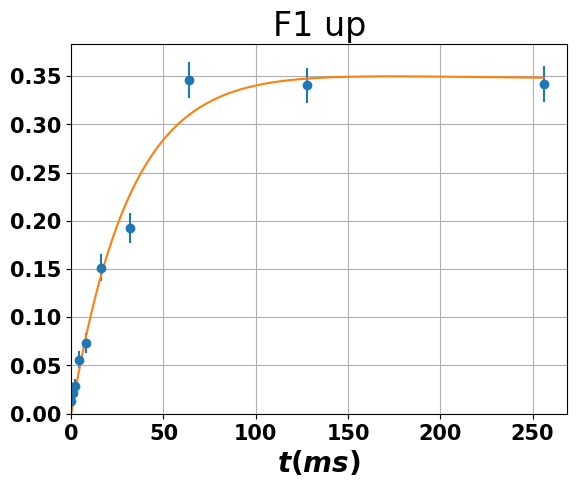
experiments/na_rsc_201709/imgs/fit_20170915_rabi_scatter_f1_up.png
