nacs-lab/yyc-data/experiments/na_rsc_201801/imgs/data_20180112_204435_rabi_r_hot_y.png

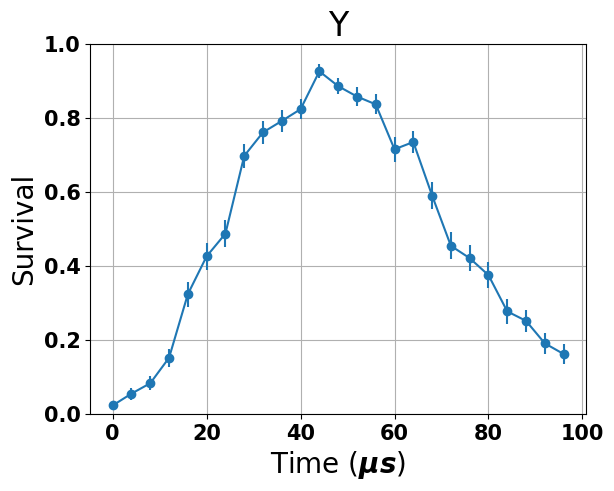
experiments/na_rsc_201801/imgs/data_20180112_204435_rabi_r_hot_y.png
