nacs-lab/yyc-data/experiments/na_rsc_201801/imgs/data_20180113_152931_rabi_a_cold.png

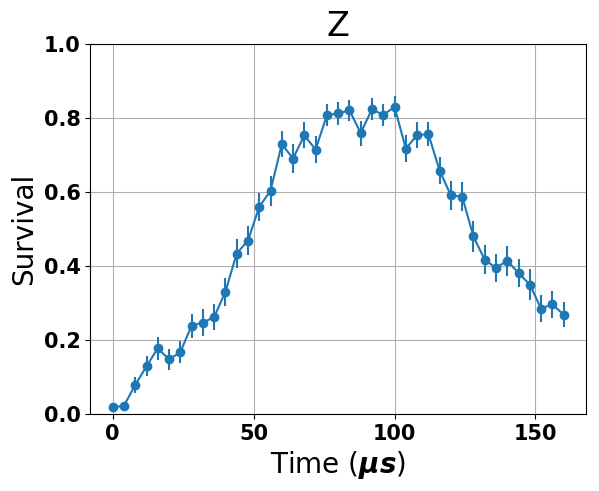
experiments/na_rsc_201801/imgs/data_20180113_152931_rabi_a_cold.png
