nacs-lab/yyc-data/experiments/na_rsc_201801/imgs/data_20180120_rabi_cold_x.png

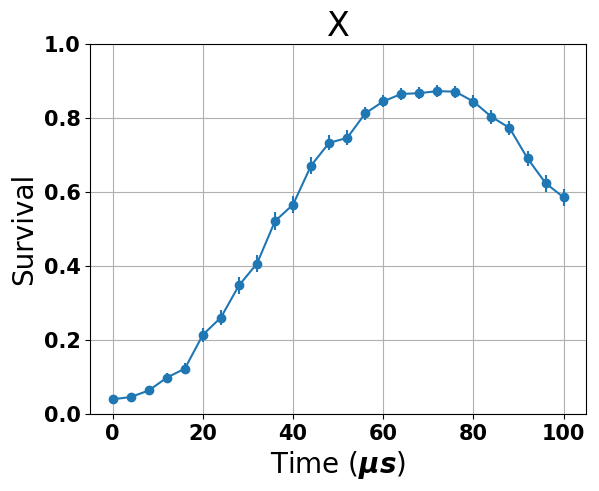
experiments/na_rsc_201801/imgs/data_20180120_rabi_cold_x.png
