nacs-lab/yyc-data/experiments/na_rsc_201801/imgs/data_20180122_111933_rabi_cold_x.png

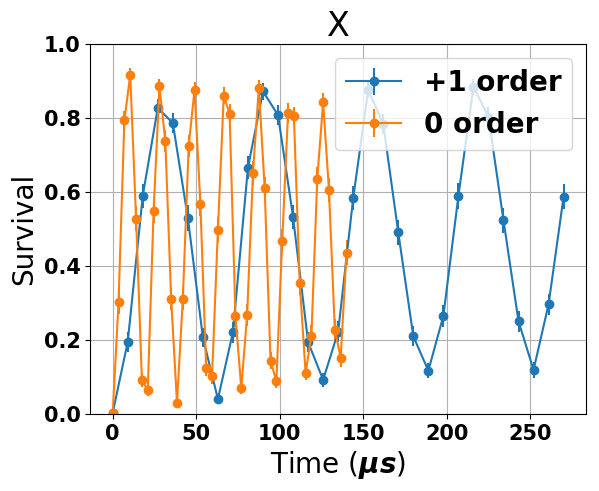
experiments/na_rsc_201801/imgs/data_20180122_111933_rabi_cold_x.png
