nacs-lab/yyc-data/experiments/na_rsc_201801/imgs/data_20180122_214615_hot_rabi_z.png

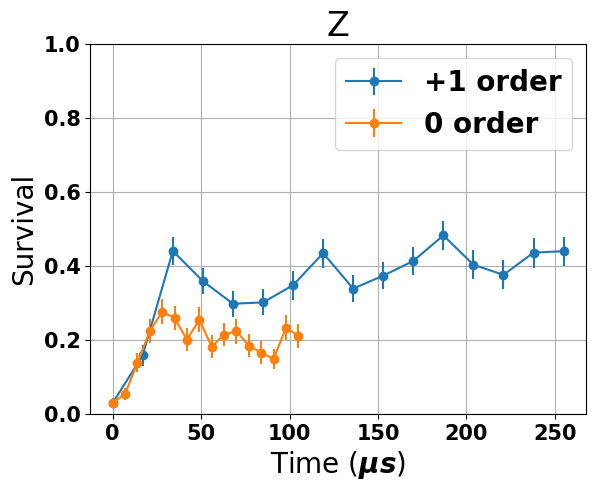
experiments/na_rsc_201801/imgs/data_20180122_214615_hot_rabi_z.png
