nacs-lab/yyc-data/experiments/nacs_201804/imgs/data_20180417_234100_pa_4422_v0_j12.png

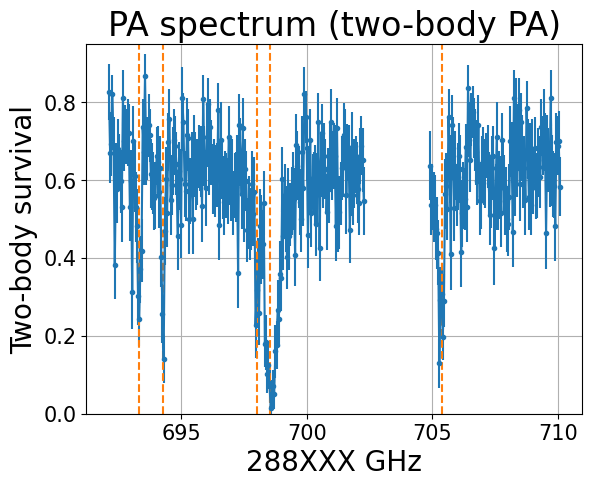
experiments/nacs_201804/imgs/data_20180417_234100_pa_4422_v0_j12.png
