nacs-lab/yyc-data/experiments/nacs_201806/imgs/data_20180628_162214_raman_scatter_f2_diagonal.png

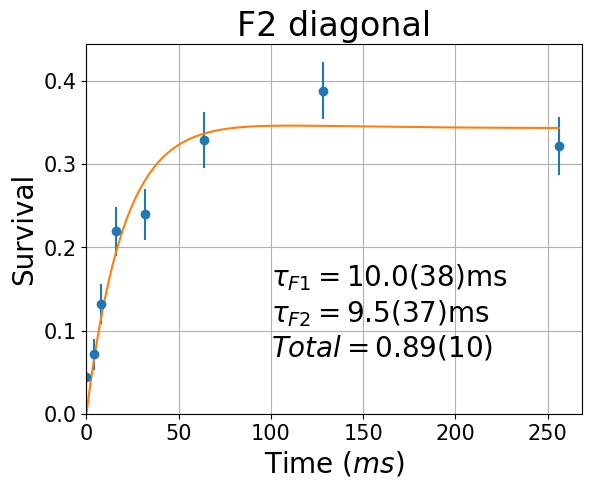
experiments/nacs_201806/imgs/data_20180628_162214_raman_scatter_f2_diagonal.png
