nacs-lab/yyc-data/experiments/nacs_201806/imgs/data_20180628_184533_rx.png

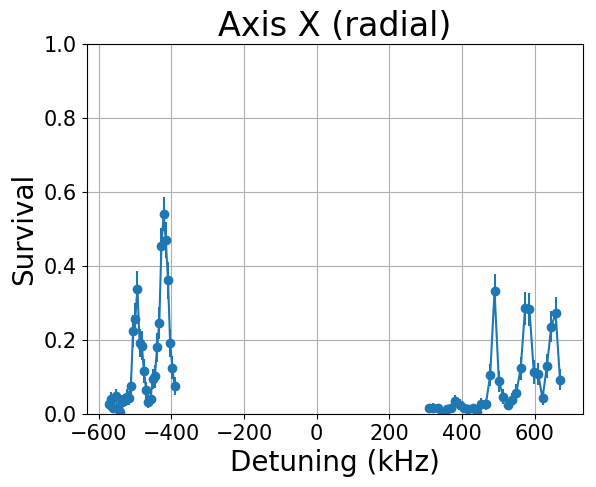
experiments/nacs_201806/imgs/data_20180628_184533_rx.png
