nacs-lab/yyc-data/experiments/nacs_201808/imgs/data_20180806_hot_cs_az.png

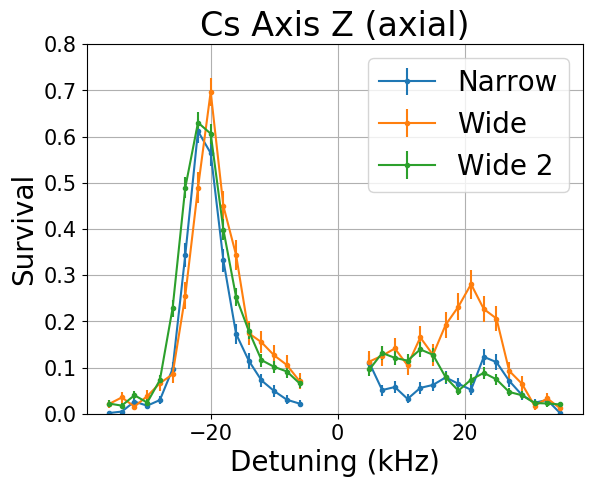
experiments/nacs_201808/imgs/data_20180806_hot_cs_az.png
