nacs-lab/yyc-data/experiments/nacs_201808/imgs/data_20180806_hot_cs_rabi.png

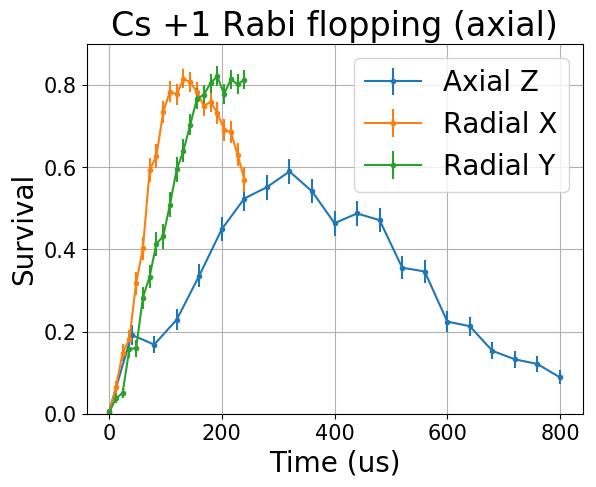
experiments/nacs_201808/imgs/data_20180806_hot_cs_rabi.png
