nacs-lab/yyc-data/experiments/nacs_201808/imgs/data_20180807_231104_interaction_shift_raman.png

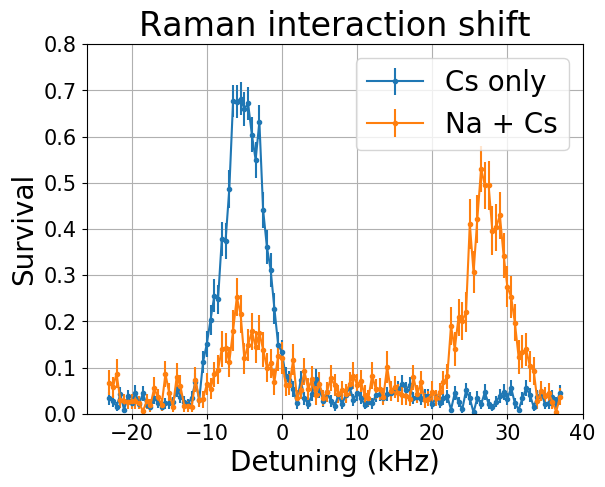
experiments/nacs_201808/imgs/data_20180807_231104_interaction_shift_raman.png
