nacs-lab/yyc-data/experiments/nacs_201808/imgs/data_20180808_174308_napremerge_cs9.png

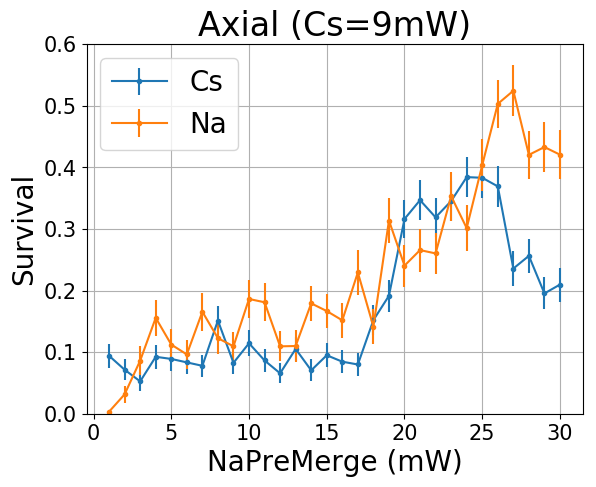
experiments/nacs_201808/imgs/data_20180808_174308_napremerge_cs9.png
