nacs-lab/yyc-data/experiments/nacs_201808/imgs/data_20180808_interaction_shift2_44.png

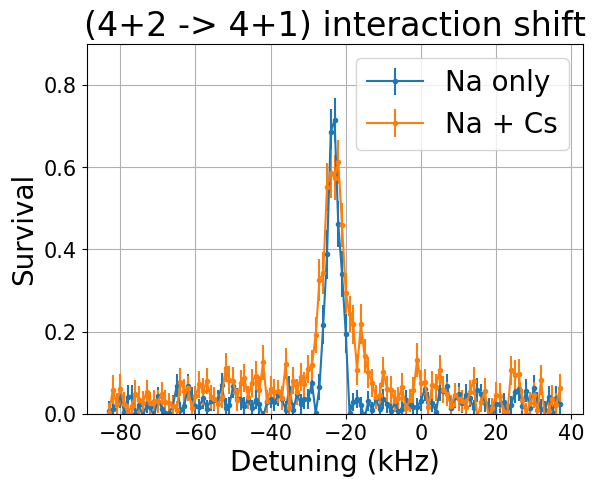
experiments/nacs_201808/imgs/data_20180808_interaction_shift2_44.png
