nacs-lab/yyc-data/experiments/nacs_201808/imgs/data_20180810_150954_interaction_shift_n1_n1.png

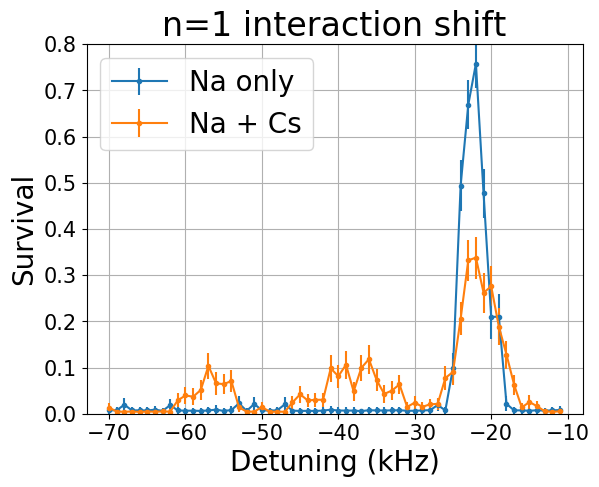
experiments/nacs_201808/imgs/data_20180810_150954_interaction_shift_n1_n1.png
