nacs-lab/yyc-data/experiments/nacs_201808/imgs/data_20180810_150954_interaction_shift_n1_nacs.png

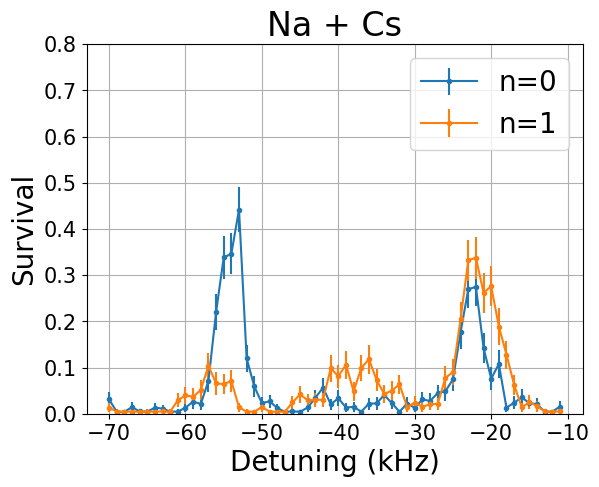
experiments/nacs_201808/imgs/data_20180810_150954_interaction_shift_n1_nacs.png
