nacs-lab/yyc-data/experiments/nacs_201808/imgs/data_20180812_161422_interaction_shift3_rx_cs.png

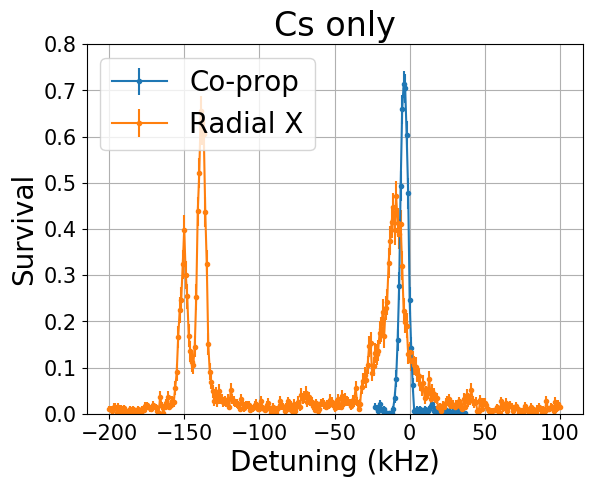
experiments/nacs_201808/imgs/data_20180812_161422_interaction_shift3_rx_cs.png
