nacs-lab/yyc-data/experiments/nacs_201808/imgs/data_20180824_230559_nafull_hot_az.png

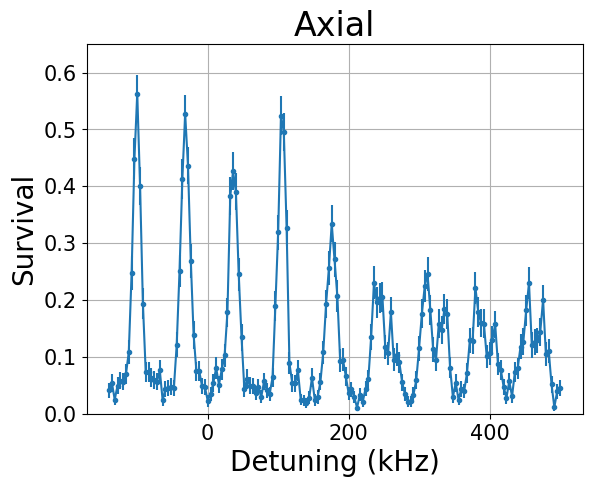
experiments/nacs_201808/imgs/data_20180824_230559_nafull_hot_az.png
