nacs-lab/yyc-data/experiments/nacs_201808/imgs/data_20180902_175939_cs_cool_cs_az.png

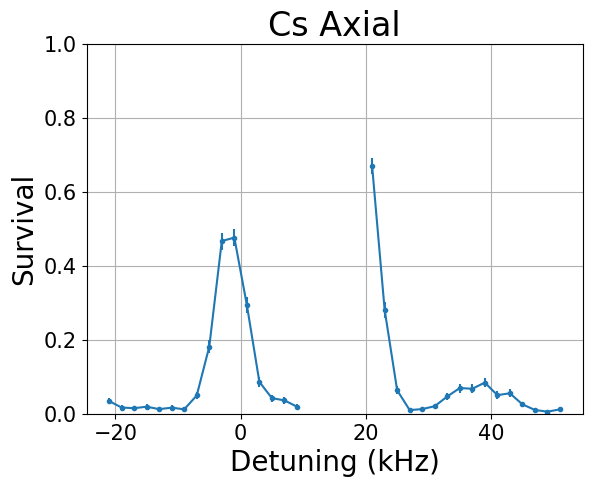
experiments/nacs_201808/imgs/data_20180902_175939_cs_cool_cs_az.png
