nacs-lab/yyc-data/experiments/nacs_201808/imgs/data_20180903_004805_cs_cool2_r_rabi.png

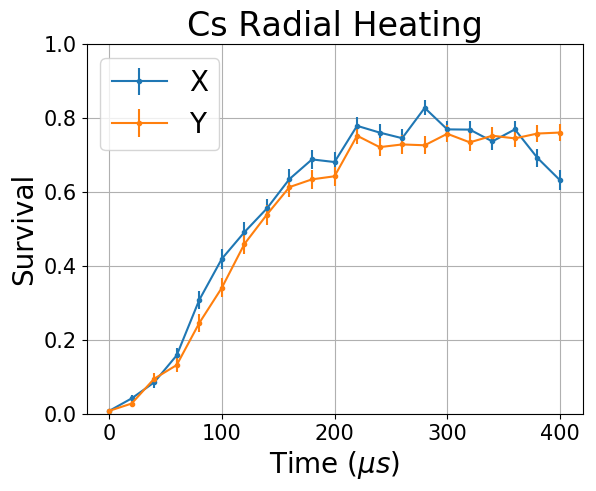
experiments/nacs_201808/imgs/data_20180903_004805_cs_cool2_r_rabi.png
