nacs-lab/yyc-data/experiments/nacs_201808/imgs/data_20180903_213034_raman_scatter_na_f1_up.png

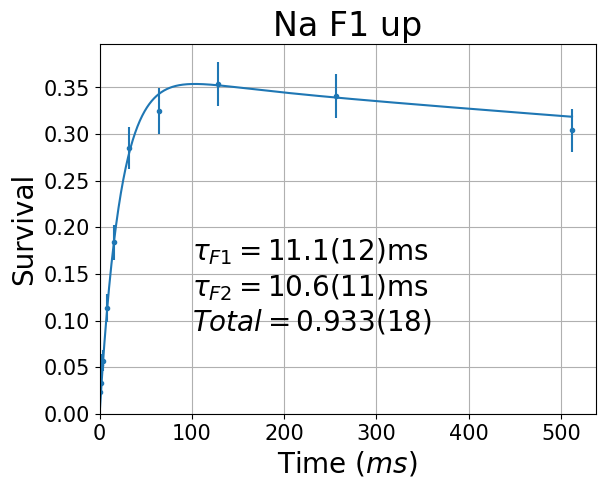
experiments/nacs_201808/imgs/data_20180903_213034_raman_scatter_na_f1_up.png
