nacs-lab/yyc-data/experiments/nacs_201808/imgs/data_20180904_221357_na_hot_ry.png

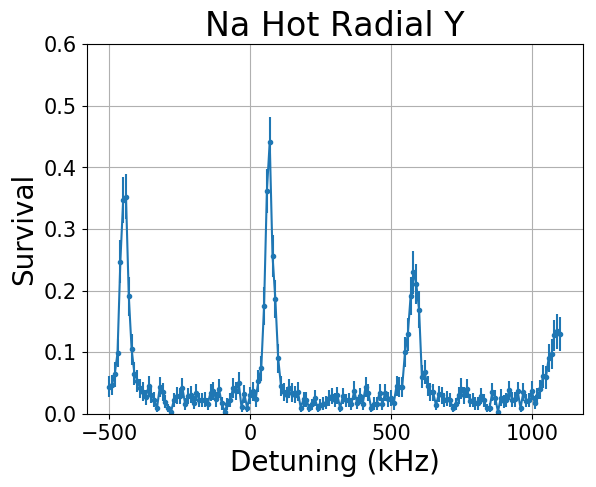
experiments/nacs_201808/imgs/data_20180904_221357_na_hot_ry.png
