nacs-lab/yyc-data/experiments/nacs_201808/imgs/data_20180906_162916_hot_cs_rx.png

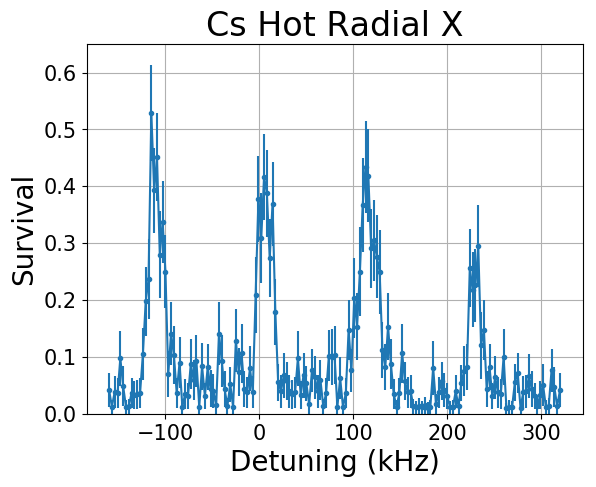
experiments/nacs_201808/imgs/data_20180906_162916_hot_cs_rx.png
