nacs-lab/yyc-data/experiments/nacs_201808/imgs/data_20180906_190014_cold_full_na_az.png

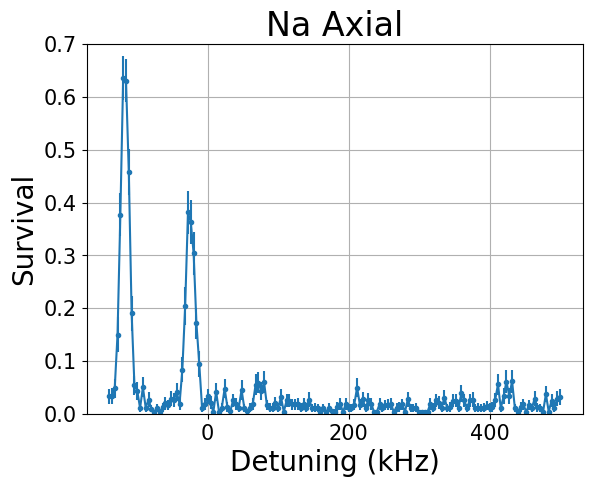
experiments/nacs_201808/imgs/data_20180906_190014_cold_full_na_az.png
