nacs-lab/yyc-data/experiments/nacs_201808/imgs/data_20180908_090538_merge_temp_cs_az.png

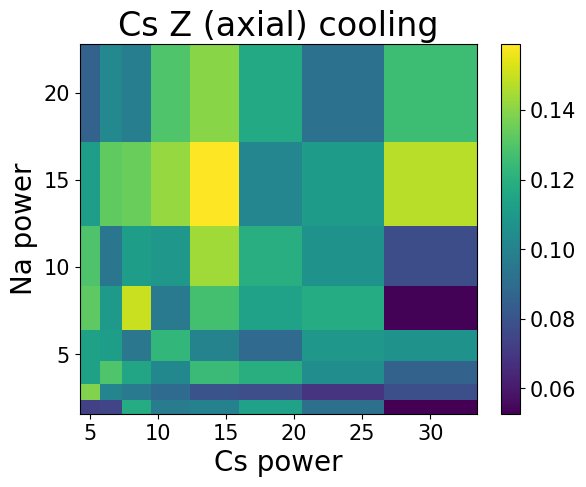
experiments/nacs_201808/imgs/data_20180908_090538_merge_temp_cs_az.png
