nacs-lab/yyc-data/experiments/nacs_201808/imgs/data_20180909_235431_interaction_shift_time.png

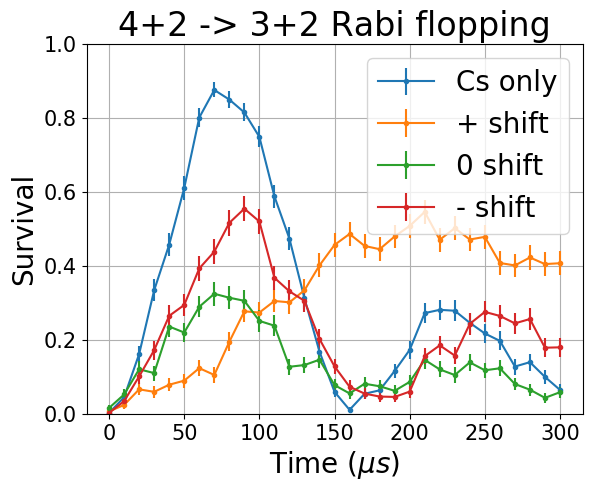
experiments/nacs_201808/imgs/data_20180909_235431_interaction_shift_time.png
