nacs-lab/yyc-data/experiments/nacs_201808/imgs/data_20180912_171749_merge_cmp_na_az.png

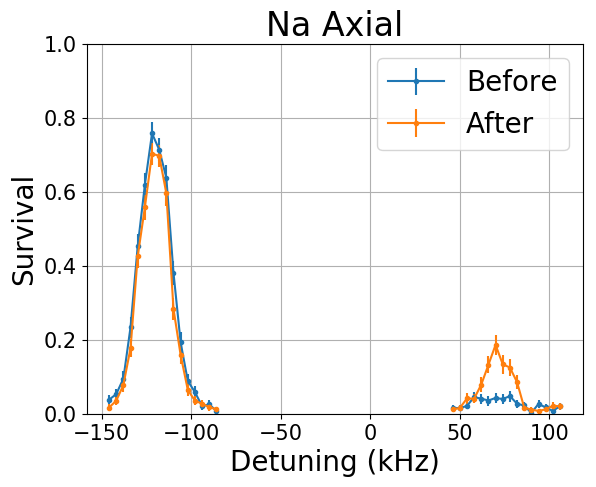
experiments/nacs_201808/imgs/data_20180912_171749_merge_cmp_na_az.png
