nacs-lab/yyc-data/experiments/nacs_201808/imgs/data_20180914_015357_merge_cmp_cs_az.png

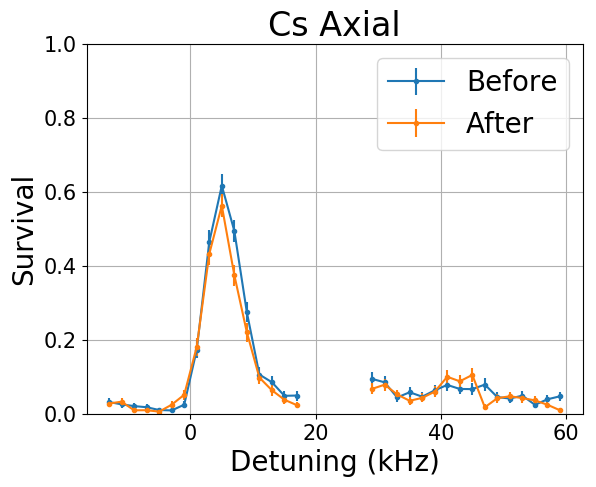
experiments/nacs_201808/imgs/data_20180914_015357_merge_cmp_cs_az.png
