nacs-lab/yyc-data/experiments/nacs_201808/imgs/data_20180915_163446_merge_temp_cs_az.png

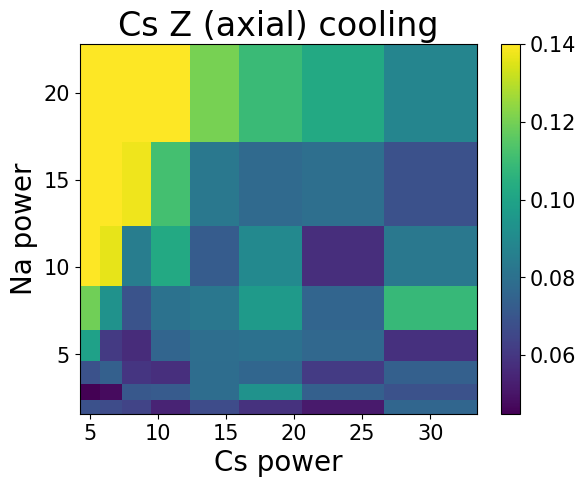
experiments/nacs_201808/imgs/data_20180915_163446_merge_temp_cs_az.png
