nacs-lab/yyc-data/experiments/nacs_201808/imgs/data_20180919_2body_lifetimes_cs_nocool.png

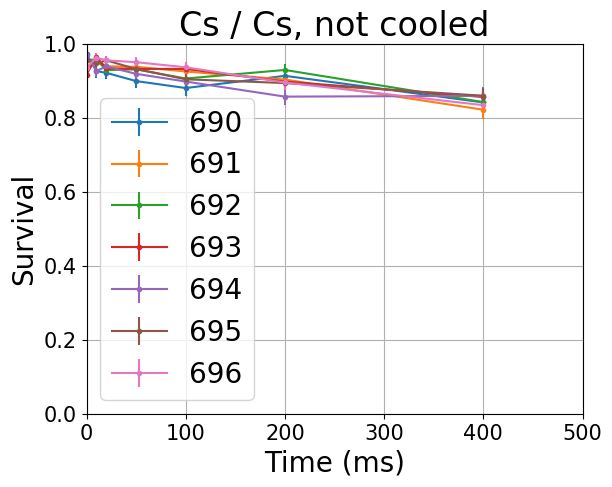
experiments/nacs_201808/imgs/data_20180919_2body_lifetimes_cs_nocool.png
