nacs-lab/yyc-data/experiments/nacs_201810/imgs/data_20181005_004144_clock_merge_temp_na_az.png

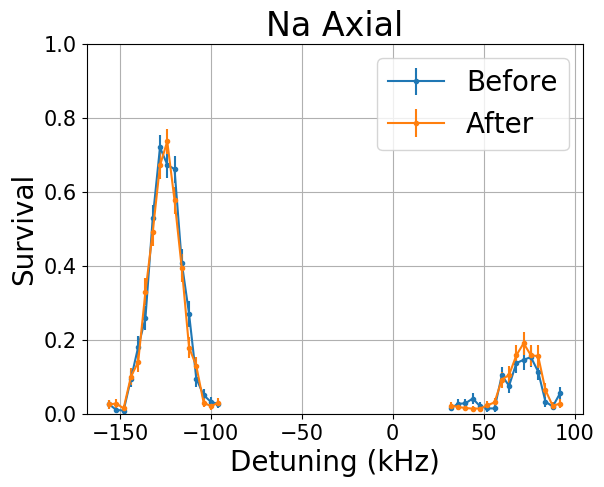
experiments/nacs_201810/imgs/data_20181005_004144_clock_merge_temp_na_az.png
