nacs-lab/yyc-data/experiments/nacs_201810/imgs/data_20181005_181134_clock_merge_temp_cs_rx.png

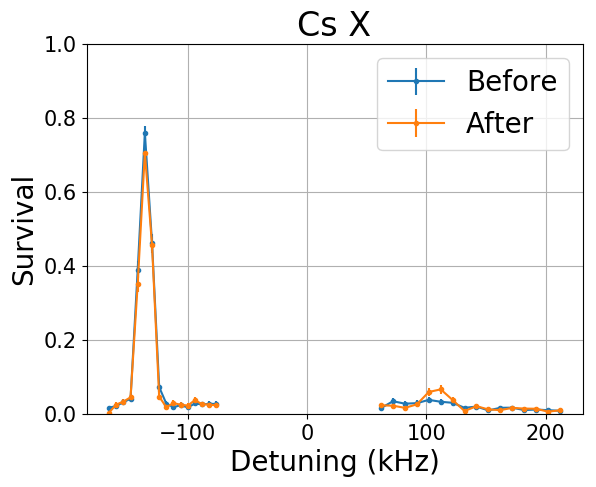
experiments/nacs_201810/imgs/data_20181005_181134_clock_merge_temp_cs_rx.png
