nacs-lab/yyc-data/experiments/nacs_201810/imgs/data_20181006_133411_full_sideband_cs_az.png

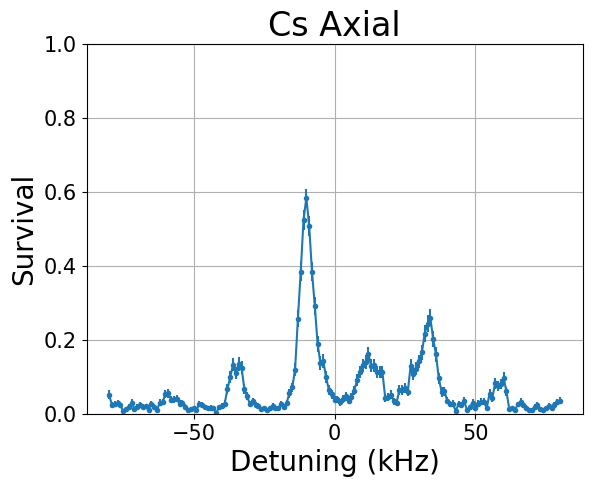
experiments/nacs_201810/imgs/data_20181006_133411_full_sideband_cs_az.png
