nacs-lab/yyc-data/experiments/nacs_201810/imgs/data_20181006_215522_clock_merge_temp_na_rx.png

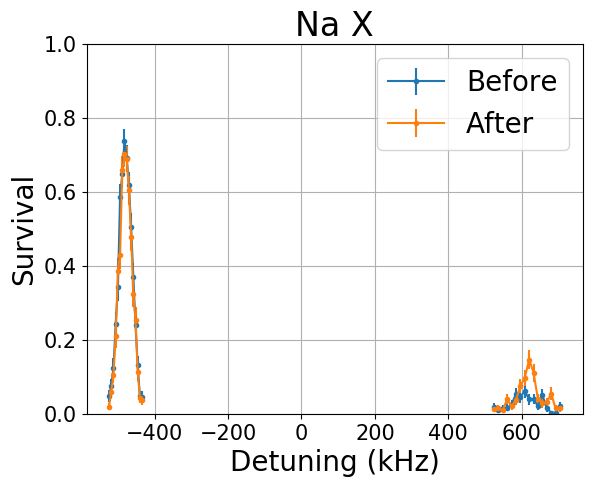
experiments/nacs_201810/imgs/data_20181006_215522_clock_merge_temp_na_rx.png
