nacs-lab/yyc-data/experiments/nacs_201810/imgs/data_20181010_183350_raman_rt_diff.png

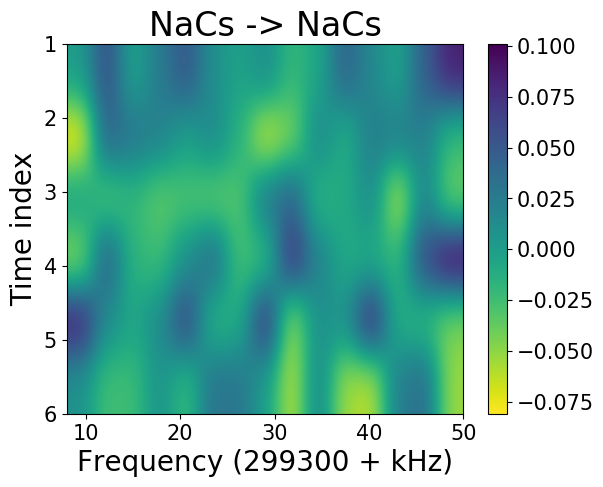
experiments/nacs_201810/imgs/data_20181010_183350_raman_rt_diff.png
