nacs-lab/yyc-data/experiments/nacs_201810/imgs/data_20181028_232143_lifetime_cs.png

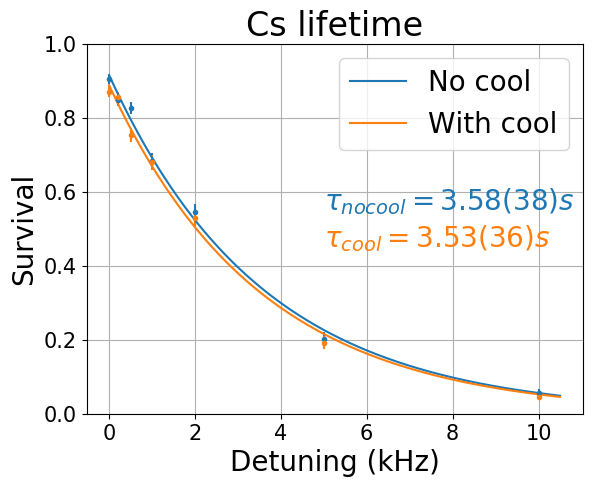
experiments/nacs_201810/imgs/data_20181028_232143_lifetime_cs.png
