nacs-lab/yyc-data/experiments/nacs_201810/imgs/data_20181102_232550_sideband_cold_hot_na_ry.png

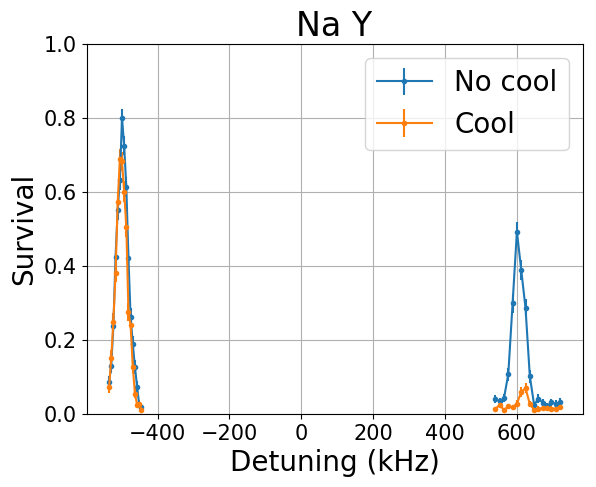
experiments/nacs_201810/imgs/data_20181102_232550_sideband_cold_hot_na_ry.png
