nacs-lab/yyc-data/experiments/nacs_201810/imgs/data_20181103_raman_n2_powers.png

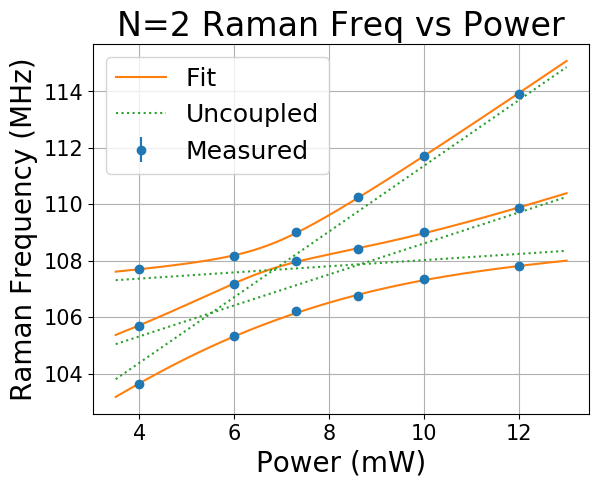
experiments/nacs_201810/imgs/data_20181103_raman_n2_powers.png
