nacs-lab/yyc-data/experiments/nacs_201810/imgs/data_20181105_raman_n2_b60_5-6.png

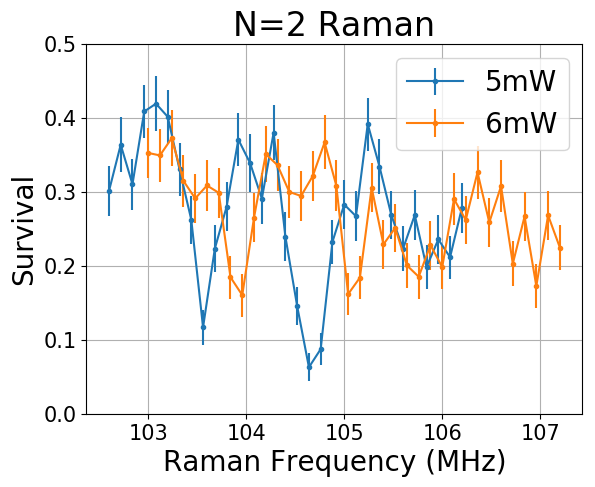
experiments/nacs_201810/imgs/data_20181105_raman_n2_b60_5-6.png
