nacs-lab/yyc-data/experiments/nacs_201810/imgs/data_20181112_095349_sideband_3d_cs_ry.png

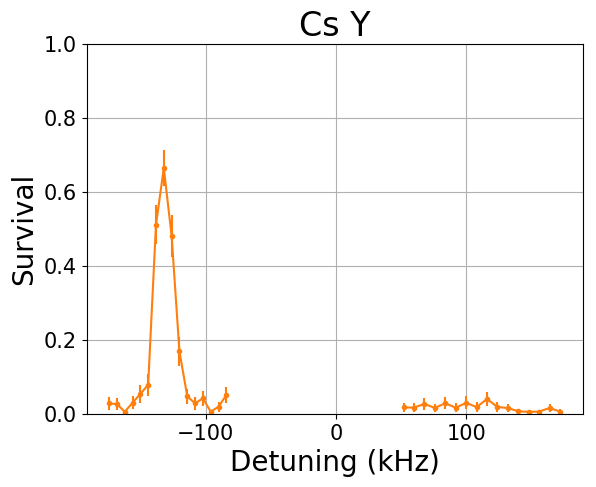
experiments/nacs_201810/imgs/data_20181112_095349_sideband_3d_cs_ry.png
