nacs-lab/yyc-data/experiments/nacs_201810/imgs/data_20181112_raman_cmp_time.png

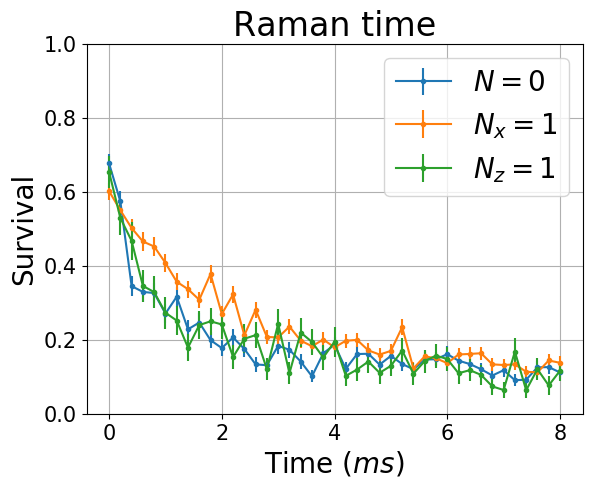
experiments/nacs_201810/imgs/data_20181112_raman_cmp_time.png
