nacs-lab/yyc-data/experiments/nacs_201810/imgs/data_20181113_raman_pos_det_freq.png

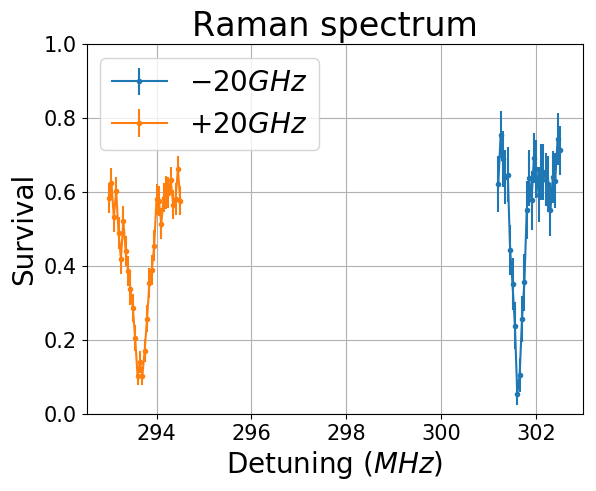
experiments/nacs_201810/imgs/data_20181113_raman_pos_det_freq.png
