nacs-lab/yyc-data/experiments/nacs_201810/imgs/data_20181118_214643_raman_fluctuation_time1.png

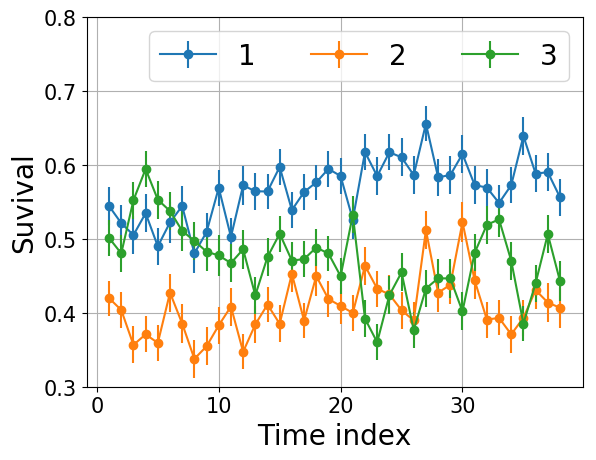
experiments/nacs_201810/imgs/data_20181118_214643_raman_fluctuation_time1.png
