nacs-lab/yyc-data/experiments/nacs_201810/imgs/data_20181120_010424_raman_time_rt_ref.png

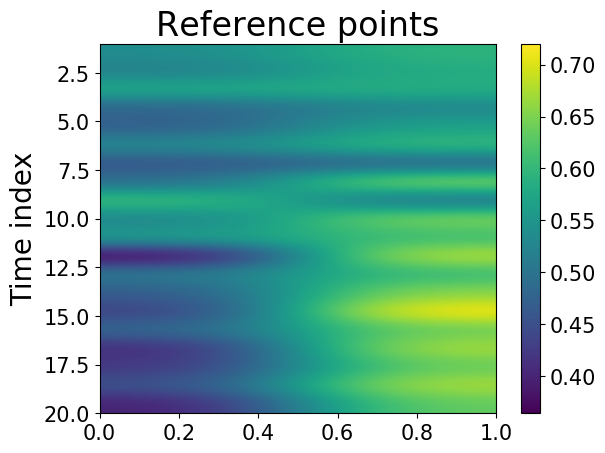
experiments/nacs_201810/imgs/data_20181120_010424_raman_time_rt_ref.png
