nacs-lab/yyc-data/experiments/nacs_201810/imgs/data_20181124_002009_raman_vs_b.png

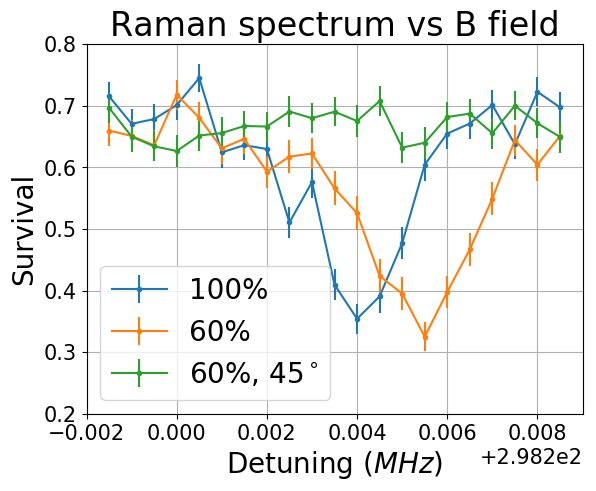
experiments/nacs_201810/imgs/data_20181124_002009_raman_vs_b.png
