nacs-lab/yyc-data/experiments/nacs_201810/imgs/data_20181129_pa_rates_pa20.png

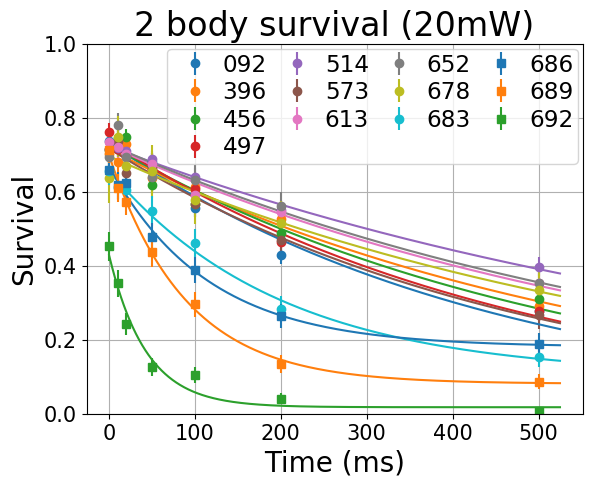
experiments/nacs_201810/imgs/data_20181129_pa_rates_pa20.png
