nacs-lab/yyc-data/experiments/nacs_201902/imgs/data_20190219_ps_lifetime_hot2.png

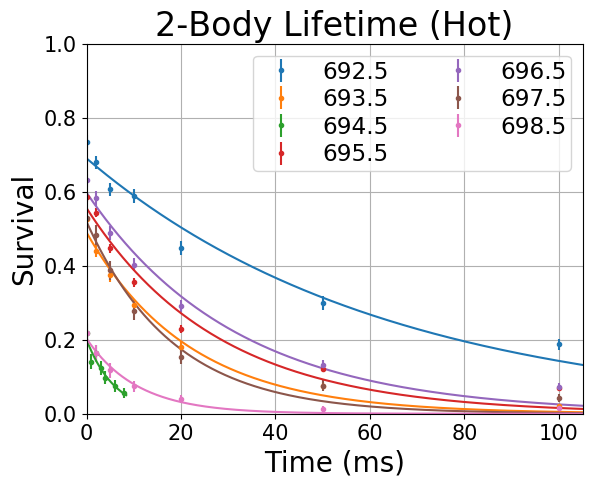
experiments/nacs_201902/imgs/data_20190219_ps_lifetime_hot2.png
