nacs-lab/yyc-data/experiments/nacs_201902/imgs/data_20190303_raman_986.png

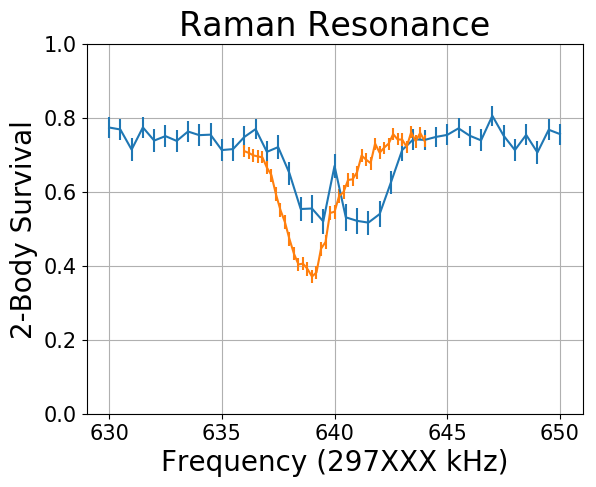
experiments/nacs_201902/imgs/data_20190303_raman_986.png
