nacs-lab/yyc-data/experiments/nacs_201902/imgs/data_20190305_213328_temp_na_rx.png

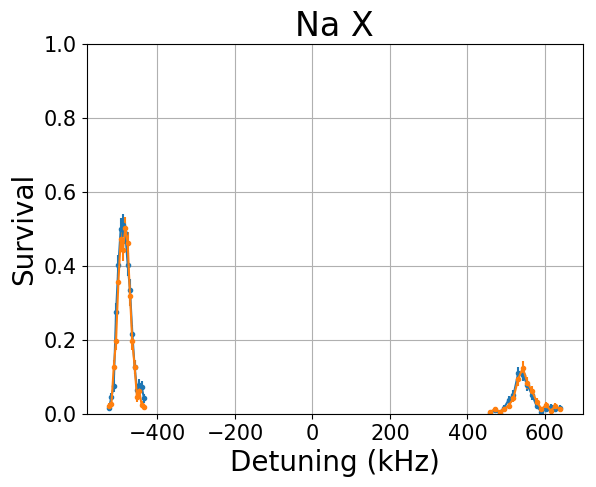
experiments/nacs_201902/imgs/data_20190305_213328_temp_na_rx.png
