nacs-lab/yyc-data/experiments/nacs_201902/imgs/data_20190311_223739_short_raman.png

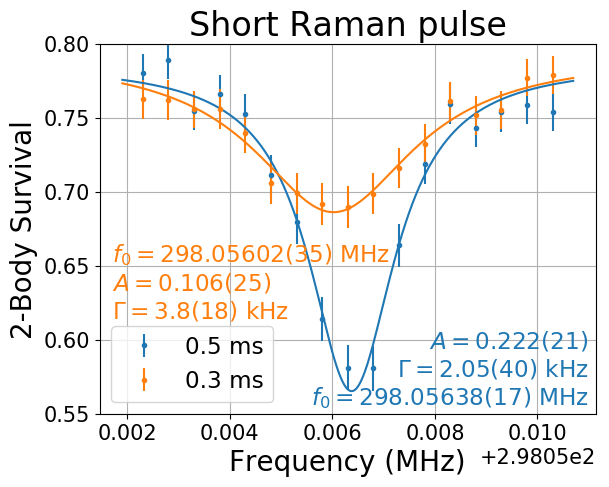
experiments/nacs_201902/imgs/data_20190311_223739_short_raman.png
