nacs-lab/yyc-data/experiments/nacs_201902/imgs/data_20190318_lifetime_32.png

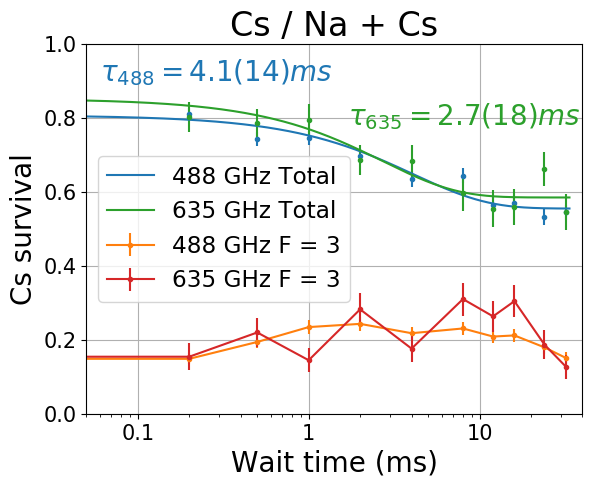
experiments/nacs_201902/imgs/data_20190318_lifetime_32.png
