nacs-lab/yyc-data/experiments/nacs_201902/imgs/data_20190319_085037_raman_time.png

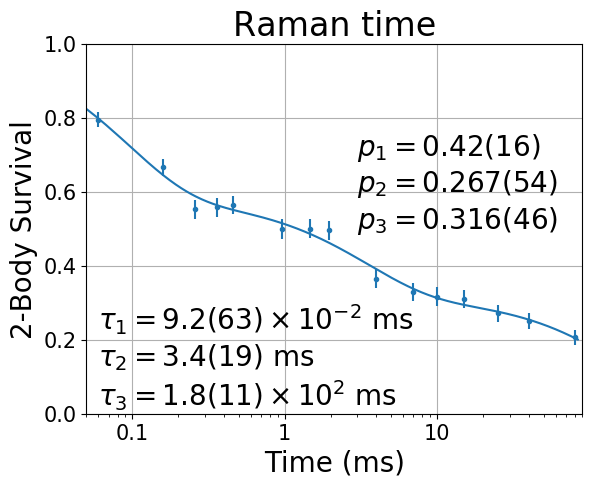
experiments/nacs_201902/imgs/data_20190319_085037_raman_time.png
