nacs-lab/yyc-data/experiments/nacs_201902/imgs/data_20190321_temp_na_ry.png

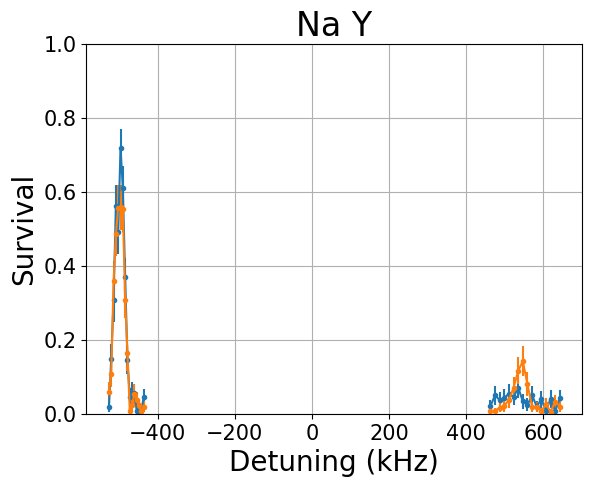
experiments/nacs_201902/imgs/data_20190321_temp_na_ry.png
