nacs-lab/yyc-data/experiments/nacs_201902/imgs/data_20190329_111044_flip_3322_double_state.png

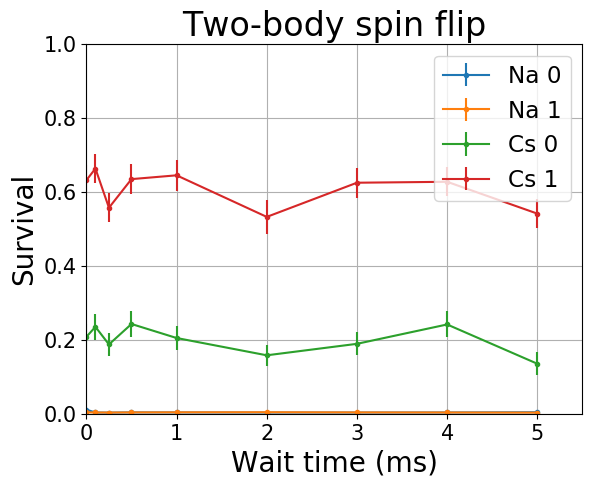
experiments/nacs_201902/imgs/data_20190329_111044_flip_3322_double_state.png
