nacs-lab/yyc-data/experiments/nacs_201904/imgs/data_20190401_215551_flip_3322_single_state.png

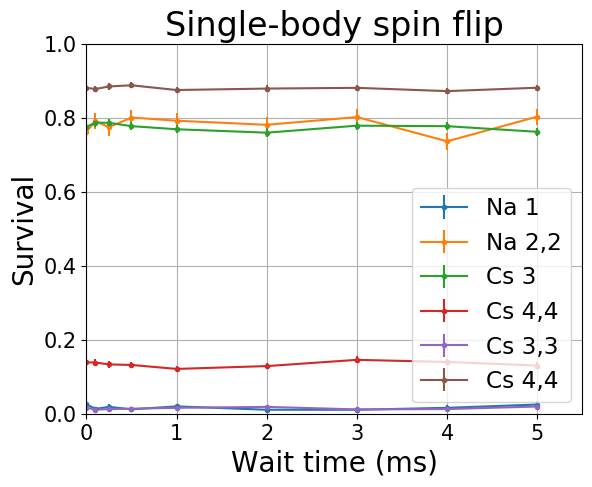
experiments/nacs_201904/imgs/data_20190401_215551_flip_3322_single_state.png
