nacs-lab/yyc-data/experiments/nacs_201904/imgs/data_20190407_raman_lines_resonance.png

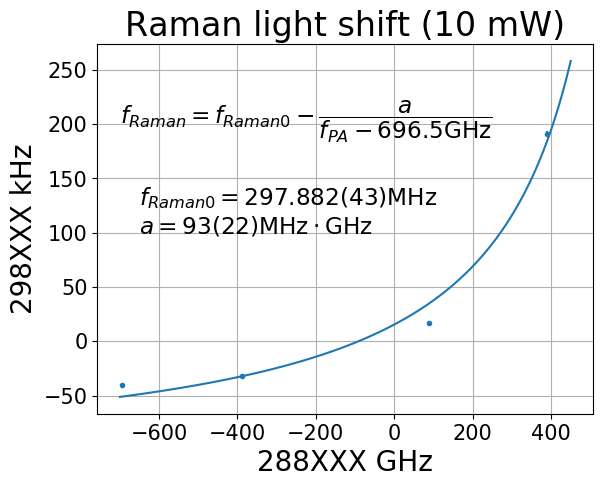
experiments/nacs_201904/imgs/data_20190407_raman_lines_resonance.png
