nacs-lab/yyc-data/experiments/nacs_201904/imgs/data_20190411_raman_lines_zoom.png

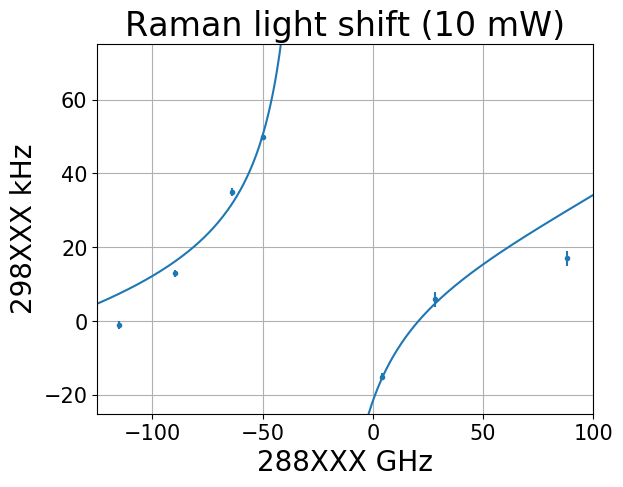
experiments/nacs_201904/imgs/data_20190411_raman_lines_zoom.png
