nacs-lab/yyc-data/experiments/nacs_201904/imgs/data_20190521_232054_lifetime_44_22.png

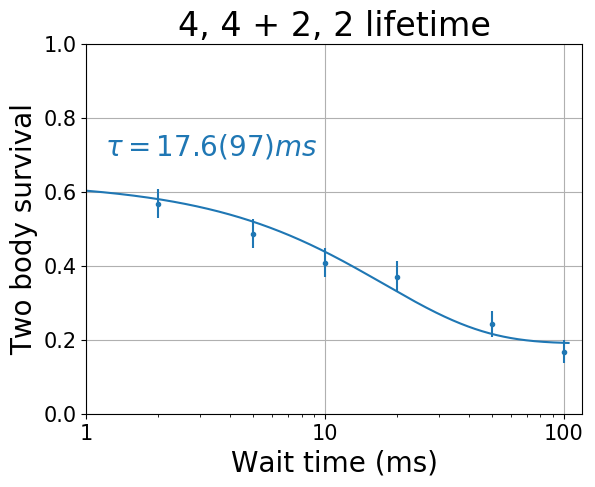
experiments/nacs_201904/imgs/data_20190521_232054_lifetime_44_22.png
