nacs-lab/yyc-data/experiments/nacs_201904/imgs/data_20190521_lifetime_cmp_lin.png

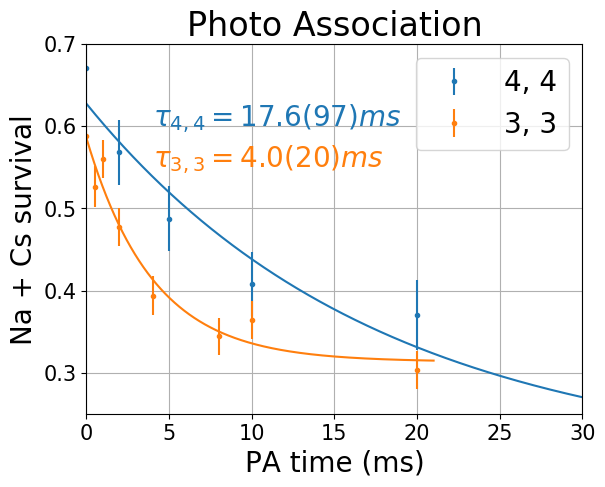
experiments/nacs_201904/imgs/data_20190521_lifetime_cmp_lin.png
