nacs-lab/yyc-data/experiments/nacs_201904/imgs/data_20190522_073239_lifetime_33_22.png

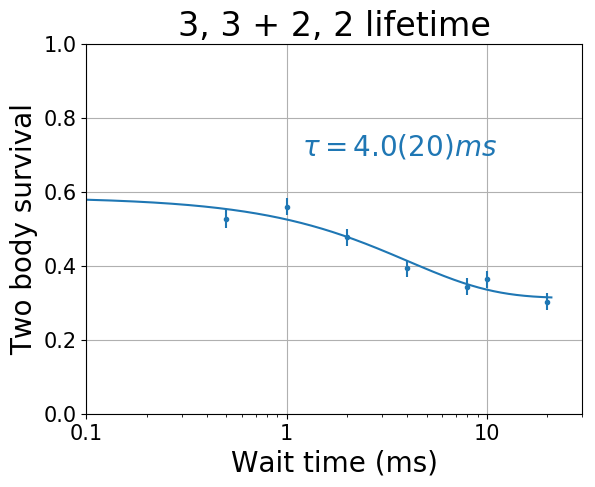
experiments/nacs_201904/imgs/data_20190522_073239_lifetime_33_22.png
