nacs-lab/yyc-data/experiments/nacs_201906/imgs/data_20190608_002026_temp_cs_ry.png

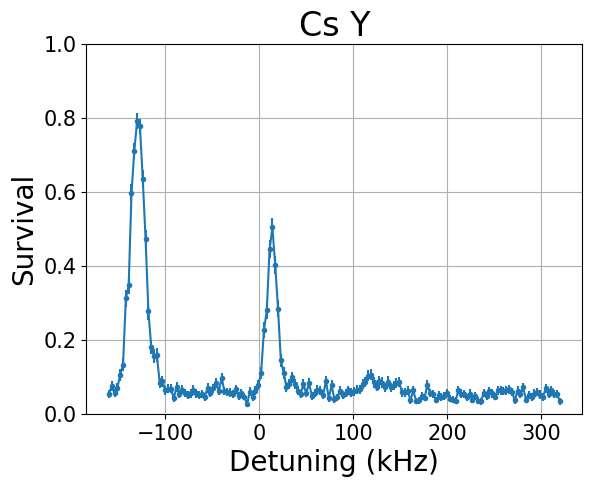
experiments/nacs_201906/imgs/data_20190608_002026_temp_cs_ry.png
