nacs-lab/yyc-data/experiments/nacs_201907/imgs/data_20190708_220845_mot.png

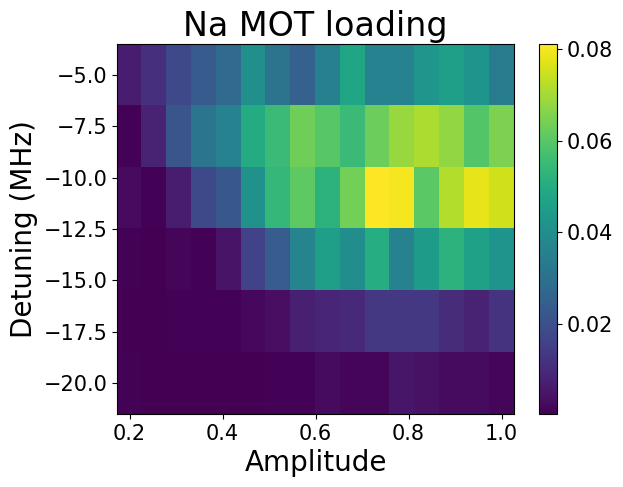
experiments/nacs_201907/imgs/data_20190708_220845_mot.png
