nacs-lab/yyc-data/experiments/nacs_201907/imgs/data_20190726_124910_temp_na.png

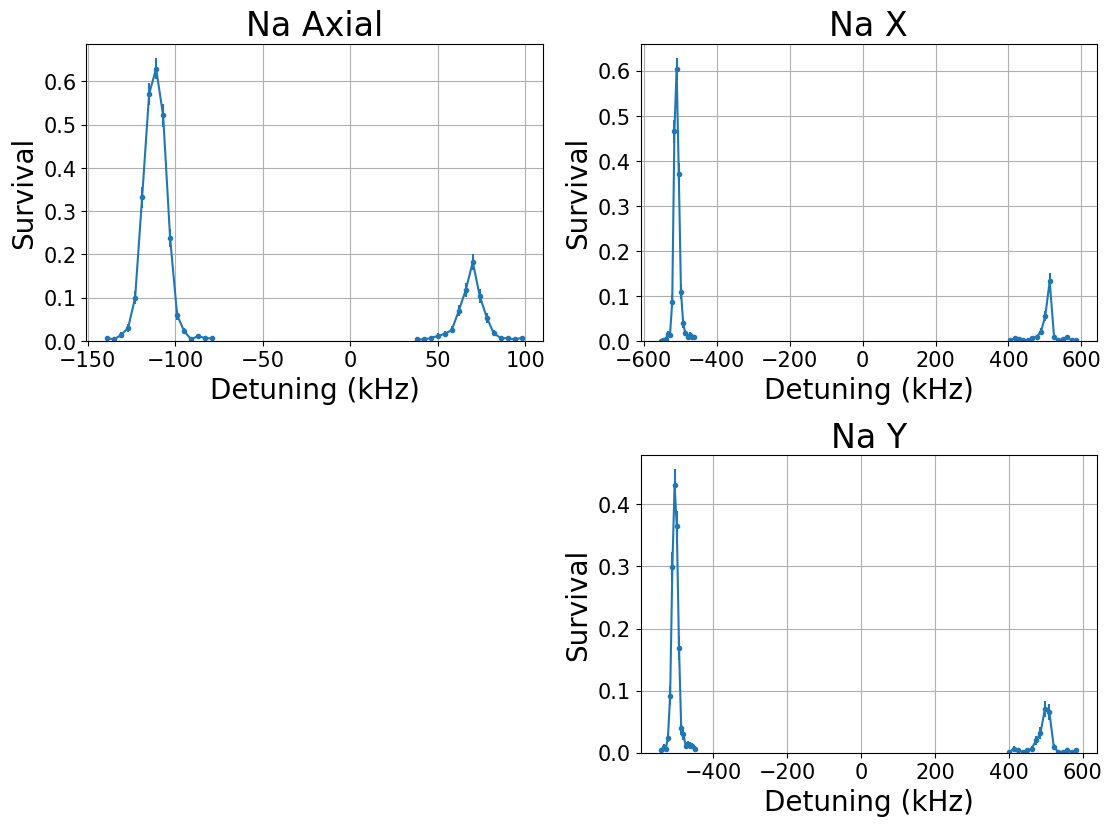
experiments/nacs_201907/imgs/data_20190726_124910_temp_na.png
