nacs-lab/yyc-data/experiments/nacs_201908/imgs/data_201908_pa_res_freq.png

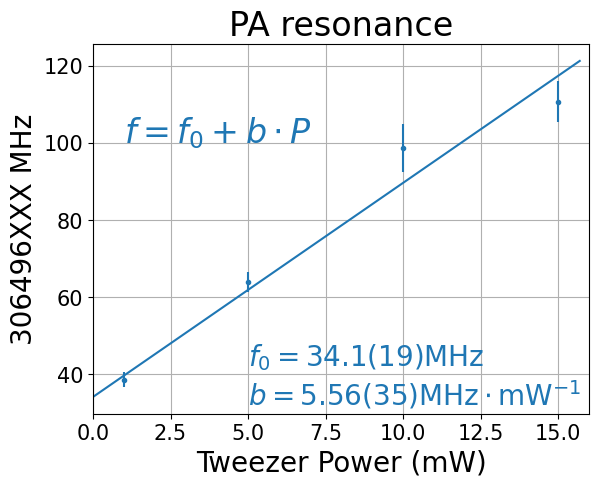
experiments/nacs_201908/imgs/data_201908_pa_res_freq.png
