nacs-lab/yyc-data/experiments/nacs_201908/imgs/data_20190803_125057_lifetime_33_22_taus.png

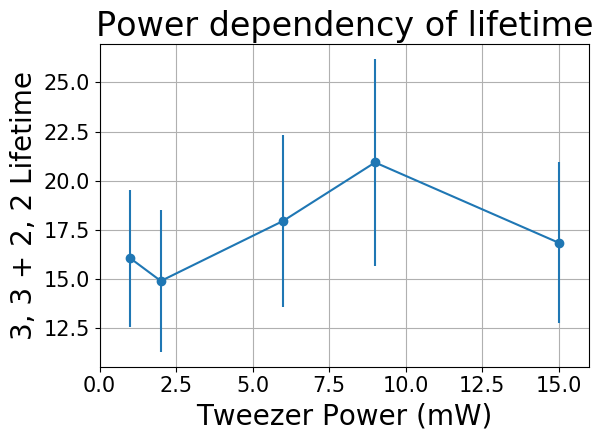
experiments/nacs_201908/imgs/data_20190803_125057_lifetime_33_22_taus.png
