nacs-lab/yyc-data/experiments/nacs_201908/imgs/data_20190809_133140_raman_scatter_na.png

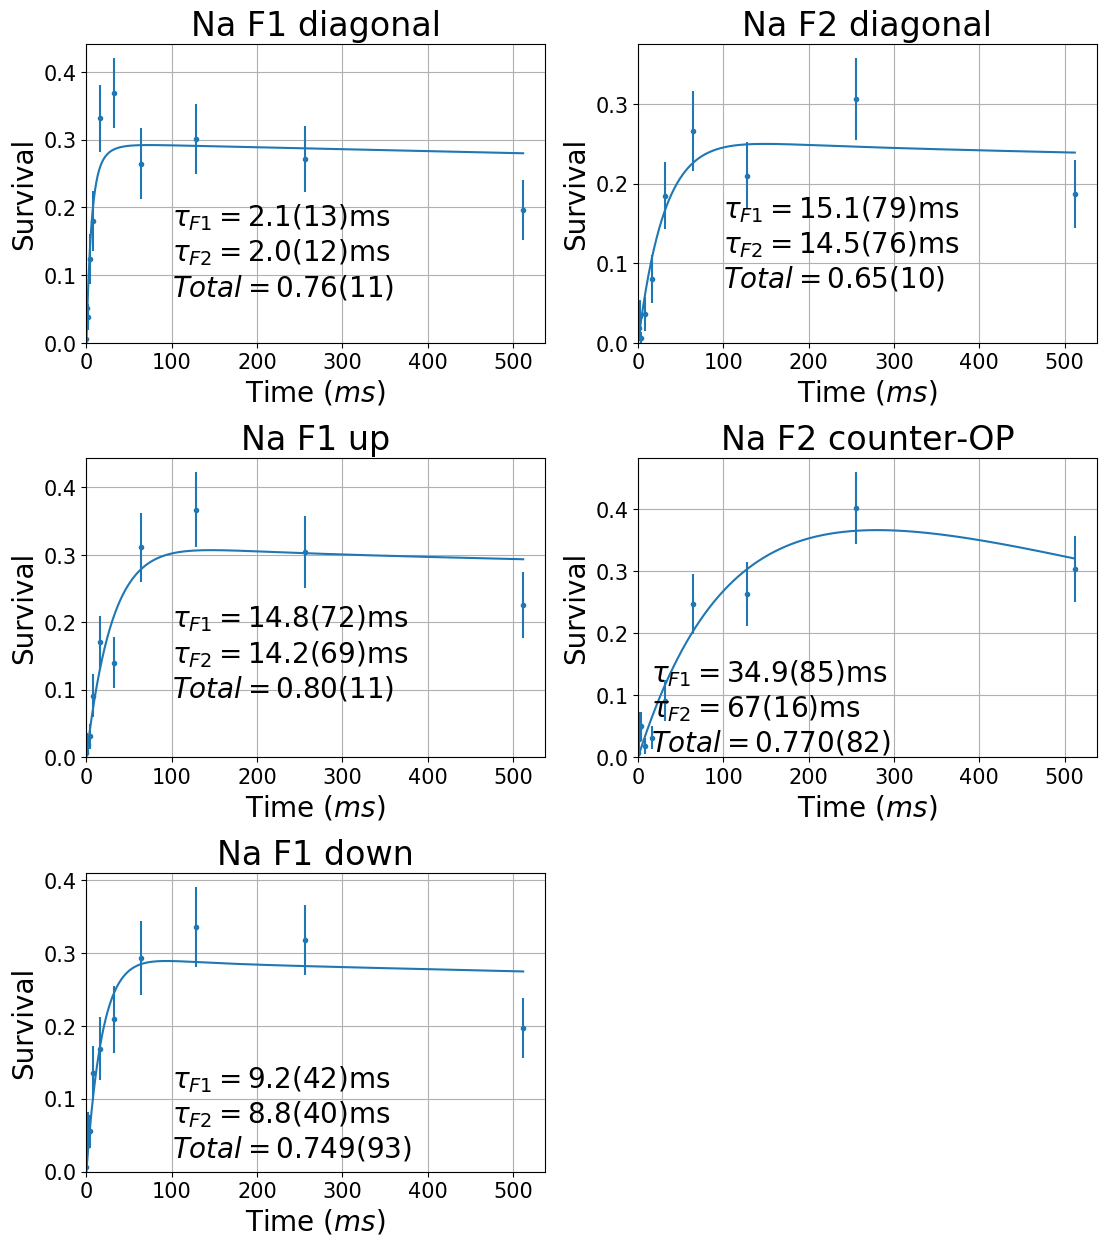
experiments/nacs_201908/imgs/data_20190809_133140_raman_scatter_na.png
