nacs-lab/yyc-data/experiments/nacs_201909/imgs/data_20190906_004202_depump_b_cs.png

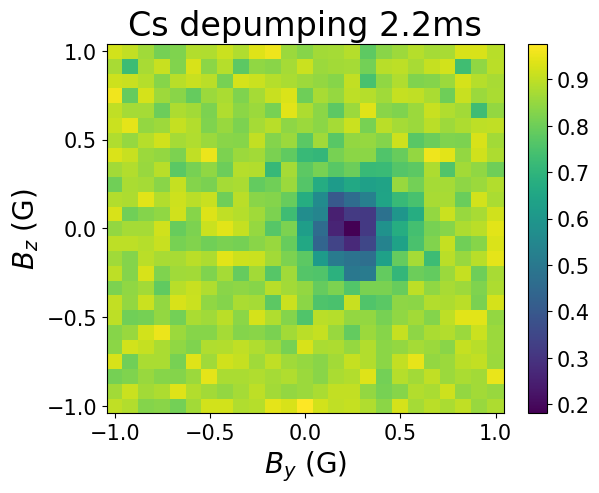
experiments/nacs_201909/imgs/data_20190906_004202_depump_b_cs.png
