nacs-lab/yyc-data/experiments/nacs_201909/imgs/data_20190910_raman_freq.png

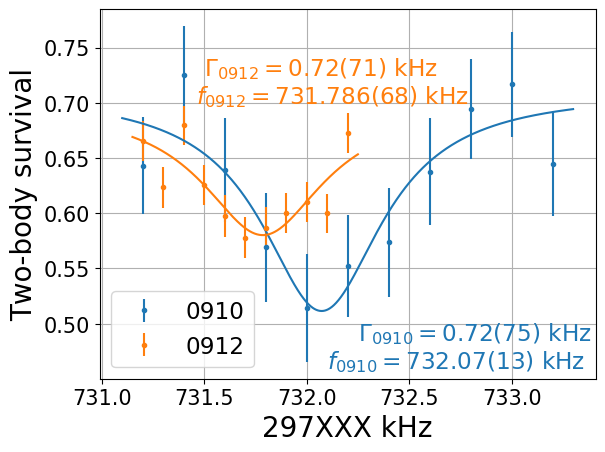
experiments/nacs_201909/imgs/data_20190910_raman_freq.png
