nacs-lab/yyc-data/experiments/nacs_201909/imgs/data_20190919_000110_raman_fluctuation_diff.png

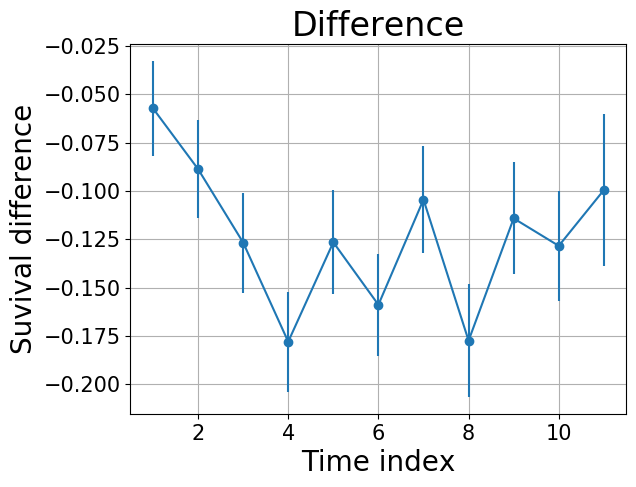
experiments/nacs_201909/imgs/data_20190919_000110_raman_fluctuation_diff.png
