nacs-lab/yyc-data/experiments/nacs_201912/imgs/data_20191221_100351_temp_na.png

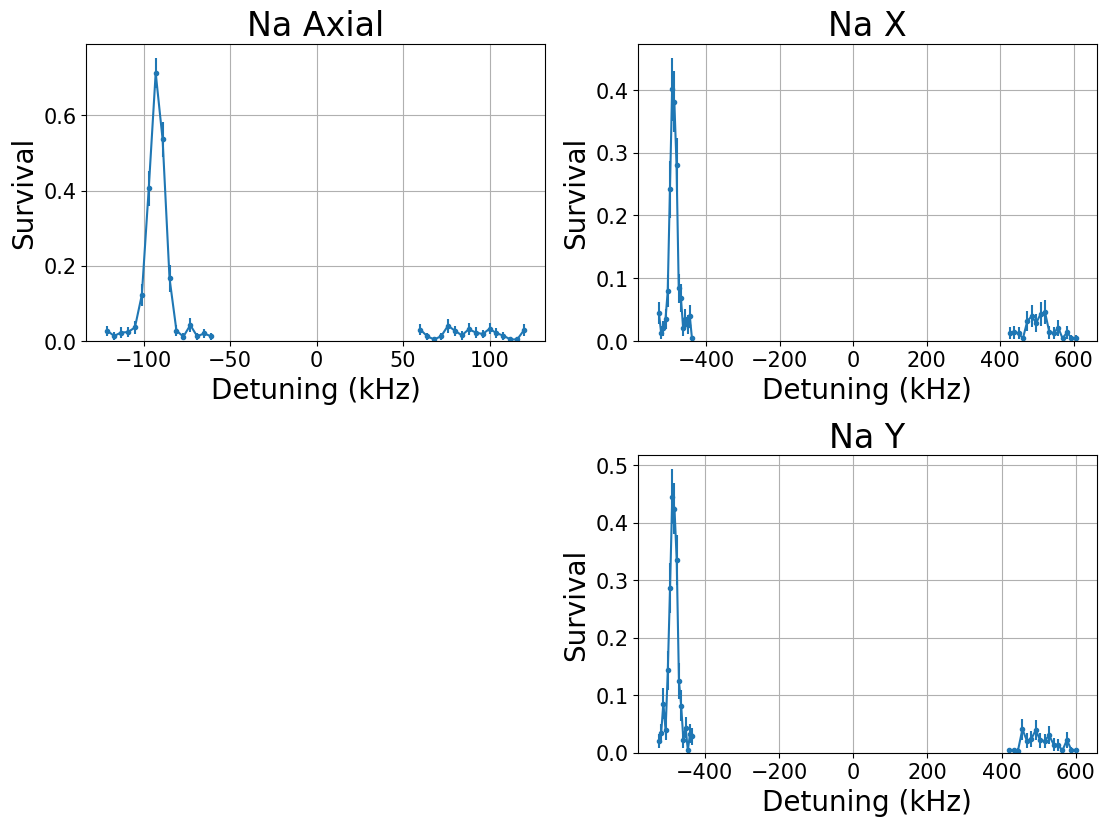
experiments/nacs_201912/imgs/data_20191221_100351_temp_na.png
