nacs-lab/yyc-data/experiments/nacs_201912/imgs/data_20191221_153859_rabi_cs.png

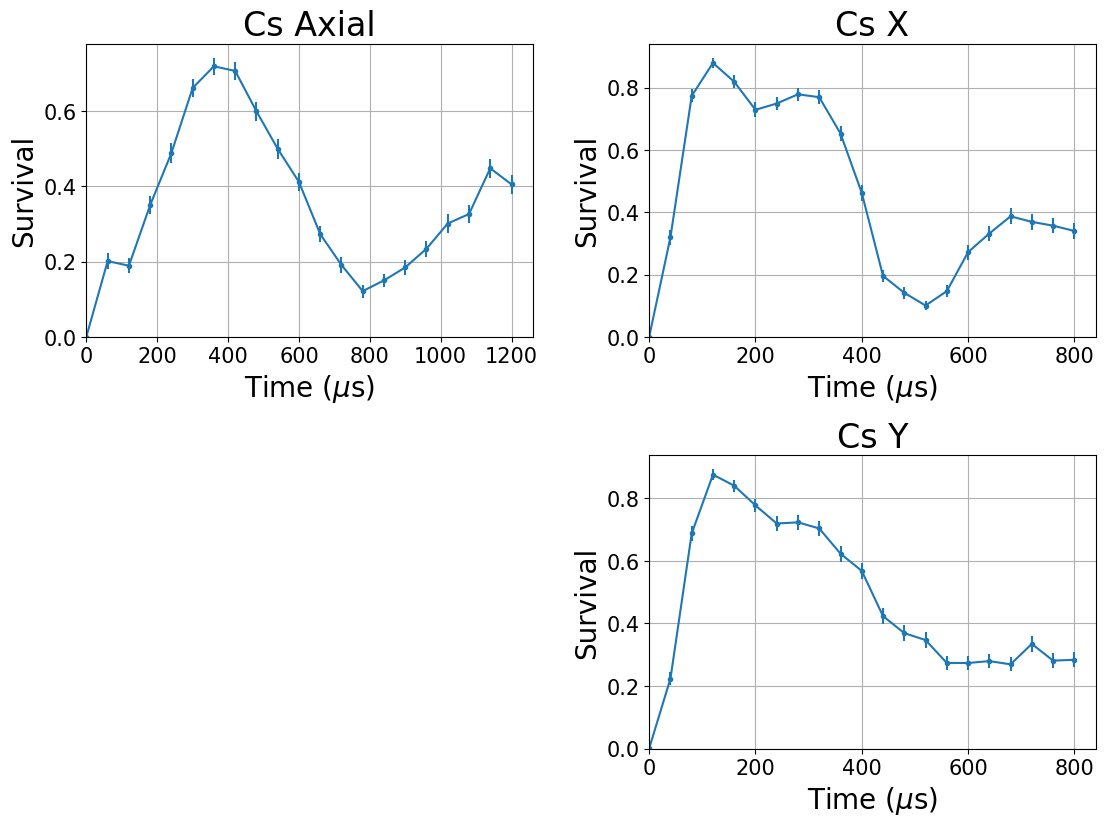
experiments/nacs_201912/imgs/data_20191221_153859_rabi_cs.png
