nacs-lab/yyc-data/experiments/nacs_201912/imgs/data_20191227_raman_det_3311.png

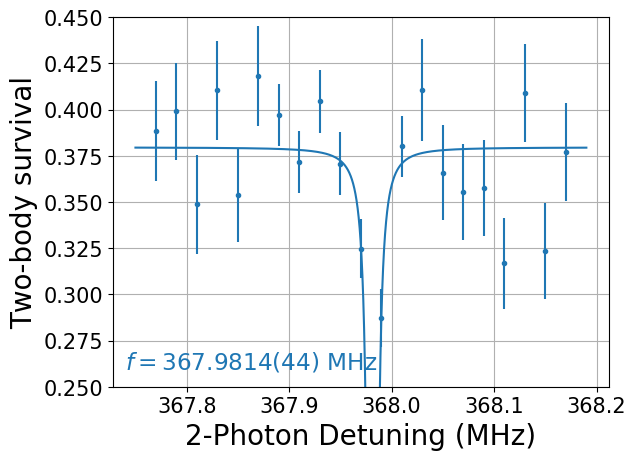
experiments/nacs_201912/imgs/data_20191227_raman_det_3311.png
