nacs-lab/yyc-data/experiments/nacs_202001/imgs/data_20200103_200743_raman_det_3311.png

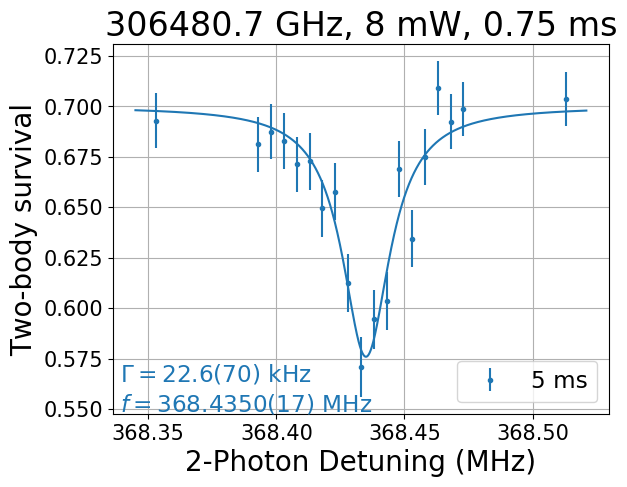
experiments/nacs_202001/imgs/data_20200103_200743_raman_det_3311.png
