nacs-lab/yyc-data/experiments/nacs_202001/imgs/data_20200104_141253_raman_time_3311.png

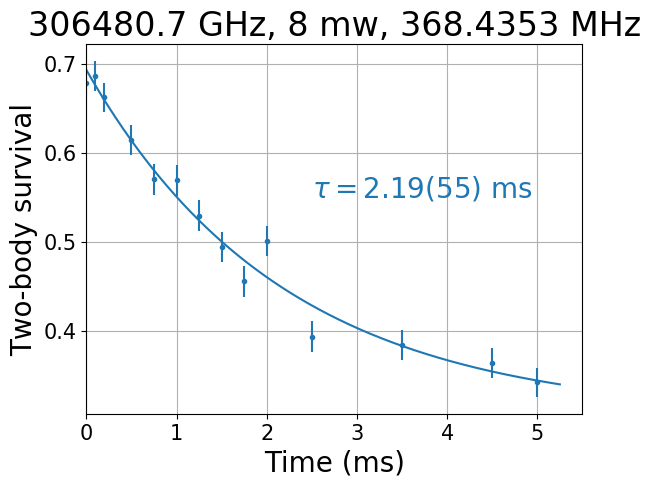
experiments/nacs_202001/imgs/data_20200104_141253_raman_time_3311.png
