nacs-lab/yyc-data/experiments/nacs_202001/imgs/data_20200105_123902_raman_time_3311_det.png

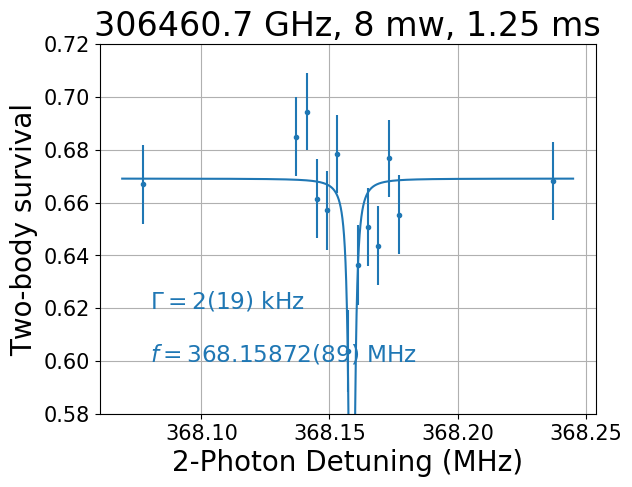
experiments/nacs_202001/imgs/data_20200105_123902_raman_time_3311_det.png
