nacs-lab/yyc-data/experiments/nacs_202001/imgs/data_20200109_103816_raman_time_3311.png

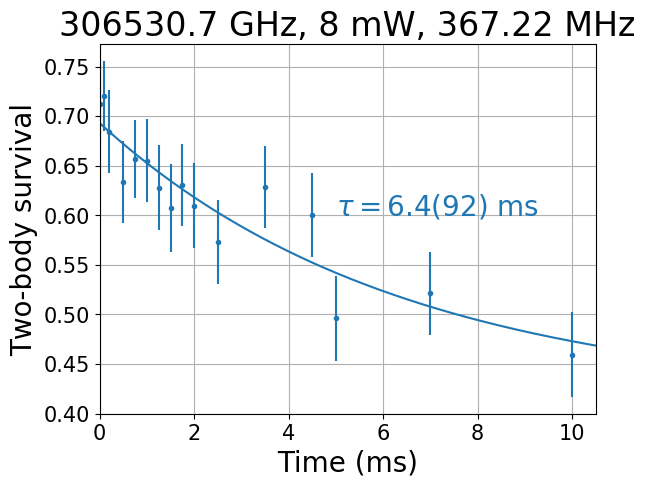
experiments/nacs_202001/imgs/data_20200109_103816_raman_time_3311.png
