nacs-lab/yyc-data/experiments/nacs_202001/imgs/data_20200109_171513_raman_time_3311.png

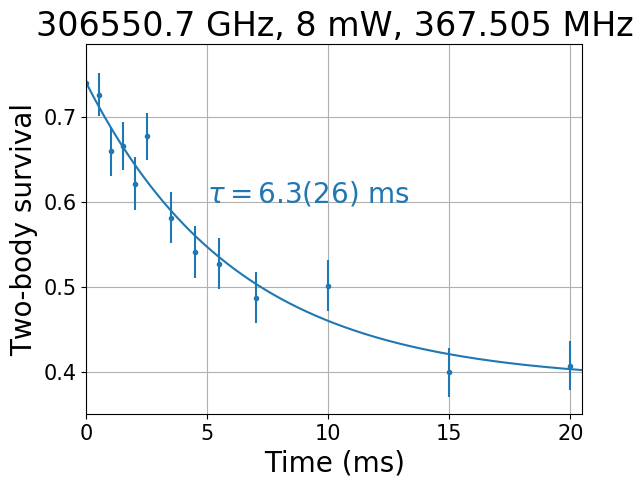
experiments/nacs_202001/imgs/data_20200109_171513_raman_time_3311.png
