nacs-lab/yyc-data/experiments/nacs_202001/imgs/data_20200131_170106_raman_time_3311.png

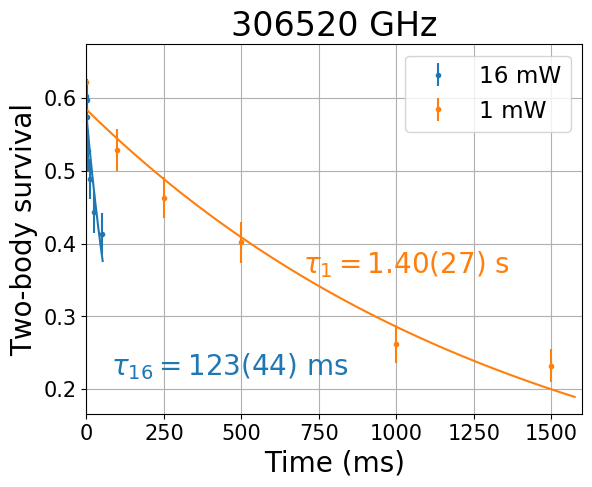
experiments/nacs_202001/imgs/data_20200131_170106_raman_time_3311.png
