nacs-lab/yyc-data/experiments/nacs_202001/imgs/data_20200131_235704_raman_det_3311.png

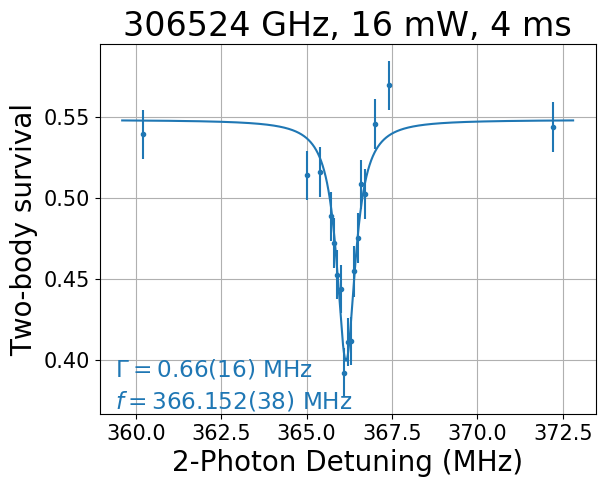
experiments/nacs_202001/imgs/data_20200131_235704_raman_det_3311.png
