nacs-lab/yyc-data/experiments/nacs_202002/imgs/data_20200201_133647_raman_det_3311.png

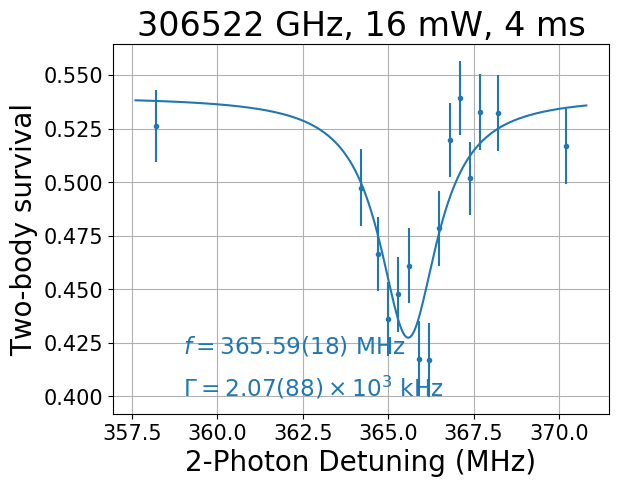
experiments/nacs_202002/imgs/data_20200201_133647_raman_det_3311.png
