nacs-lab/yyc-data/experiments/nacs_202002/imgs/data_20200203_153055_raman_det_3311.png

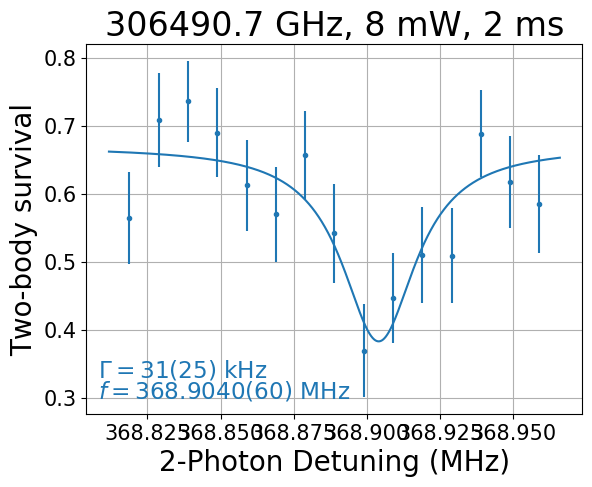
experiments/nacs_202002/imgs/data_20200203_153055_raman_det_3311.png
