nacs-lab/yyc-data/experiments/nacs_202002/imgs/data_20200204_232730_raman_det_3311_1.png

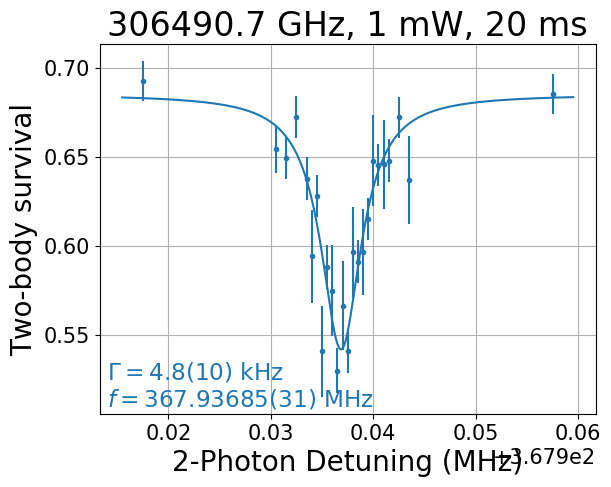
experiments/nacs_202002/imgs/data_20200204_232730_raman_det_3311_1.png
