nacs-lab/yyc-data/experiments/nacs_202002/imgs/data_20200205_raman_vs_power_3311_fres.png

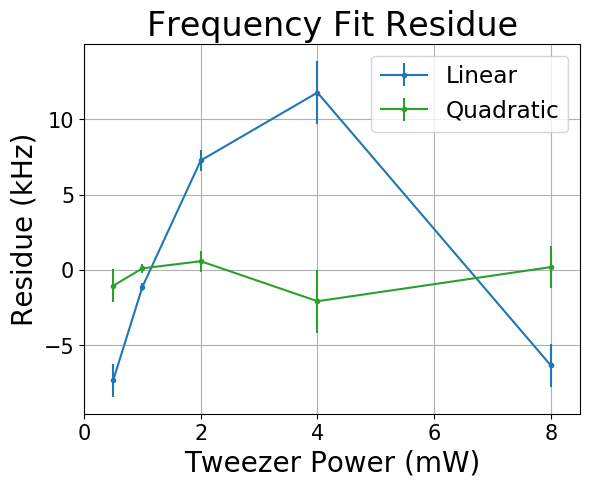
experiments/nacs_202002/imgs/data_20200205_raman_vs_power_3311_fres.png
