nacs-lab/yyc-data/experiments/nacs_202002/imgs/data_20200206_coprop_raman_coherence.png

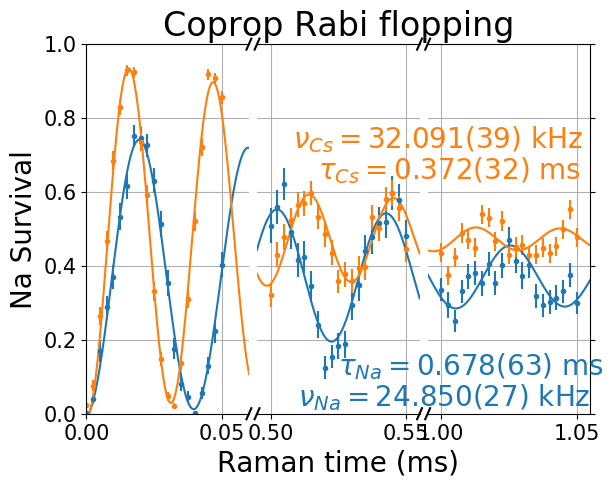
experiments/nacs_202002/imgs/data_20200206_coprop_raman_coherence.png
