nacs-lab/yyc-data/experiments/nacs_202002/imgs/data_20200215_101243_pa_492.png

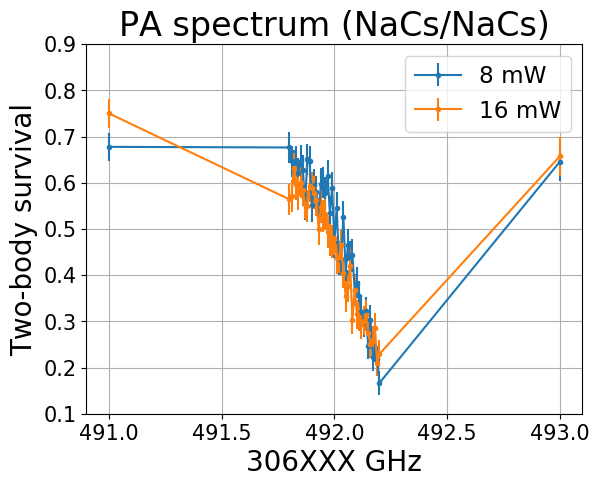
experiments/nacs_202002/imgs/data_20200215_101243_pa_492.png
