nacs-lab/yyc-data/experiments/nacs_202002/imgs/data_20200215_101243_pa_492_1b2b.png

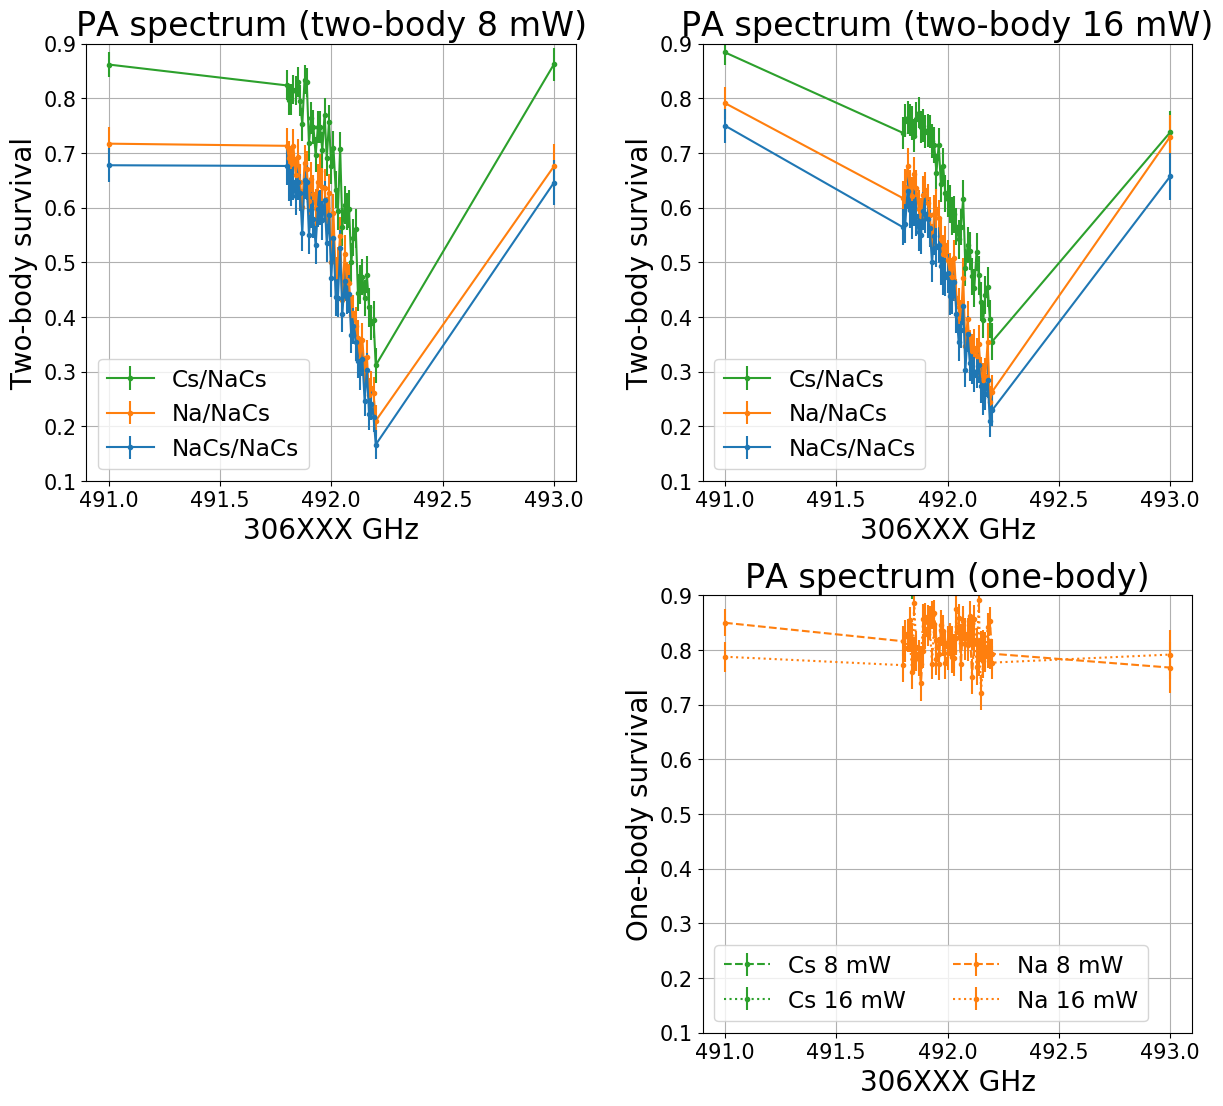
experiments/nacs_202002/imgs/data_20200215_101243_pa_492_1b2b.png
