nacs-lab/yyc-data/experiments/nacs_202002/imgs/data_20200215_223029_pa_492_1b.png

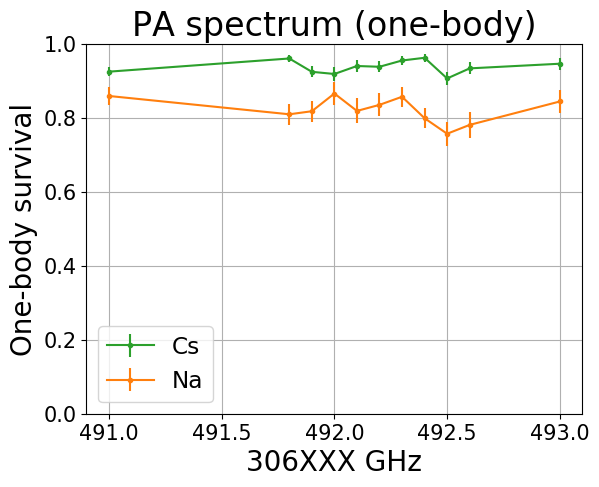
experiments/nacs_202002/imgs/data_20200215_223029_pa_492_1b.png
