nacs-lab/yyc-data/experiments/nacs_202002/imgs/data_20200216_005412_pa_492_1b.png

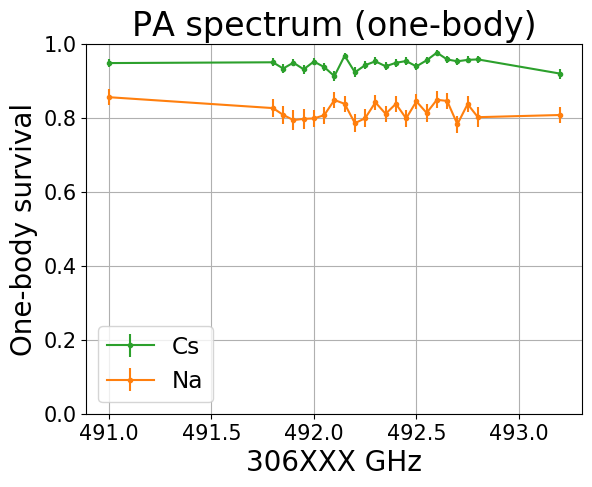
experiments/nacs_202002/imgs/data_20200216_005412_pa_492_1b.png
