nacs-lab/yyc-data/experiments/nacs_202002/imgs/data_20200227_115624_depump_na.png

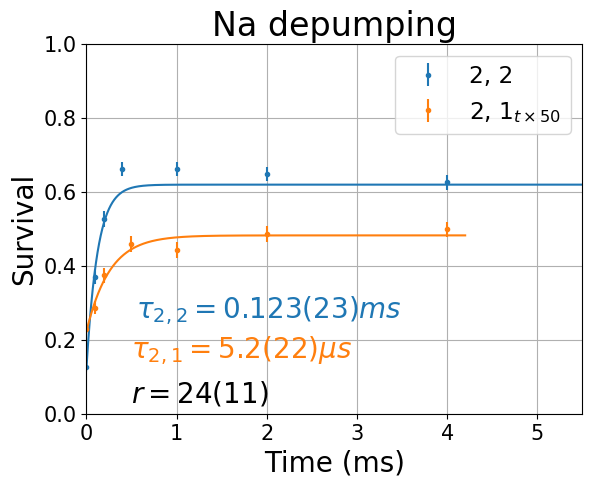
experiments/nacs_202002/imgs/data_20200227_115624_depump_na.png
