nacs-lab/yyc-data/experiments/nacs_202002/imgs/data_20200229_131611_depump_cs.png

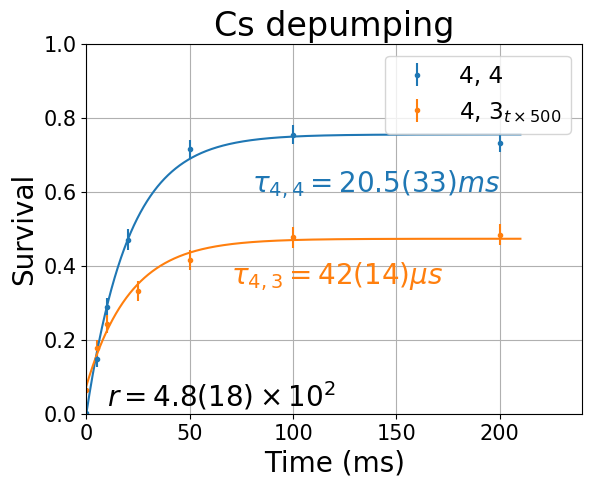
experiments/nacs_202002/imgs/data_20200229_131611_depump_cs.png
