nacs-lab/yyc-data/experiments/nacs_202003/imgs/data_20200303_011858_pa_3322_1b.png

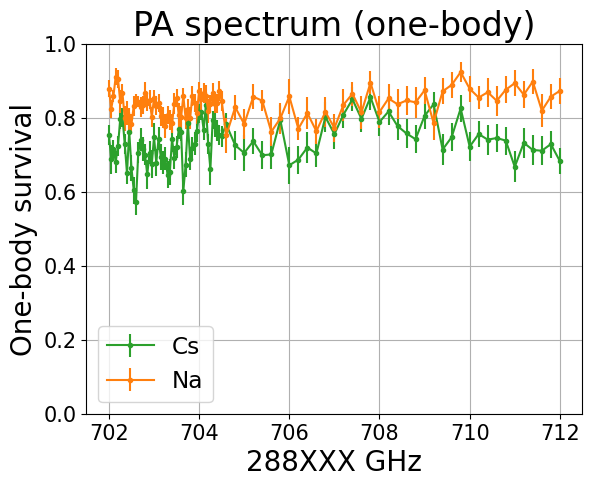
experiments/nacs_202003/imgs/data_20200303_011858_pa_3322_1b.png
