nacs-lab/yyc-data/experiments/nacs_202003/imgs/data_20200312_005807_raman_3322_det.png

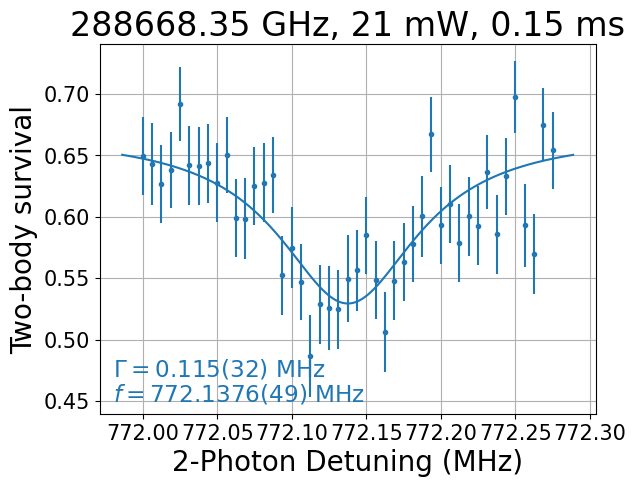
experiments/nacs_202003/imgs/data_20200312_005807_raman_3322_det.png
