nacs-lab/yyc-data/experiments/nacs_202003/imgs/data_20200313_160017_raman_det_3322.png

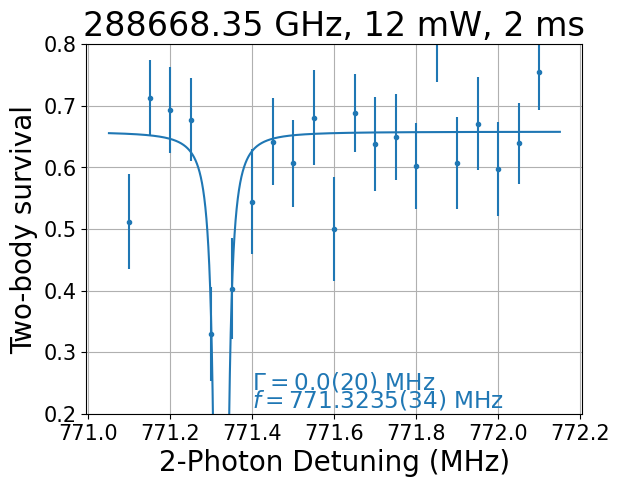
experiments/nacs_202003/imgs/data_20200313_160017_raman_det_3322.png
