nacs-lab/yyc-data/experiments/nacs_202003/imgs/data_20200316_183252_raman_time_3322.png

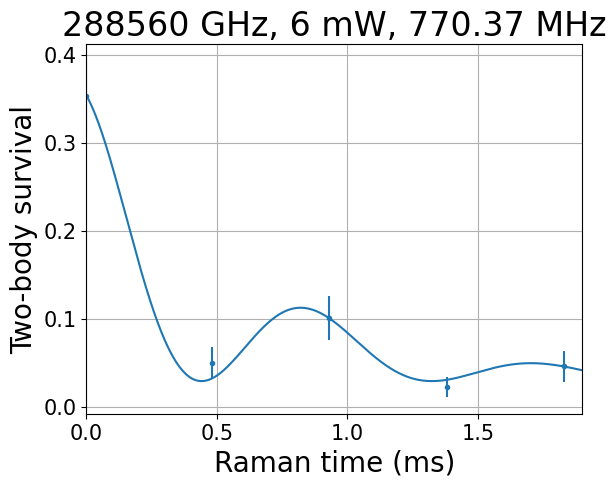
experiments/nacs_202003/imgs/data_20200316_183252_raman_time_3322.png
