nacs-lab/yyc-data/experiments/nacs_202003/imgs/data_20200317_002210_raman_time_3322.png

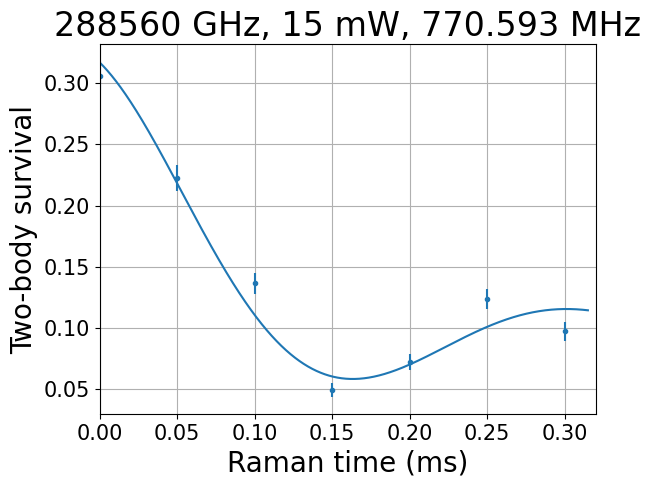
experiments/nacs_202003/imgs/data_20200317_002210_raman_time_3322.png
