nacs-lab/yyc-data/experiments/nacs_202003/imgs/data_20200317_231448_raman_det_3322.png

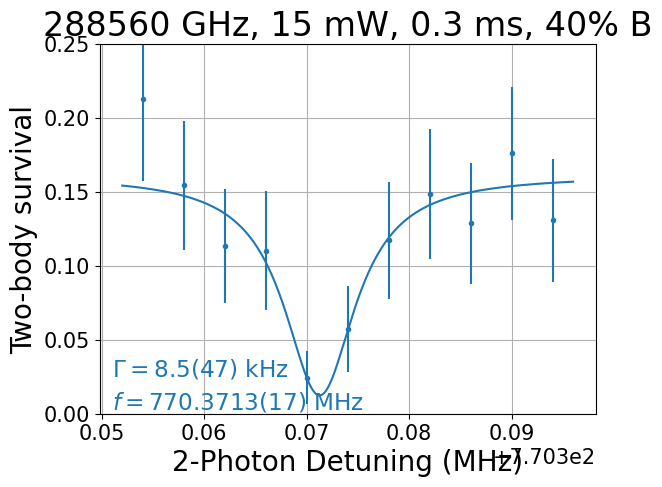
experiments/nacs_202003/imgs/data_20200317_231448_raman_det_3322.png
