nacs-lab/yyc-data/experiments/nacs_202003/imgs/data_20200317_raman_3322_vs_B.png

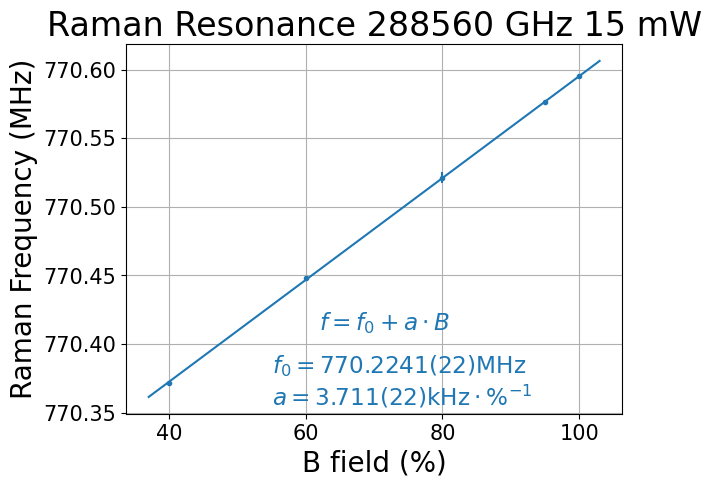
experiments/nacs_202003/imgs/data_20200317_raman_3322_vs_B.png
