nacs-lab/yyc-data/experiments/nacs_202003/imgs/data_20200326_005204_raman_det_3322.png

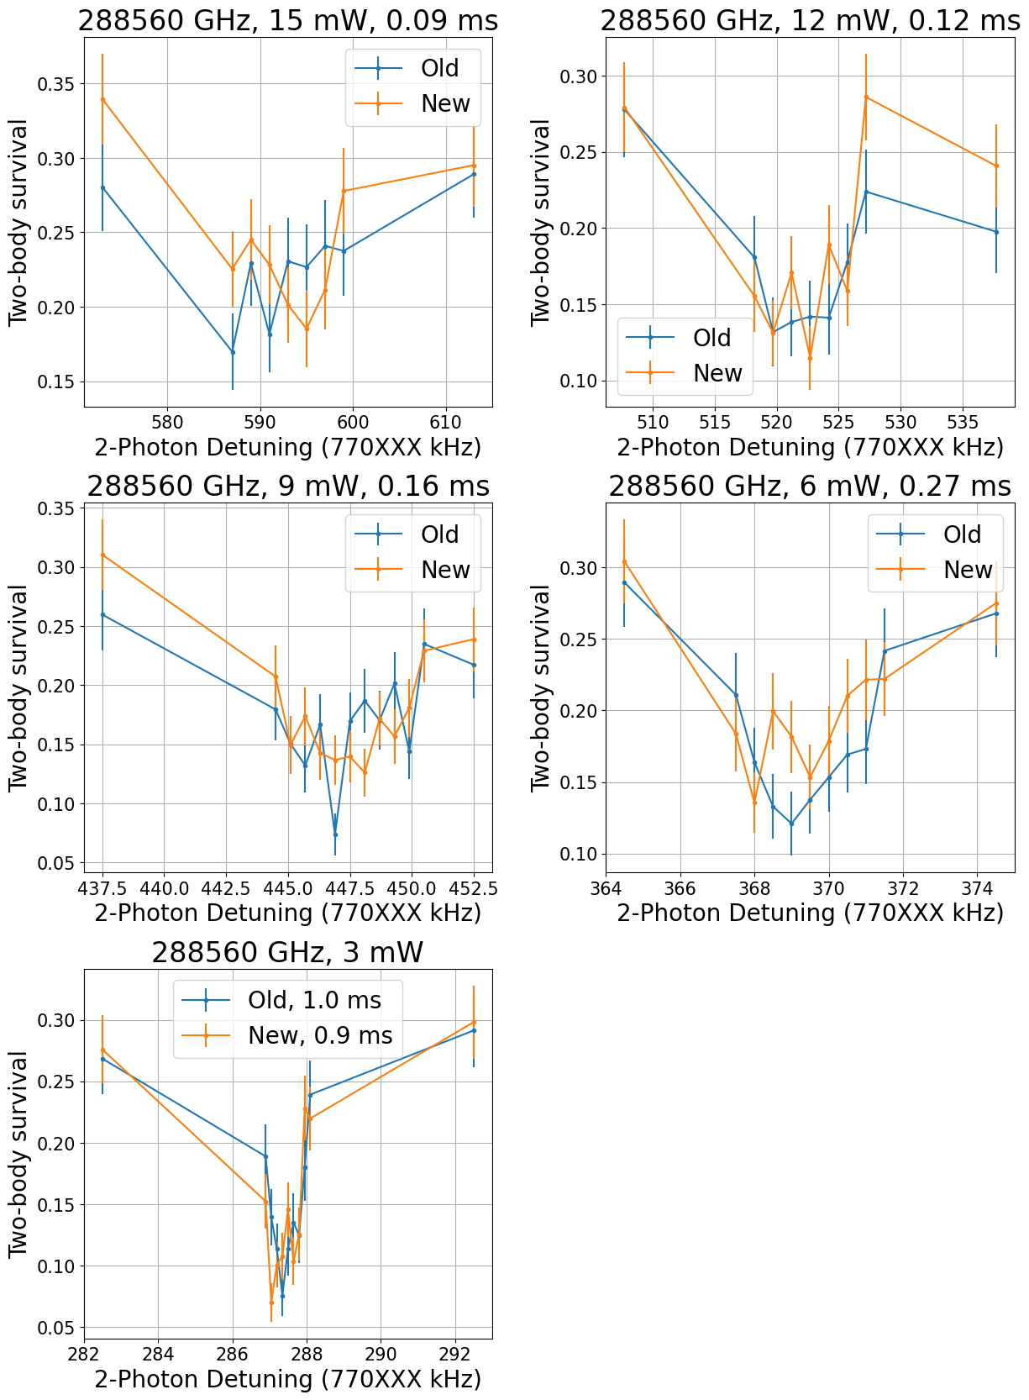
experiments/nacs_202003/imgs/data_20200326_005204_raman_det_3322.png
