nacs-lab/yyc-data/experiments/nacs_202003/imgs/data_20200328_200418_raman_time_3322.png

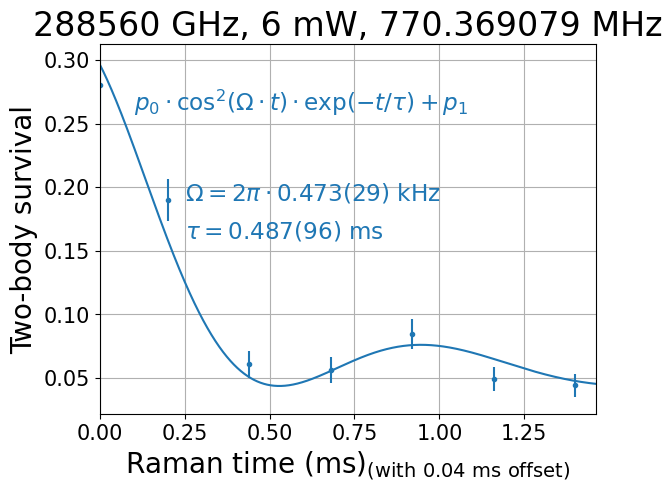
experiments/nacs_202003/imgs/data_20200328_200418_raman_time_3322.png
