nacs-lab/yyc-data/experiments/nacs_202003/imgs/fit_20200326_005204_raman_3322_2.png

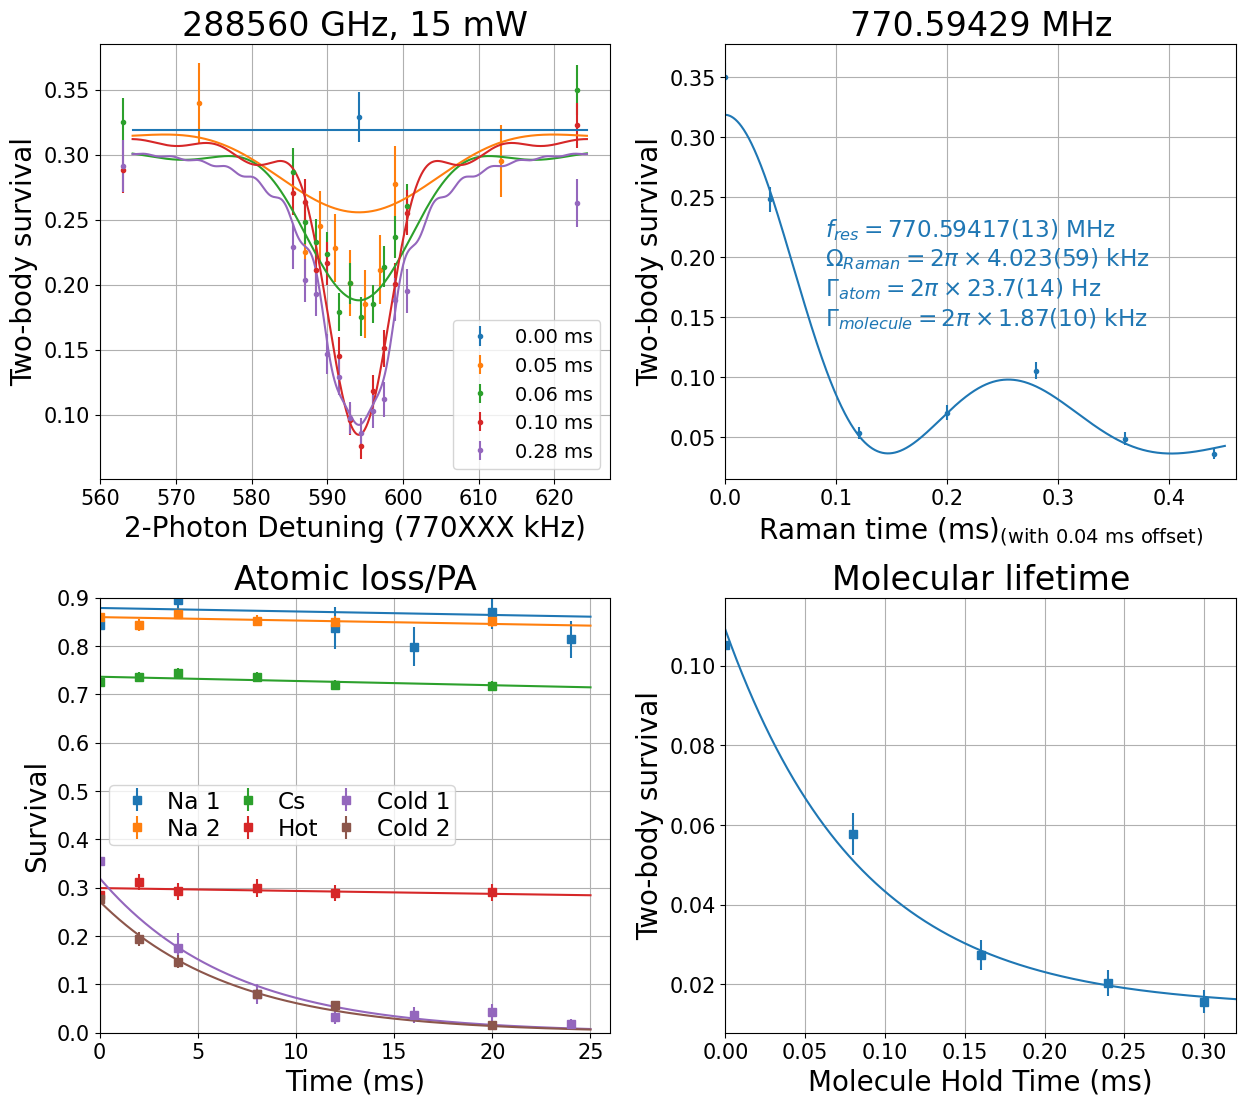
experiments/nacs_202003/imgs/fit_20200326_005204_raman_3322_2.png
