nacs-lab/yyc-data/experiments/nacs_202004/imgs/data_20200401_060025_molecule_lifetime_3322.png

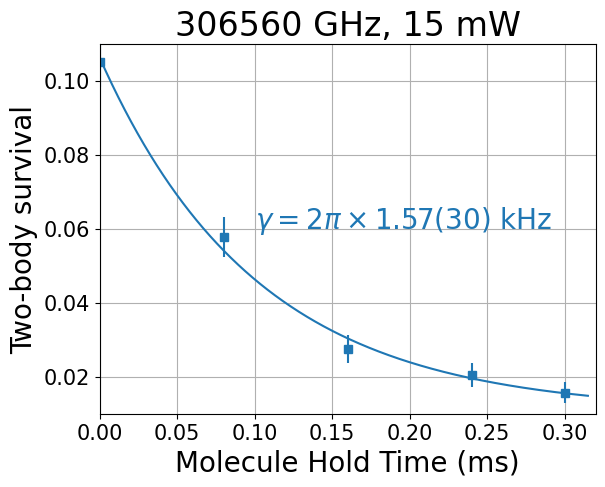
experiments/nacs_202004/imgs/data_20200401_060025_molecule_lifetime_3322.png
