nacs-lab/yyc-data/experiments/nacs_202004/imgs/data_20200402_122715_raman_det_3322.png

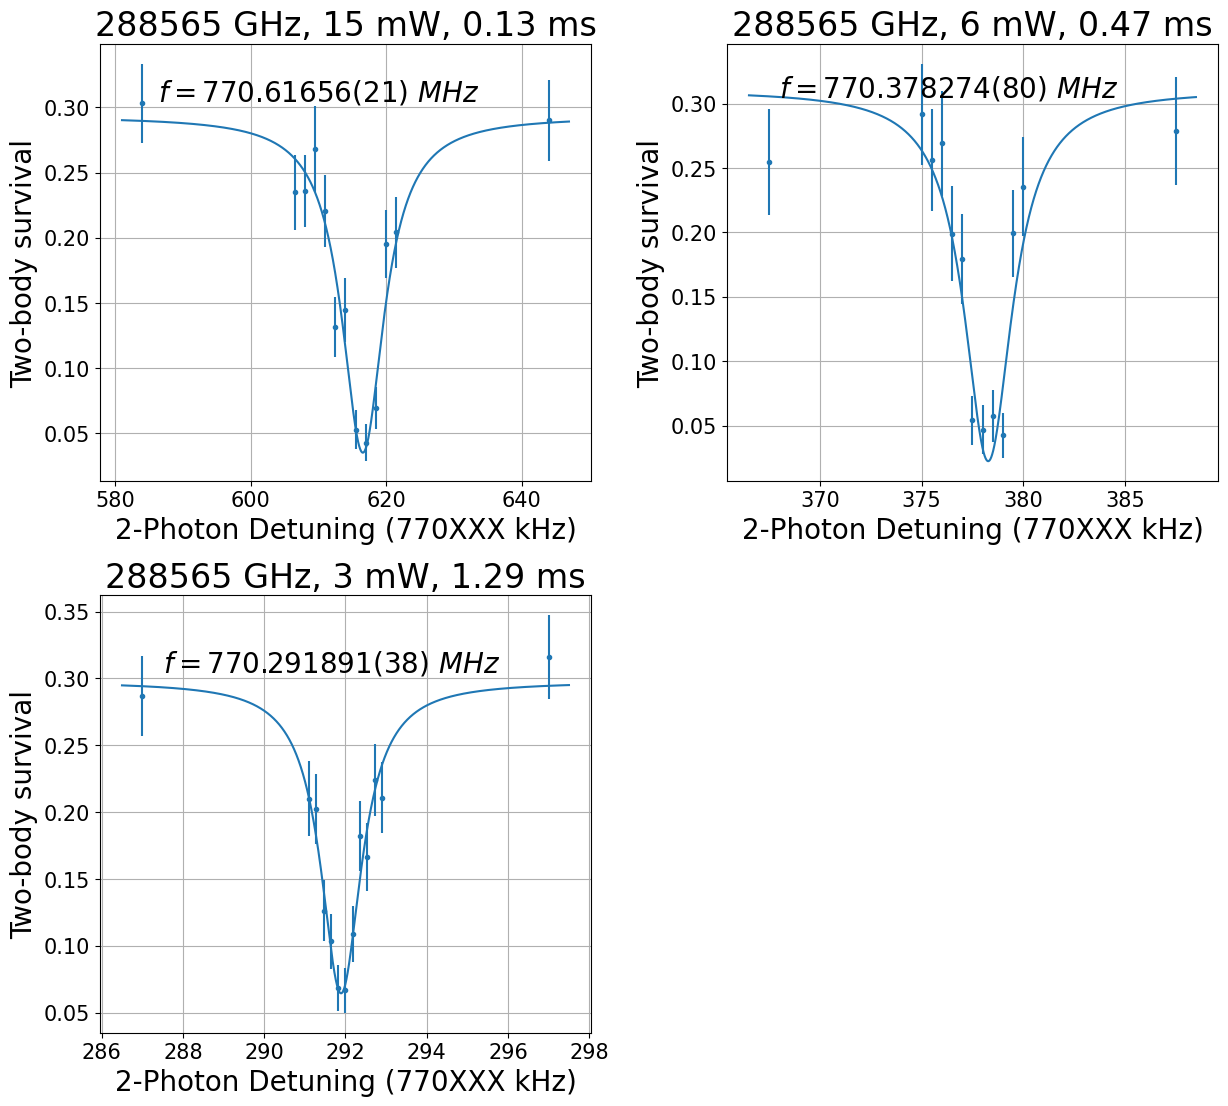
experiments/nacs_202004/imgs/data_20200402_122715_raman_det_3322.png
