nacs-lab/yyc-data/experiments/nacs_202004/imgs/data_20200408_raman_3322_vs_power_fres.png

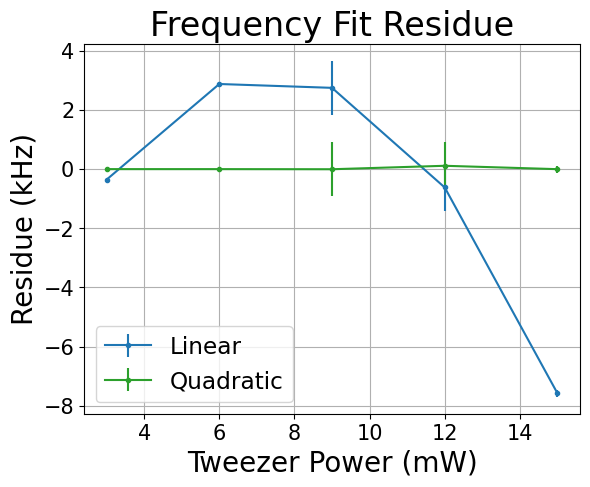
experiments/nacs_202004/imgs/data_20200408_raman_3322_vs_power_fres.png
