nacs-lab/yyc-data/experiments/nacs_202004/imgs/data_20200408_raman_vs_tweezer_3322.png

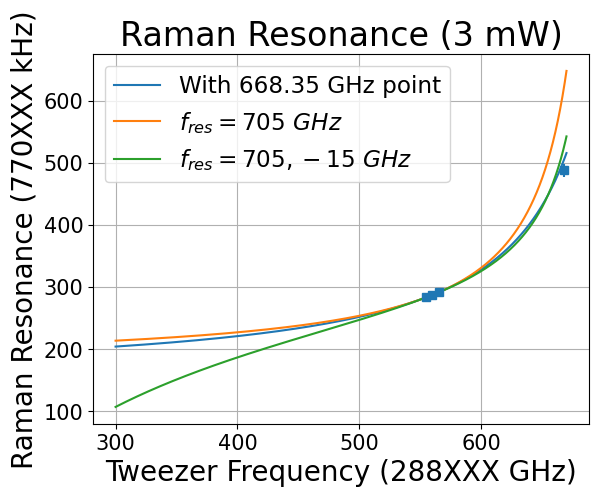
experiments/nacs_202004/imgs/data_20200408_raman_vs_tweezer_3322.png
