nacs-lab/yyc-data/experiments/nacs_202004/imgs/fit_20200423_113115_raman_3322_mol.png

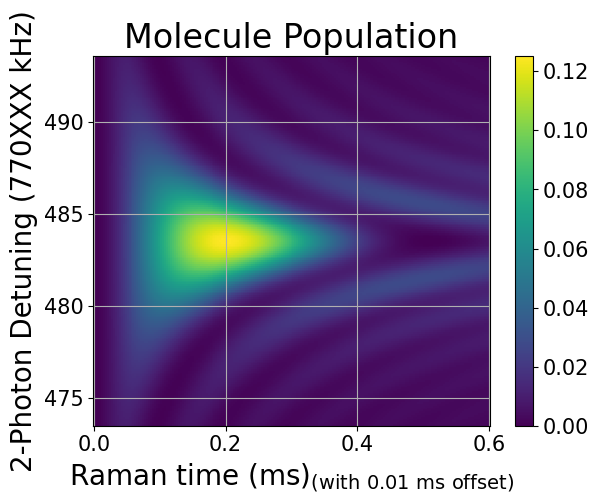
experiments/nacs_202004/imgs/fit_20200423_113115_raman_3322_mol.png
