nacs-lab/yyc-data/experiments/nacs_202004/imgs/fit_20200425_100050_raman_3322_t.png

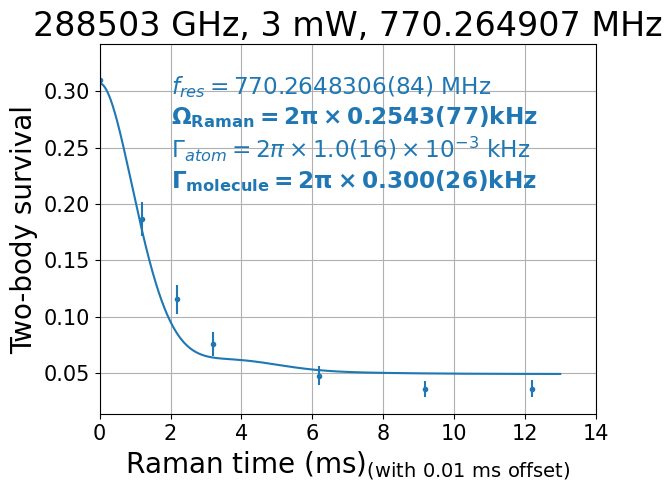
experiments/nacs_202004/imgs/fit_20200425_100050_raman_3322_t.png
