nacs-lab/yyc-data/experiments/nacs_202005/imgs/data_20200501_raman_vs_tweezer_3322_3.png

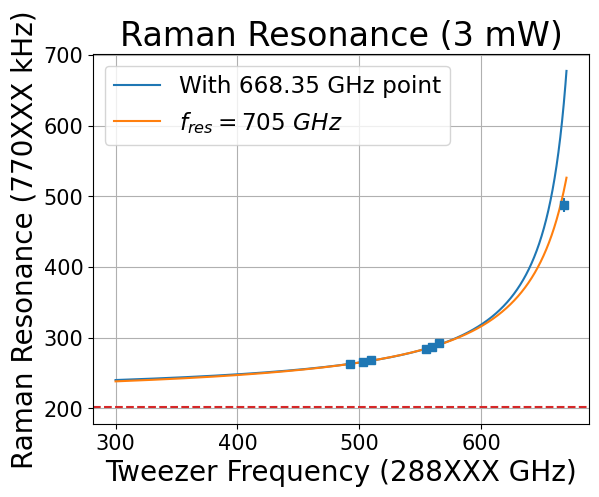
experiments/nacs_202005/imgs/data_20200501_raman_vs_tweezer_3322_3.png
