nacs-lab/yyc-data/experiments/nacs_202005/imgs/data_20200505_023054_raman_det_3322_fres.png

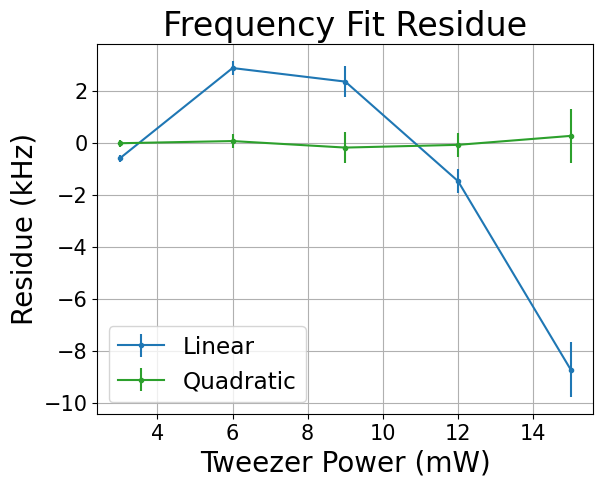
experiments/nacs_202005/imgs/data_20200505_023054_raman_det_3322_fres.png
