nacs-lab/yyc-data/experiments/nacs_202005/imgs/fit_20200506_122103_raman_3322_2.png

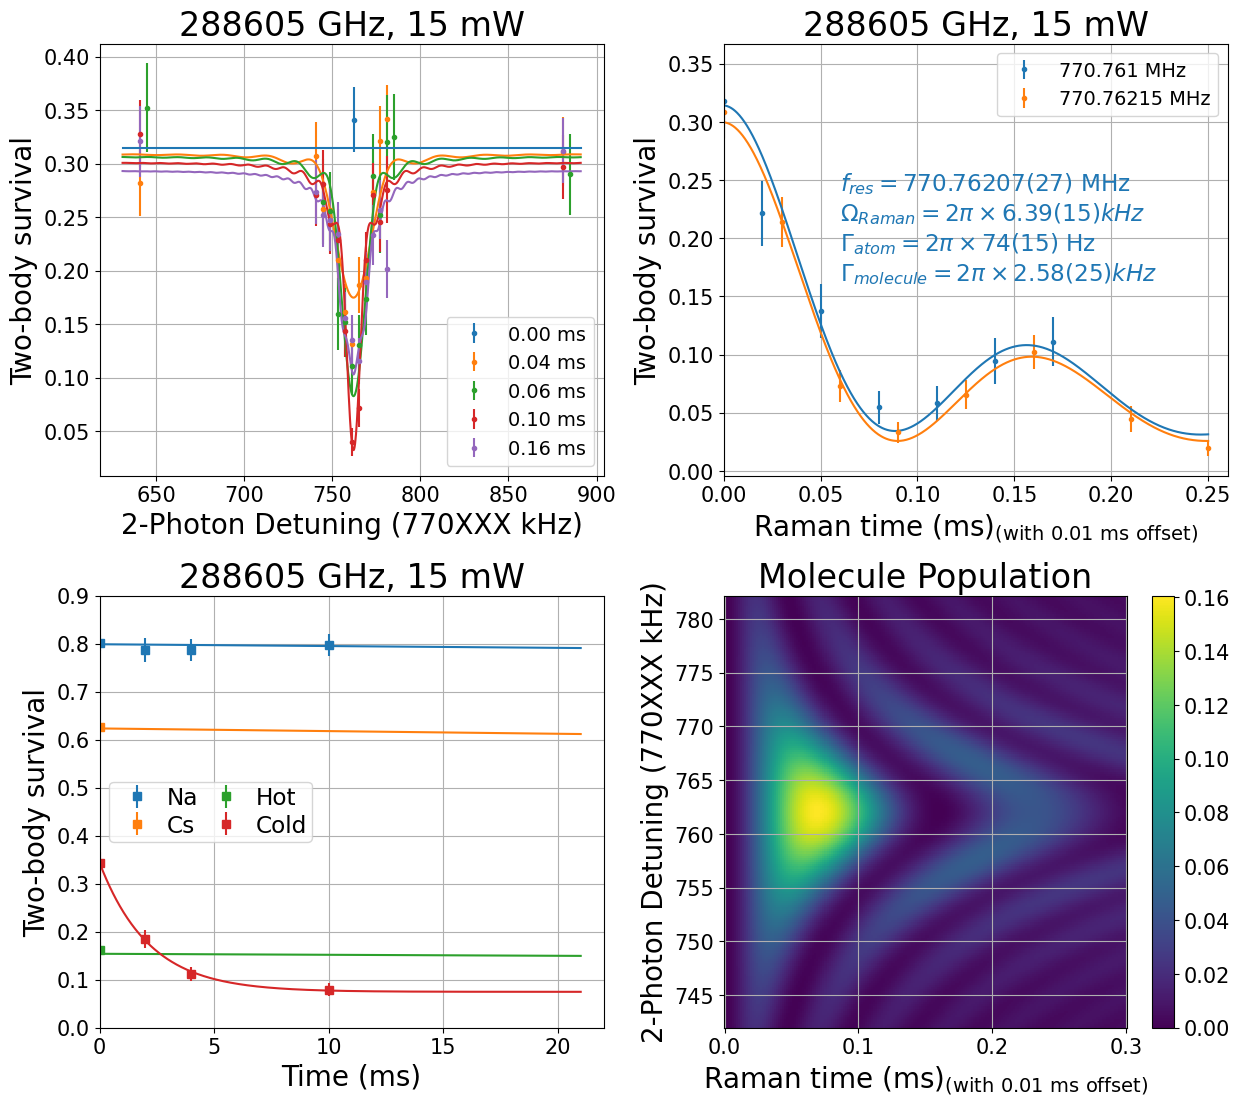
experiments/nacs_202005/imgs/fit_20200506_122103_raman_3322_2.png
