nacs-lab/yyc-data/experiments/nacs_202005/imgs/fit_20200507_172024_raman_3322.png

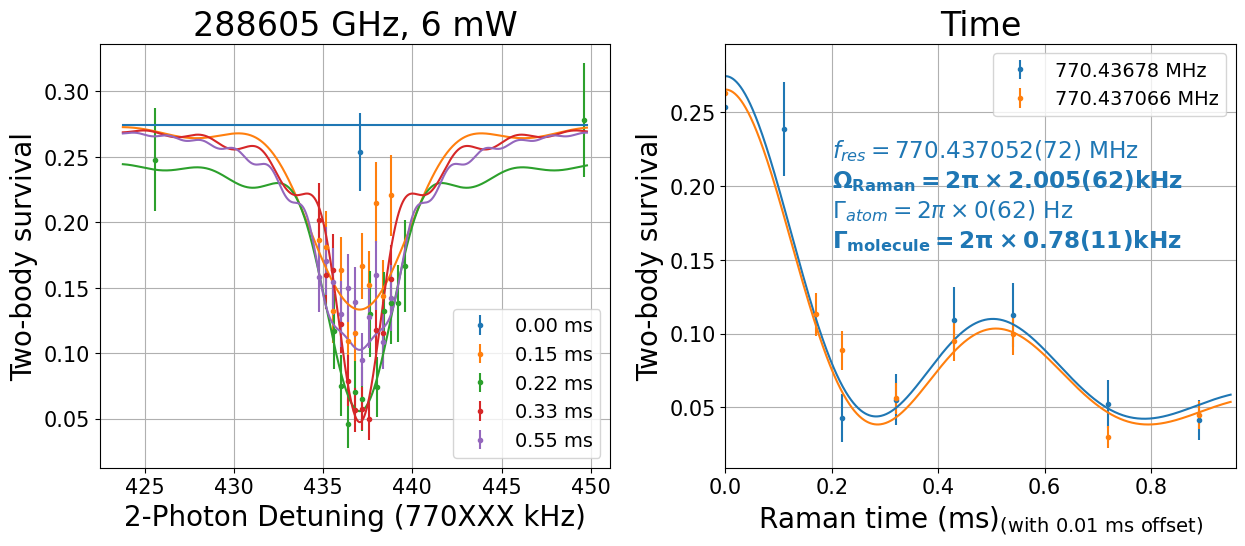
experiments/nacs_202005/imgs/fit_20200507_172024_raman_3322.png
