nacs-lab/yyc-data/experiments/nacs_202006/imgs/data_20200618_scaling_3322.png

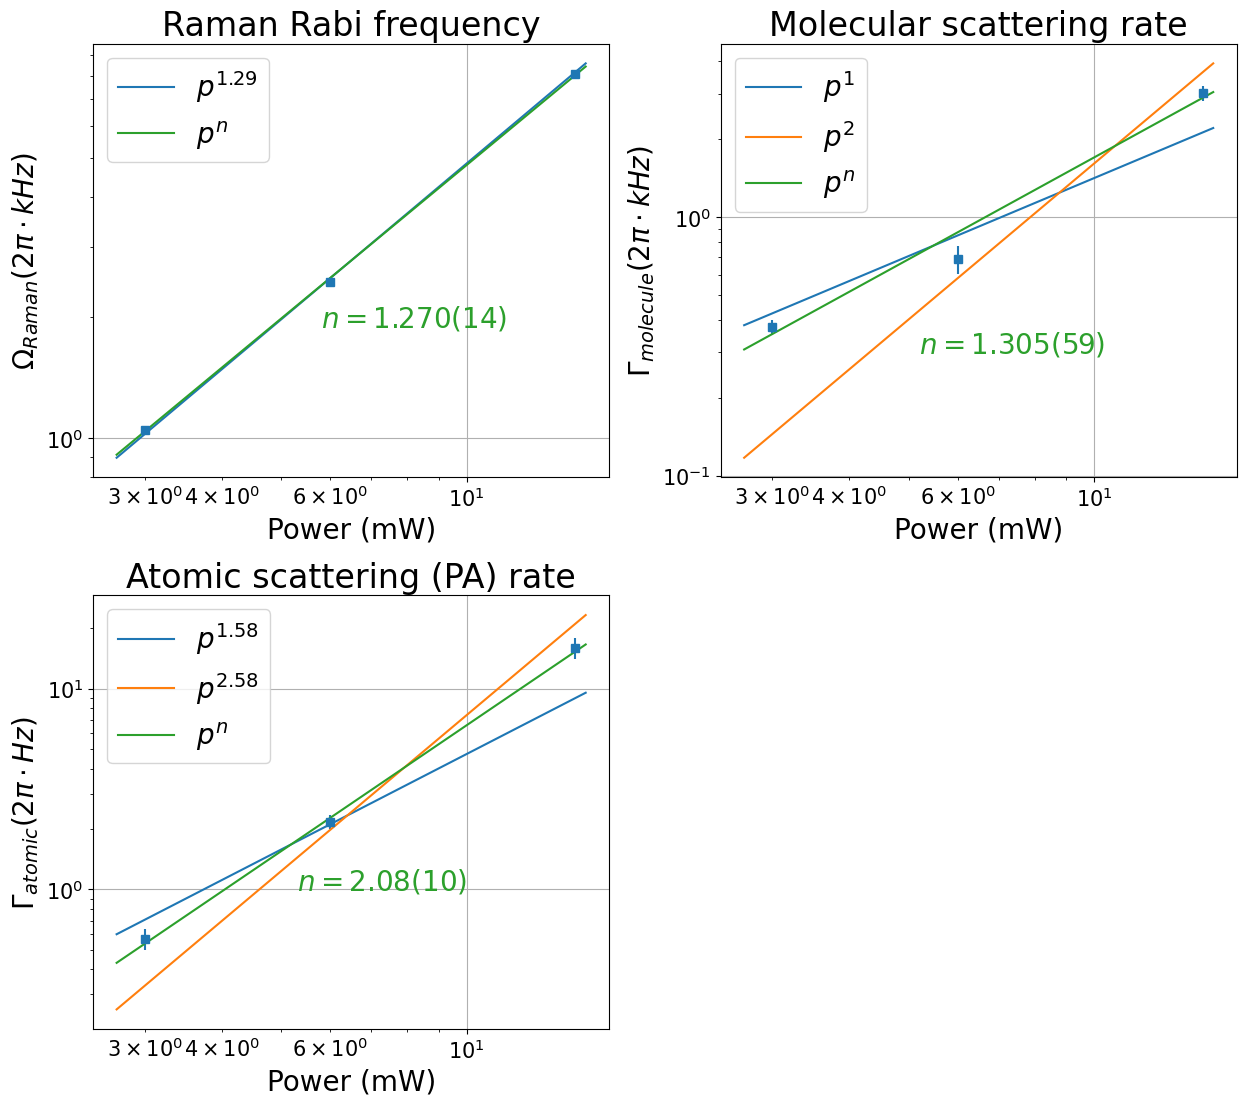
experiments/nacs_202006/imgs/data_20200618_scaling_3322.png
