nacs-lab/yyc-data/experiments/nacs_202006/imgs/data_20200630_205026_pa_3322_2b.png

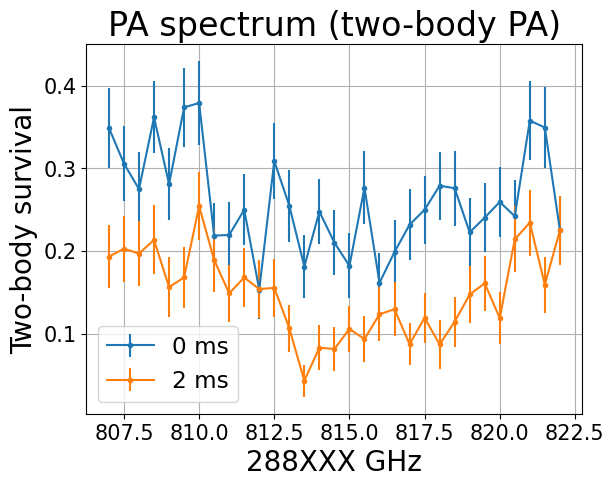
experiments/nacs_202006/imgs/data_20200630_205026_pa_3322_2b.png
