nacs-lab/yyc-data/experiments/nacs_202006/imgs/fit_20200629_180628_raman_3322_2.png

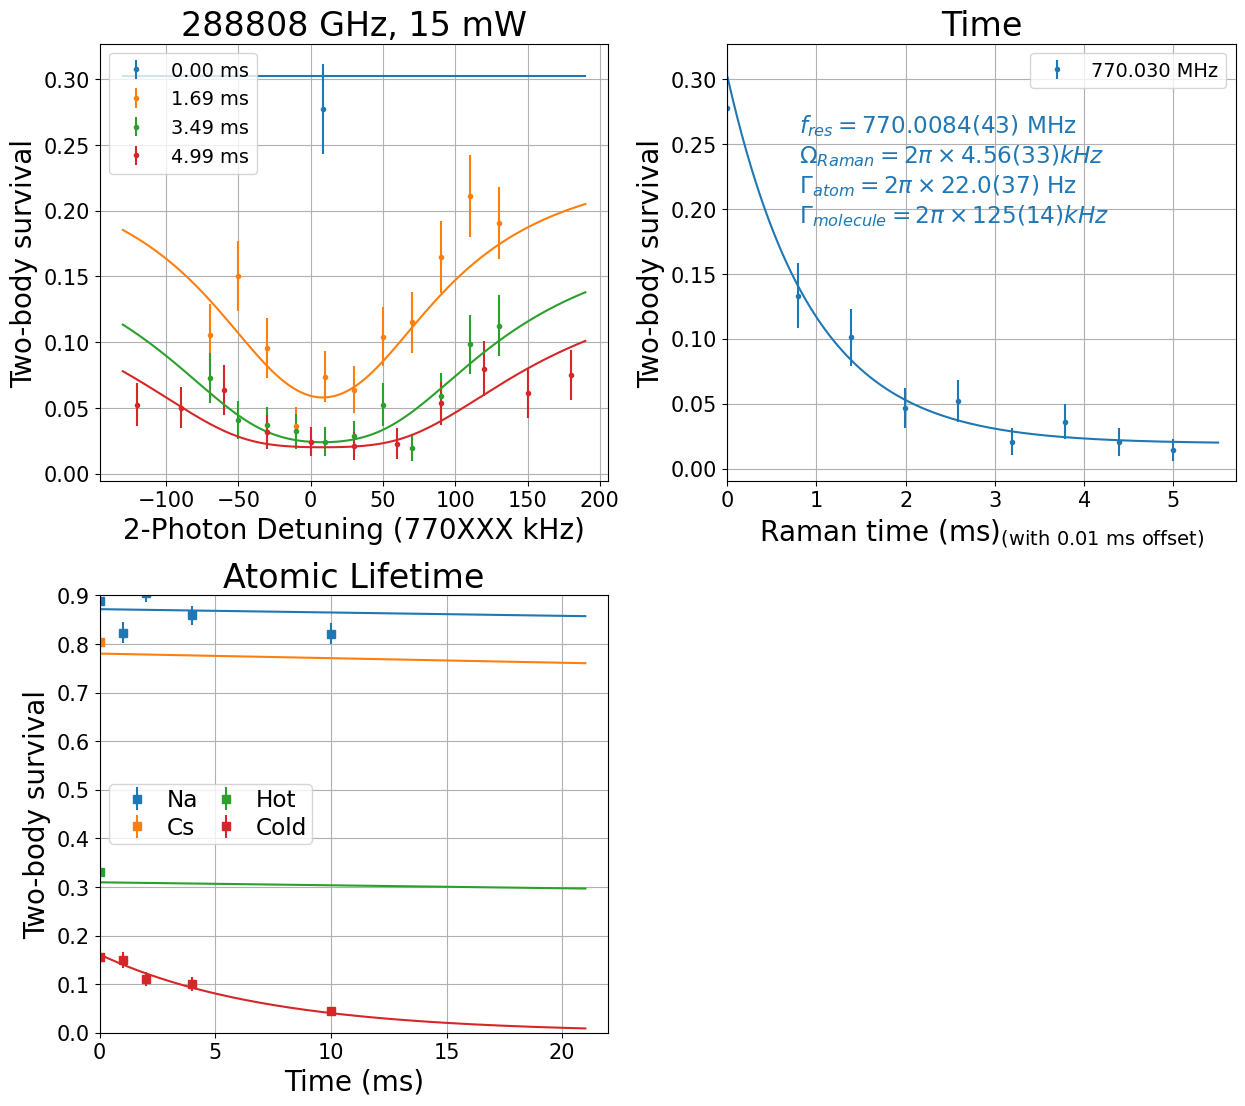
experiments/nacs_202006/imgs/fit_20200629_180628_raman_3322_2.png
