nacs-lab/yyc-data/experiments/nacs_202007/imgs/fit_20200707_230755_raman15_3322_2.png

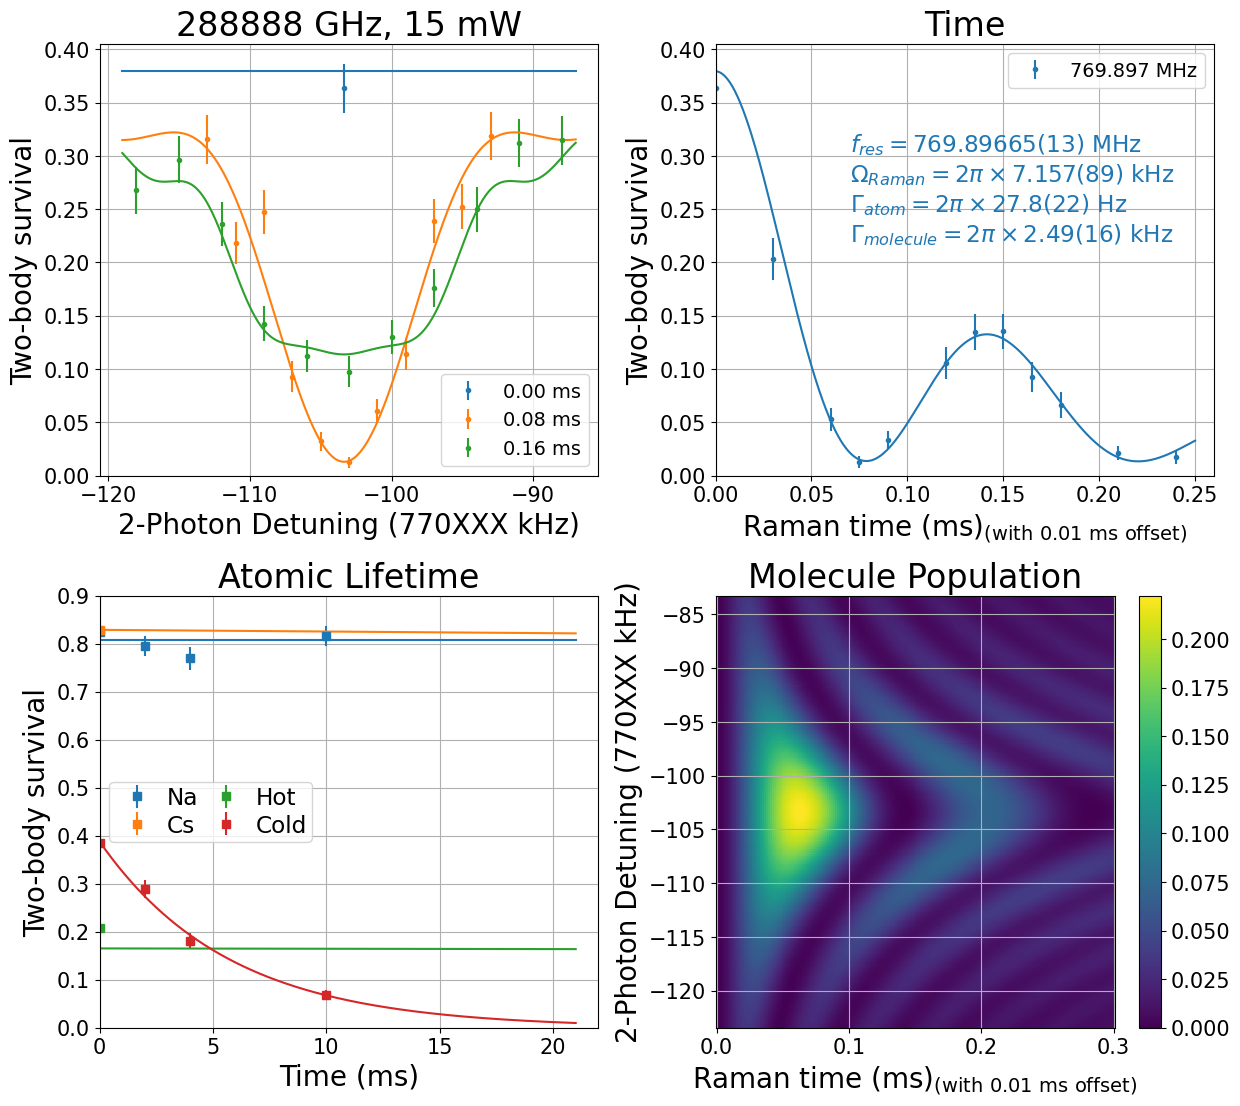
experiments/nacs_202007/imgs/fit_20200707_230755_raman15_3322_2.png
