nacs-lab/yyc-data/experiments/nacs_202008/imgs/fit_20200809_202331_raman15_3322.png

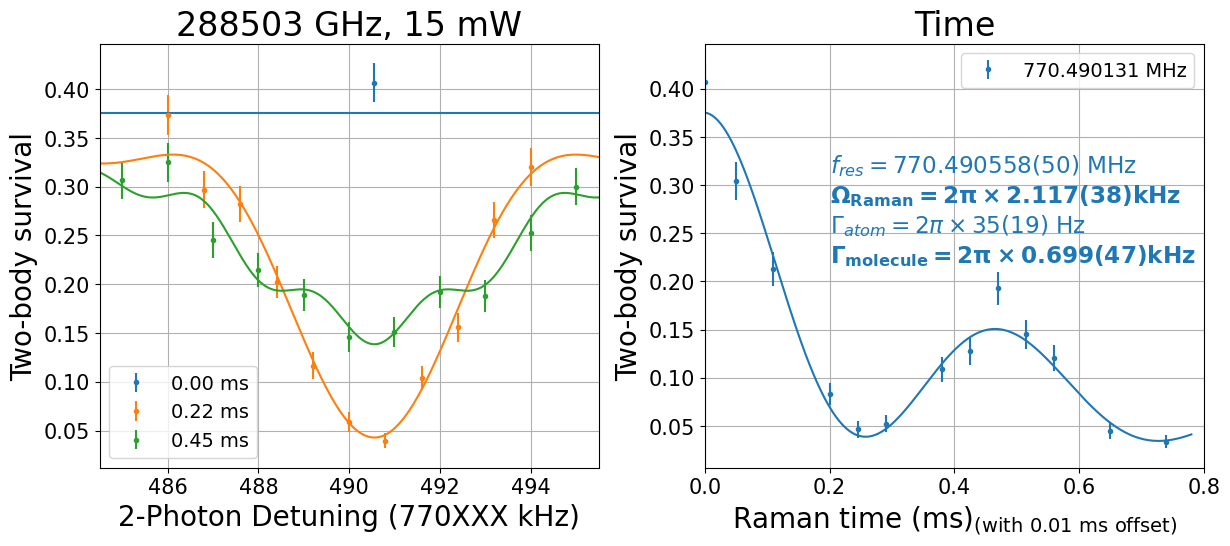
experiments/nacs_202008/imgs/fit_20200809_202331_raman15_3322.png
