nacs-lab/yyc-data/experiments/nacs_202008/imgs/fit_20200830_004406_raman15_3322_2.png

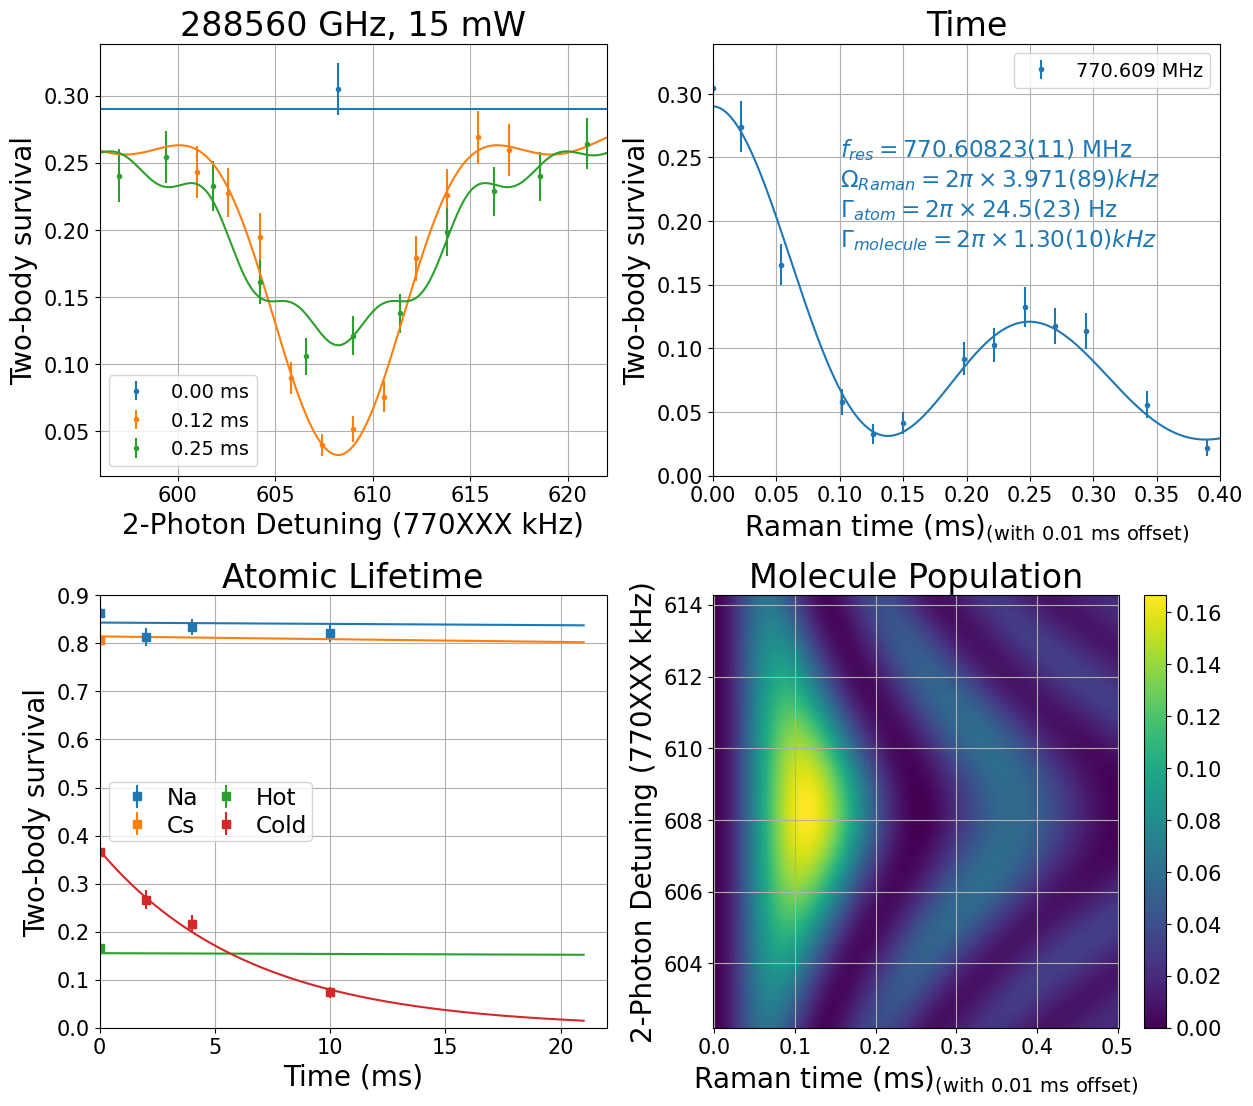
experiments/nacs_202008/imgs/fit_20200830_004406_raman15_3322_2.png
