nacs-lab/yyc-data/experiments/nacs_202008/imgs/fit_20200831_192240_raman3_3322_2.png

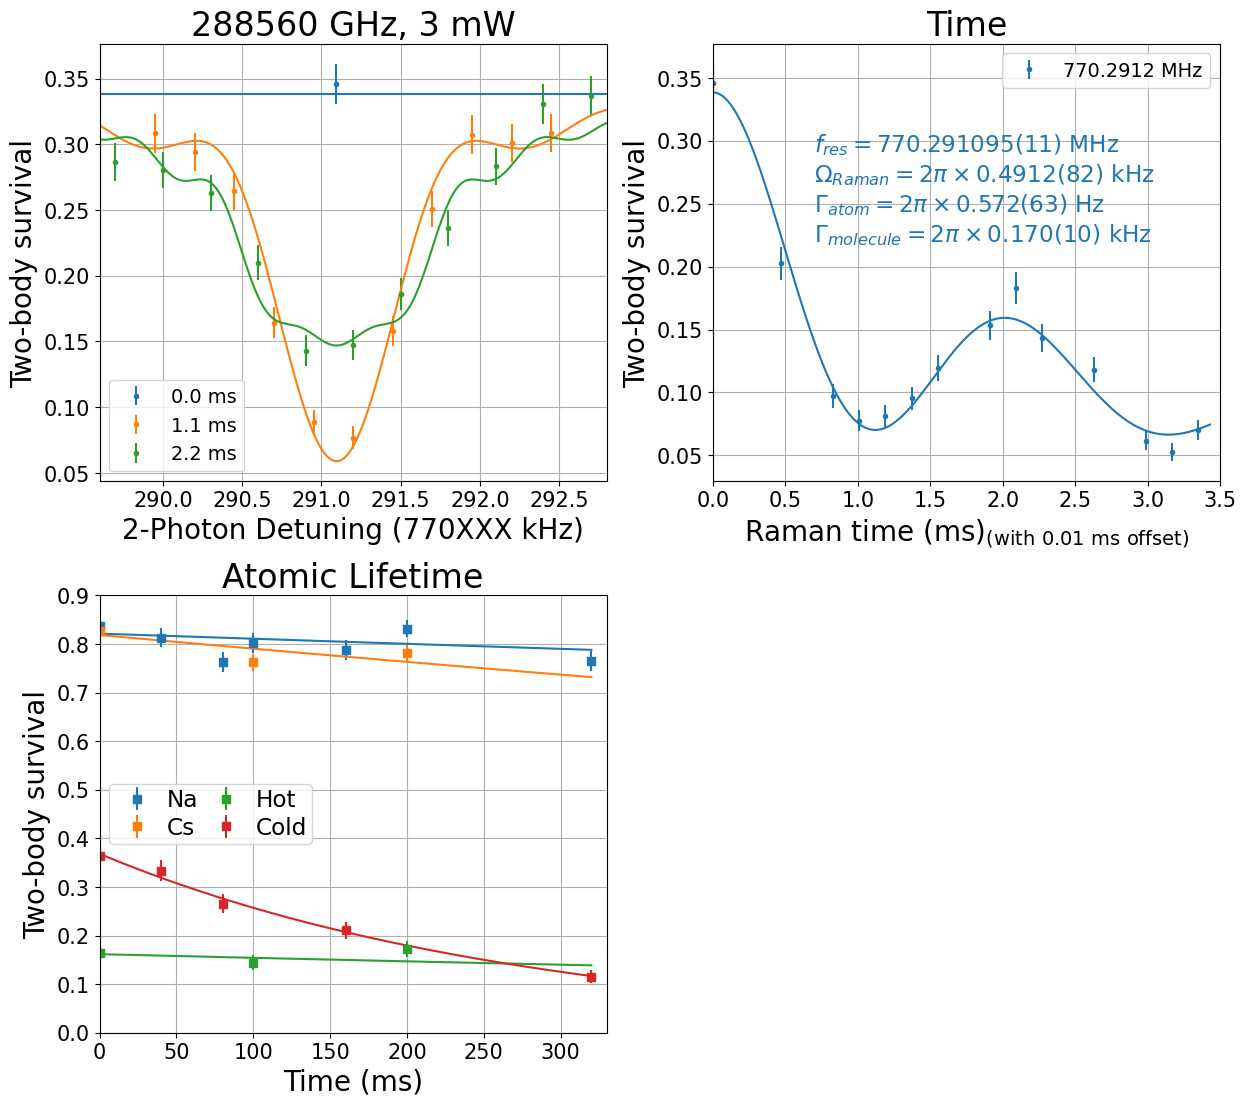
experiments/nacs_202008/imgs/fit_20200831_192240_raman3_3322_2.png
