nacs-lab/yyc-data/experiments/nacs_202010/imgs/fit_20201001_203322_raman15_3322_2.png

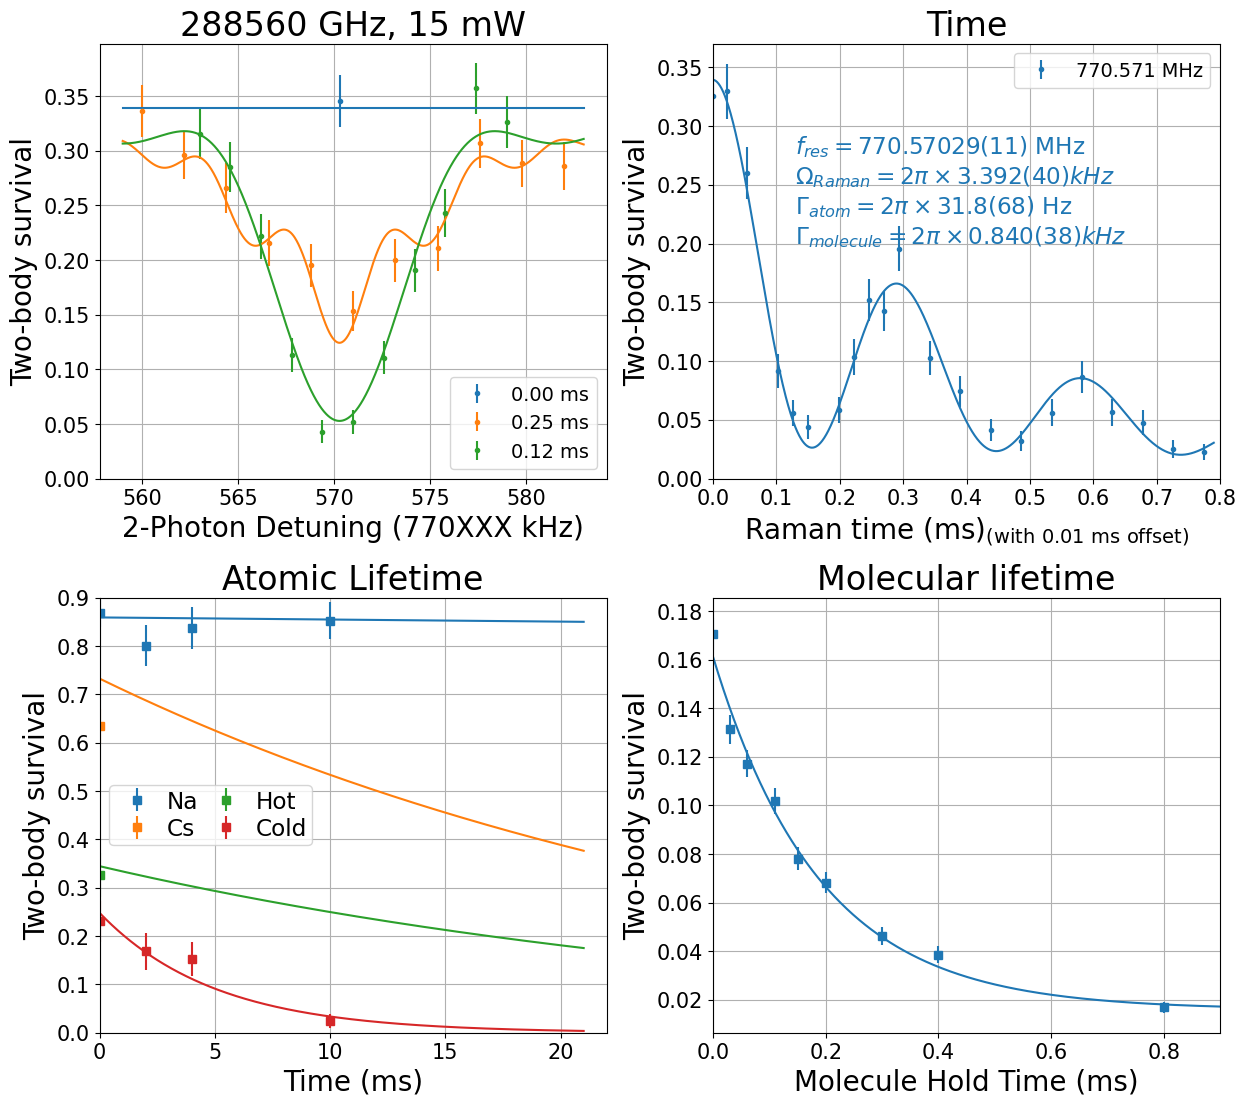
experiments/nacs_202010/imgs/fit_20201001_203322_raman15_3322_2.png
