nacs-lab/yyc-data/experiments/nacs_atoms/imgs/hist_cs.png

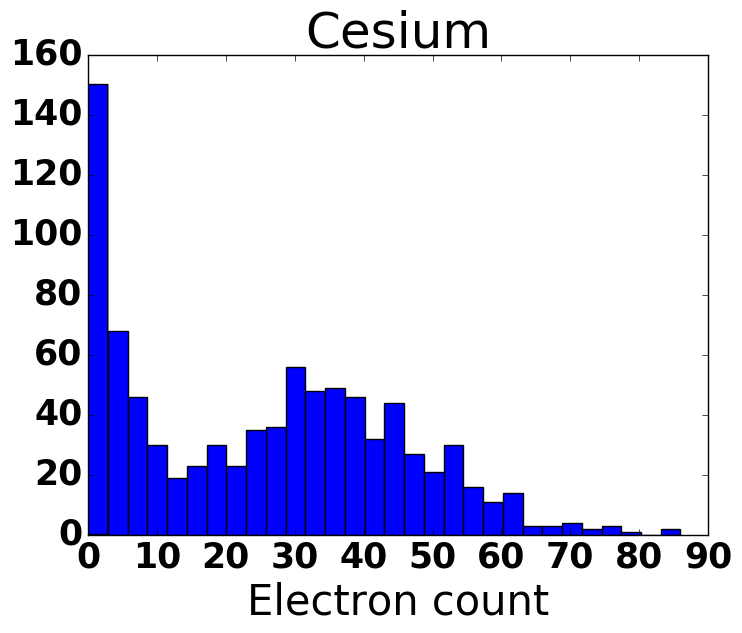
experiments/nacs_atoms/imgs/hist_cs.png
