nacs-lab/yyc-data/experiments/nacs_merge_201711/imgs/data_20171201_002515_cs_both.png

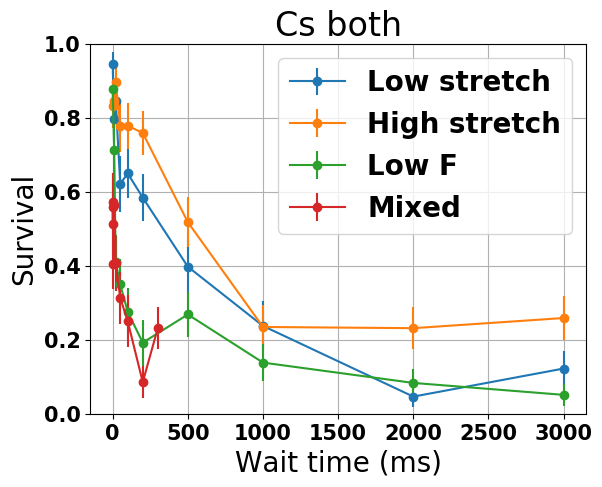
experiments/nacs_merge_201711/imgs/data_20171201_002515_cs_both.png
