nacs-lab/yyc-data/experiments/pa_201904/imgs/data_20190409_pa3.png

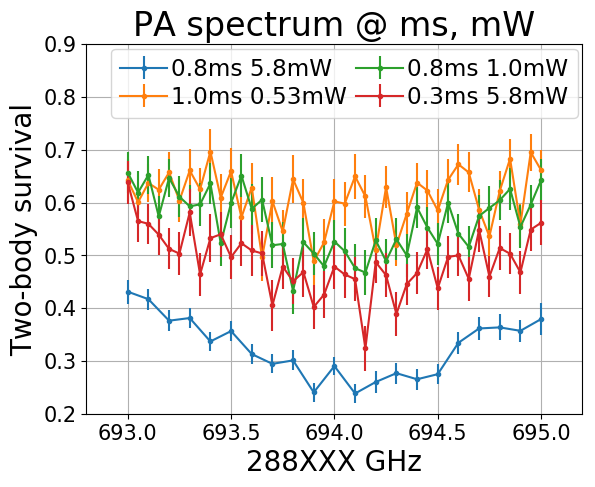
experiments/pa_201904/imgs/data_20190409_pa3.png
