nacs-lab/yyc-data/experiments/pa_201906/imgs/data_20190613_pa32.png

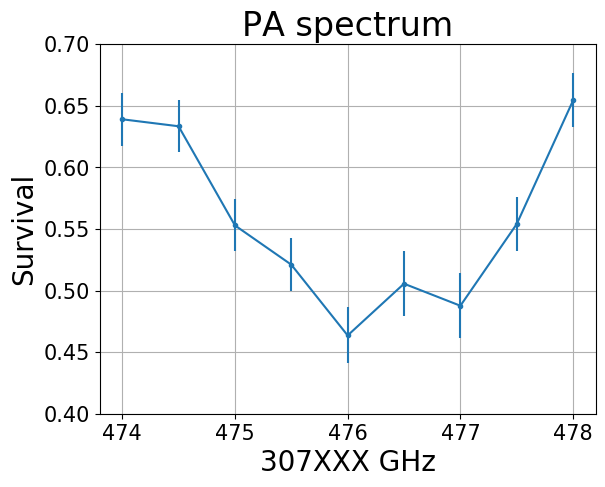
experiments/pa_201906/imgs/data_20190613_pa32.png
