nacs-lab/yyc-data/experiments/pa_201907/imgs/data_20190725_135756_pa_2b.png

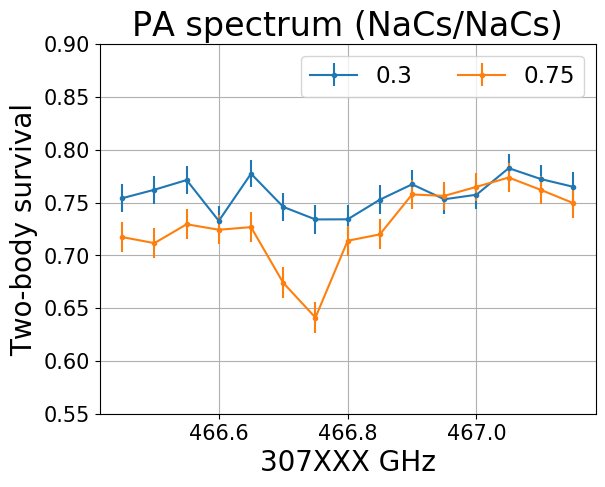
experiments/pa_201907/imgs/data_20190725_135756_pa_2b.png
