nacs-lab/yyc-data/experiments/pa_201907/imgs/data_20190727_000118_pa_2b_30.png

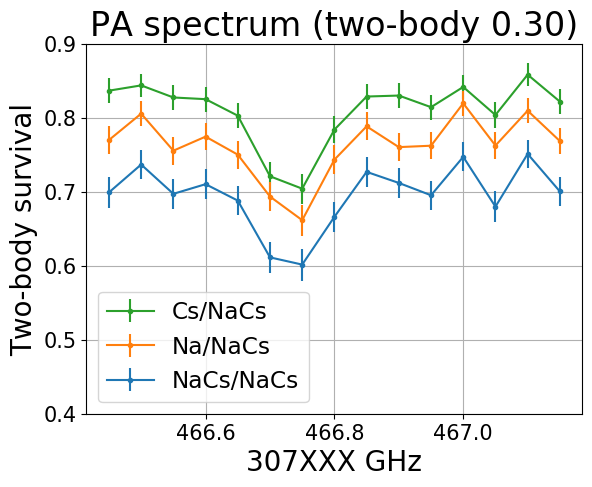
experiments/pa_201907/imgs/data_20190727_000118_pa_2b_30.png
