nacs-lab/yyc-data/experiments/pa_201907/imgs/data_20190728_003337_pa_1b.png

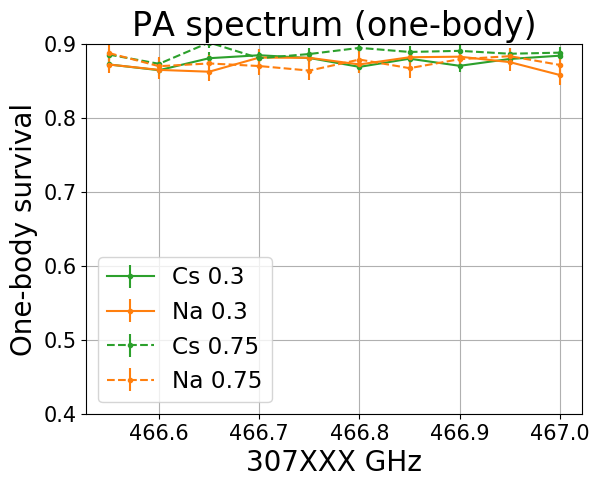
experiments/pa_201907/imgs/data_20190728_003337_pa_1b.png
