nacs-lab/yyc-data/experiments/pa_201907/imgs/data_20190728_003337_pa_2b_75.png

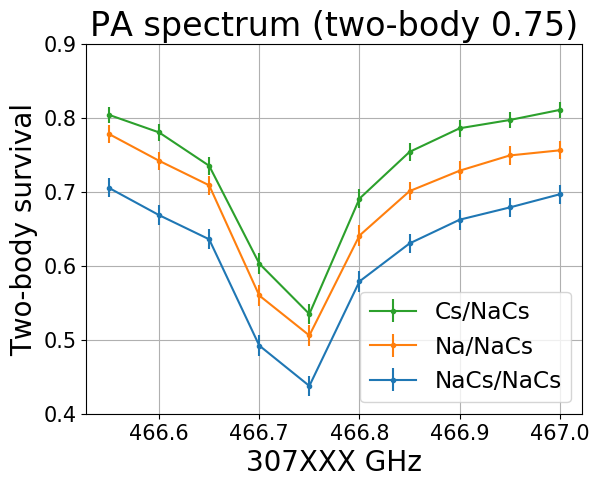
experiments/pa_201907/imgs/data_20190728_003337_pa_2b_75.png
