nacs-lab/yyc-data/experiments/pa_201908/imgs/data_20190801_181243_pa_2b.png

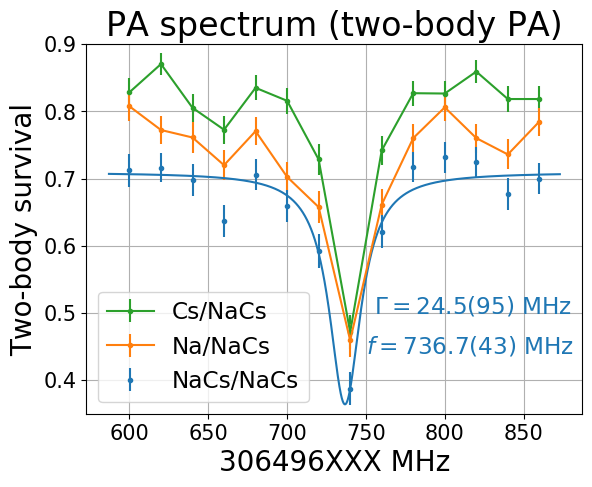
experiments/pa_201908/imgs/data_20190801_181243_pa_2b.png
