nacs-lab/yyc-data/experiments/pa_201908/imgs/data_20190808_193315_pa_1b.png

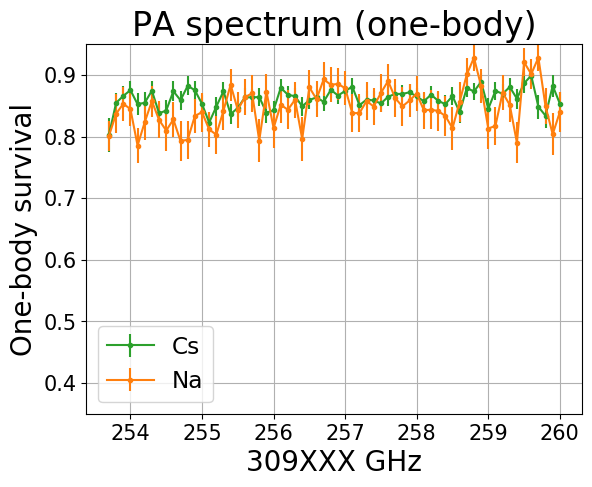
experiments/pa_201908/imgs/data_20190808_193315_pa_1b.png
