nacs-lab/yyc-data/experiments/pa_201908/imgs/data_20190810_223441_pa_2b.png

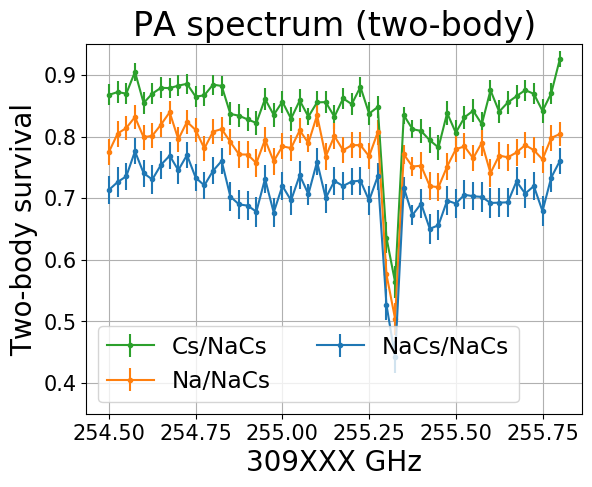
experiments/pa_201908/imgs/data_20190810_223441_pa_2b.png
