nacs-lab/yyc-data/experiments/pa_201908/imgs/data_20190815_134008_pa_1b.png

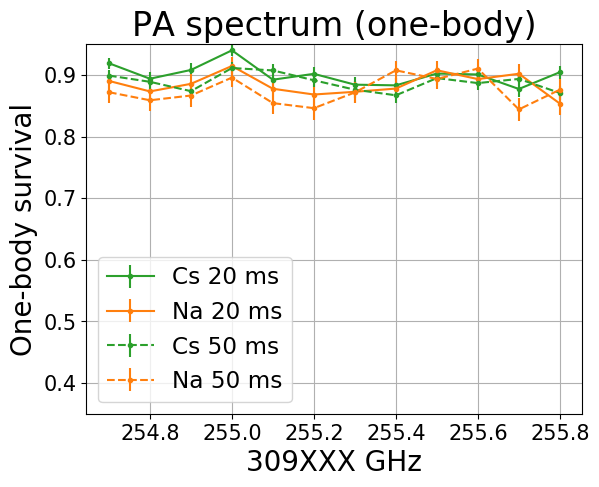
experiments/pa_201908/imgs/data_20190815_134008_pa_1b.png
