nacs-lab/yyc-data/experiments/pa_201908/imgs/data_20190815_234740_pa_2b_3.png

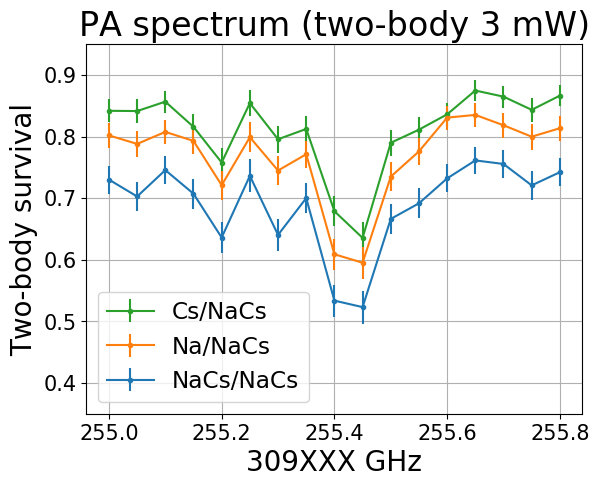
experiments/pa_201908/imgs/data_20190815_234740_pa_2b_3.png
