nacs-lab/yyc-data/experiments/pa_201908/imgs/data_20190816_204109_pa_7.5mw_1b.png

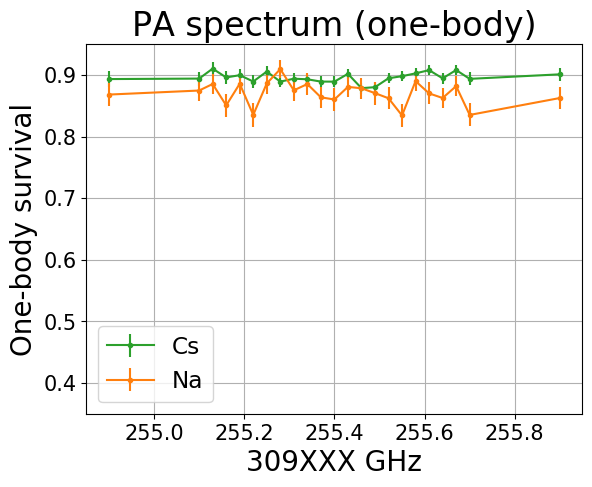
experiments/pa_201908/imgs/data_20190816_204109_pa_7.5mw_1b.png
