nacs-lab/yyc-data/experiments/pa_201908/imgs/data_20190828_184528_pa_2b_nopa.png

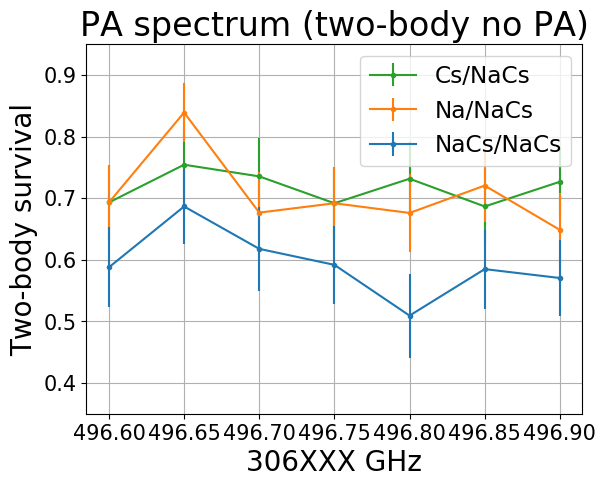
experiments/pa_201908/imgs/data_20190828_184528_pa_2b_nopa.png
