nacs-lab/yyc-data/experiments/pa_201908/imgs/data_20190828_211824_pa_pwr_1b.png

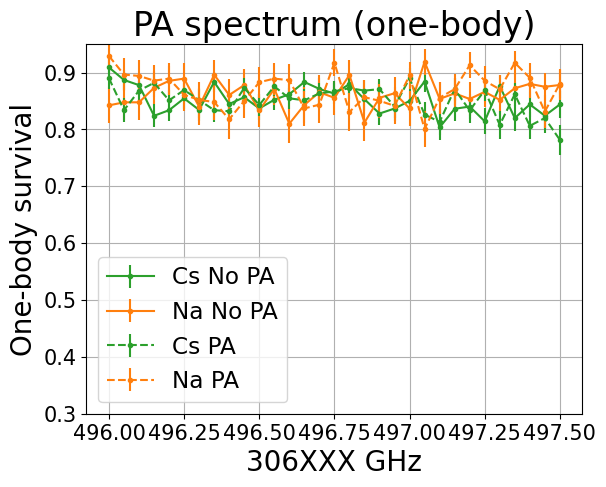
experiments/pa_201908/imgs/data_20190828_211824_pa_pwr_1b.png
