nacs-lab/yyc-data/experiments/pa_201908/imgs/data_20190829_144031_pa_pwr_2b.png

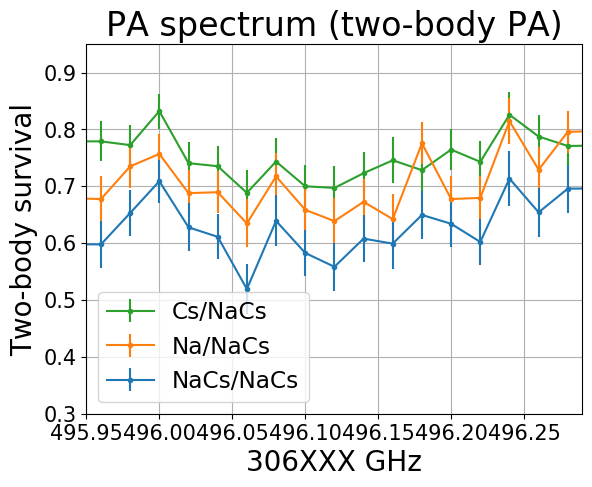
experiments/pa_201908/imgs/data_20190829_144031_pa_pwr_2b.png
