nacs-lab/yyc-data/experiments/pa_201908/imgs/data_20190830_145015_pa_pwr_1b.png

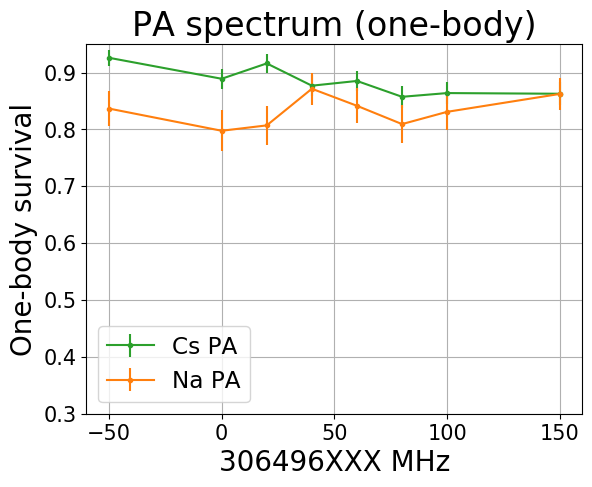
experiments/pa_201908/imgs/data_20190830_145015_pa_pwr_1b.png
