nacs-lab/yyc-data/experiments/pa_201908/imgs/data_20190830_194644_pa_tw_pwr_1b2b.png

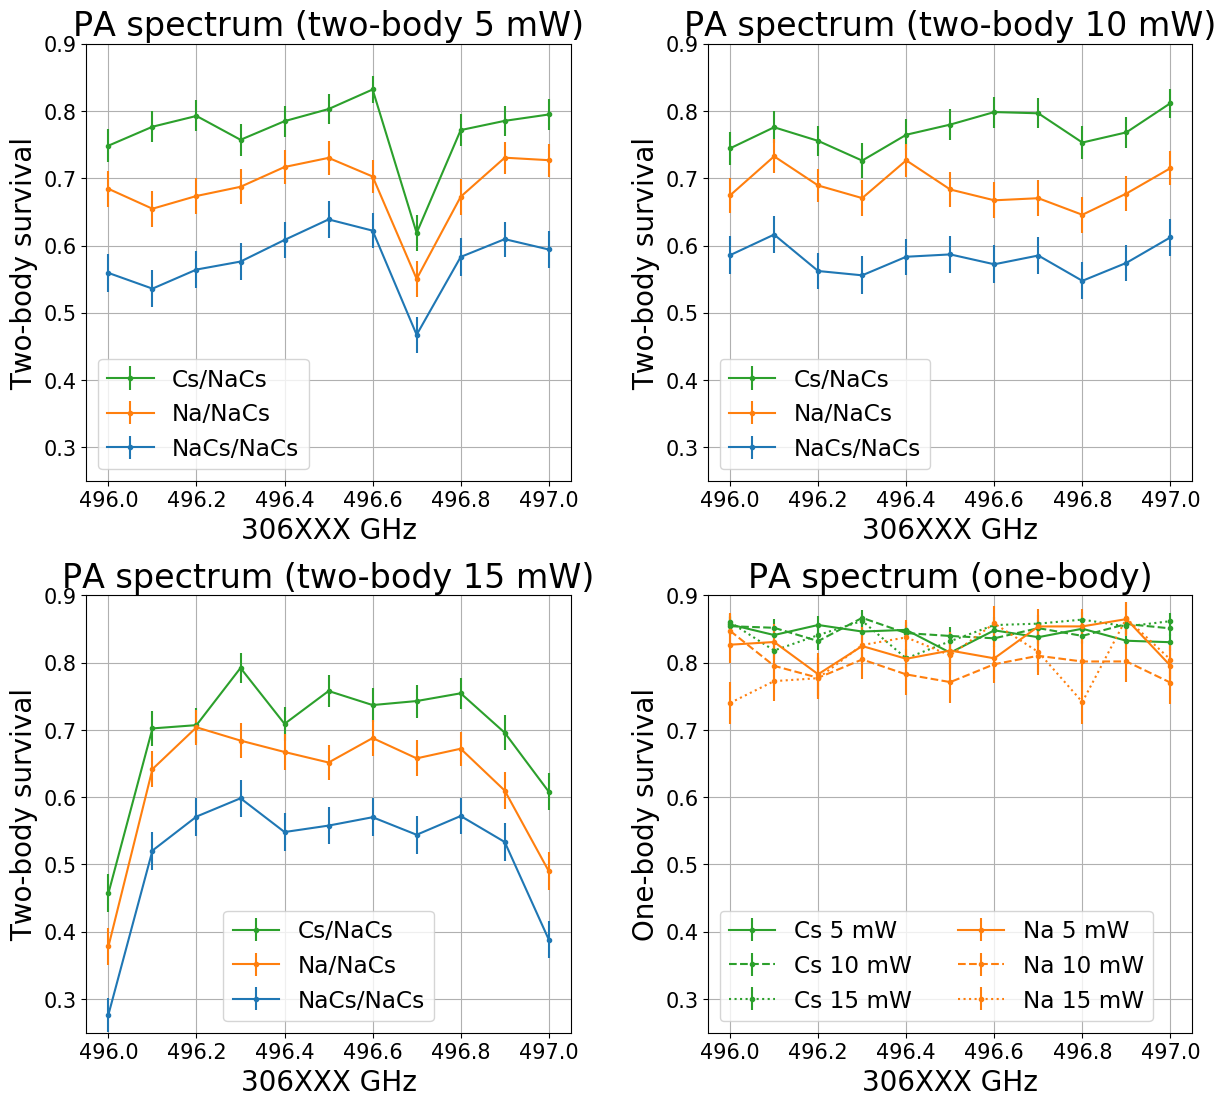
experiments/pa_201908/imgs/data_20190830_194644_pa_tw_pwr_1b2b.png
