nacs-lab/yyc-data/experiments/pa_201909/imgs/data_20190902_170913_pa_tw_pwr_1b2b.png

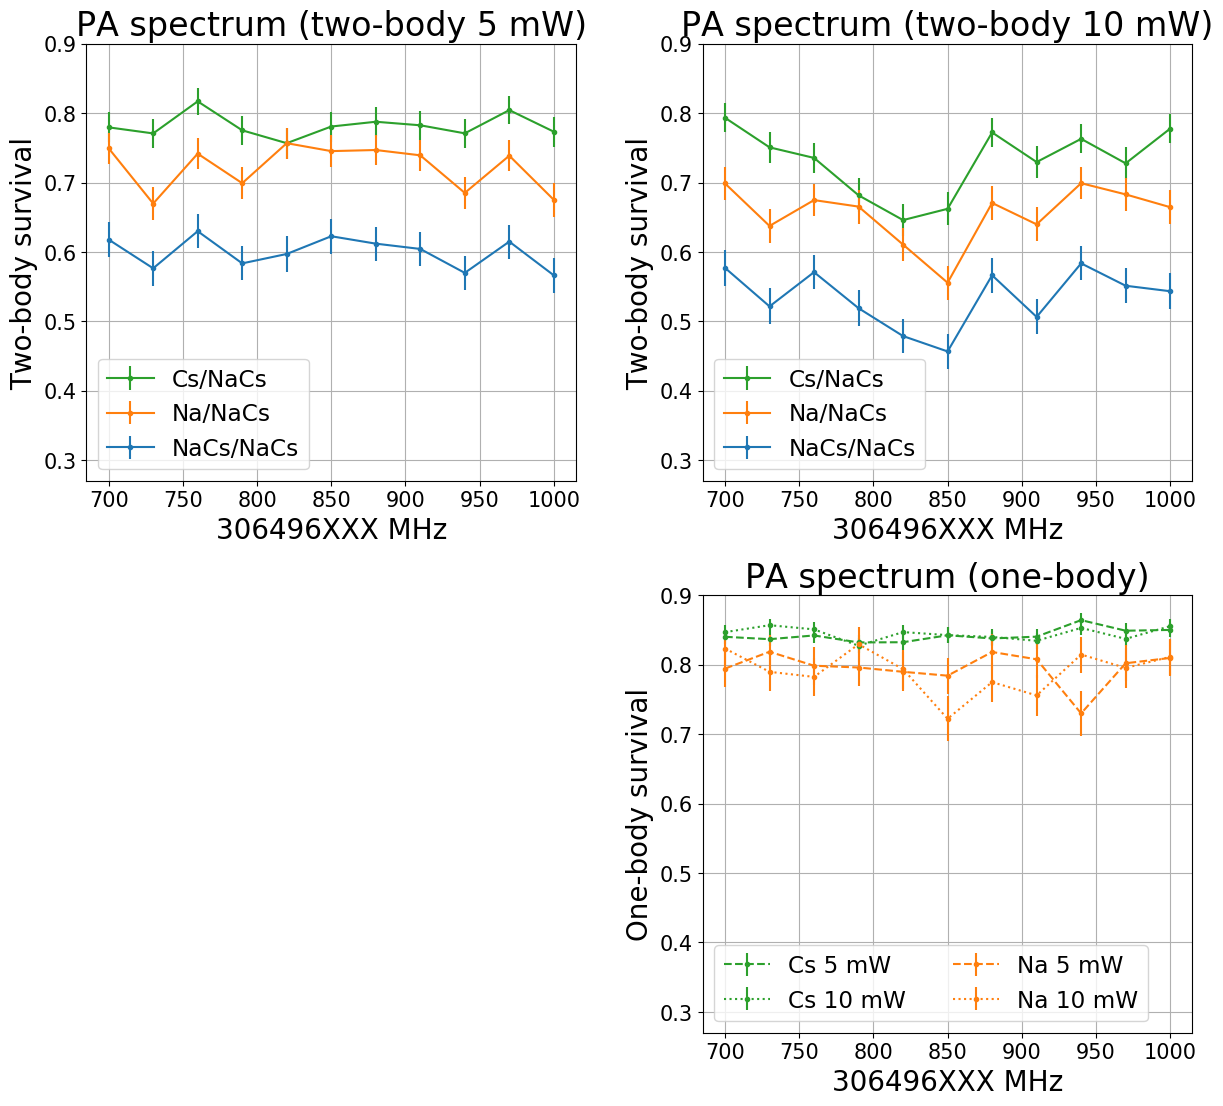
experiments/pa_201909/imgs/data_20190902_170913_pa_tw_pwr_1b2b.png
