nacs-lab/yyc-data/experiments/pa_201909/imgs/data_20190903_134946_pa_2b.png

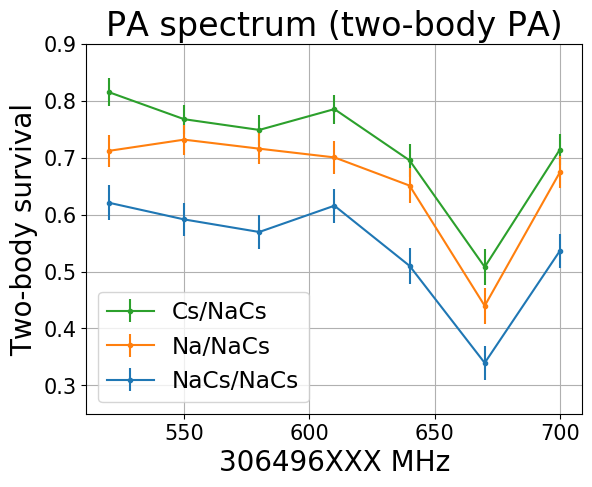
experiments/pa_201909/imgs/data_20190903_134946_pa_2b.png
