nacs-lab/yyc-data/experiments/pa_201909/imgs/data_20190909_113927_pa_tw_pwr.png

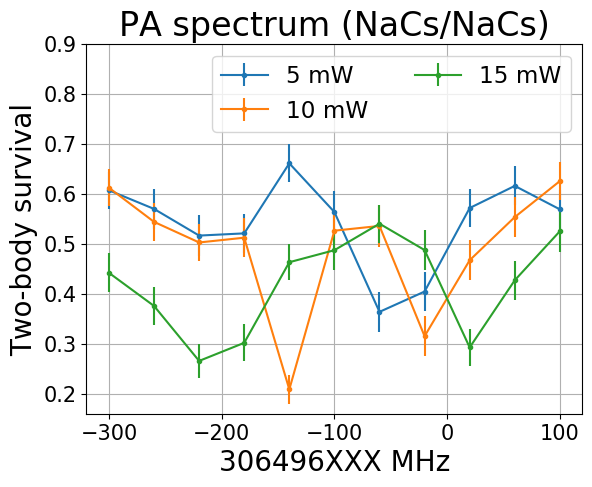
experiments/pa_201909/imgs/data_20190909_113927_pa_tw_pwr.png
