nacs-lab/yyc-data/experiments/pa_201909/imgs/data_20190909_170457_pa_1b.png

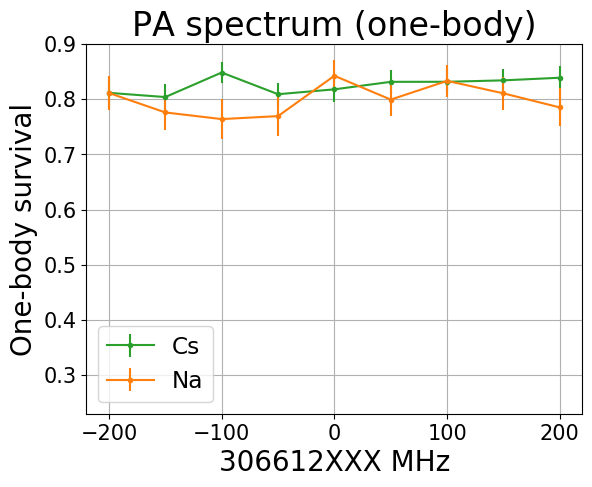
experiments/pa_201909/imgs/data_20190909_170457_pa_1b.png
