nacs-lab/yyc-data/experiments/powers/imgs/cs_tweezer_20190819_paaom.png

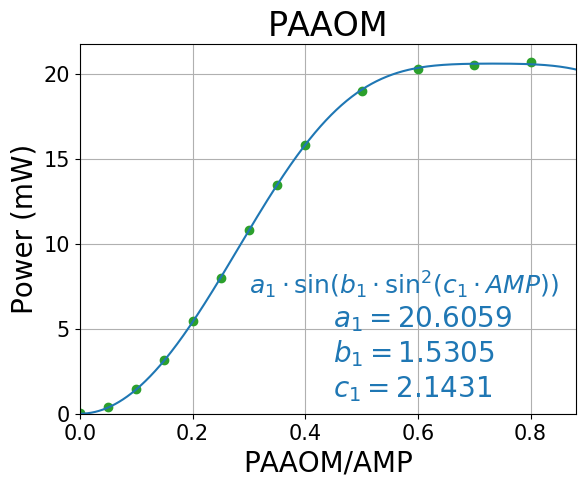
experiments/powers/imgs/cs_tweezer_20190819_paaom.png
