nacs-lab/yyc-data/experiments/powers/imgs/cs_tweezer_20191203_padpaom.png

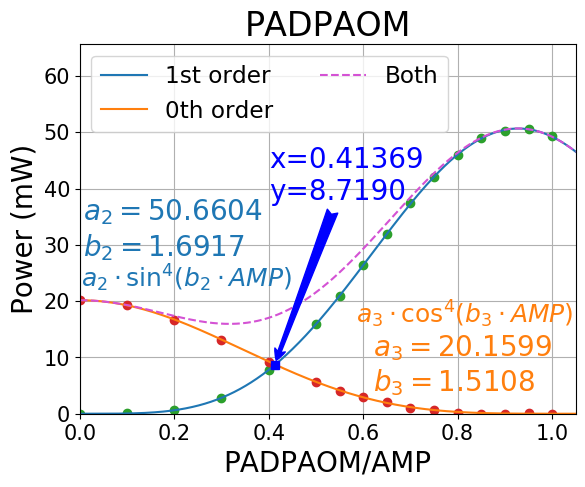
experiments/powers/imgs/cs_tweezer_20191203_padpaom.png
