nacs-lab/yyc-data/experiments/powers/imgs/cs_tweezer_20200207_padpaom.png

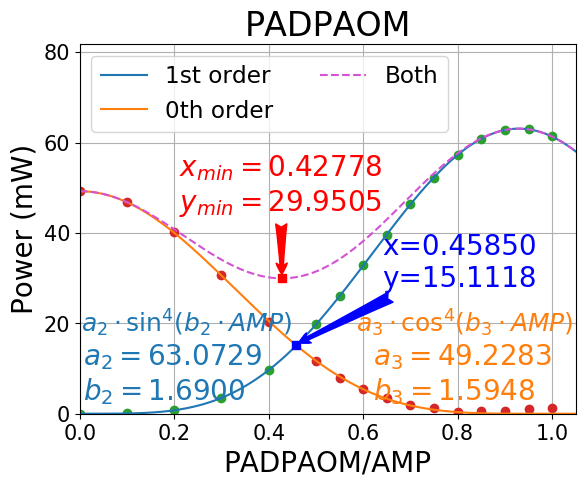
experiments/powers/imgs/cs_tweezer_20200207_padpaom.png
