nacs-lab/yyc-data/experiments/powers/imgs/cs_tweezer_20200325_padpaom.png

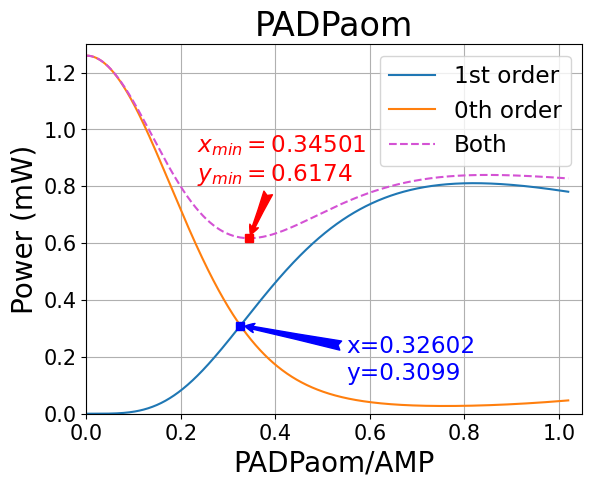
experiments/powers/imgs/cs_tweezer_20200325_padpaom.png
