nacs-lab/yyc-data/experiments/powers/imgs/cs_tweezer_20200505_sp_ratio.png

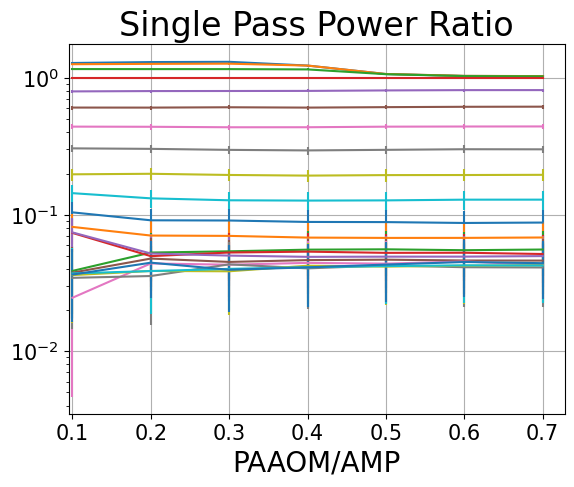
experiments/powers/imgs/cs_tweezer_20200505_sp_ratio.png
