nacs-lab/yyc-data/experiments/powers/imgs/cs_tweezer_20200917_paaom.png

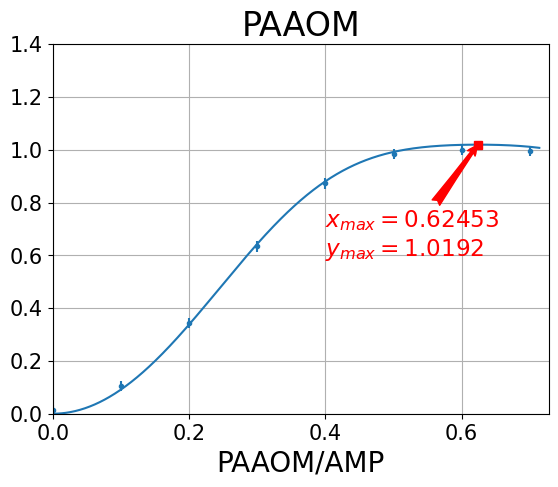
experiments/powers/imgs/cs_tweezer_20200917_paaom.png
