nacs-lab/yyc-data/experiments/powers/imgs/na_20180110_f1_up.png

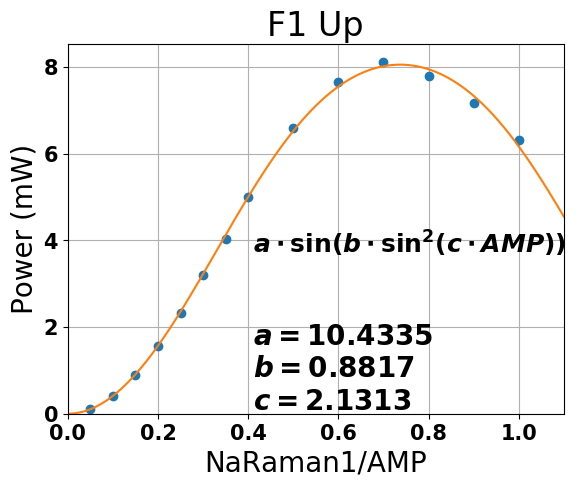
experiments/powers/imgs/na_20180110_f1_up.png
