nacs-lab/yyc-data/experiments/powers/imgs/na_20180604_f1_down.png

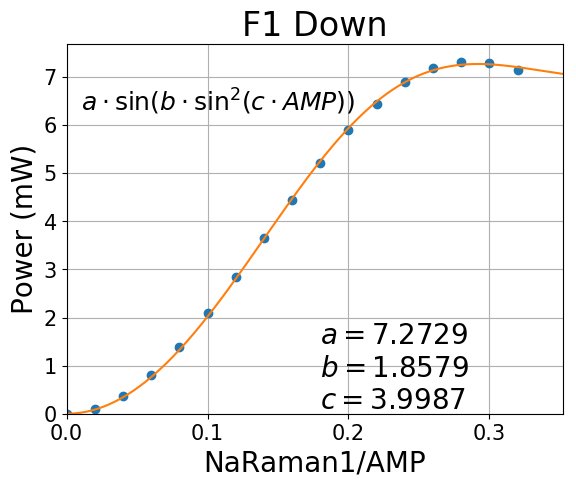
experiments/powers/imgs/na_20180604_f1_down.png
