nacs-lab/yyc-data/experiments/powers/imgs/na_20180604_f2_coprop.png

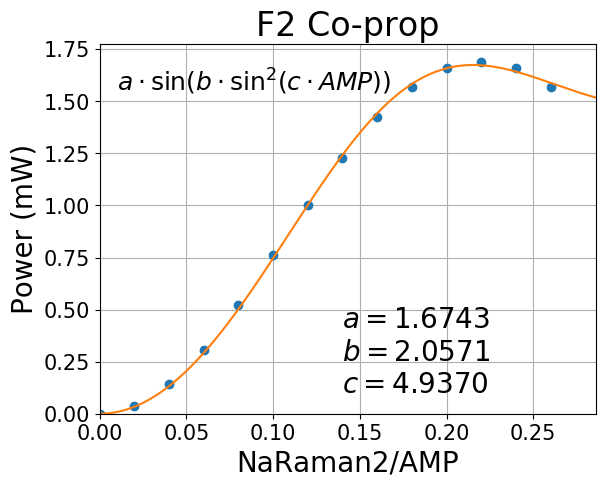
experiments/powers/imgs/na_20180604_f2_coprop.png
