nacs-lab/yyc-data/experiments/rabi_flop/imgs/fit_20170409_a1_0_ba_nol.png

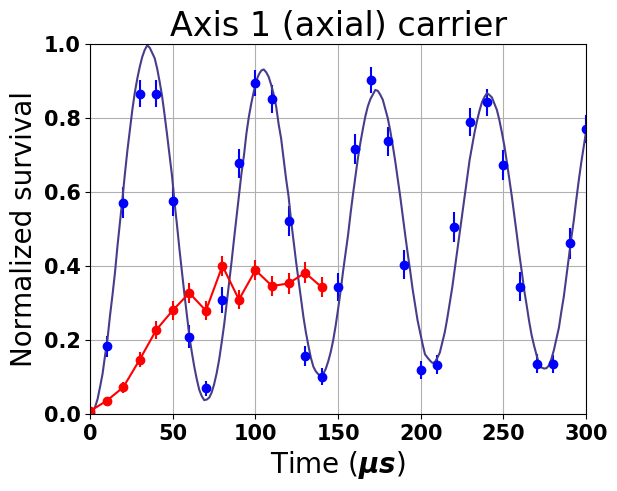
experiments/rabi_flop/imgs/fit_20170409_a1_0_ba_nol.png
