nacs-lab/yyc-data/experiments/rabi_flop/imgs/fit_20170409_r2_p1_ba.png

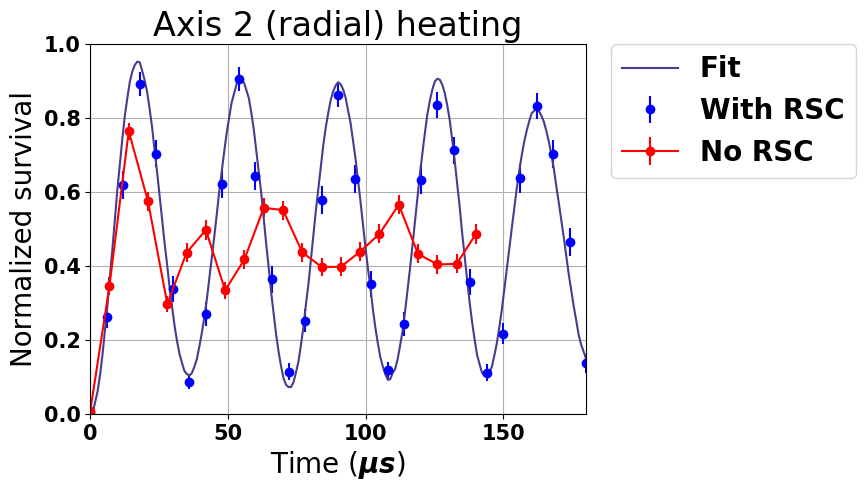
experiments/rabi_flop/imgs/fit_20170409_r2_p1_ba.png
