nacs-lab/yyc-data/experiments/raman_scatter/imgs/data_combined_20170405_f2_coprop.png

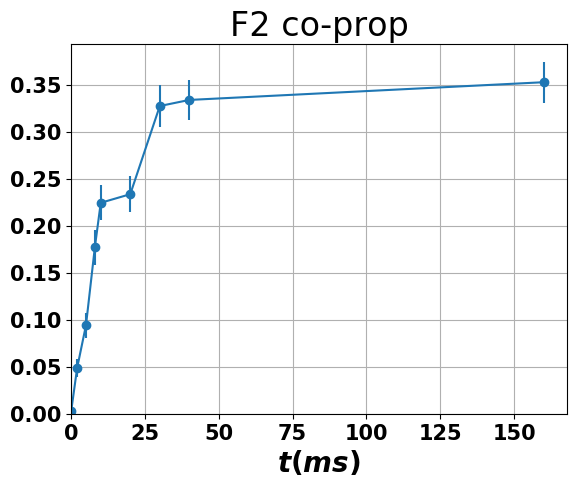
experiments/raman_scatter/imgs/data_combined_20170405_f2_coprop.png
