nacs-lab/yyc-data/orders/todo/WindFreak_2016-10-06.md

|  PartNumber|Minimum Quantity|Actual Quantity|Comment |
|---|---|---|---|
| MixNV| 1| | |
