nacs-lab/yyc-data/presentations/2020-04-27_jc_cont/incremental-design.pdf

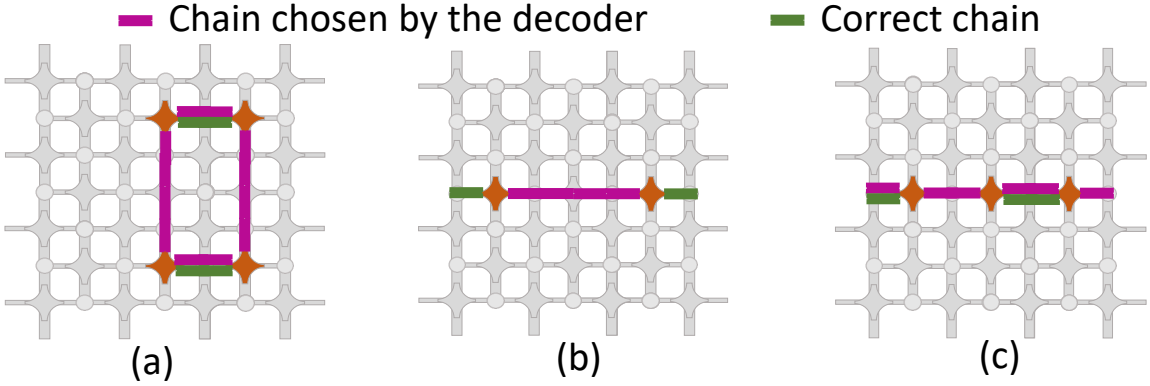
[picture p434: page 1]
XXXX; Chain chosen by the decoder; Correct chain
