nacs-lab/yyc-data/presentations/2021-05-12_jc/results.pdf

## ρ → SvN(χ = 2) |0⟩

|L⟩

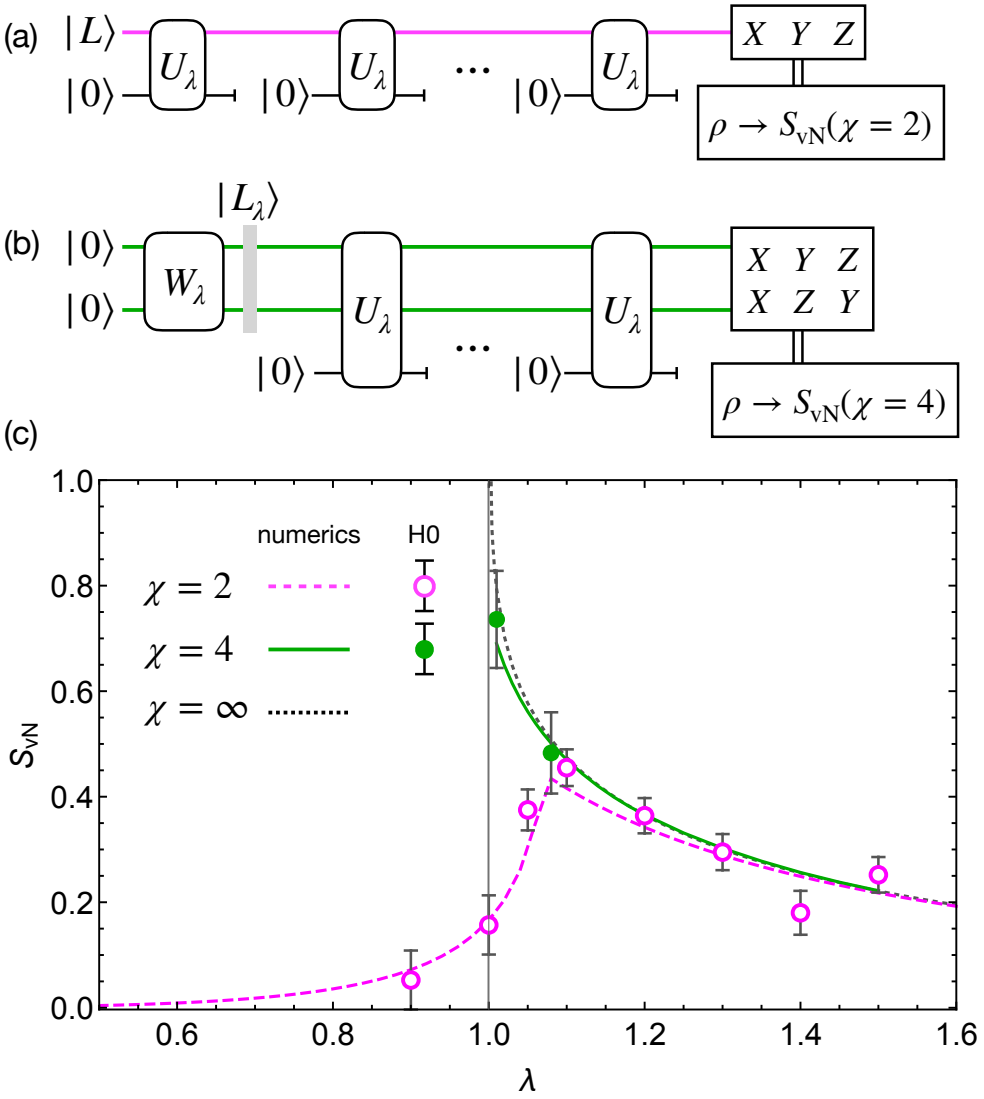
[picture p435: page 1]
ρ → SvN(χ = 4); numerics; SvN
