nacs-lab/yyc-data/presentations/2020-08-24_jc/setup1.pdf

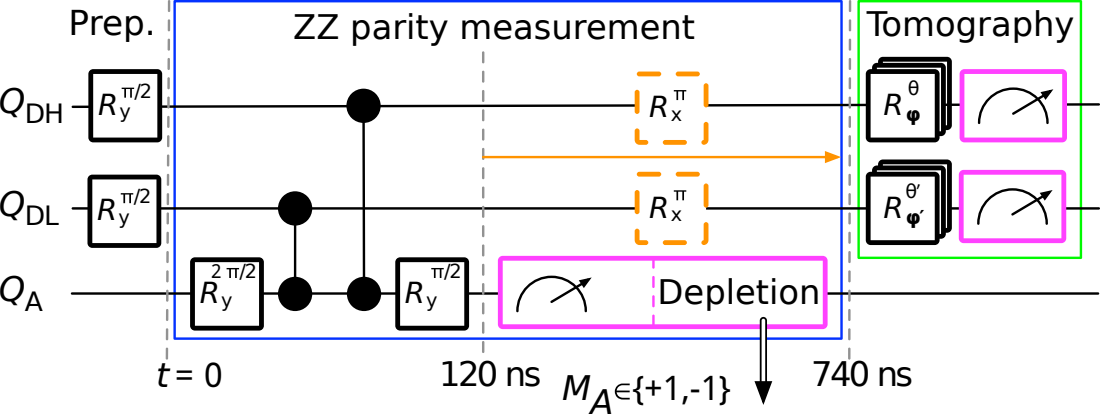
[picture p436: page 1]
Depletion; RRR; Prep.; Tomography; QDL; QDH

ZZ parity measurement
