nacs-lab/yyc-data/designs/pre-amp/pre-amp-sch.pdf

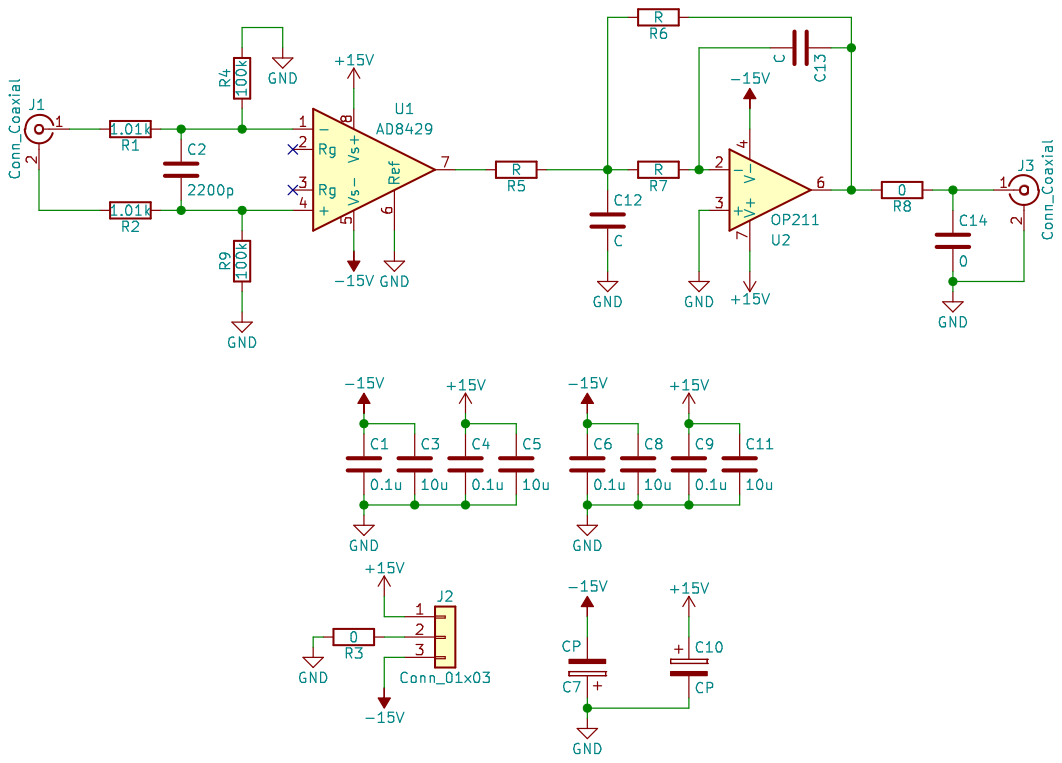
[picture p437: page 1]
