nacs-lab/yyc-data/presentations/2019-09-05_itamp/spectrum_az.pdf

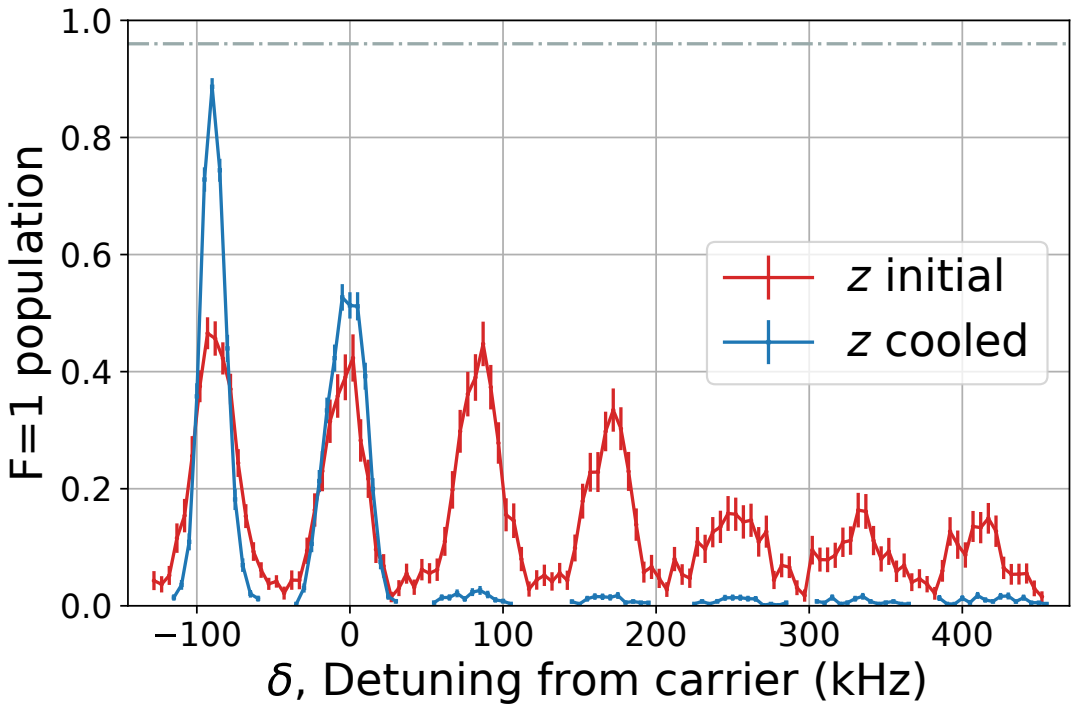
[picture p438: page 1]
F=1 population; z initial z cooled

, Detuning from carrier (kHz)
