nacs-lab/yyc-data/presentations/2019-09-05_itamp/spectrum_az_hot.pdf

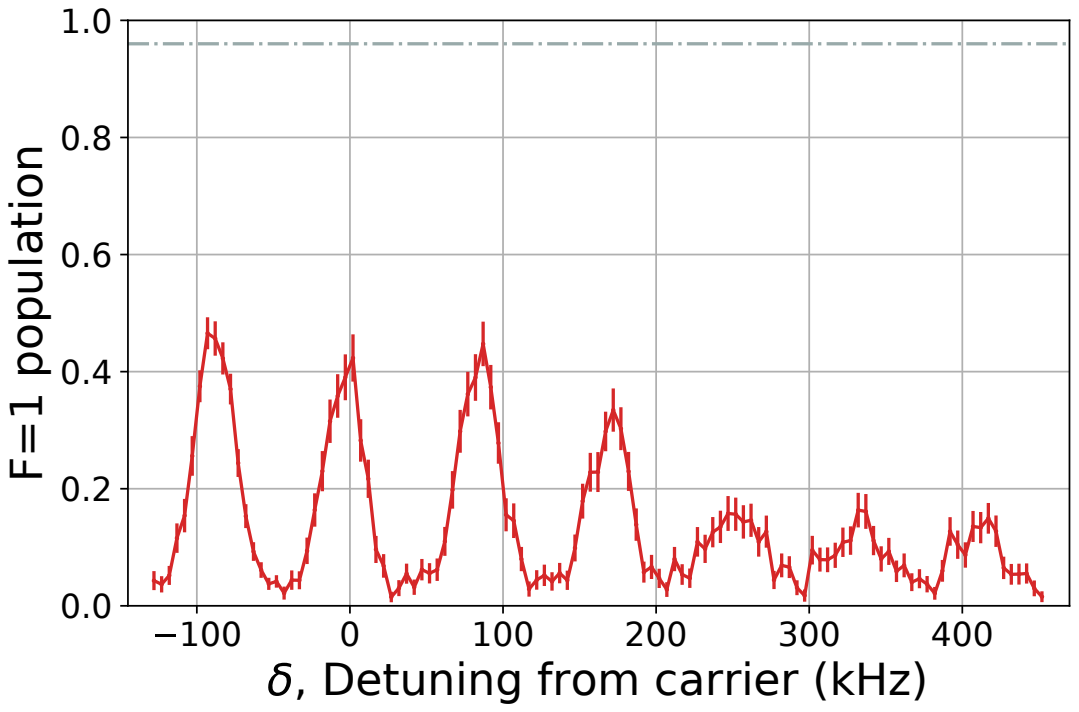
[picture p439: page 1]
F=1 population

, Detuning from carrier (kHz)
