nacs-lab/yyc-data/designs/pre-amp/combined.pdf

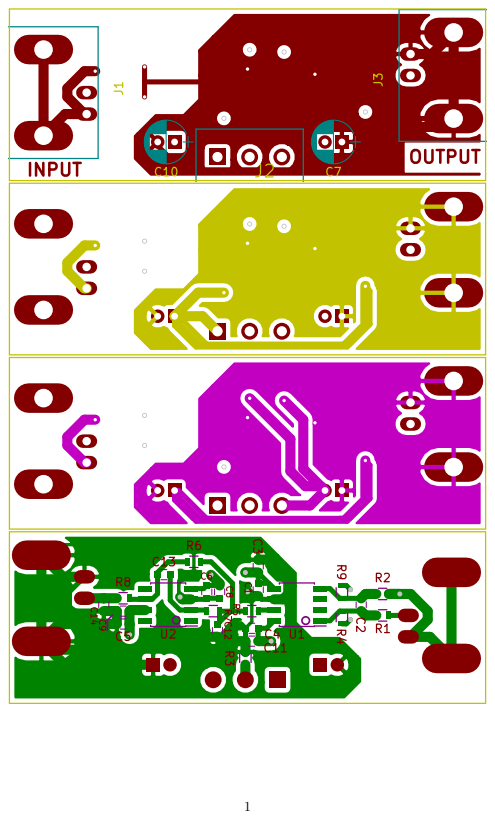
[picture p440: page 1]
