nacs-lab/yyc-data/designs/pre-amp/pre-amp-B.pdf

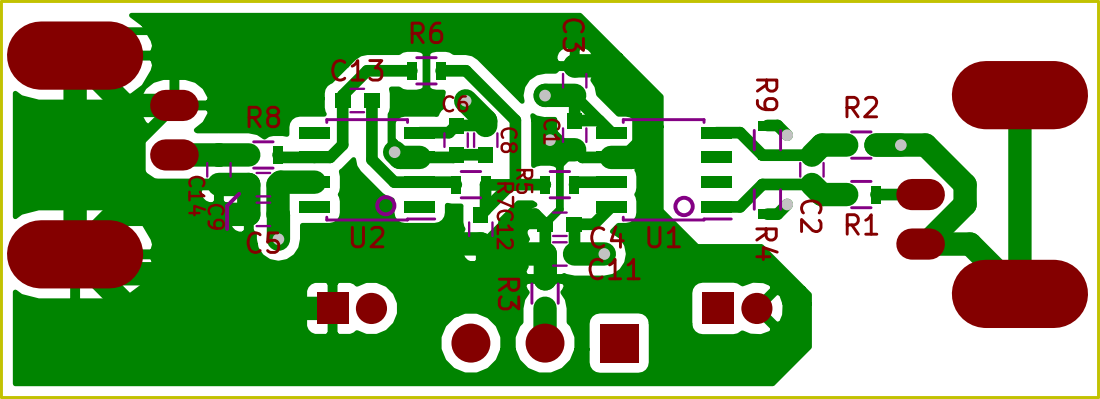
[picture p441: page 1]
