nacs-lab/yyc-data/designs/pre-amp/pre-amp-F.pdf

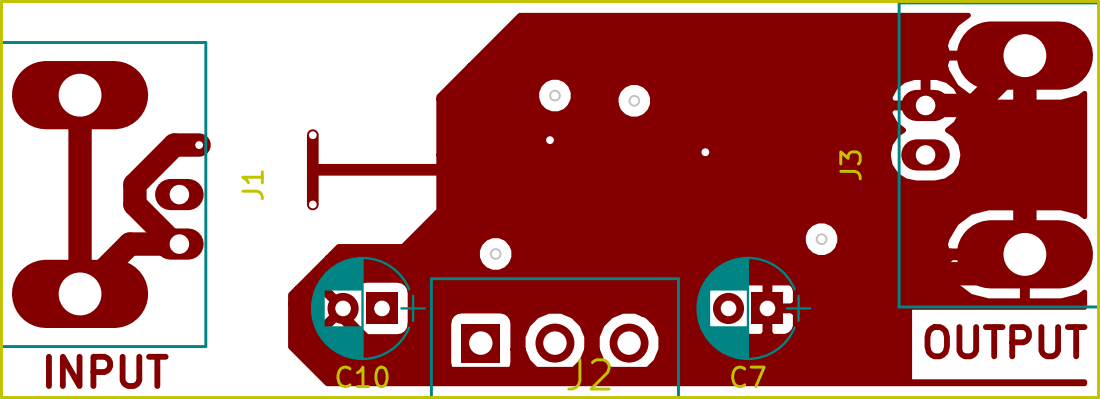
[picture p442: page 1]
