nacs-lab/yyc-data/designs/pre-amp/pre-amp-In1.pdf

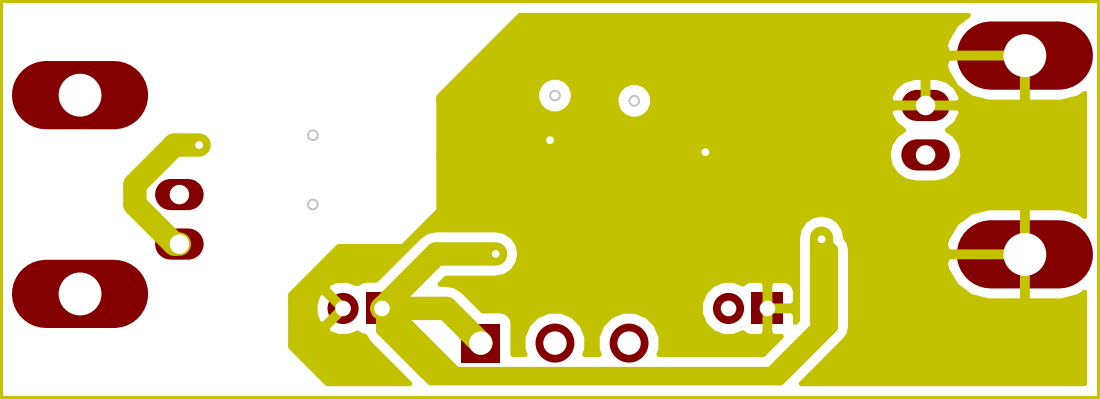
[picture p443: page 1]
