nacs-lab/yyc-data/designs/pre-amp/pre-amp-In2.pdf

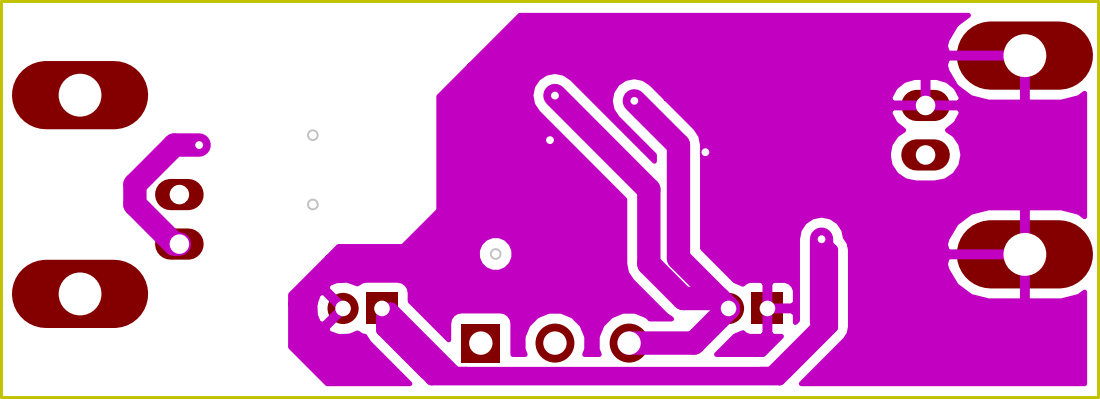
[picture p444: page 1]
