nacs-lab/yyc-data/designs/regulator/combined.pdf

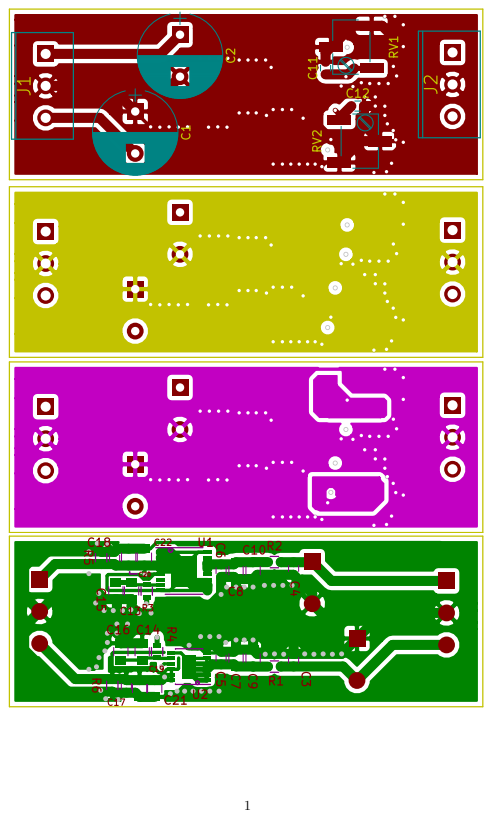
[picture p445: page 1]
