nacs-lab/yyc-data/designs/regulator/regulator-B.pdf

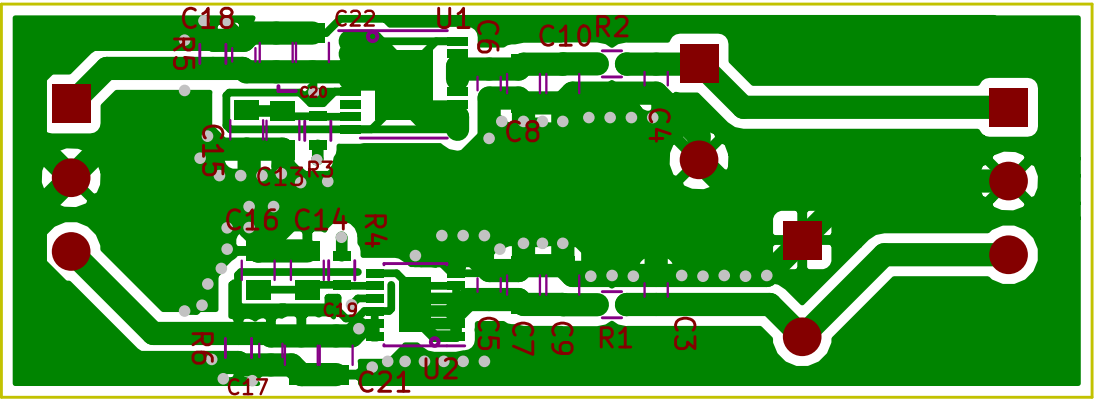
[picture p446: page 1]
