nacs-lab/yyc-data/designs/regulator/regulator-F.pdf

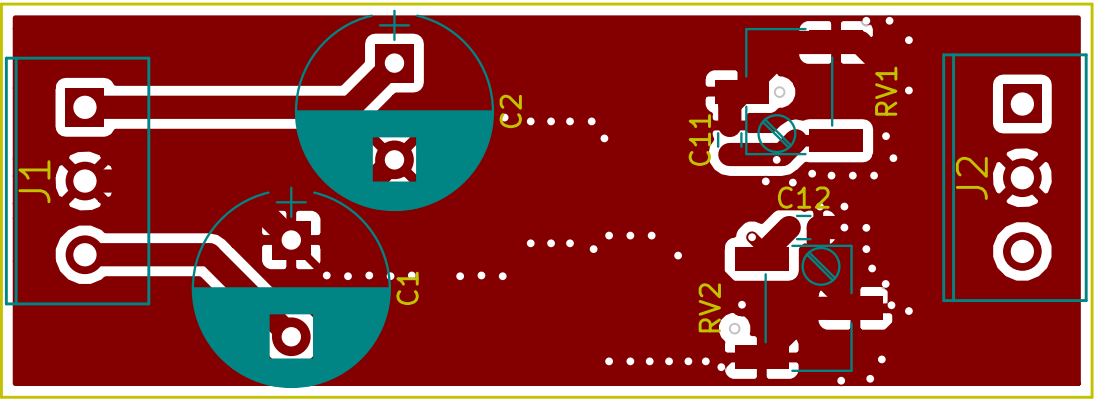
[picture p447: page 1]
