nacs-lab/yyc-data/designs/regulator/regulator-In1.pdf

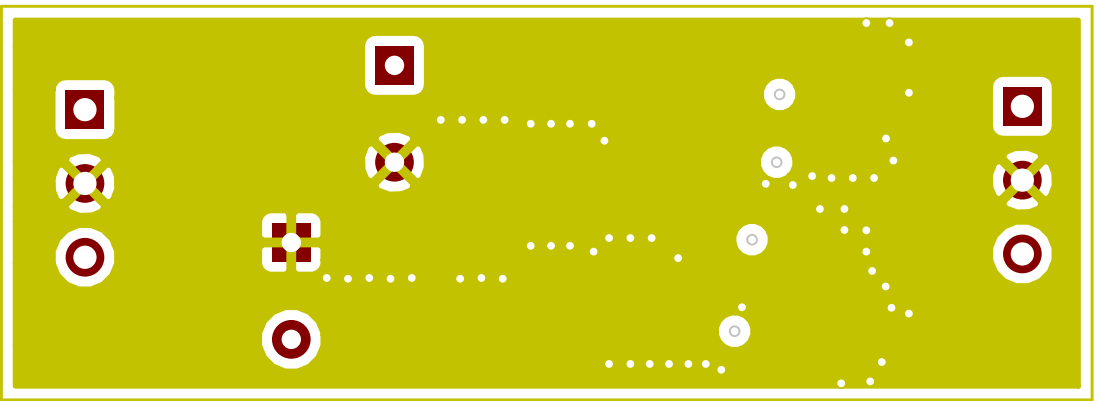
[picture p448: page 1]
