nacs-lab/yyc-data/designs/regulator/regulator-In2.pdf

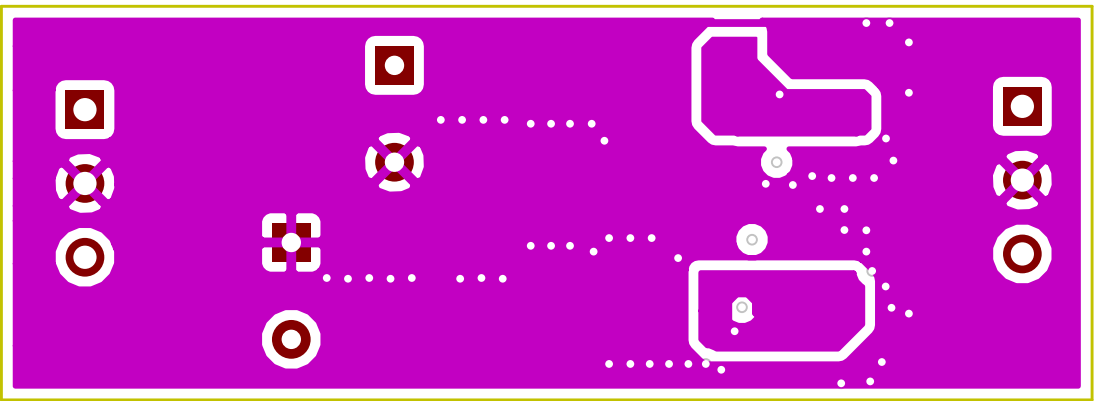
[picture p449: page 1]
