nacs-lab/yyc-data/presentations/damop-2018-poster/data_20180421_002556_eit-v0.pdf

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

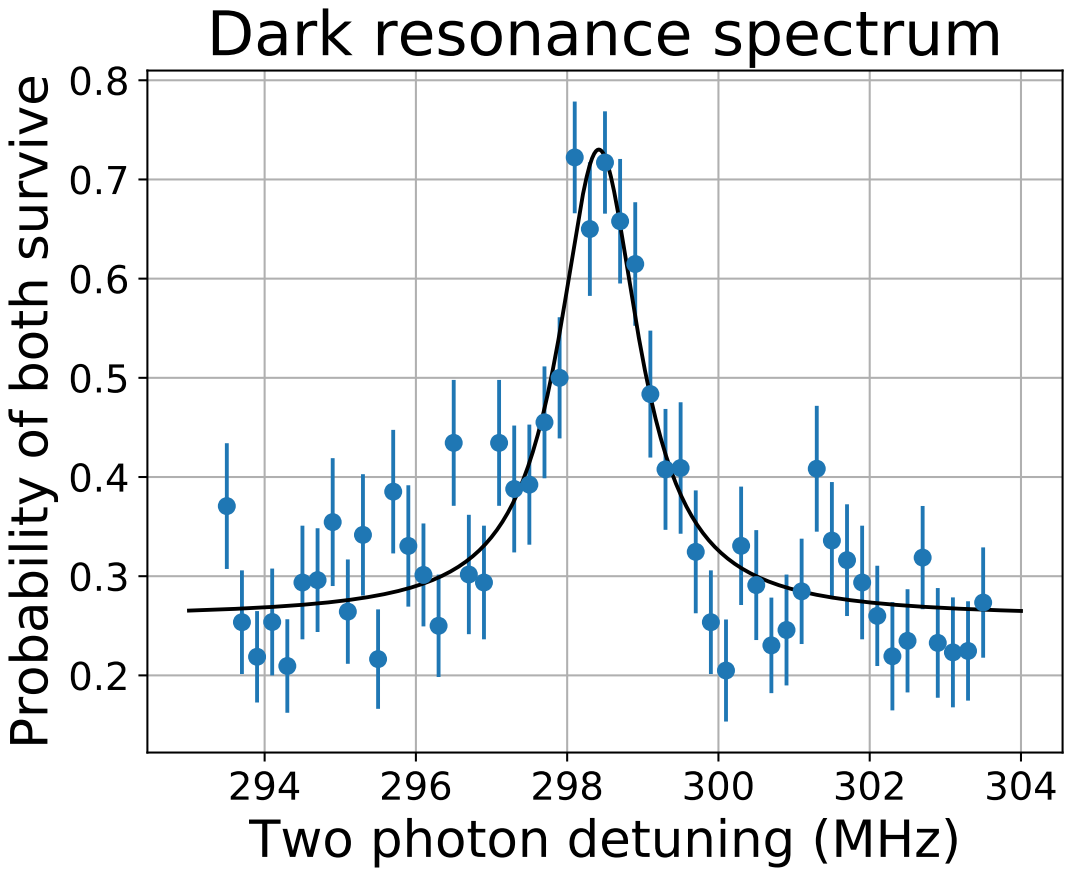
[picture p450: page 1]
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
