nacs-lab/yyc-data/presentations/damop-2018-poster/raman-v0.pdf

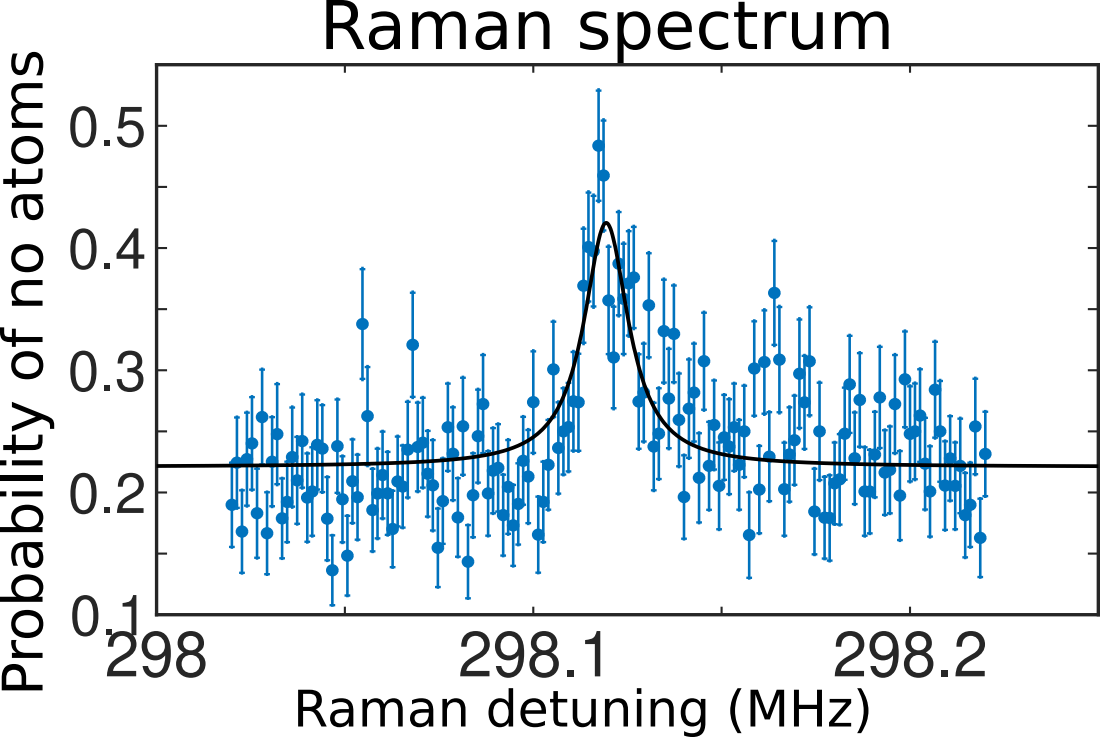
[picture p451: page 1]
Raman spectrum

Probability of no atoms

Raman detuning (MHz)
