nacs-lab/yyc-data/presentations/damop-2018-poster/pa-v0.pdf

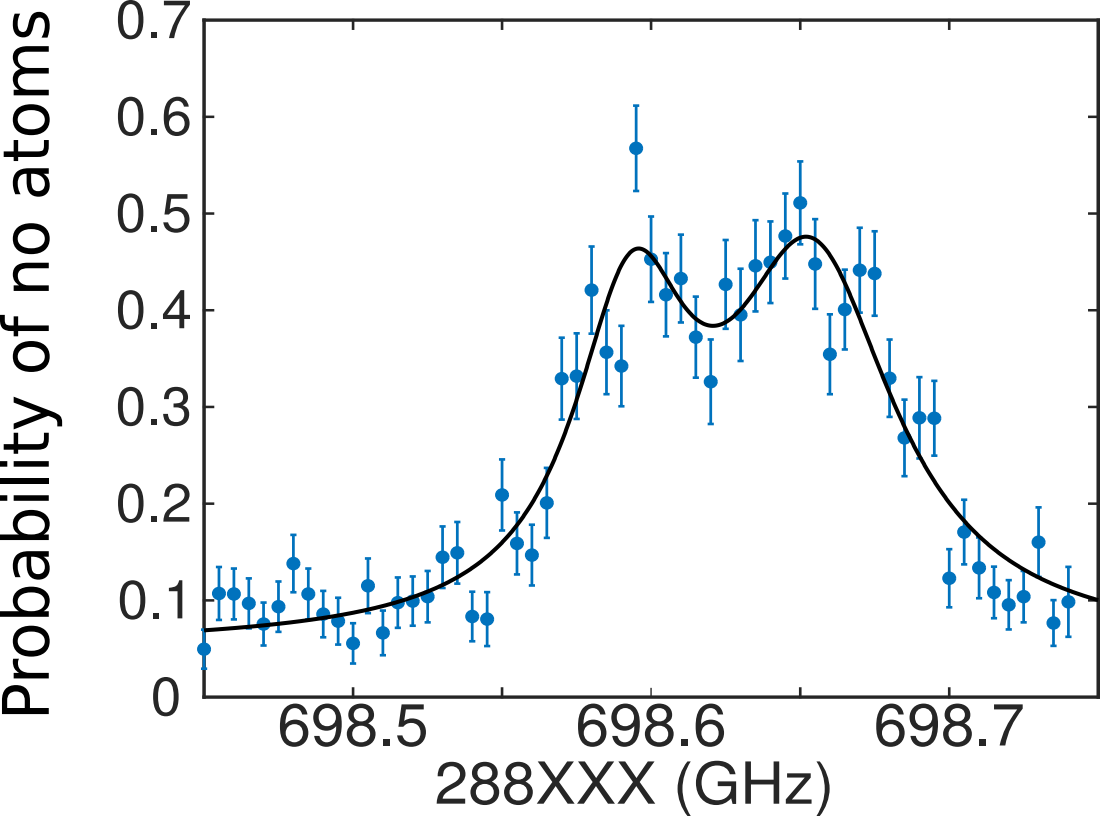
[picture p452: page 1]
288XXX (GHz)

Probability of no atoms
