nacs-lab/yyc-data/presentations/damop-2018-poster/cs-raman.pdf

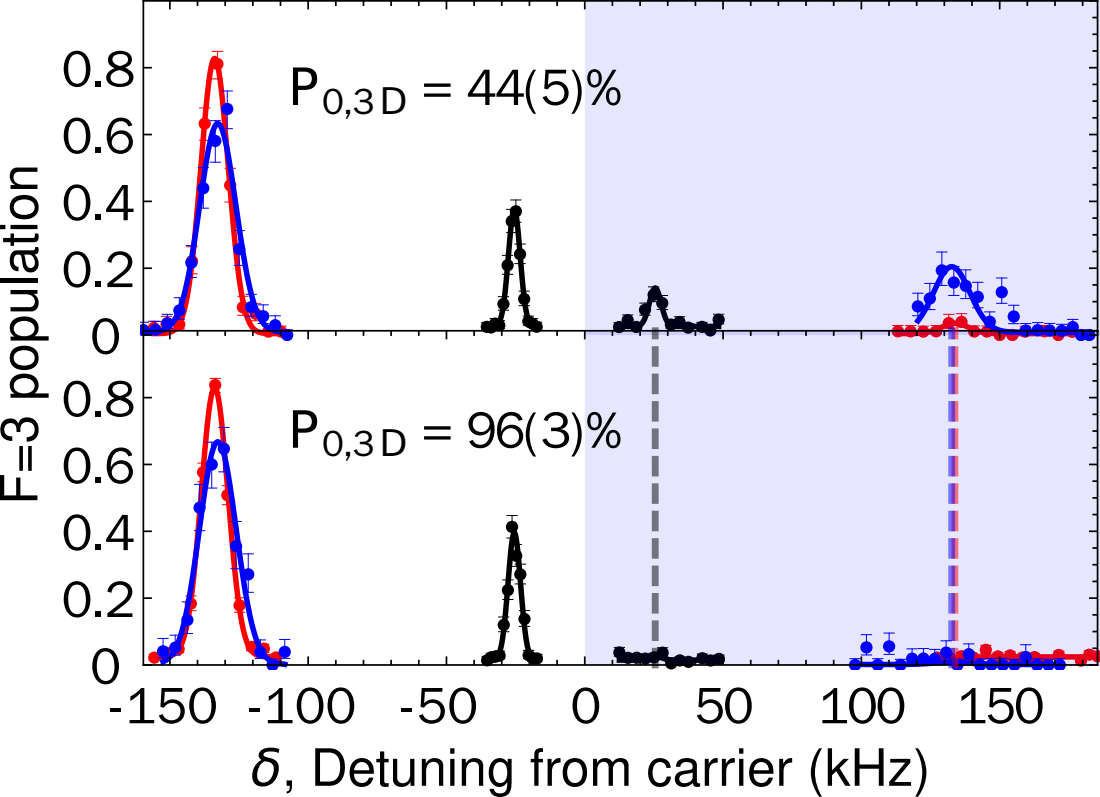
[picture p453: page 1]
δ, Detuning from carrier (kHz); F=3 population
