nacs-lab/yyc-data/experiments/polarization_align/2017-09-11.pdf

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

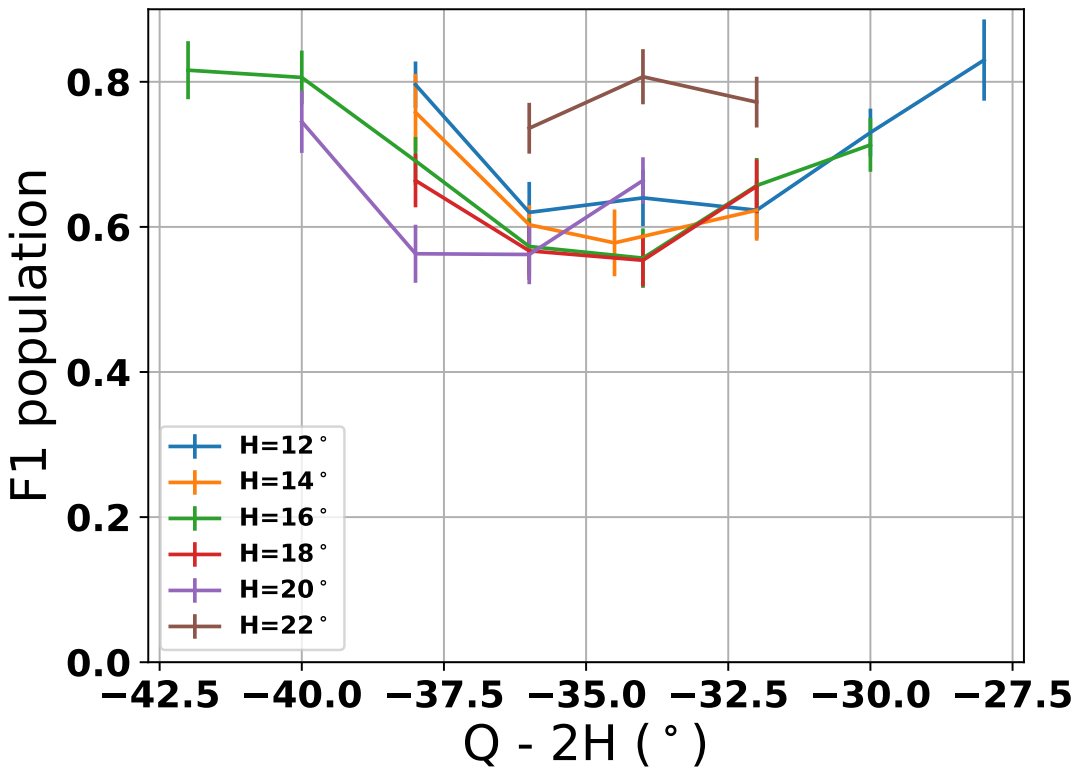
[picture p454: page 1]
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
