nacs-lab/yyc-data/presentations/2020-defense/figures/raman_transfer_spectrum.pdf

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

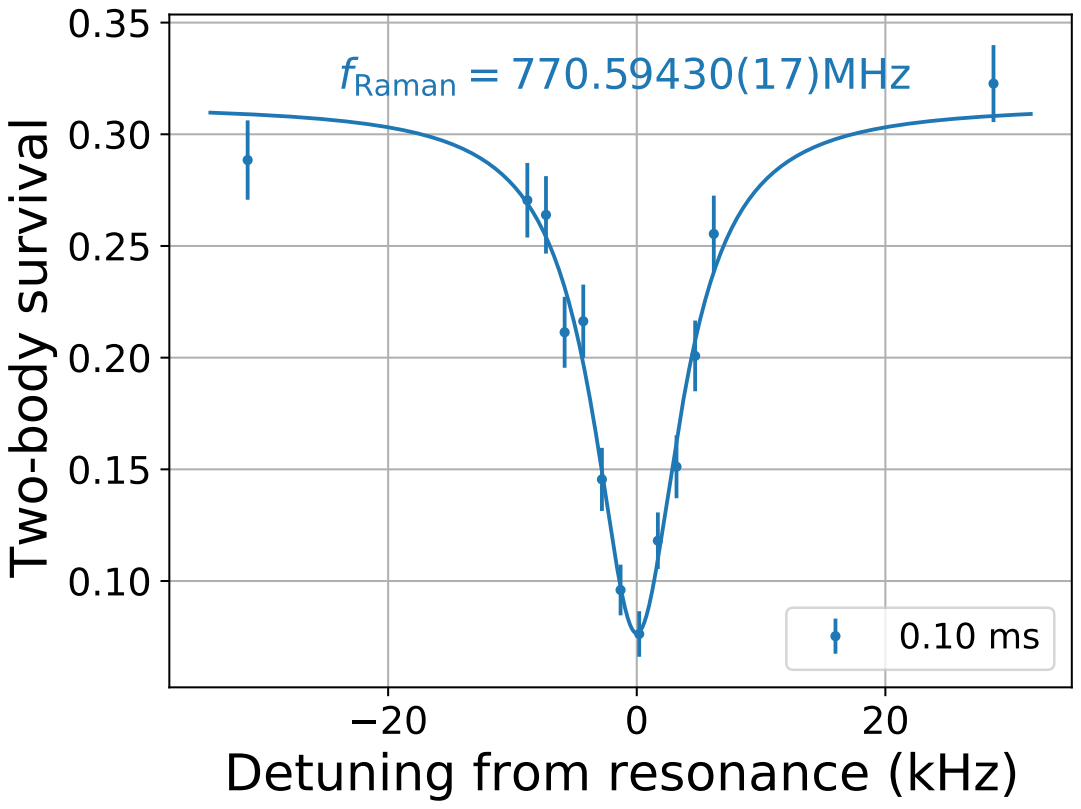
[picture p455: page 1]
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
