nacs-lab/yyc-data/presentations/2020-defense/figures/raman_transfer_spectrum_text.pdf

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

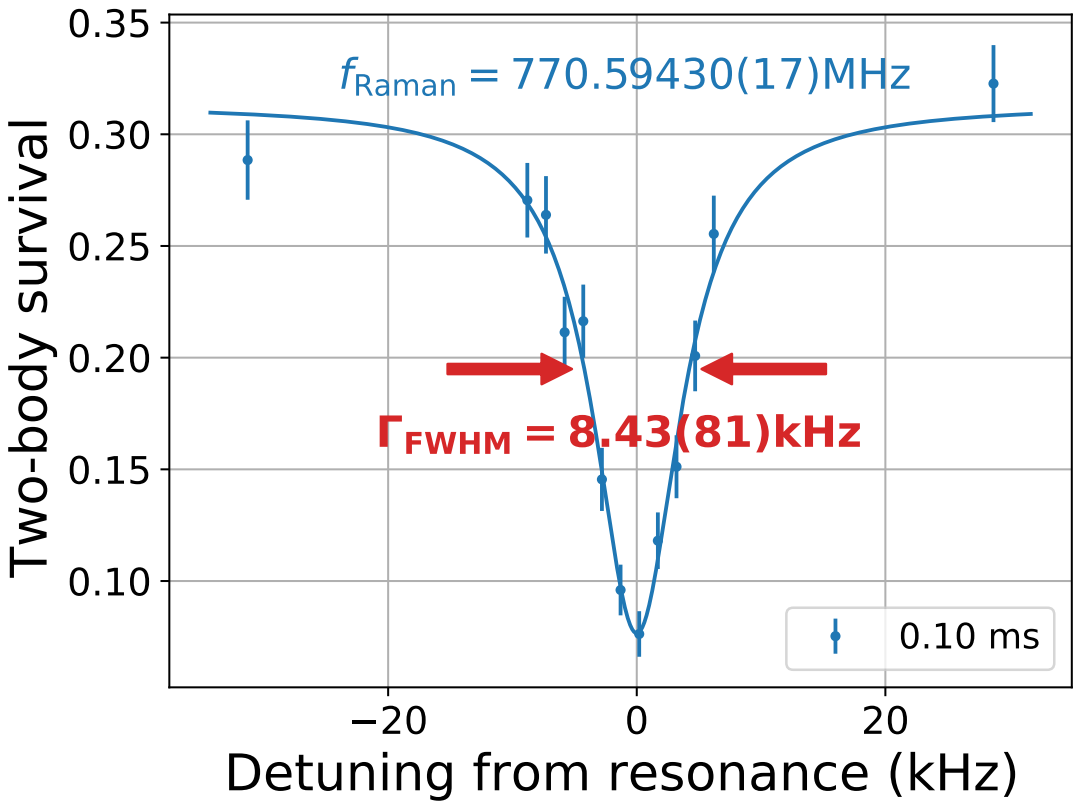
[picture p456: page 1]
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
