nacs-lab/yyc-data/presentations/2020-defense/figures/interaction_shift_spectrum_32_31.pdf

### Na only Na + Cs

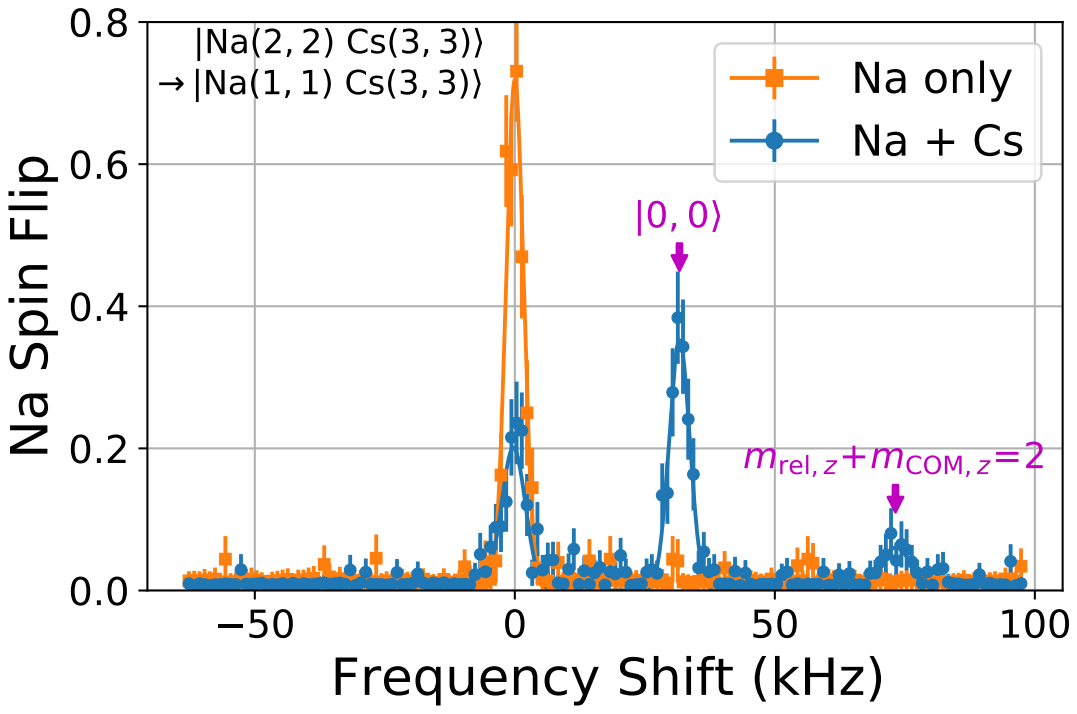
[picture p459: page 1]
mrel, z+mCOM, z=2

Na Spin Flip

Frequency Shift (kHz)
