nacs-lab/yyc-data/presentations/2020-defense/figures/interaction_shift_spectrum_42_32.pdf

### Cs only Na + Cs

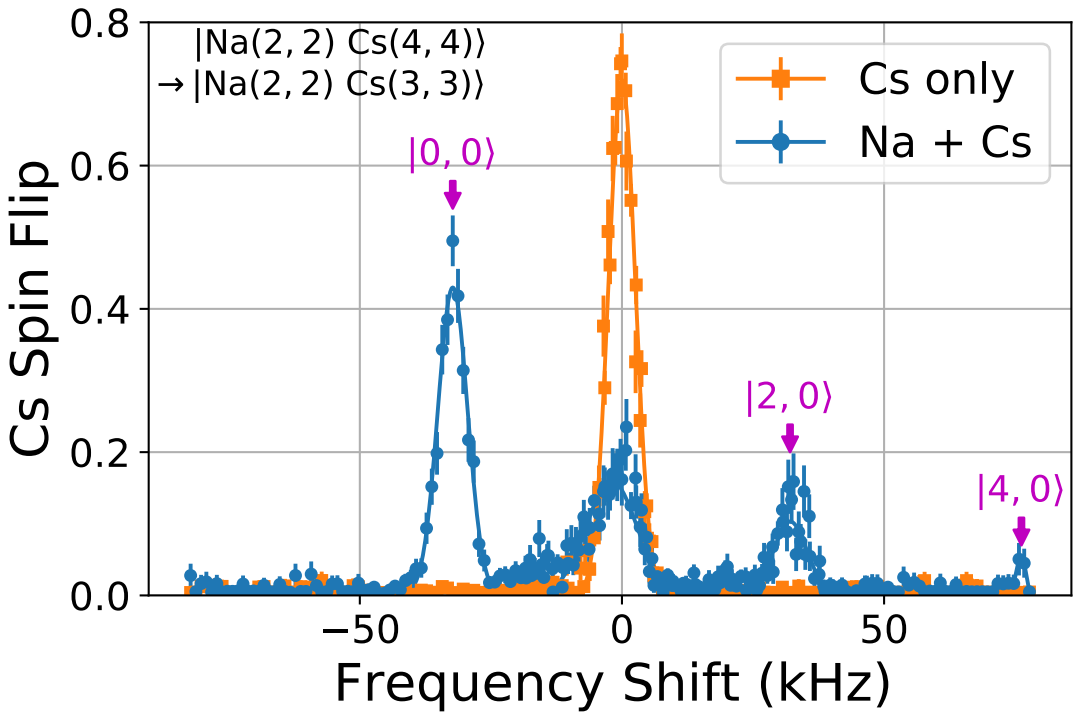
[picture p460: page 1]

Cs Spin Flip

Frequency Shift (kHz)
