nacs-lab/yyc-data/presentations/2020-defense/figures/interaction_shift_spectrum_42_32_nostate.pdf

### Na + Cs

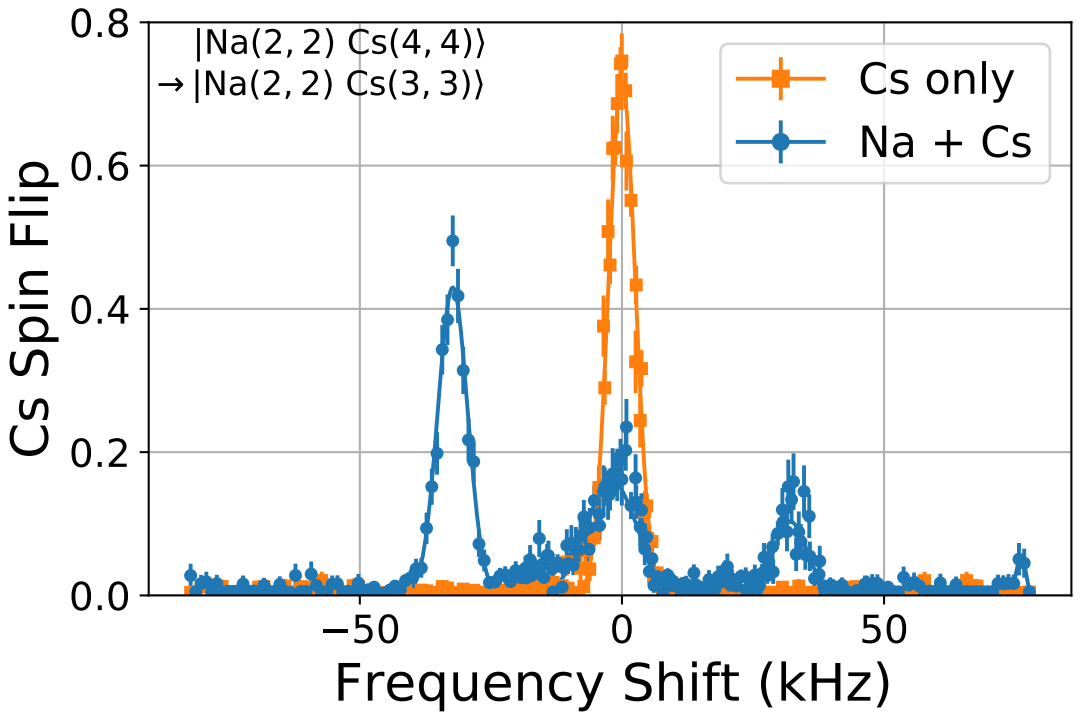
[picture p461: page 1]
Cs only

Cs Spin Flip

Frequency Shift (kHz)
