nacs-lab/yyc-data/experiments/nacs_201905/imgs/data_20190503_123311_pa_3322_2b.pdf

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

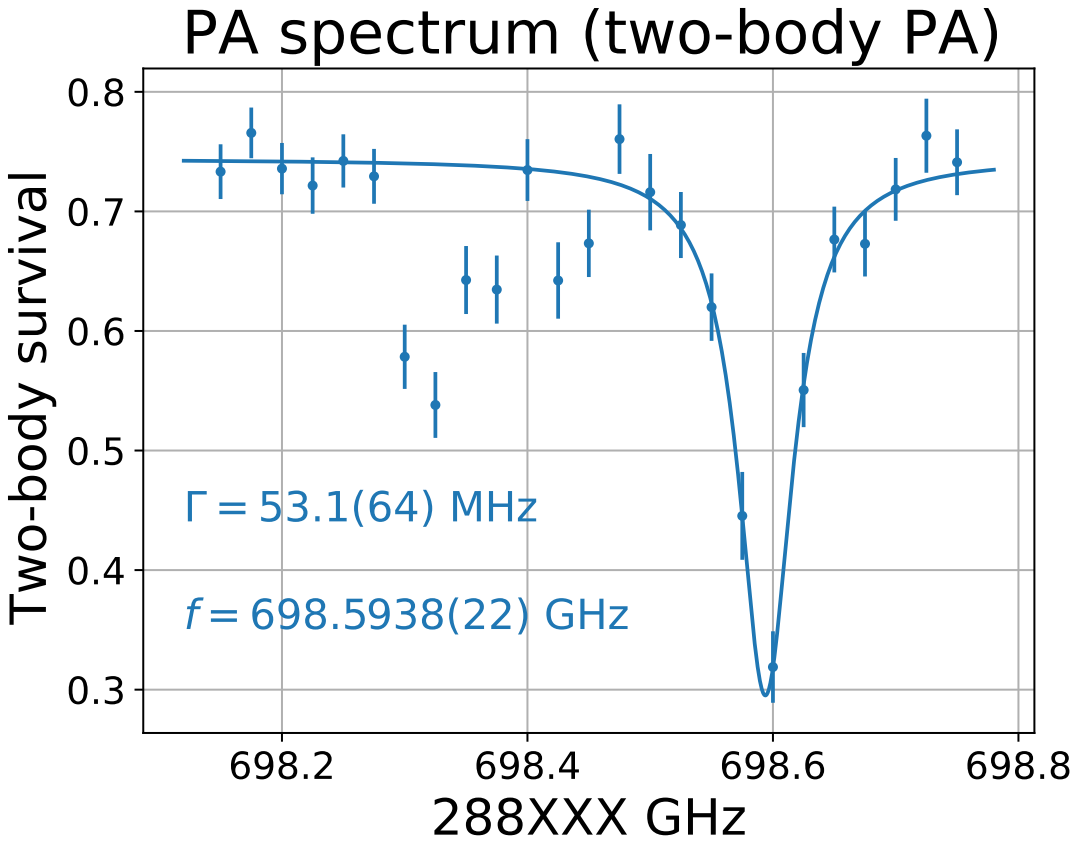
[picture p462: page 1]
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
