nacs-lab/yyc-data/experiments/nacs_201912/imgs/data_20191219_raman_scatter_cs.pdf

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

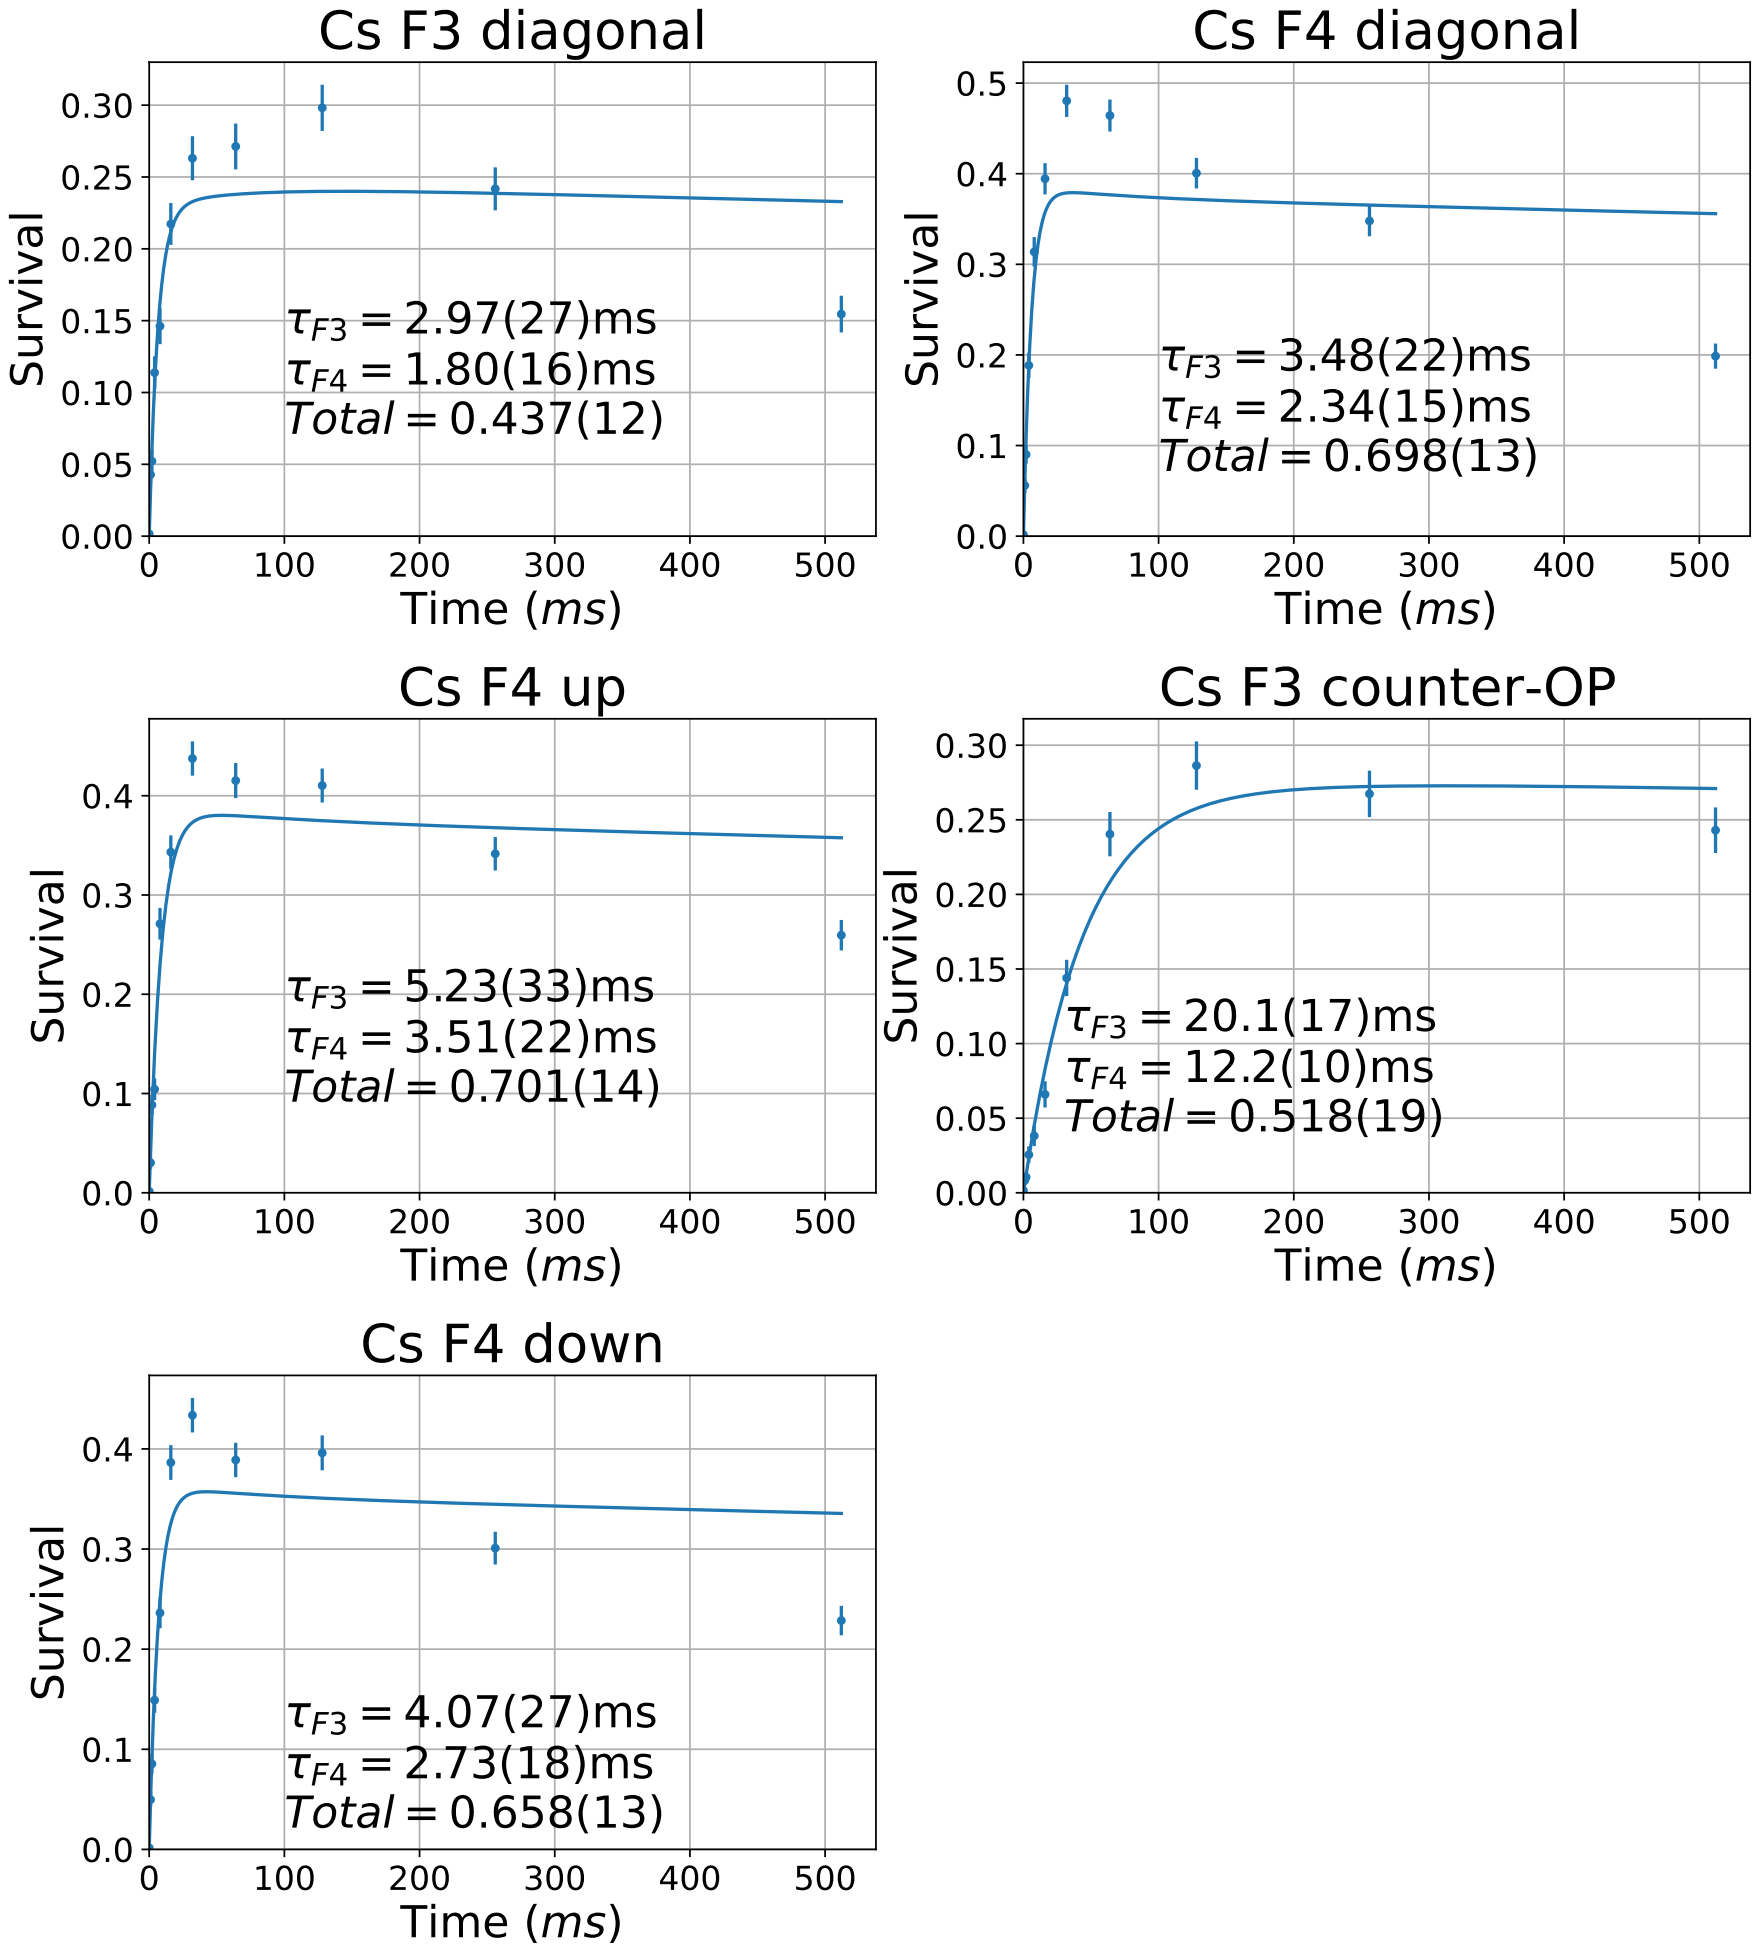
[picture p463: page 1]
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
