nacs-lab/yyc-data/experiments/nacs_201912/imgs/data_20191219_raman_scatter_na.pdf

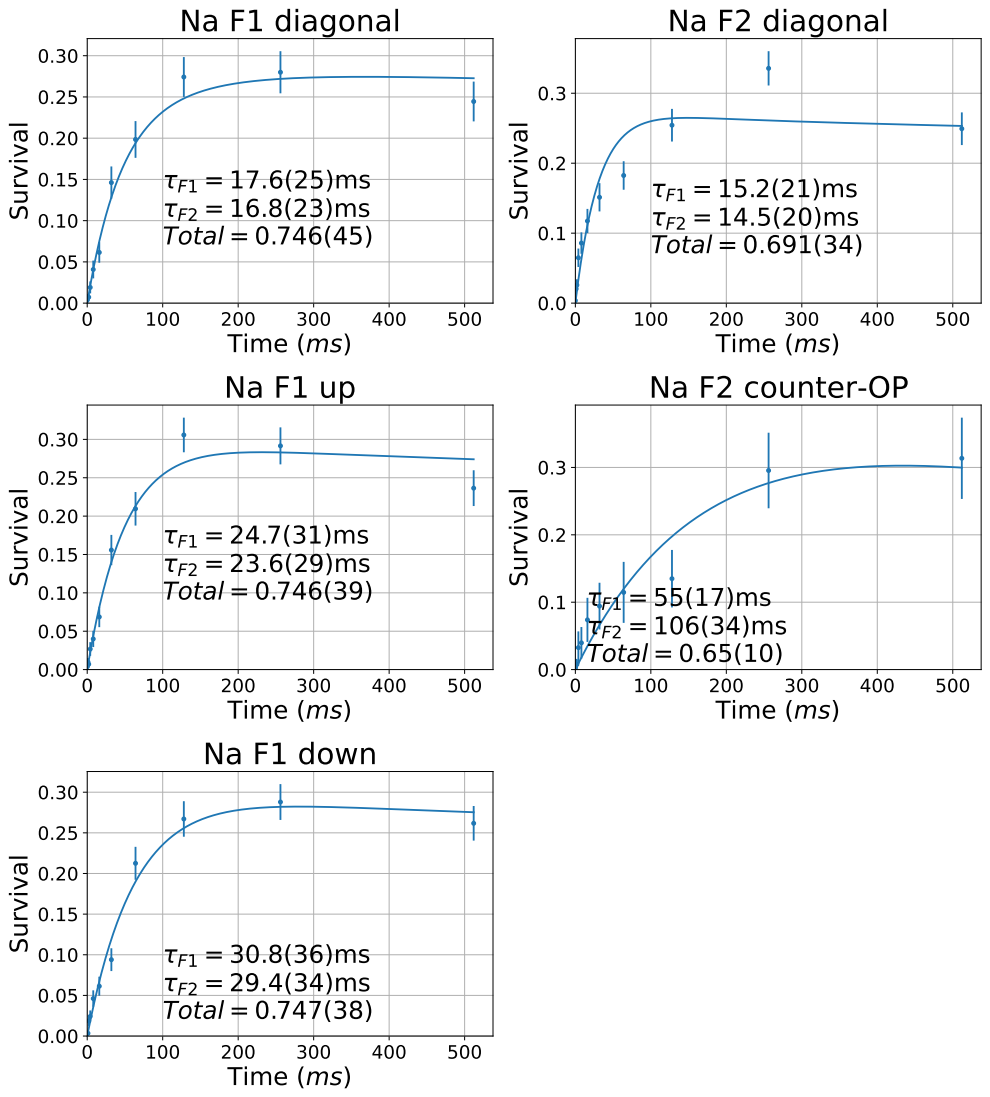
[picture p464: page 1]
Time (ms); Survival; Na F1 diagonal; Na F2 diagonal; F1 = 55(17)ms F2 = 106(34)ms Total = 0.65(10); Na F1 down

F1 = 17.6(25)ms
F2 = 16.8(23)ms
Total = 0.746(45)

F1 = 15.2(21)ms F2 = 14.5(20)ms
Total = 0.691(34)

Na F2 counter-OP

F1 = 24.7(31)ms
F2 = 23.6(29)ms Total = 0.746(39)

F1 = 30.8(36)ms
F2 = 29.4(34)ms
Total = 0.747(38)
