nacs-lab/yyc-data/experiments/nacs_201808/imgs/data_20180815_interaction_shift4_na_n0.pdf

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

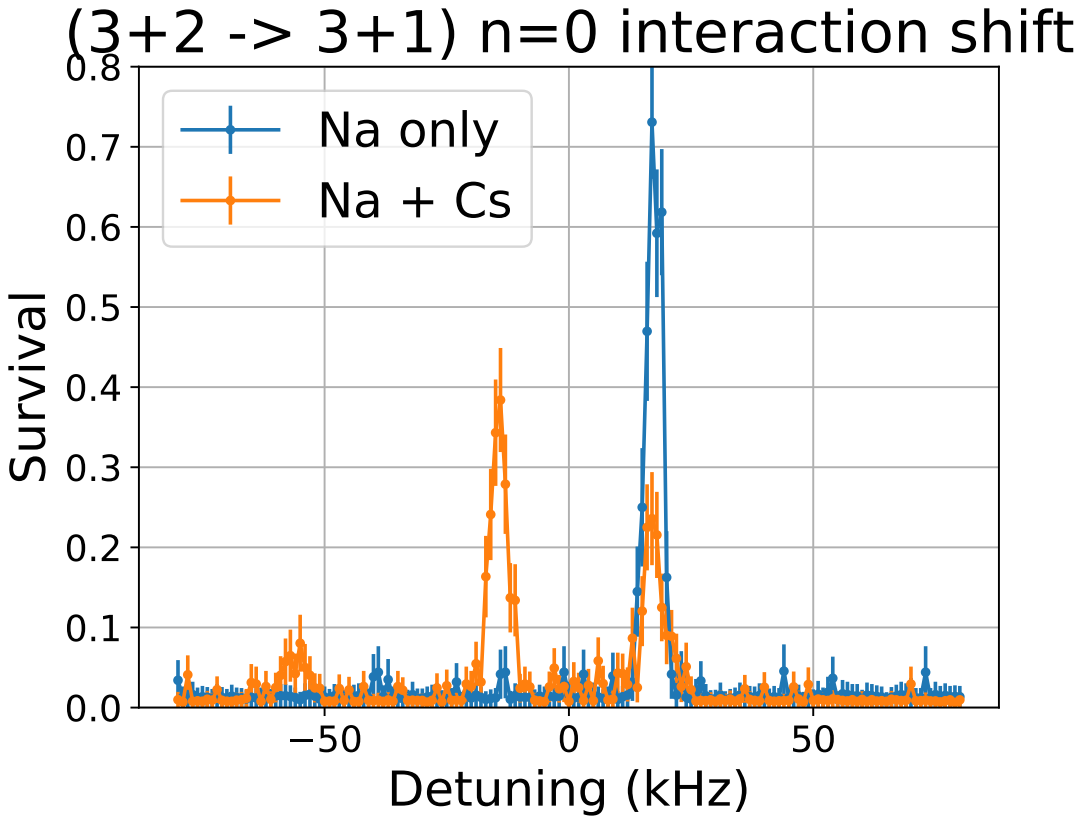
[picture p468: page 1]
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
