nacs-lab/yyc-data/experiments/pa_201909/imgs/data_20190901_232500_pa_time.pdf

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

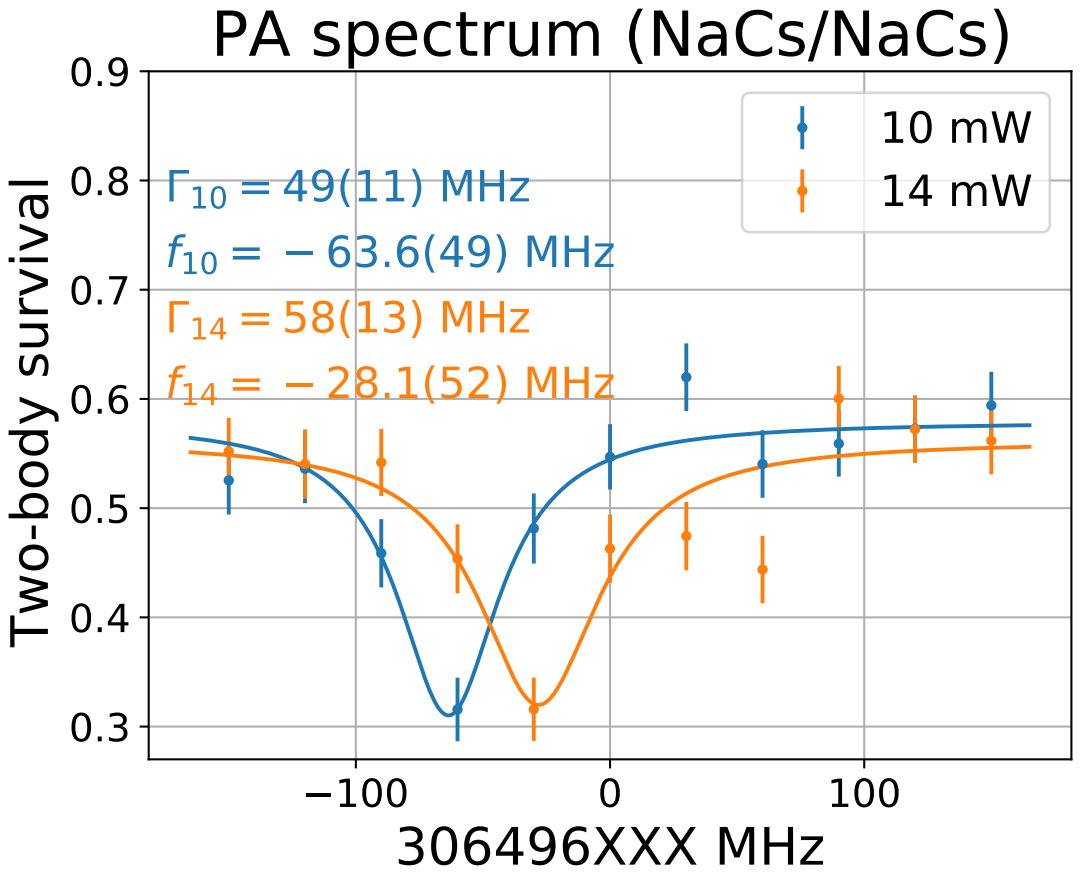
[picture p472: page 1]
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
