nacs-lab/yyc-data/experiments/pa_201909/imgs/data_20190901_232500_pa_time_1b2b.pdf

## PA spectrum (two-body 10 mW)

## PA spectrum (two-body 14 mW)

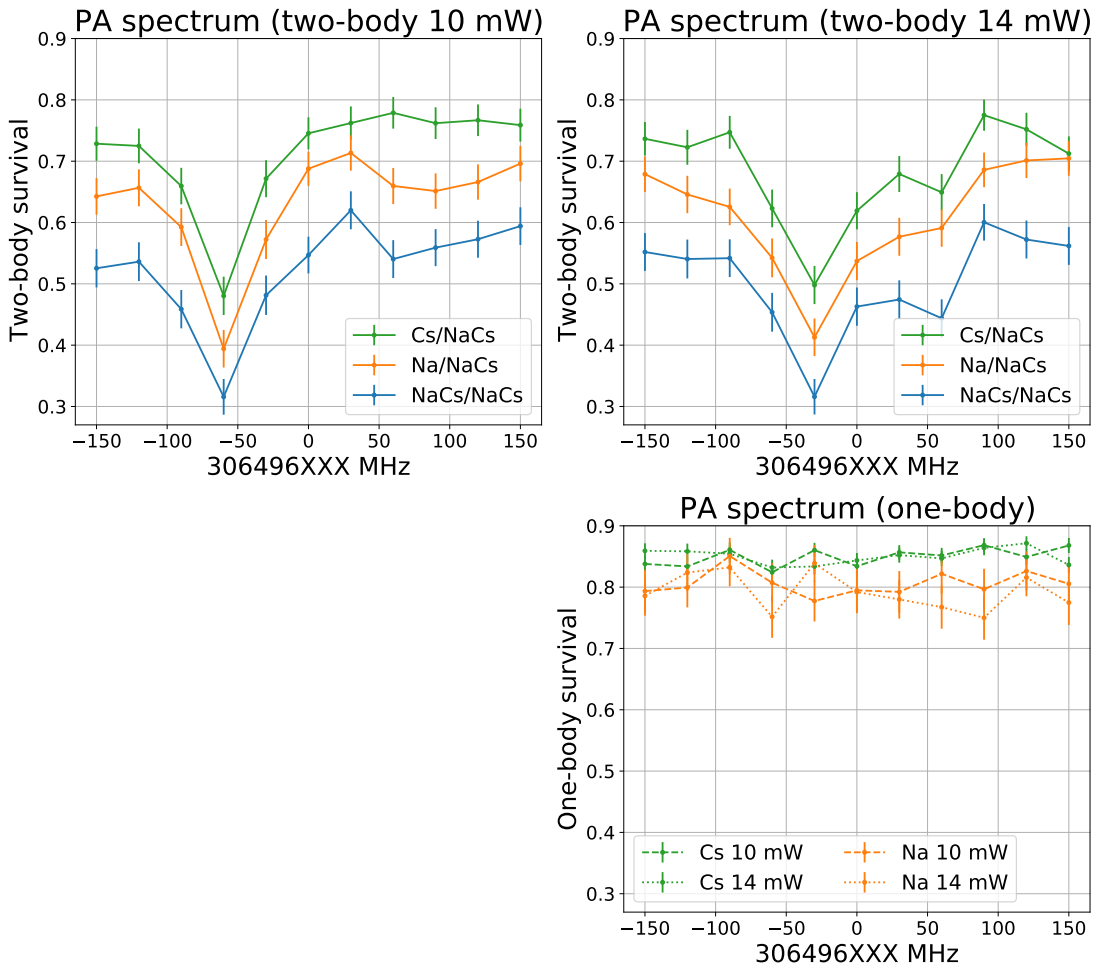
[picture p473: page 1]
306496XXX MHz; Cs/NaCs Na/NaCs NaCs/NaCs

Two-body survival

PA spectrum (one-body)

One-body survival
