nacs-lab/yyc-data/experiments/pa_201908/imgs/data_20190830_162626_pa_2b.pdf

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

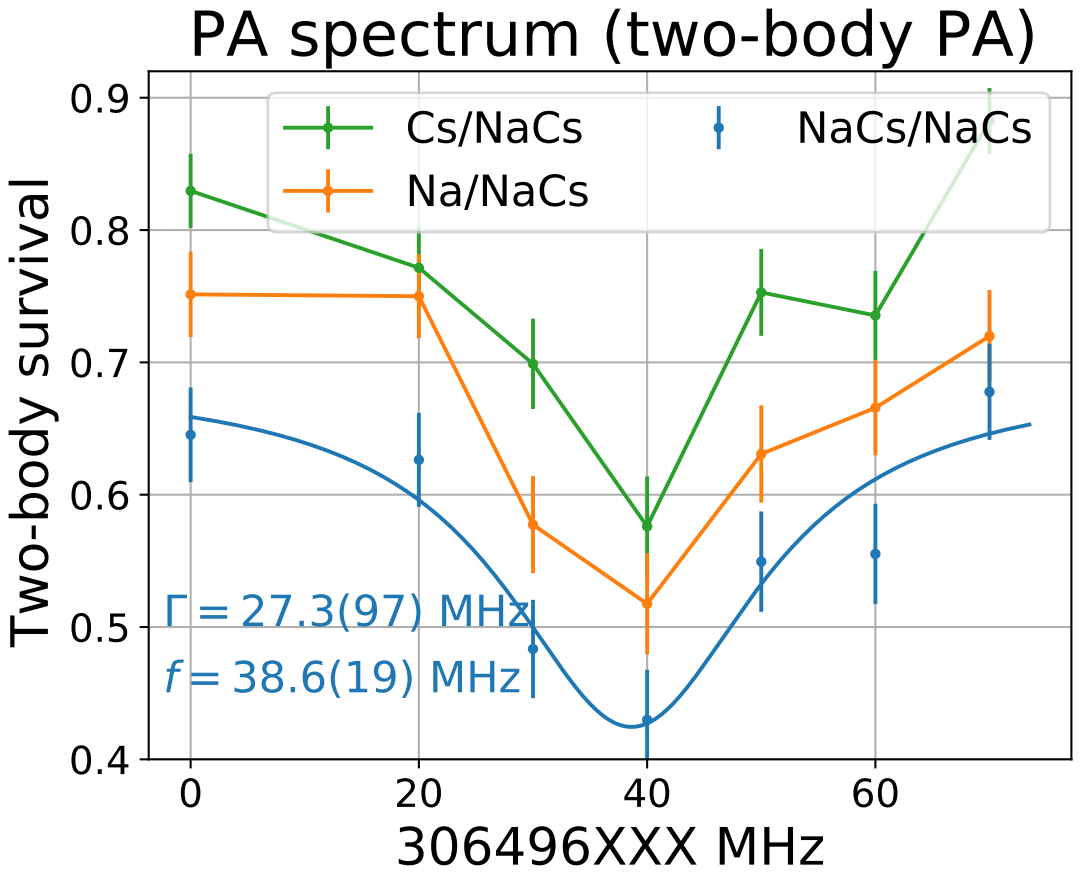
[picture p475: page 1]
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
