nacs-lab/yyc-data/experiments/pa_201908/imgs/data_20190830_072607_pa_tw_pwr.pdf

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

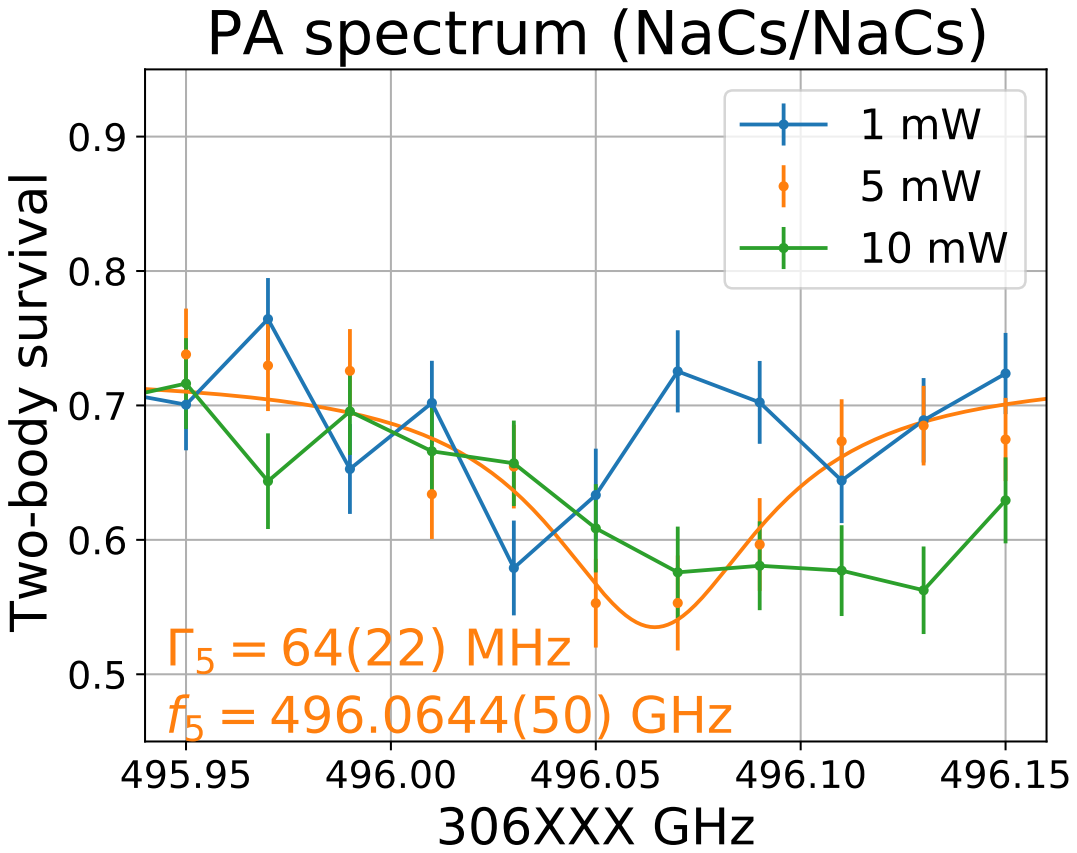
[picture p476: page 1]
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
