nacs-lab/yyc-data/experiments/pa_201908/imgs/data_20190830_072607_pa_tw_pwr_1b2b.pdf

## PA spectrum (two-body 1 mW)

## PA spectrum (two-body 5 mW)

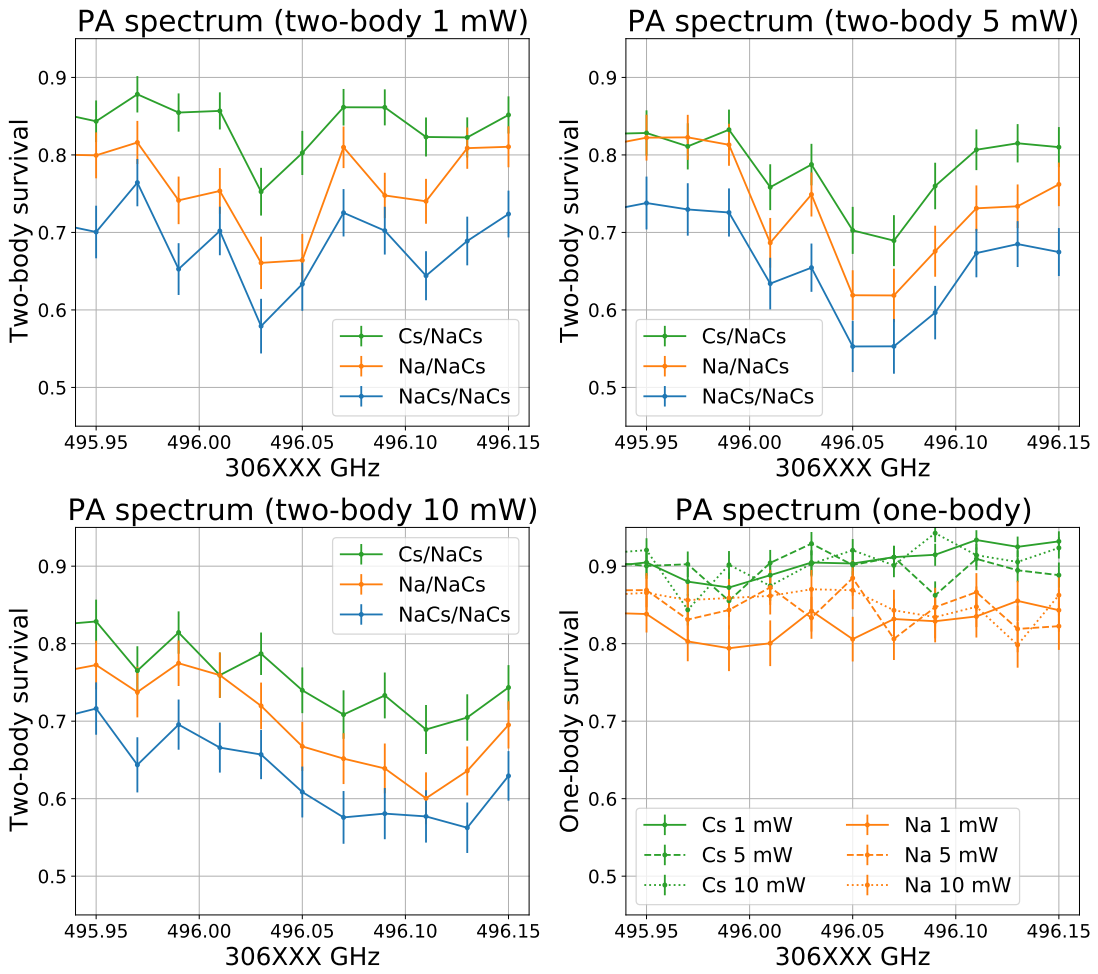
[picture p477: page 1]
306XXX GHz; Cs/NaCs Na/NaCs NaCs/NaCs

Two-body survival

PA spectrum (two-body 10 mW)

PA spectrum (one-body)

One-body survival
