nacs-lab/yyc-data/experiments/pa_201908/imgs/data_20190830_005224_pa_tw_pwr_2b_5.pdf

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

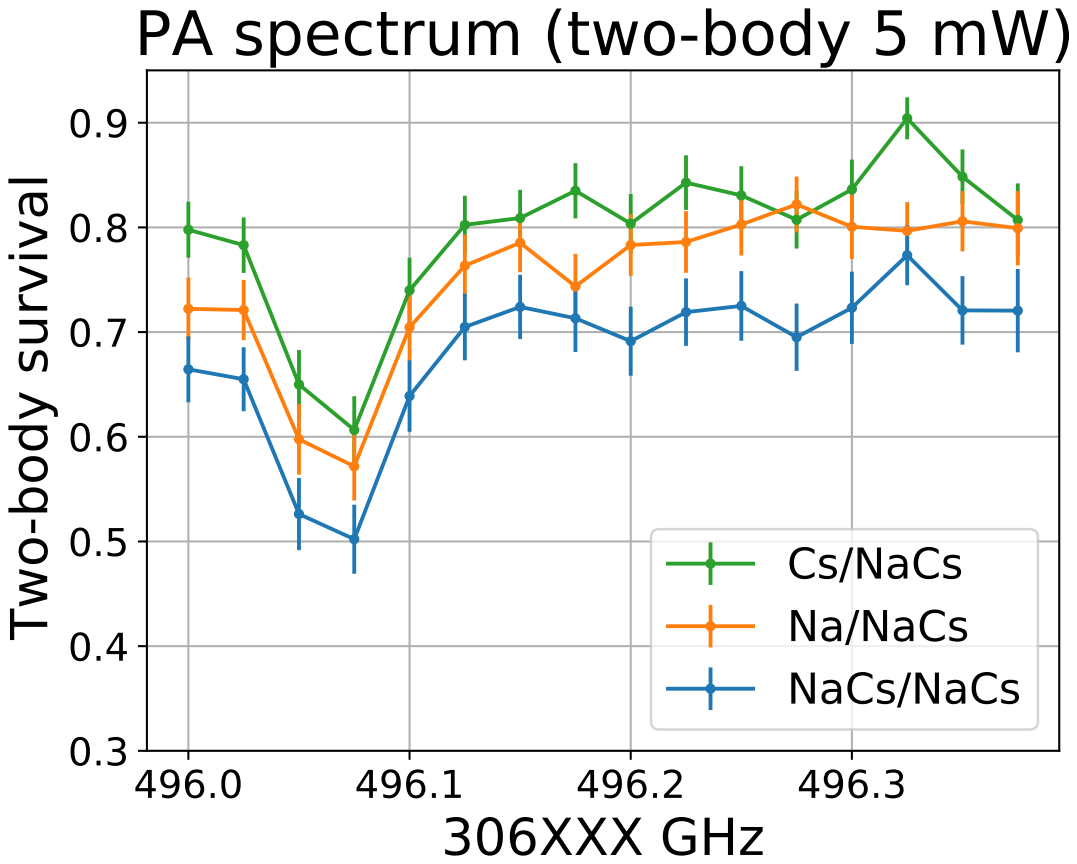
[picture p481: page 1]
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
