nacs-lab/yyc-data/(commit log)

2014-08-21 [lp-filter] low pass filter calculation
2014-09-19 [sideband/obe] more precise description of pumping
2014-09-19 [sideband/obe] branching ratio and off-resonant coupling
2014-09-22 [sideband] pump_branch
2014-12-12 [digikey] op amp and bnc cables
2014-12-12 [digikey] solder paste
2014-12-12 [digikey] RF connectors
2014-12-12 [digikey] missing connectors
2014-12-17 [cmr_link] empty
    [cmr_link.kicad_pcb, cmr_link.sch]
2014-12-17 [cmr_link] decoder
    [cmr_link.sch]
2014-12-23 [dds-setup] voltages, list
2014-12-23 [dds-voltages] voltages test
2014-12-23 [dds-voltages] more failure rate and scope trace
2014-12-23 [dds-voltages] markdown...
2014-12-23 [dds-voltages] trace for the second board
2014-12-23 [dds-voltages] trace afterward
2014-12-23 [dds-voltages] test
2014-12-23 [dds-voltages] more test
2014-12-23 [dds-voltages] table
2015-01-17 [cmr_link] footprint, net list, layout
    [cmr_link.kicad_pcb, cmr_link.sch]
2015-01-21 [na_laser] connectors
2015-01-21 [na_laser] mot laser pin out
2015-01-21 [na_laser] raman laser pin out
2015-01-27 [beam_paths] legend for fiber coupler
2015-02-01 [misc] organize
    [cmr_link.kicad_pcb, cmr_link.sch]
2015-02-01 [na_laser/amp_noise] traces
2015-02-13 [cmr_link] connector
    [cmr_link.kicad_pcb, cmr_link.sch]
2015-02-17 [cmr_link] connections
    [cmr_link.sch]
2015-02-17 [cmr_link] board settings, less confusing power connections, TODO
    [cmr_link.kicad_pcb, cmr_link.sch]
2015-02-19 [cmr_link] ...
    [cmr_link.kicad_pcb, cmr_link.sch]
2015-02-19 [cmr_link] schematics
    [cmr_link.sch]
2015-02-19 [cmr_link] notes on pin assignments
2015-02-19 [cmr_link] annotate and net list
    [cmr_link.sch]
2015-02-19 [cmr_link] power connector
    [cmr_link.kicad_pcb, cmr_link.sch]
2015-02-19 [cmr_link] powers
    [cmr_link.kicad_pcb, cmr_link.sch]
2015-02-20 [cmr_link] finish up
    [cmr_link.kicad_pcb]
2015-02-20 [cmr_link/fab] plot for fabrication
    [cmr_link-B_Cu.gbl, cmr_link-B_Mask.gbs, cmr_link-B_SilkS.gbo, cmr_link-Edge_Cuts.gbr, cmr_link-F_Cu.gtl, cmr_link-F_Mask.gts, cmr_link-F_SilkS.gto, cmr_link-In1_Cu.gbr]
2015-02-28 [cmr_link] fix connector footprint
    [cmr_link.kicad_pcb]
2015-03-03 [na_laser/connectors] add connector pin-out for thorlabs controllers
2015-03-04 [na_laser/connectors] thorlabs gender
2015-04-20 [dds-setup/KRb_DDS_test1] test fixed No. 7 board
2015-04-28 [calculation/sodiium-absorption] scope traces for soldium absorption
    [cursor.csv, full.csv, screen.csv]
2015-05-03 [present/2015-05-05] toptica diode spectrum
2015-05-03 [present/2015-05-05] cs sidebands
    [Cs_sidebands_Counts.csv, Cs_sidebands_Det.csv, Cs_sidebands_ParamList.csv, Cs_sidebands_SingleAtom.csv]
2015-05-04 [present/2015-05-05] Na diode
2015-05-04 [present/2015-05-05] Na seed and doubler
    [Na_doubler_power.csv, Na_seed_power.csv]
2015-05-04 [present/2015-05-05] Update Na Laser plots
2015-05-05 [present/2015-05-05] chamber photo
2015-05-07 [na_laser/new_laser] mode hop free range
    [mhf_320.csv]
2015-05-28 [dds_power] dc-dc converter
    [dds_power.kicad_pcb, dds_power.sch]
2015-05-28 [dds_power] dc-dc converter footprint
2015-05-28 [dds_power] schematics
    [dds_power.sch]
2015-05-28 [dds_power] net list
    [dds_power.sch]
2015-05-29 [dds_power] connectors
    [dds_power.sch]
2015-05-29 [dds_power] capacitor
    [dds_power.sch]
2015-05-29 [dds_power] ground and net list
    [dds_power.sch]
2015-05-29 [dds_power] pcb
    [dds_power.kicad_pcb, dds_power.sch]
2015-05-29 [dds_power] tweak
    [dds_power.kicad_pcb, dds_power.sch]
2015-05-29 [dds_power] export
    [dds_power.kicad_pcb]
2015-05-29 [dds_power] gbr files
    [dds_power-B_Cu.gbr, dds_power-B_Mask.gbr, dds_power-B_SilkS.gbr, dds_power-Edge_Cuts.gbr, dds_power-F_Cu.gbr, dds_power-F_Mask.gbr, dds_power-F_SilkS.gbr, dds_power-In1_Cu.gbr]
2015-05-29 [dds_power] drill files
    [dds_power.drl]
2015-06-09 [experiments/vescent_oscillation] scope trace
2015-06-09 [experiments/vescent_oscillation] README
2015-06-09 [experiments/vescent_oscillation] wrong figure order
2015-06-29 [orders/computer_control] FPGA dev board
2015-06-29 [orders/computer_control] Camera link
2015-06-29 [orders/computer_control] Power breakout
2015-06-29 [orders/computer_control] FPGA breakout board
2015-07-03 [orders/digikey] 2015-07-03 laser controller
2015-07-11 Test heating
2015-07-14 [calculations/single-atom] new heating simulation
2015-07-14 [calculations/single-atom] @fastmath, use ground and excited state potentials, other typo fixes
2015-07-16 [calculations/single-atom] track sin and cos as well
2015-07-16 [calculations/single-atom] make it easier to switch between ploting types
2015-07-16 [calculations/single-atom] easier to switch plotting types
2015-07-17 [calculations/single-atom] fix calculation in the order of ground and excited state
2015-07-21 [calculations/single-atom] heating tests
2015-07-21 [calculations/single-atom] move heating tests
2015-07-22 [calculations/single-atom] real results for stochastic heating
2015-07-23 [calculations/single-atom] more results for stochastic heating
2015-07-31 [calculations/single-atom] Notes about stochastic heating
2015-08-03 [calculations/single-atom] coupling cache
2015-08-09 [calculations/single-atom] AbstractSetup. inlining to get rid of gc frames, other minor optimizations
2015-08-14 [calculations/single-atom] Include phase in the coupling strength
2015-08-19 [orders/digikey] 2015-08-19 Cable restock & Till power supply
2015-09-12 [design/na_board] add drawing for waterjeting the breadboard for the sodium laser
    [na_board_16.dxf, na_board_24.dxf]
2015-10-12 [present/2015-10-11] very breif note for the joint group meeting
2015-10-15 [orders/digikey] 2015-10-15 Cable/connectors restock
2015-10-21 [experiment/1.7G_EOM] Resonance curve
    [resonance-2015_10_21.csv]
2015-10-22 [calculations/single-atom] Update heating test script for benchmarking
2015-11-12 Allow phase to vary continuously when chaining multiple drives
2015-11-18 [calculations/practical-lz] better printing in test
2015-11-23 [present/2015-11-22] breif note for the joint group meeting
2016-02-22 [calculations/sideband_strength] plot of the strength of cooling and heating sidebands
2016-02-25 [experiments/tweezer_power] DC 2016/02/23
    [dc-2016_02_23.csv]
2016-02-25 [experiments/diabatic_lowering] add tweezer calibration
    [tweezer_power.csv]
2016-02-25 [experiments/diabatic_lowering] convert data to csv
    [data_20160223_125309.csv, data_20160223_132816.csv, data_20160223_154907.csv, data_20160223_173259.csv, data_20160223_201552.csv]
2016-02-27 [experiments/raman/radial-sidebands] convert to csv
    [data_20160226_170704.csv, data_20160226_183225.csv, data_20160226_193116.csv, data_20160226_201925.csv]
2016-05-11 [calculations/single-atom] convert to csv
    [gamma_5.csv]
2016-05-12 [calculations/single-atom] convert to csv, tweak plot
    [gamma_5_3.csv]
2016-05-13 [calculations/single-atom] convert to csv, plot
    [gamma_5_4.csv]
2016-05-16 [calculations/single-atom] remove magic case
2016-05-17 [calculations/single-atom] combine 11 and 12, save plot for 1 vs 2.5
    [gamma_5_11.csv]
2016-05-17 [calculations/single-atom] combined plot
    [gamma_5_10000_comb.csv, gamma_5_5_rev.csv, gamma_5_6_rev.csv, gamma_5_8000_comb.csv]
2016-05-22 [presentations/damop-2016] switching plot
2016-05-22 [presentations/damop-2016] Switching
2016-07-18 [experiments/tweezer_power] AC 2016/07/17
    [ac-2016_07_17.csv]
2016-07-18 [experiments/diabatic_lowering] fitting
    [data_20160714_115407.csv, tweezer_power-2016_07_17.csv]
2016-09-28 [designs/dds_power] update to kicad 4.0, add missing mount hole
    [dds_power.kicad_pcb, dds_power.sch]
2016-09-29 [designs/fpga_bo] note about the power supplies used
2016-10-01 [designs/dds_power] update for new power requirements
    [dds_power.kicad_pcb, dds_power.sch]
2016-10-03 [designs/dds_power] rename fab files
    [dds_power-B.Cu.gbr, dds_power-B.Mask.gbr, dds_power-B.SilkS.gbr, dds_power-Edge.Cuts.gbr, dds_power-F.Cu.gbr, dds_power-F.Mask.gbr, dds_power-F.SilkS.gbr, dds_power-In1.Cu.gbr]
2016-10-03 [designs/dds_power] regenerate fab files
    [dds_power-B.Cu.gbr, dds_power-B.Mask.gbr, dds_power-B.SilkS.gbr, dds_power-Edge.Cuts.gbr, dds_power-F.Cu.gbr, dds_power-F.Mask.gbr, dds_power-F.SilkS.gbr, dds_power-In1.Cu.gbr]
2016-10-03 [bottom] add hole for the extra connector
2016-10-03 [top] clock output, mount hole for the camera link connector
2016-10-03 [back, front] add fans, powers
2016-10-03 [back, bottom, top, front] fix direction, export to dxf and generate drawing
    [back.dxf, bottom.dxf, front.dxf, top.dxf]
2016-10-03 [readme] part no of the fan
2016-10-03 [readme] part no of the usb connector/cable
2016-10-03 [readme] part no for the power connector
2016-10-03 [front] hole for the HDMI port
    [front.dxf]
2016-10-03 [back] update drawing
    [back.dxf]
2016-10-03 [bottom] update drawing, higher tolerance.
    [bottom.dxf]
2016-10-03 [front] update drawings, higher tolerance, additional holes to mount power supply PCB
    [front.dxf]
2016-10-03 [top] update drawings, higher tolerance, BNC holes for the power
    [top.dxf]
2016-10-03 [designs/enclosure] Add notes for the change needed for the new version
2016-10-03 [designs/enclosure] need to remove the USB from back side, not front side
2016-10-03 [designs/enclosure] update top
    [top.dxf]
2016-10-04 [designs/enclosure] Update back panel
    [back.dxf]
2016-10-04 [designs/enclosure] update front
    [front.dxf]
2016-10-04 [designs/enclosure] remove bottom dxf file reference points
    [bottom.dxf]
2016-10-04 [designs/enclosure] fix usb/ethernet feedthrough orientation on the back
    [back.dxf]
2016-10-04 [designs/enclosure] Move dimensions to MD and add comments
2016-10-04 [designs/enclosure] port top panel dimensions
2016-10-04 [designs/enclosure] port front/back panels dimensions
2016-10-04 [designs/enclosure] Add side panels dimensions
2016-10-04 [designs/enclosure] Add reference
2016-10-04 [designs/enclosure] Add left panel
    [left.dxf]
2016-10-04 [designs/enclosure] Add left panel drawing to README
2016-10-05 [designs/fpga_bo] WIP power board parts
2016-10-06 [designs/fpga_box, orders/todo] part number for the sma-bnc cable
2016-10-06 [designs/enclosure] update TTL output hole position
    [top.dxf]
2016-10-06 [designs/enclosure] remove out of date parts list and move doc to doc/
2016-10-16 [designs/kicad] WIP rj45 connector
2016-10-27 [experiments/na_pgc] convert to csv
    [data_20161026_195027.csv]
2016-10-28 [experiments/na_pgc] add partial deep trap data
    [data_20161027_113138.csv]
2016-10-28 [experiments/na_pgc] complete data
    [data_20161027_113138.csv]
2016-11-01 [experiments/na_loading] loading scan
    [data_20161031_160103.csv]
2016-11-04 [presentation/2016-11-04] joint group meeting presentation
2016-11-06 [experiments/na_raman] add data for raman scan
    [data_20161105_232102.csv]
2016-12-11 [diff-sideband, lib] add data; add path automatically
    [Ax23Full.csv, Ax23Half.csv]
2016-12-11 [diff-sideband] Fix axis name and add new data
    [Ax13Full.csv, Ax13Half.csv, Ax2Full.csv, Ax2Half.csv]
2016-12-11 [diff-sideband] Radial 2 -1 sideband
    [Ax2-1Full.csv, Ax2-1Half.csv]
2016-12-11 [diff-sideband] Radial 2 -2 sideband
    [Ax2-2Full.csv, Ax2-2Half.csv]
2016-12-12 [experiments/adiabatic_lowering] Power calibrations
    [AC.csv, DC.csv]
2016-12-12 [experiments/adiabatic_lowering] Lowering data
    [AC_none.csv, AC_old-cw.csv, AC_old-pulsed.csv, DC_new-cw.csv]
2016-12-13 [experiments/adiabatic_lowering] New lowering, plotting
    [DC_new-cw2.csv]
2016-12-14 [experiments/adiabatic_lowering] Add combined scan data 1
    [Ax13Combined_1.csv]
2016-12-14 [experiments/diff-sideband] add data and plot for colder axial + radial 3 differential sidebands
    [Ax13Combined.csv, Ax13Combined_1.csv]
2016-12-24 [experiments/misc] sidebands
    [na_all_axis.csv]
2016-12-26 [experiments/diff-sideband] new diff sidebands
    [Ax13Combined2.csv]
2016-12-26 [experiments/adiabatic_lowering] another lowering
    [AC_new-cw3.csv]
2016-12-29 [experiments/misc] data for multiple rabi flopping
    [na_multi_rabi.csv, na_multi_rabi_total.csv]
2017-01-02 [experiments/misc] Add missing data
    [na_cold_flop.csv]
2017-01-04 [lib/NaCsSim] Add helper to randomly sample a sideband spectrum
2017-01-04 [lib/NaCsSim] emission direction sampler
2017-01-05 [lib/NaCsSim] Add optical pumping sampler
2017-01-05 [lib/NaCsSim] Add thermal distribution sampler
2017-01-06 [lib/NaCsSim] Sampler for OP/decay
2017-01-06 [lib/NaCsSim] Create samplers module
2017-01-06 [lib/NaCsSim] Fix decay sampler
2017-01-07 [lib/NaCsSim] Multi channel decay sampler
2017-01-10 [lib/NaCsSim] Raman pulse and temperature measure
2017-01-12 [lib/NaCsSim] Ideal ground state cooling
2017-01-12 [lib/NaCsSim] Measure ground state population
2017-01-13 [experiments/sideband] Plotting sidebands for the retreat poster
    [axial-cua_retreat2017.csv, axial_cool-cua_retreat2017.csv, radial-cua_retreat2017.csv, radial_cool-cua_retreat2017.csv]
2017-01-13 [experiments/adiabatic_lowering] yet another lowering
    [AC_new-cua_retreat2017.csv]
2017-01-15 [lib/NaCsSim] Print progress
2017-01-19 [lib/NaCsSim] Generalize Ground state measure
2017-01-19 [lib/NaCsSim] Print uncertainty in ground state probability measurement
2017-01-19 [lib/NaCsSim] More uncertainties printing
2017-01-19 [lib/NaCsSim] Return tuple for better printing....
2017-01-24 [lib/NaCsSim] Tighten tolerance, plot results
2017-01-24 [lib/NaCsSim] Tighten tolerance again.... scan op defect
2017-02-13 [experiments/adiabatic_lowering] add new data
    [AC.csv]
2017-02-13 [experiments/adiabatic_lowering] Fix lowering temperature
2017-02-13 [experiment/lifetime] add lifetime data
    [Full-1.7.csv, Low-0.005.csv]
2017-02-14 [experiment/rnr] Data
    [2017-02-14.csv]
2017-02-17 [experiment/rnr] support multiple temperatures
2017-02-17 [designs/dac_breakout] empty board
    [dac_breakout.kicad_pcb, dac_breakout.sch]
2017-02-18 [designs/cmr_link] update
    [cmr_link.kicad_pcb, cmr_link.sch]
2017-02-20 [designs/kicad] rj45x8
2017-02-20 [design/kicad] move connector libs
2017-02-20 [design/kicad] rename connector libs
2017-02-22 [experiments/switching_phase] data and plot
    [data.csv]
2017-02-23 [experiment] add combined data
    [data_20170222_002525.csv]
2017-03-06 [docs] doc for the 8x RJ45 socket
2017-03-08 [experiments/misc] comparing cooling on -5, -6 orders
    [data_20170307_233543.csv, data_20170308_093509.csv]
2017-03-08 [experiments/misc] comparing cooling on -3, -4 orders
    [data_20170308_130646.csv]
2017-03-09 [experiments/misc] comparing cooling on -1 and -2 orders
    [data_20170308_194306.csv, data_20170308_211127.csv]
2017-03-09 [experiments/misc] comparing cooling on -1 and -2 orders, lower power
    [data_20170308_235100.csv, data_20170309_090514.csv]
2017-03-10 [experiments/misc] Lowering with and without axial -1 cooling
    [data_20170310_010327-101145.csv, data_20170310_010327.csv, data_20170310_101145.csv]
2017-03-14 [experiments/misc] Combined scan of sideband +-1 orders and carrier time scan
    [data_20170313_220435.csv]
2017-03-14 [experiments/misc] Final data for the combined scan, use marker style `o`
    [data_20170313_220435.csv]
2017-03-19 [experiments/misc] Radial Rabis
    [data_20170319_002025.csv]
2017-03-19 [experiments/misc] Radial Rabis after some cooling
    [data_20170319_091159.csv]
2017-03-20 [experiments/misc] Plot lowering with and without radial cooling
    [data_20170319_175650.csv]
2017-03-20 [experiments/misc] Preliminary radial sidebands
    [data_20170319_213303.csv]
2017-03-20 [experiments/misc] Final radial sidebands
    [data_20170319_213303.csv]
2017-03-21 [experiments/misc] Axial sidebands
    [data_20170320_130307-155238.csv]
2017-03-21 [experiments/misc] Axial sidebands plots
    [data_20170320_223047.csv]
2017-03-21 [experiments/misc] Lowering with cooling
    [data_20170321_084241.csv]
2017-03-24 [presentations/2017-03-24] Joint meeting presentation
2017-03-24 [experiments/misc] 3D cooling sidebands
    [data_20170324_010638.csv]
2017-03-24 [experiments/misc] Update plot
    [data_20170324_010638.csv]
2017-03-26 [experiments/misc] Combine axial scans
    [data_20170325_085740-141619.csv]
2017-03-26 [experiments/misc] Combine 3d spectrum scan
    [data_20170326_004557-092819.csv]
2017-04-05 [experiments/misc] Plot Rabi flopping
    [data_20170404_133229.csv]
2017-04-06 [experiments/misc] Combined rabi flopping scans
    [data_20170405_183620.csv]
2017-04-09 [experiments/raman_scatter] plot raman depumping data
    [data_20170405_114322.csv, data_20170405_151151.csv]
2017-04-09 [presentations/na_cool_paper] add axial order label and tweezer switching (????)
2017-04-10 [experiments/raman_scatter] print fit parameters
2017-04-11 [experiments/misc] new spectrums
    [data_20170409_005850.csv, data_20170409_082523.csv]
2017-04-11 [experiments/misc] new rabi flopping plots
    [data_20170409_141913.csv, data_20170409_162137.csv, data_20170409_184250.csv, data_20170409_233639.csv]
2017-04-14 [notes] Derivatives in overdamp case
2017-04-15 [notes] Fix typo and exact solution for state changing case
2017-04-15 [calculations/raman-scatter] Try adding overdamping case
2017-04-16 [calculations/raman-scatter] Improve random number generation speed by making sure the generator are allocated on their own threads
2017-04-17 [experiments/raman_scatter] print rates
2017-04-18 [experiments/rabi_flop] Fit a1, including heating sideband
2017-04-20 [lib] thread rng through to make the samplers more thread safe
2017-04-20 [lib] Use threads instead of worker processes
2017-04-21 [lib] Fully switch to a threaded version
2017-04-26 [calculations/sideband] Add comments about powers
2017-04-27 [designs/dac_breakout] WIP
    [dac_breakout.sch]
2017-04-28 [lib/NaCsSim] Filter pulse
2017-05-03 [orders] Remove lenses from the order
2017-05-10 [experiments/tweezer] Data for Na long focal length measurement
    [Na_tweezer_long_F.csv]
2017-05-10 [experiments/tweezer] Data for Na horizontal knife edge
    [Na_big_knife_x.csv]
2017-05-10 [experiments/tweezer] Small beam size
    [Na_small_knife_x.csv]
2017-05-10 [experiments/tweezer] Measure and fitting Cs small beam size
    [Cs_small_knife_x.csv]
2017-05-10 [experiments/tweezer] Measure and fitting Cs big beam size
    [Cs_big_knife_x.csv]
2017-05-22 [presentations/na_cool_paper] op heating plots
2017-05-26 [presentations/na_cool_paper] Update axial raman coupling figure
2017-05-26 [presentations/na_cool_paper] Fix OP heating figure
2017-05-26 [presentations/na_cool_paper] figure 2 caption, fix axial op heating plot (wrong Lamb-Dicke parameter), add subfigure label
2017-06-09 [calculations/sideband_strength] More accurate matrix elements, print sideband ratio
2017-08-07 [presentations/qual] Flip heating and mele figure again..., Add merging plot
2017-08-10 [calculations/sideband] save simulation result
    [qual_no_scatter.csv, qual_with_scatter.csv]
2017-08-10 [presentations/qual] Tweak schematic text position. Show first order matrix element first for the solution slide
2017-08-11 [presentations/qual] Cite ArXiv paper, reduce the schematic when showing difficulties
2017-08-16 [experiments/SAS] add scope trace about the strange oscillation in the error signal
    [F0000CH1.CSV, F0000CH2.CSV]
2017-09-17 [experiments/na_rsc_201709] add some data to be processed
    [data_20170913_160122.csv, data_20170913_183044.csv, data_20170913_234450.csv, data_20170914_210445.csv, data_20170915_085614.csv, data_20170915_101807.csv, data_20170915_122858.csv]
2017-09-17 [experiments/na_rsc_201709] plot another 3d cooling spectrum
    [data_20170916_010610.csv]
2017-09-17 [experiments/na_rsc_201709] plot another 3d cooling spectrum, after fixing D1 lock
    [data_20170916_155350.csv]
2017-09-18 [calculations/sideband_strength] switch to NaCsPlot
2017-09-18 [lib/NaCsData] Add pretty printing to data
2017-09-18 [experiments/na_rsc_201709] Final? 3D cooling spectrum
    [data_20170917_220050.csv]
2017-09-18 [experiments/na_rsc_201709] compare cooling with and without Cs trap
    [data_20170918_125622.csv]
2017-09-18 [experiments/na_rsc_201709] compare with old sequence
    [data_20170918_145905.csv]
2017-09-19 [experiments/na_rsc_201709] lowering measurement
    [data_20170918_215351.csv]
2017-09-19 [experiments/na_rsc_201709] Lowering hold
    [data_20170919_110453.csv]
2017-09-20 [experiments/na_rsc_201709] time series of cooling sideband height
    [data_20170919_170840.csv]
2017-09-20 [experiments/na_rsc_201709] Add script to convert mat scan to csv with time info maintained.
    [data_20170919_170840.csv]
2017-09-20 [experiments/na_rsc_201709] Plot heating sidebands as a function of time at the same time
    [data_20170919_184604.csv]
2017-09-20 [experiments/na_rsc_201709] Long scan of cooling sideband height vs time
    [data_20170919_235716.csv]
2017-09-21 [experiments/na_rsc_201709] trap merge scan
    [data_20170919_132216.csv]
2017-09-21 [experiments/na_rsc_201709] trap merge radial heating
    [data_20170920_125743.csv]
2017-09-21 [experiments/na_rsc_201709] long scan to verify the stability of cooling
    [data_20170921_004940.csv]
2017-09-24 [experiments/na_rsc_201709] 3d cooling
    [data_20170923_020020.csv]
2017-09-26 [experiments/na_rsc_201709] 3d cooling with merge
    [data_20170924_195426.csv]
2017-09-26 [experiments/na_rsc_201709] 3d cooling with merge, attempt 2
    [data_20170925_114831.csv]
2017-09-28 [experiments/na_rsc_201709] 3d cooling with merge, attempt 3
    [data_20170926_193126.csv]
2017-09-28 [experiments/na_rsc_201709] Measure cooling stability
    [data_20170927_193235.csv]
2017-10-18 [experiments/cs_rsc_201710] Cs hot sidebands 1
    [data_20171015_001620.csv]
2017-10-18 [experiments/cs_rsc_201710] Cs cooling sideband Rabi flopping before cooling
    [data_20171015_114035.csv]
2017-10-18 [experiments/cs_rsc_201710] Cs hot sidebands 2
    [data_20171016_003707.csv]
2017-10-18 [experiments/cs_rsc_201710] Cs cold sidebands 1
    [data_20171016_182638.csv]
2017-10-18 [experiments/cs_rsc_201710] Cs cold sidebands 2
    [data_20171017_104224.csv]
2017-10-18 [experiments/cs_rsc_201710] Cs heating sideband and carrier Rabi flopping after cooling
    [data_20171018_004853.csv]
2017-10-26 [experiments/cs_rsc_201710] sort data
    [data_20171015_001620_3d_az.csv, data_20171015_001620_3d_rx.csv, data_20171015_001620_3d_ry.csv]
2017-10-26 [experiments/cs_rsc_201710] another sorted data
    [data_20171016_003707_3d_az.csv, data_20171016_003707_3d_rx.csv, data_20171016_003707_3d_ry.csv]
2017-10-26 [experiments/cs_rsc_201710] add cooling spectrum data
    [data_20171019_183004.csv, data_20171019_193925.csv, data_20171019_204819.csv]
2017-10-26 [experiments/cs_rsc_201710] add combined cooling
    [data_20171019-20_224130-114412_3d-cool_az.csv, data_20171019-20_224130-114412_3d-cool_rx.csv, data_20171019-20_224130-114412_3d-cool_ry.csv, data_20171019_224130.csv, data_20171020_114412.csv]
2017-10-26 [experiments/cs_rsc_201710] print overall survival
2017-10-26 [experiments/cs_rsc_201710] two hot sidebands
    [data_20171020_154345.csv, data_20171020_170319.csv]
2017-11-02 [experiments/na_phase] Measurement of Na switch phase
2017-12-27 [experiments/cs_coprop_201712] fit partial data for long co-prop scan
2018-01-01 [experiments/cs_coprop_201712] scan power
2018-01-01 [experiments/cs_coprop_201712] Fit power scan
2018-01-02 [experiments/cs_coprop_201712] Power scan at stronger field
2018-01-03 [experiments/cs_coprop_201712] Fit By = 0.5 power scan
2018-01-08 [experiments/na_phase] Measurement of Na switch phase again
    [data_20180108.csv]
2018-01-08 [experiments/na_phase] Scan lowering edge position
    [lower_edge_20180108.csv]
2018-01-09 [experiments/cs_rsc_201712] Hot spectrum
    [data_20180105_195845_hot_x.csv, data_20180105_195845_hot_y.csv, data_20180105_195845_hot_z.csv]
2018-01-11 [experiments/na_power] Fit Na Raman calibration
    [f1_coprop_20180110.csv, f1_down_20180110.csv, f1_up_20180110.csv, f2_coprop_20180110.csv, f2_counter-op_20180110.csv]
2018-01-12 [lib/NaCsData] More flexible sequence filter
2018-01-13 [experiments/na_rsc_201801] Cold heating sideband Rabi flopping with Blackman pulse
2018-01-13 [experiments/na_rsc_201801] full power axial spectrum after cooling
2018-03-09 [experiments/cs_scatter_and_shift_201802] two body loss as a function of trap power
2018-04-05 [experiments/cs_coprop_201712] Plots for joint group meeting presentation
2018-05-03 [designs/pre-amp] start to design the breakout board
    [pre-amp.kicad_pcb, pre-amp.sch]
2018-05-03 [designs/pre-amp] power connectors
    [pre-amp.sch]
2018-05-03 [designs/pre-amp] package matching
    [pre-amp.sch]
2018-05-03 [designs/pre-amp] layout
    [pre-amp.kicad_pcb, pre-amp.sch]
2018-05-03 [designs/pre-amp] fab files
    [pre-amp-B.Cu.gbl, pre-amp-B.Mask.gbs, pre-amp-B.Paste.gbp, pre-amp-B.SilkS.gbo, pre-amp-Edge.Cuts.gm1, pre-amp-F.Cu.gtl, pre-amp-F.Mask.gts, pre-amp-F.Paste.gtp]
2018-05-05 [designs/pre-amp] value selections
    [pre-amp.sch]
2018-05-06 [orders/Microwave] chained doubler
2018-05-26 [designs/kicad] fixed BNC right angle footprint
2018-05-26 [designs/pre-amp] new layout
    [pre-amp.kicad_pcb, pre-amp.sch]
2018-05-26 [designs/pre-amp] new fab files
    [pre-amp-B.Cu.gbl, pre-amp-B.Mask.gbs, pre-amp-B.Paste.gbp, pre-amp-B.SilkS.gbo, pre-amp-Edge.Cuts.gm1, pre-amp-F.Cu.gtl, pre-amp-F.Mask.gts, pre-amp-F.Paste.gtp]
2018-06-05 [experiments/na_power] fix calibration
    [f1_coprop_20180604.csv, f1_down_20180604.csv, f1_up_20180604.csv, f2_coprop_20180604.csv, f2_counter-op_20180604.csv]
2018-06-05 [experiments/na_power] correct data
    [f2_counter-op_20180604.csv]
2018-06-07 [designs/regulator] init
    [regulator.kicad_pcb, regulator.sch]
2018-06-07 [designs/kicad] Regulator parts
2018-06-07 [designs/regulator] import regulator lib
2018-06-07 [designs/regulator] schematics
    [regulator.sch]
2018-06-07 [designs/regulator] parts value and footprints
    [regulator.sch]
2018-06-07 [designs/kicad] Capacitors and connectors
2018-06-07 [designs/regulator] footprints of all parts
    [regulator.sch]
2018-06-07 [designs/regulator] Use throughwhole capacitor
    [regulator.sch]
2018-06-07 [designs/regulator] Layout
    [regulator.kicad_pcb]
2018-06-08 [designs/regulator] Tweak size
    [regulator.kicad_pcb]
2018-06-08 [designs/pre-amp] flip input and tweak connection near the edges
    [pre-amp.kicad_pcb, pre-amp.sch]
2018-06-08 [combined_board] preamp+regulator
    [preamp_regulator-B.Cu.gbl, preamp_regulator-B.Mask.gbs, preamp_regulator-B.Paste.gbp, preamp_regulator-B.SilkS.gbo, preamp_regulator-Eco1.User.gbr, preamp_regulator-Edge.Cuts.gm1, preamp_regulator-F.Cu.gtl, preamp_regulator-F.Mask.gts]
2018-06-08 [designs/regulator] chip part number
2018-06-20 [designs/regulator] move label location
    [regulator.kicad_pcb]
2018-06-20 [designs/regulator] Print
2018-06-20 [designs/pre-amp] move label location and update values
    [pre-amp.kicad_pcb, pre-amp.sch]
2018-06-20 [designs/pre-amp] more label position tweaks, print out
    [pre-amp.kicad_pcb]
2018-06-20 [designs/regulator] page size
    [regulator.kicad_pcb, regulator.sch]
2018-06-29 [experiments/nacs_201806] Rabi flopping on heating sideband
2018-08-08 [experiments/nacs_201808] Merge heating
2018-08-08 [experiments/nacs_201808] add x axis unit
2018-08-16 [experiments/nacs_201808] more co-prop interaction shift
2018-08-22 [calculations/clock_shift] split out coupled_2atoms to help testing
2018-08-23 [calculations/clock_shift] typo in parity tuple, also print and save it
2018-08-24 [calculations/clock_shift] simulate simpler case
    Same frequency, same wavefunction size, hopefully we can compare with the theory.
2018-08-27 [calculations/clock_shift] plot degenerate case
2018-08-31 [calculations/clock_shift] add text data files
    [energy_000.csv, energy_010.csv, overlap_000.csv, overlap_010.csv]
2018-09-01 [experiments/nacs_201808] Cs loading power and Na+Cs lifetime
2018-09-03 [experiments/nacs_201808] generate data as csv for the interaction shift
    [data_20180815_interaction_shift4_cs_n0.csv, data_20180815_interaction_shift4_cs_n1.csv, data_20180815_interaction_shift4_na_n0.csv, data_20180815_interaction_shift4_nacs_cs_n0.csv, data_20180815_interaction_shift4_nacs_cs_n1.csv, data_20180815_interaction_shift4_nacs_na_n0.csv]
2018-09-03 [experiments/cs_power] Cs Raman power calibration
    [f3_coprop_20180903.csv, f3_counterop_20180903.csv, f4_coprop_20180903.csv, f4_down_20180903.csv, f4_up_20180903.csv]
2018-09-03 [experiments/cs_power] Fit Cs Raman power calibration
2018-09-03 [experiments/nacs_201808] Fix filename and convert data for 42->41
    [data_20180808_interaction_shift2_33_na.csv, data_20180808_interaction_shift2_33_nacs_na.csv, data_20180808_interaction_shift2_44_na.csv, data_20180808_interaction_shift2_44_nacs_na.csv]
2018-09-03 [experiments/nacs_201808] Convert data for n=1 3+2 -> 3+1
    [data_20180810_150954_interaction_shift_n1_na_n0.csv, data_20180810_150954_interaction_shift_n1_na_n1.csv, data_20180810_150954_interaction_shift_n1_nacs_na_n0.csv, data_20180810_150954_interaction_shift_n1_nacs_na_n1.csv]
2018-09-07 [experiments/nacs_201808] Cs Rabi flopping on carrier/heating sideband
2018-09-07 [experiments/nacs_201808] Fix plot legend for the heating sideband
2018-09-11 [experiments/nacs_201808] Merge temperature 2D scans
2018-09-11 [experiments/nacs_201808] dmerge temperature scan
2018-09-13 [experiments/nacs_201808] temperature with and without merge
2018-10-10 [experiments/nacs_201808] export alignment data for Lee
    [data_20180816_merge_align_cs_align.csv, data_20180816_merge_align_cs_az.csv, data_20180816_merge_align_cs_rx.csv, data_20180816_merge_align_cs_ry.csv, data_20180816_merge_align_na_az.csv, data_20180816_merge_align_na_rx.csv, data_20180816_merge_align_na_ry.csv]
2018-11-04 [experiments/nacs_201810] Raman spectrum with 6 and 10mW power
2018-11-14 [experiments/nacs_201810] Raman with heating
2018-11-19 [experiments/nacs_201810] plot light shifts
    [raman_resonance.csv]
2018-11-20 [experiments/nacs_201810] clean up for raman resonances plot and include plot for all powers
2018-11-20 [experiments/cs_power] fit innolume calibration
    [paaom_201811.csv, padpaom2_201811.csv, padpaom_201811.csv]
2018-11-25 [experiments/nacs_201810] Fit B field angle dependency
    [raman_agl_neg_20181124.csv, raman_agl_pos_20181124.csv]
2018-11-28 [experiments/cs_power] new innolume calibration
    [paaom_20181128.csv, padpaom2_20181128.csv, padpaom_20181128.csv]
2018-11-30 [experiments/cs_power] tweak plots for new innolume calibration
2018-12-05 [experiments/nacs_201812] spectrum at two different power ratios
2018-12-05 [experiments/nacs_201812] spectrum at two different power ratios, more data and fewer points
2018-12-11 [experiments/nacs_201812] power ratio scan at 668GHz
2018-12-11 [experiments/nacs_201812] power ratio scan at 656GHz
2018-12-11 [experiments/nacs_201812] power ratio scan at 656GHz without servo railing
2018-12-11 [experiments/nacs_201812] Cs resonance calibration
2018-12-13 [experiments/nacs_201812] Reverse heating Rabi oscillation
2018-12-14 [experiments/nacs_201812] Insensitivity of Ramsey to laser frequency
2018-12-18 [experiments/nacs_201812] co-prop Cs
2018-12-18 [experiments/nacs_201812] fitting of co-prop/uwave Ramsey
2018-12-21 [experiments/nacs_201812] square pulse pi time calibration
2018-12-21 [experiments/nacs_201812] Calibrate Y spectrum and X second order
2018-12-25 [experiments/nacs_201812] Calibrate Y Rabi flopping time
2018-12-28 [experiments/nacs_201812] 3d cold/hot sideband, Rabi on heating
2019-01-01 [experiments/nacs_201812] Lifetime after fixing servo
2019-01-09 [experiments/nacs_201812] sideband frequency calibration
2019-01-31 [experiments/radio-tracs_201901] Scope trace of software radio vs DDS output
2019-02-04 [experiments/nacs_201812] Rabi flopping on heating sidebands
2019-02-13 [experiments/nacs_201902] Cs axial temperature
2019-03-06 [experiments/nacs_201902] Temperature
2019-03-06 [experiments/nacs_201902] Another temperature
2019-03-11 [experiments/nacs_201902] Raman time and detuning with heating
2019-03-16 [experiments/cs_power] timebase calibration
    [paaom_20190315.csv, padpaom2_20190315.csv, padpaom_20190315.csv]
2019-03-28 [experiments/nacs_201902] Raman time 488 with filter
2019-04-14 [experiments/pa_201904] Comparing PA with different powers/times
2019-04-14 [experiments/pa_201904] new data for shorter time/lower power
2019-04-15 [experiments/nacs_201904] lower power time scan
2019-04-26 [presentation/2019-04-27] equipment list for shutdown
    [equipments.csv]
2019-04-26 [presentation/2019-04-27_shutdown] channel numbers
    [equipments.csv]
2019-04-26 [presentation/2019-04-27_shutdown] update
    [equipments.csv]
2019-04-26 [presentation/2019-04-27_shutdown] WIP: checklists
    [equipments.csv]
2019-05-08 [presentation/2019-04-27_shutdown] Finish checklist
    [equipments.csv]
2019-05-11 [experiments/cs_power] 976 DP calibration
    [paaom_20190511.csv, padpaom2_20190511.csv, padpaom_20190511.csv]
2019-07-16 [nacs_201907] Na MOT frequency and power scan
2019-08-06 [experiments/nacs_201908] Tweezer power dependency of lifetime
2019-08-16 [experiments/pa_201908] PA with lower tweezer power
2019-08-17 [experiments/pa_201908] Fine PA scan with 3mW tweezer power
2019-08-18 [experiments/pa_201908] Fine PA scan with 7.5mW tweezer power
2019-08-19 [experiments/pa_201908] Fit linewidth power dependency
2019-08-19 [experiments/pa_201908] 3,3+2,2 lifetime power dependency
2019-08-30 [experiments/pa_201908] lower power and shorter time
2019-09-02 [experiments/pa_201909] First peak at lower tweezer power
2019-09-03 [experiments/nacs_201909] PA resonance vs tweezer power
2019-09-03 [experiments/pa_201909] PA resonance for the higher line at lower tweezer power
2019-10-29 [experiments/sfg_power] SFG input power calibration
    [wp_1040_20191029.csv, wp_1550_20191029.csv]
2019-11-04 [designs/pre-amp] Add schematics printout
2019-11-08 [experiments/sfg_power] Plot power calibration
2019-11-24 [notes/two-photon-broadening] Finish two photon coupling up
2019-11-24 [notes/two-photon-broadening] coupling down
2019-11-25 [notes/two-photon-broadening] Calculating the coupling to the ground state continuum using harmonic oscillator states as basis
2019-11-25 [notes/two-photon-broadening] Calculating the coupling to the ground state continuum using spherical well states as basis
2019-11-26 [experiments/powers] Power calibration for the new ti-sapph
    [venus_power_20191126.csv]
2019-11-26 [experiments/powers] Move old calibration
    [cs_f3_coprop_20180903.csv, cs_f3_counterop_20180903.csv, cs_f4_coprop_20180903.csv, cs_f4_down_20180903.csv, cs_f4_up_20180903.csv]
2019-11-26 [experiments/powers] Remake old plots
2019-11-26 [experiments/powers] move old plots
    [cs_tweezer_paaom_201811.csv, cs_tweezer_paaom_20181128.csv, cs_tweezer_paaom_20190315.csv, cs_tweezer_paaom_20190511.csv, cs_tweezer_paaom_20190819.csv, cs_tweezer_paaom_20190927.csv, cs_tweezer_paaom_20191025.csv, cs_tweezer_padpaom2_201811.csv]
2019-11-26 [experiments/powers] move old plots for na Raman calibration
    [na_f1_coprop_20180110.csv, na_f1_coprop_20180604.csv, na_f1_down_20180110.csv, na_f1_down_20180604.csv, na_f1_up_20180110.csv, na_f1_up_20180604.csv, na_f2_coprop_20180110.csv, na_f2_coprop_20180604.csv]
2019-11-26 [experiments/powers] move old plots for na tweezer calibration
    [na_tweezer_ac-20160717.csv, na_tweezer_dc-20160223.csv]
2019-11-26 [experiments/powers] move old plots for sfg calibration
    [sfg_wp_1040_20191029.csv, sfg_wp_1550_20191029.csv]
2019-11-26 [experiments/powers] rename for consistency...
    [venus_20191126.csv]
2019-12-03 [power] cs tweezer Raman beam path power calibration
    [cs_tweezer_paaom_20191203.csv, cs_tweezer_padpaom2_20191203.csv, cs_tweezer_padpaom_20191203.csv]
2020-01-10 [experiments/nacs_202001] Fitting line width power dependency
2020-01-16 [experiments/powers] Cs tweezer Raman calibration for 300 MHz
    [cs_tweezer_paaom_20200116.csv, cs_tweezer_padpaom2_20200116.csv, cs_tweezer_padpaom_20200116.csv]
2020-01-20 [experiments/powers] Cs tweezer Raman calibration for 370 MHz
    [cs_tweezer_paaom_20200120.csv, cs_tweezer_padpaom2_20200120.csv, cs_tweezer_padpaom_20200120.csv]
2020-01-23 [experiments/nacs_202001] Linewidth for 4422 Raman transition, power dependency
2020-01-23 [experiments/nacs_202001] Linewidth power dependency with additional points
2020-02-07 [experiments/nacs_202002] 306490.7 GHz, resonance/linewidth power dependency
2020-02-11 [presentations/2020-02-12_shutdown] equipment list
    [equipments.csv]
2020-02-11 [presentations/2020-02-12_shutdown] tweak equipment list
    [equipments.csv]
2020-02-11 [presentations/2020-02-12_shutdown] checklist
    [equipments.csv]
2020-02-11 [presentations/2020-02-12_shutdown] checklist, power supply channnels
    [equipments.csv]
2020-02-11 [presentations/2020-02-12_shutdown] checklist, missing power supply
    [equipments.csv]
2020-02-15 [experiments/nacs_202002] Coprop tweezer power dependency
2020-02-16 [experiments/nacs_202002] Raman 490 GHz, power ratio.
2020-02-18 [experiments/nacs_202002] Linewidth power dependency
2020-03-10 [experiments/powers] Cs tweezer Raman calibration for 770 MHz
    [cs_tweezer_paaom_20200304.csv, cs_tweezer_padpaom2_20200304_345.csv, cs_tweezer_padpaom_20200304_345.csv]
2020-03-11 [experiments/powers] Fix fit expression text on plot
2020-03-20 [experiments/nacs_202003] Power dependency for -36 GHz
2020-03-20 [experiments/nacs_202003] Power dependency for -145 GHz
2020-03-26 [experiments/powers] Add new calibration data for cs tweezer
    [cs_tweezer_pa2d_20200325.csv]
2020-03-26 [experiments/powers] fit calibration
2020-03-26 [experiments/powers] Fix calibration for max power
2020-03-29 [experiments/nacs_202003] Fix power in the title
2020-04-03 [experiments/nacs_202004] Fit power scaling of everything...
2020-04-09 [experiments/nacs_202003] Refit PA rate with a different scaling power, also fix tweezer frequency in the title...
2020-05-05 [experiments/powers] Update calibration processing script
2020-05-05 [experiments/powers] new calibration
    [cs_tweezer_pa2d_20200505.csv]
2020-05-29 [presentations/damop-2020] WIP: direct cooling vs assembly
2020-06-23 [experiments/nacs_202006] 15 mW fit after fixing servo
2020-06-23 [experiments/nacs_202006] 6 mW fit after fixing servo
2020-07-24 [experiments/nacs_202007] Fitting with ASE filter
2020-08-11 [experiments/nacs_202008] 288503 GHz, 15 mW with filter
2020-08-11 [experiments/nacs_202008] 288503 GHz, 6 mW with filter
2020-08-14 [experiments/nacs_202008] 288503 GHz, 3 mW with filter
2020-08-14 [experiments/nacs_202008] Power scaling of parameters with ASE filter
2020-08-17 [experiments/powers] Tisapph power calibration
    [venus_20200806.csv]
2020-09-11 [experiments/nacs_202008] Power scaling of parameters with ASE filter at 288560 GHz
2020-09-17 [experiments/powers] raman power calibration
    [cs_tweezer_pa2d_20200917.csv]
2020-11-01 [experiments/nacs_201808] replot interaction shift data
    [data_20180815_interaction_shift4_cs_n0.csv, data_20180815_interaction_shift4_cs_n1.csv, data_20180815_interaction_shift4_na_n0.csv, data_20180815_interaction_shift4_nacs_cs_n0.csv, data_20180815_interaction_shift4_nacs_cs_n1.csv, data_20180815_interaction_shift4_nacs_na_n0.csv]
2020-11-04 [lib/NaCsData] filter and sorting of data
2020-11-23 [figure] gamma vs omega showing the improvement for 2 ASE filter
2020-12-11 [presentations/2020-defense] Tweak procedure drawing and update ground state Raman figure
2021-02-12 [presentations/2021-02-12_jc] WIP: High dimension, circuit
